Engineer1234/ConnectMedical/Connect Medical Boards/EFM2/Pictures/M24256-DFCS6TPK-Footprint.PNG

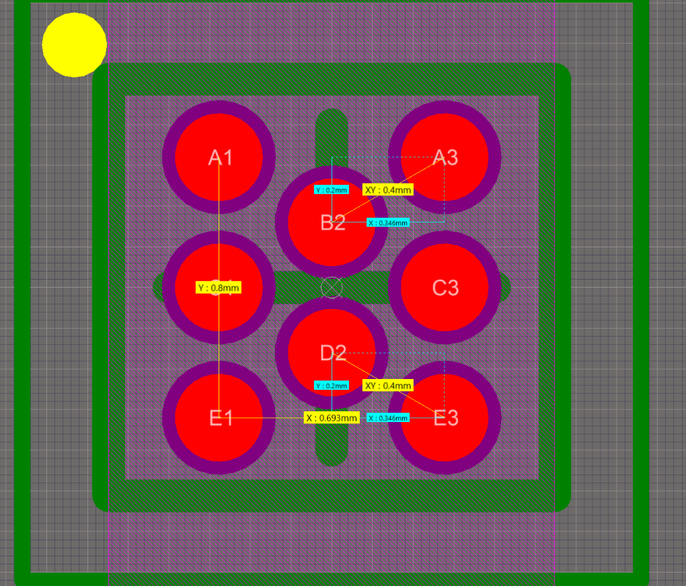
Connect Medical Boards/EFM2/Pictures/M24256-DFCS6TPK-Footprint.PNG
