Engineer1234/ConnectMedical/Connect Medical Boards/EFM2/Pictures/Modified_BRD.PNG

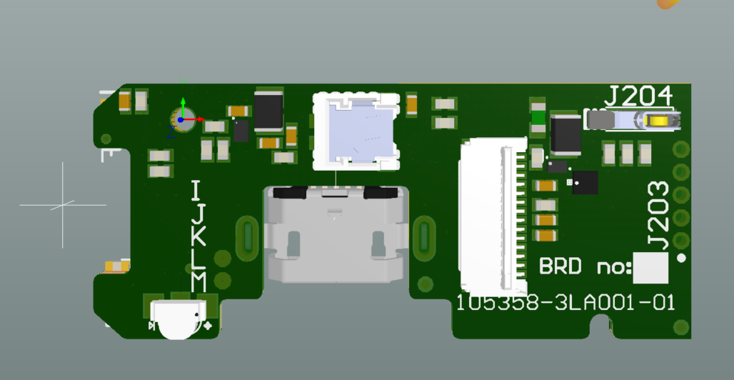
Connect Medical Boards/EFM2/Pictures/Modified_BRD.PNG
