Engineer1234/ConnectMedical/README.md

# Connect-Med-Hardware
Repository for Hardware files relating to Connect Medical
