Engineer1234/ConnectMedical/Connect Medical Boards/EFM1/Project Outputs for 105358-3BA001-01_EFM1/Reports/105358-3LA001-01_EFM1.xls

Board Stack Report
Stack Up |  | Layer Stack
Layer | Board Layer Stack | Name | Material | Thickness | Constant
1 |  | Top Paste
2 |  | Top Overlay
3 |  | Top Solder | Solder Resist | 0.018mm | 4
4 |  | Component Side | Copper | 0.036mm
5 |  | Dielectric 1 | FR-4 | 0.064mm | 4.2
6 |  | Inner Layer 1 | Copper | 0.036mm
7 |  | Dielectric 3 | FR-4 | 0.064mm | 4.2
8 |  | Ground Plane (GND) | Copper | 0.036mm
9 |  | Dielectric 6 | FR-4 | 0.508mm | 4.2
10 |  | Power Plane (VCC) | Copper | 0.036mm
11 |  | Dielectric 5 | FR-4 | 0.064mm | 4.2
12 |  | Inner Layer 2 | Copper | 0.036mm
13 |  | Dielectric 4 | FR-4 | 0.064mm | 4.2
14 |  | Solder Side | Copper | 0.036mm
15 |  | Bottom Solder | Solder Resist | 0.018mm | 4
16 |  | Bottom Overlay
17 |  | Bottom Paste
 | Height : 1.011mm
