Engineer1234/ConnectMedical/Connect Medical Boards/EFM2/Pictures/VIA _error.PNG

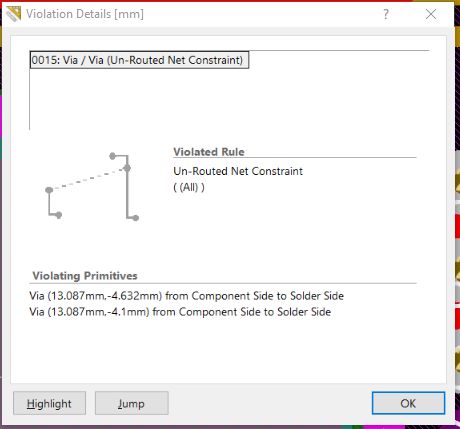
Connect Medical Boards/EFM2/Pictures/VIA _error.PNG
