Engineer1234/ConnectMedical/Connect Medical Boards/EFM1/Project Outputs for 105358-3BA001-01_EFM1/105358-3BA001-01_EFM1_BOM_FOR_QUOTE_170922.xlsx

Bill of Materials
Source Data From: |  | 105358-3BA001-01_EFM1.PrjPCB
Project: |  | 105358-3BA001-01_EFM1.PrjPCB
Variant: |  | None
Creation Date: | 25-09-2017 | 11:54:14
Print Date: | 2017-09-25 | 11:54:29
Production Quantity: | 5
Currency | SEK
Designator | Description | Comment | Manufacturer | Manufacturer Part Number | Quantity | #Column Name Error:Supplier 1 | Digi-Key Part Number | Pricing | Supplier Unit Price | Supplier 1 Subtotal | #Column Name Error:Assem | #Column Name Error:Assem Part Num | #Column Name Error:Assem Pricing | Assem Unit Price 2 | Assem Subtotal
C301, C302, C305, C307, C406 | 1µF ±10% 10V X5R Ceramic Capacitor 0402 | 1µF-10V | Yageo | CC0402KRX5R6BB105 | 5 |  | 311-1439-1-ND |  |  | $0.00
C303 | DNP | DNP |  |  | 1 |  |  |  |  | $0.00
C304 | 16µF ±10% 16V X5R Ceramic Capacitor 0603 | 10µF-16V | Murata Electronics North America | GRT188R61C106KE13D | 1 |  | 490-12317-1-ND |  |  | $0.00
C306 |  | DNP | Murata Electronics North America | GRM188R61A106KE69D | 1 |  | 490-10474-1-ND |  |  | $0.00
C308, C404, C405 | 4.7µF ±10% 6.3V X5R Ceramic Capacitor 0402 | 4.7µF | TDK Corporation | C1005X5R0J475K050BC | 3 |  | 445-5947-1-ND |  |  | $0.00
C401 | 0.1µF ±10% 10V X5R Ceramic Capacitor 0402 | 0.1µF-10V | Yageo | CC0402KRX5R6BB104 | 1 |  | 311-1336-1-ND |  |  | $0.00
C402 | 2.2nF ±10% 50V X5R Ceramic Capacitor 0402 | 2.2nF | Murata Electronics North America | GRM155R61H222KA01D | 1 |  | 490-8257-1-ND |  |  | $0.00
C403 | 22µF ±20% 10V Ceramic Capacitor X5R 0603 | 22µF | TDK Corporation | C1608X5R1A226M080AC | 1 |  | 445-9077-2-ND |  |  | $0.00
C501 | 1.2nF ±10% 10V U2J Ceramic Capacitor 0402 | 1.2nF-10V | Murata Electronics North America | GRM1557U1A122JA01D | 1 |  | 490-6272-1-ND |  |  | $0.00
D201, D402, D403 | TVS DIODE 15VWM 0402 | LXES15AAA1-133 | Murata Electronics North America | LXES15AAA1-133 | 3 |  | 490-13209-1-ND |  |  | $0.00
D401 | LED GRN/RED DIFF 1208 R/A SMD | LED RG | Stanley Electric Co | BRPY1211F-TR | 1 |  | 404-1089-1-ND |  |  | $0.00
D501 | 0603 INFRARED DIODE | KPT-2012P3BT | Kingbright | KPT-2012P3BT | 1 |  | 754-1433-1-ND |  |  | $0.00
J201 | CONN RCPT USB-mini B 2.0 5POS SLD | USB3155 | GCT (GLOBAL CONNECTOR TECHNOLOGY) | USB3155-30-A | 1 |  | 2537026-Farnell |  |  | $0.00
J202 | 1.20MM WTB HEADER VERT 2POS | 0781710002 | Molex, LLC | 0781710002 | 1 |  | WM4459CT-ND |  |  | $0.00
J204 | UNIVERSAL CONTACT 2.5MM SMD | 120220-0161 | ITT Cannon, LLC | 120220-0161 | 1 |  | 1003-1009-1-ND |  |  | $0.00
L201, L202 | FERRITE BEAD 120 OHM 0402 1LN | BLM15KD121SN1D | Murata Electronics North America | BLM15KD121SN1D | 2 |  | 490-15015-1-ND |  |  | $0.00
L301 | FIXED IND 10UH 500MA 300 MOHM | 10µH | TDK Corporation | MLZ2012N100LT000 | 1 |  | 445-6762-1-ND |  |  | $0.00
L401 | 0805 Ferrite Bead 330Ohm@100MHz | BLM21PG331SN1D | Murata Electronics North America | BLM21PG331SN1D | 1 |  | 490-5988-1-ND |  |  | $0.00
MOD401 | BLE PSoC Module 4.1 | CYBLE-214009-00 | Cypress Semiconductor Corp | CYBLE-214009-00 | 1 |  | 428-3809-ND |  |  | $0.00
Q401, Q403 | MOSFET P-CH 12V 22A 3PICOSTAR | CSD23382F4 | Texas Instruments | CSD23382F4 | 2 |  | 296-40003-1-ND |  |  | $0.00
Q402, Q502 | 12V N-CHANNEL FEMTOFET MOSFET | CSD13380F3T | Texas Instruments | CSD13380F3T | 2 |  | CSD13380F3T |  |  | $0.00
Q501 | 0805 PHOTOTRANSISTOR | KPT-2012P3BT | Kingbright | KPT-2012P3BT | 1 |  | 754-1436-1-ND |  |  | $0.00
R301, R302, R305, R409 | RES SMD 820kOHM 1% 1/16W 0402 | 820K | Yageo | RC0402FR-07820KL | 4 |  | YAG3240CT-ND |  |  | $0.00
R303, R304, R410 | RES SMD 82kOHM 1% 1/16W 0402 | 82K | Yageo | RC0402FR-0782KL | 3 |  | 311-82.0KLRCT-ND |  |  | $0.00
R306 | RES SMD 200kOHM 1% 1/16W 0402 | 200K | Yageo | AC0402FR-07200KL | 1 |  | YAG3452CT-ND |  |  | $0.00
R307 | RES SMD 150kOHM 5% 1/16W 0402 | 150K | Yageo | RC0402JR-07150KL | 1 |  | 311-150KJRCT-ND |  |  | $0.00
R308, R403, R404, R411, R503 | RES SMD 10kOHM 1% 1/16W 0402 | 10K | Yageo | RC0402FR-0710KL | 5 |  | 311-10.0KLRCT-ND |  |  | $0.00
R309 | RES SMD 5.6kOHM 5% 1/16W 0402 | 5.6K | Yageo | RC0402JR-075K6L | 1 |  | 311-5.6KJRCT-ND |  |  | $0.00
R310, R406 | RES SMD 41.2kOHM 1% 1/16W 0402 | 41.2K | Yageo | RC0402FR-0741K2L | 2 |  | YAG3155CT-ND |  |  | $0.00
R401 | RES SMD 698 OHM 1% 1/16W 0402 | 698 | Yageo | RC0402FR-07698RL | 1 |  | YAG3215CT-ND |  |  | $0.00
R402 | RES SMD 560OHM 1% 1/16W 0402 | 560 | Samsung Electro-Mechanics America, Inc. | RC1005F561CS | 1 |  | 1276-3473-1-ND |  |  | $0.00
R405, R407 | Do Not Place | Do Not Place |  |  | 2 |  |  |  |  | $0.00
R408, R412 | RES SMD 390kOHM 1% 1/16W 0402 | 390K | Yageo | RC0402FR-07390KL | 2 |  | YAG3143CT-ND |  |  | $0.00
R501 | RES SMD 1kOHM 1% 1/16W 0402 | 1K |  |  | 1 |  |  |  |  | $0.00
R502 | RES SMD 100OHM 1% 1/16W 0402 | 100 | Yageo | RC0402FR-07100RL | 1 |  | 311-100LRCT-ND |  |  | $0.00
SW401, SW402 | SPST Tactile Switch | KXT311LHS | C&K | KXT 311 LHS | 2 |  | CKN10777CT-ND |  |  | $0.00
U301 | Boost converter 28V | TPS61046YFFR | Texas Instruments | TPS61046YFFR | 1 |  | 296-44337-1-ND |  |  | $0.00
U302 | Li-Ion linear battery charger | STBC03 | STMicroelectronics | STBC03JR | 1 |  | 497-17241-1-ND |  |  | $0.00
U401 | IC I/O EXPANDER I2C 12XQFN | PCA9571GUX | NXP USA Inc. | PCA9571GUX | 1 |  | 568-12400-1-ND |  |  | $0.00
U402 | IC EEPROM 256KBIT 1MHZ 8WLCSP | M24256-DFCS6TP/K | STMicroelectronics | M24256-DFCS6TP/K | 1 |  | 497-13611-1-ND |  |  | $0.00
 |  |  |  |  | 64 |  |  |  |  | $0.00 |  |  |  |  | $0.000
Approved |  | Notes
