Engineer1234/ConnectMedical/Connect Medical Boards/FP1/Project Outputs for 105358-3BA001-03_FP1/105358-3CL006-02_FP1.xls

 |  |  |  |  |  |  |  |  |  |  |  |  |  | Octopart Add-In is ready
EFP1 |  |  | Bill of Materials
Source Data From: |  | 105358-3BA001-03_FP1.PrjPCB
Customer, project: |  | 105358-3BA001-03
Variant: |  | None
Revision: |  | C
Creation Date: | 23-01-2018 | 17:34:08
Print Date: | 2018-01-23 | 17:44:26
Production Quantity: | 5
Currency | USD
 |  |  |  |  |  |  |  |  |  | Price Per Board
Designator | Description | Comment | GENERIC_OK | Manufacturer | Manufacturer Part Number | Quantity | PackageReference | Digi-Key Part Number | Supplier Unit Price | Digi-Key Subtotal | 1K Unit Pricing | 1k Subtotal | 10K Unit Pricing | 10K Subtotal | Assem Subtotal
C301, C305, C307, C405 | 1µF ±10% 10V X5R Ceramic Capacitor 0402 | 1µF-10V | YES | Yageo | CC0402KRX5R6BB105 | 4 | 0402 | 311-1439-1-ND | 0.1 | $0.40 | 0.00876 | 0.03504 | 0.00582 | 0.02328 | 2
C302 | CAP CER 1UF 25V X5R 0402 | 1µF-25V | YES | Taiyo Yuden | TMK105BJ105KV-F | 1 | 0402 | 587-5947-1-ND | 0.19 | $0.19 | 0.03957 | 0.03957 | 0.02992 | 0.02992 | 0.95
C303, C403, C404 | CAP CER 2.2UF 16V X5R 0402 | 2.2µF-16V | YES | Murata Electronics North America | GRM155R61C225KE44D | 3 | 0402 | 490-10455-2-ND | 0.3 | $0.90 | 0.06196 | 0.18588 | 0.04452 | 0.13356 | 4.5
C304 | 10µF ±10% 16V X5R Ceramic Capacitor 0603 | 10µF-16V | YES | Murata Electronics North America | GRT188R61C106KE13D | 1 | 0603 | 490-12317-1-ND | 0.5 | $0.50 | 0.13219 | 0.13219 | 0.0968 | 0.0968 | 2.5
C306 | 10µF ±10% 10V X5R Ceramic Capacitor 0603 | 10µF-10V | YES | Murata Electronics North America | GRM188R61A106KE69D | 1 | 0603 | 490-10474-1-ND | 0.21 | $0.21 | 0.03994 | 0.03994 | 0.0275 | 0.0275 | 1.05
C308 | 4.7µF ±10% 6.3V X5R Ceramic Capacitor 0402 | 4.7µF | YES | TDK Corporation | C1005X5R0J475K050BC | 1 | 0402 | 445-5947-1-ND | 0.46 | $0.46 | 0.12018 | 0.12018 | 0.088 | 0.088 | 2.3
C401 | 0.1µF ±10% 10V X5R Ceramic Capacitor 0402 | 0.1µF-10V | YES | Yageo | CC0402KRX5R6BB104 | 1 | 0402 | 311-1336-1-ND | 0.1 | $0.10 | 0.00313 | 0.00313 | 0.00208 | 0.00208 | 0.5
C402 | 22µF ±20% 10V Ceramic Capacitor X5R 0603 | 22µF | YES | TDK Corporation | C1608X5R1A226M080AC | 1 | 0603 | 445-9077-2-ND | 0.51 | $0.51 | 0.15054 | 0.15054 | 0.1078 | 0.1078 | 2.55
C501 | 1.2nF ±10% 10V U2J Ceramic Capacitor 0402 | 1.2nF-10V | YES | Murata Electronics North America | GRM1557U1A122JA01D | 1 | 0402 | 490-6272-1-ND | 0.2 | $0.20 | 0.03833 | 0.03833 | 0.0264 | 0.0264 | 1
D201, D402, D403, D404 | TVS DIODE 15VWM 0402 | LXES15AAA1-133 |  | Murata Electronics North America | LXES15AAA1-133 | 4 | 0402 | 490-13209-1-ND | 0.4 | $1.60 | 0.07446 | 0.29784 | 0.0482 | 0.1928 | 8
D401 | LED GRN/ORNG | LED OG |  | Kingbright | KPHBM-2012CGKSEKC | 1 |  | 1686080 | 0.221 | $0.22 | 0.221 | 0.221 | 0.221 | 0.221 | 1.105
D501 | 0603 INFRARED DIODE | APT1608F3C |  | Kingbright | APT1608F3C | 1 | 0603 | 754-1433-1-ND | 0.49 | $0.49 | 0.1144 | 0.1144 | 0.0806 | 0.0806 | 2.45
J201 | CONN RCPT USB-mini B 2.0 5POS SLD | USB3155 |  | GCT (GLOBAL CONNECTOR TECHNOLOGY) | USB3155-30-A | 1 |  | 2537026-Farnell | 0.506 | $0.51 | 0.284 | 0.284 | 0.284 | 0.284 | 2.53
J202 | 1.20MM WTB HEADER VERT 2POS | 0781710002 |  | Molex, LLC | 0781710002 | 1 |  | WM4459CT-ND | 0.58 | $0.58 | 0.29712 | 0.29712 | 0.221 | 0.221 | 2.9
J204 | UNIVERSAL CONTACT 2.5MM SMD | 120220-0161 |  | ITT Cannon, LLC | 120220-0161 | 1 |  | 1003-1009-1-ND | 0.33 | $0.33 | 0.154 | 0.154 | 0.12 | 0.12 | 1.65
J401 | Connector molex to OLED Display | 5034801400 |  | Molex, LLC | 5034801400 | 1 |  | WM1442CT-ND | 1.36 | $1.36 | 0.75117 | 0.75117 | 0.56764 | 0.56764 | 6.8
L201, L202 | FERRITE BEAD 120 OHM 0402 1LN | BLM15KD121SN1D |  | Murata Electronics North America | BLM15KD121SN1D | 2 | 0402 (1005 Metric) | 490-15015-1-ND | 0.15 | $0.30 | 0.04092 | 0.08184 | 0.03348 | 0.06696 | 1.5
L301 | FIXED IND 10UH 500MA 300 MOHM | 10µH |  | TDK Corporation | MLZ2012N100LT000 | 1 | 0805 | 445-6762-1-ND | 0.14 | $0.14 | 0.06038 | 0.06038 | 0.04 | 0.04 | 0.7
L401 | 0805 Ferrite Bead 330Ohm@100MHz | BLM21PG331SN1D |  | Murata Electronics North America | BLM21PG331SN1D | 1 | 0805 (2012 Metric) | 490-5988-1-ND | 0.12 | $0.12 | 0.03062 | 0.03062 | 0.02436 | 0.02436 | 0.6
MOD401 | BLE PSoC Module 4.1 | CYBLE-214009-00 |  | Cypress Semiconductor Corp | CYBLE-214009-00 | 1 |  | 428-3809-ND | 14.72 | $14.72 | 9.3233 | 9.3233 | 9.3233 | 9.3233 | 73.6
Q401, Q403 | MOSFET P-CH 12V 22A 3PICOSTAR | CSD23382F4 |  | Texas Instruments | CSD23382F4 | 2 |  | 296-40003-1-ND | 0.61 | $1.22 | 0.12916 | 0.25832 | 0.0798 | 0.1596 | 6.1
Q402, Q502 | 12V N-CHANNEL FEMTOFET MOSFET | CSD13380F3T |  | Texas Instruments | CSD13380F3T | 2 |  | CSD13380F3T | 0.51 | $1.02 | 0.11375 | 0.2275 | 0.1034 | 0.2068 | 5.1
Q501 | 0805 PHOTOTRANSISTOR | KPT-2012P3BT |  | Kingbright | KPT-2012P3BT | 1 | 0805 | 754-1436-1-ND | 0.49 | $0.49 | 0.1144 | 0.1144 | 0.0806 | 0.0806 | 2.45
R301, R302, R305, R408 | RES SMD 820kOHM 1% 1/16W 0402 | 820K | YES | Yageo | RC0402FR-07820KL | 4 | 0402 | YAG3240CT-ND | 0.1 | $0.40 | 0.00247 | 0.00988 | 0.0014 | 0.0056 | 2
R303, R304, R409 | RES SMD 82kOHM 1% 1/16W 0402 | 82K | YES | Yageo | RC0402FR-0782KL | 3 | 0402 | 311-82.0KLRCT-ND | 0.1 | $0.30 | 0.00253 | 0.00759 | 0.00158 | 0.00474 | 1.5
R306 | RES SMD 470K OHM 1% 1/16W 0402 | 470K | YES |  |  | 1 | 0402 |  | 0.1 | $0.10 | 0.00222 | 0.00222 | 0.00158 | 0.00158 | 0.5
R307 | RES SMD 150kOHM 5% 1/16W 0402 | 150K | YES | Yageo | RC0402JR-07150KL | 1 | 0402 | 311-150KJRCT-ND | 0.1 | $0.10 | 0.00222 | 0.00222 | 0.00139 | 0.00139 | 0.5
R308, R412, R505 | RES SMD 10kOHM 1% 1/16W 0402 | 10K | YES | Yageo | RC0402FR-0710KL | 3 | 0402 | 311-10.0KLRCT-ND | 0.1 | $0.30 | 0.00253 | 0.00759 | 0.00158 | 0.00474 | 1.5
R309, R410, R411 | RES SMD 5.6kOHM 5% 1/16W 0402 | 5.6K | YES | Yageo | RC0402JR-075K6L | 3 | 0402 | 311-5.6KJRCT-ND | 0.1 | $0.30 | 0.00222 | 0.00666 | 0.00139 | 0.00417 | 1.5
R310, R404 | RES SMD 41.2kOHM 1% 1/16W 0402 | 41.2K | YES | Yageo | RC0402FR-0741K2L | 2 | 0402 | YAG3155CT-ND | 0.1 | $0.20 | 0.00247 | 0.00494 | 0.0014 | 0.0028 | 1
R401, R402 | RES SMD 43 OHM 5% 1/16W 0402 | 43R | YES | Yageo | RC0402JR-0743RL | 2 | 0402 | 311-43JRCT-ND | 0.1 | $0.20 | 0.00222 | 0.00444 | 0.00139 | 0.00278 | 1
R407, R413 | RES SMD 390kOHM 1% 1/16W 0402 | 390K | YES | Yageo | RC0402FR-07390KL | 2 | 0402 | YAG3143CT-ND | 0.1 | $0.20 | 0.00247 | 0.00494 | 0.0014 | 0.0028 | 1
R501 | RES SMD 510OHM 1% 1/16W 0402 | 510R | YES |  |  | 1 | 0402 |  | 0.1 | $0.10 | 0.00222 | 0.00222 | 0.00158 | 0.00158 | 0.5
R502 | RES SMD 100OHM 1% 1/16W 0402 | 100R | YES | Yageo | RC0402FR-07100RL | 1 | 0402 | 311-100LRCT-ND | 0.1 | $0.10 | 0.00253 | 0.00253 | 0.00158 | 0.00158 | 0.5
R504 | RES SMD 470 OHM 1% 1/16W 0402 | 470R | YES |  |  | 1 | 0402 |  | 0.1 | $0.10 | 0.00222 | 0.00222 | 0.00158 | 0.00158 | 0.5
SW401 | SPST Tactile Switch | PTS830GG140 |  | C&K | PTS830GG140G SMTR LFS | 1 |  | CKN10590CT-ND | 0.56 | $0.56 | 0.30014 | 0.30014 | 0.25466 | 0.25466 | 2.8
SW402 | SWITCH DETECTOR SPST-NO 10MA 5V | ESE-16J001 |  | Panasonic Electronic Components | ESE-16J001 | 1 |  | P14266SCT-ND | 1.02 | $1.02 | 0.59675 | 0.59675 | 0.49 | 0.49 | 5.1
U301 | Boost converter 28V | TPS61046YFFR |  | Texas Instruments | TPS61046YFFR | 1 | 6-UFBGA, DSBGA | 296-44337-1-ND | 1.26 | $1.26 | 0.57165 | 0.57165 | 0.4625 | 0.4625 | 6.3
U302 | Li-Ion linear battery charger | STBC03 |  | STMicroelectronics | STBC03JR | 1 | 30-UFBGA, FCBGA | 497-17241-1-ND | 2.82 | $2.82 | 1.49103 | 1.49103 | 1.32352 | 1.32352 | 14.1
U401 | IC EEPROM 256KBIT 400KHZ 8UFDFPN | M24256-DFCS6TP/K |  | STMicroelectronics | M24256-DFMC6TG | 1 | 8-UFDFPN | 497-15742-1-ND | 0.48 | $0.48 | 0.36648 | 0.36648 | 0.29626 | 0.29626 | 2.4
 |  |  |  |  |  | 63 |  |  |  | $35.11 |  | $16.344 |  | $14.986 | $175.535
Approved |  | Notes
 |  | Items Marked DNP/Do Not Place, are not to be populated onto the PCB
