Engineer1234/ConnectMedical/Connect Medical Boards/FP1/Project Outputs for 105358-3BA001-03_FP1/105358-3CL005-01_FP1.xls

EFP 1 |  |  | Bill of Materials
Source Data From: |  | 105358-3BA001-03_FP1.PrjPCB
Customer, project: |  | 105358-3BA001-03
Variant: |  | None
Revision: |  | A
Creation Date: | 20-12-2017 | 16:48:58
Print Date: | 2017-12-20 | 16:53:22
Production Quantity: | 5
Currency | USD
Designator | Description | Comment | GENERIC_OK | Manufacturer | Manufacturer Part Number | Quantity | PackageReference | Digi-Key Part Number | Supplier Unit Price | Assem Subtotal
C301, C305, C307, C406 | 1µF ±10% 10V X5R Ceramic Capacitor 0402 | 1µF-10V |  | Yageo | CC0402KRX5R6BB105 | 4 | 0402 | 311-1439-1-ND | 0.1 | 2
C302 | CAP CER 1UF 25V X5R 0402 | 1µF-25V |  | Taiyo Yuden | TMK105BJ105KV-F | 1 | 0402 | 587-5947-1-ND | 0.19 | 0.95
C303, C404 | CAP CER 2.2UF 16V X5R 0402 | 2.2µF-16V |  | Murata Electronics North America | GRM155R61C225KE44D | 2 | 0402 | 490-10455-2-ND | 0.3 | 3
C304 | 10µF ±10% 16V X5R Ceramic Capacitor 0603 | 10µF-16V |  | Murata Electronics North America | GRT188R61C106KE13D | 1 | 0603 | 490-12317-1-ND | 0.5 | 2.5
C306 | 10µF ±10% 10V X5R Ceramic Capacitor 0603 | 10µF-10V |  | Murata Electronics North America | GRM188R61A106KE69D | 1 | 0603 | 490-10474-1-ND | 0.21 | 1.05
C308, C405 | 4.7µF ±10% 6.3V X5R Ceramic Capacitor 0402 | 4.7µF |  | TDK Corporation | C1005X5R0J475K050BC | 2 | 0402 | 445-5947-1-ND | 0.46 | 4.6
C401 | 0.1µF ±10% 10V X5R Ceramic Capacitor 0402 | 0.1µF-10V |  | Yageo | CC0402KRX5R6BB104 | 1 | 0402 | 311-1336-1-ND | 0.1 | 0.5
C402 | 2.2nF ±10% 50V X5R Ceramic Capacitor 0402 | 2.2nF |  | Murata Electronics North America | GRM155R61H222KA01D | 1 | 0402 | 490-8257-1-ND | 0.1 | 0.5
C403 | 22µF ±20% 10V Ceramic Capacitor X5R 0603 | 22µF |  | TDK Corporation | C1608X5R1A226M080AC | 1 | 0603 | 445-9077-2-ND | 0.51 | 2.55
C501 | 1.2nF ±10% 10V U2J Ceramic Capacitor 0402 | 1.2nF-10V |  | Murata Electronics North America | GRM1557U1A122JA01D | 1 | 0402 | 490-6272-1-ND | 0.2 | 1
D201, D402, D403, D404 | TVS DIODE 15VWM 0402 | LXES15AAA1-133 |  | Murata Electronics North America | LXES15AAA1-133 | 4 | 0402 | 490-13209-1-ND | 0.4 | 8
D401 | LED GRN/ORNG | LED OG |  | Kingbright | KPHBM-2012CGKSEKC | 1 |  | 1686080 | ERROR: Query did not provide a result. Please widen your search criteria. | #VALUE!
D501 | 0603 INFRARED DIODE | APT1608F3C |  | Kingbright | APT1608F3C | 1 | 0603 | 754-1433-1-ND | 0.49 | 2.45
J201 | CONN RCPT USB-mini B 2.0 5POS SLD | USB3155 |  | GCT (GLOBAL CONNECTOR TECHNOLOGY) | USB3155-30-A | 1 |  | 2537026-Farnell | ERROR: Query did not provide a result. Please widen your search criteria. | #VALUE!
J202 | 1.20MM WTB HEADER VERT 2POS | 0781710002 |  | Molex, LLC | 0781710002 | 1 |  | WM4459CT-ND | 0.58 | 2.9
J204, J205 | MICRO UNIVERSAL CONTACT Z 3.0MM | 120220-0313 |  | ITT Cannon, LLC | 120220-0313 | 2 |  | 1003-2382-1-ND | 0.33 | 3.3
J401 | Connector molex to OLED Display | 5034801400 |  | Molex, LLC | 5034801400 | 1 |  | WM1442CT-ND | 1.36 | 6.8
L201, L202 | FERRITE BEAD 120 OHM 0402 1LN | BLM15KD121SN1D |  | Murata Electronics North America | BLM15KD121SN1D | 2 | 0402 (1005 Metric) | 490-15015-1-ND | 0.15 | 1.5
L301 | FIXED IND 10UH 500MA 300 MOHM | 10µH |  | TDK Corporation | MLZ2012N100LT000 | 1 | 0805 | 445-6762-1-ND | 0.14 | 0.7
L401 | 0805 Ferrite Bead 330Ohm@100MHz | BLM21PG331SN1D |  | Murata Electronics North America | BLM21PG331SN1D | 1 | 0805 (2012 Metric) | 490-5988-1-ND | 0.12 | 0.6
MOD401 | BLE PSoC Module 4.1 | CYBLE-214009-00 |  | Cypress Semiconductor Corp | CYBLE-214009-00 | 1 |  | 428-3809-ND | 14.72 | 73.6
Q401, Q403 | MOSFET P-CH 12V 22A 3PICOSTAR | CSD23382F4 |  | Texas Instruments | CSD23382F4 | 2 |  | 296-40003-1-ND | 0.43 | 4.3
Q402, Q502 | 12V N-CHANNEL FEMTOFET MOSFET | CSD13380F3T |  | Texas Instruments | CSD13380F3T | 2 |  | CSD13380F3T | 0.51 | 5.1
Q501 | 0805 PHOTOTRANSISTOR | KPT-2012P3BT |  | Kingbright | KPT-2012P3BT | 1 | 0805 | 754-1436-1-ND | 0.49 | 2.45
R301, R302, R305, R409 | RES SMD 820kOHM 1% 1/16W 0402 | 820K | YES | Yageo | RC0402FR-07820KL | 4 | 0402 | YAG3240CT-ND | 0.1 | 2
R303, R304, R410 | RES SMD 82kOHM 1% 1/16W 0402 | 82K | YES | Yageo | RC0402FR-0782KL | 3 | 0402 | 311-82.0KLRCT-ND | 0.1 | 1.5
R306 | RES SMD 200kOHM 1% 1/16W 0402 | 200K | YES | Yageo | AC0402FR-07200KL | 1 | 0402 | YAG3452CT-ND | 0.1 | 0.5
R307 | RES SMD 150kOHM 5% 1/16W 0402 | 150K | YES | Yageo | RC0402JR-07150KL | 1 | 0402 | 311-150KJRCT-ND | 0.1 | 0.5
R308, R411, R504 | RES SMD 10kOHM 1% 1/16W 0402 | 10K | YES | Yageo | RC0402FR-0710KL | 3 | 0402 | 311-10.0KLRCT-ND | 0.1 | 1.5
R309, R403, R404 | RES SMD 5.6kOHM 5% 1/16W 0402 | 5.6K | YES | Yageo | RC0402JR-075K6L | 3 | 0402 | 311-5.6KJRCT-ND | 0.1 | 1.5
R310, R406 | RES SMD 41.2kOHM 1% 1/16W 0402 | 41.2K | YES | Yageo | RC0402FR-0741K2L | 2 | 0402 | YAG3155CT-ND | 0.1 | 1
R401, R402 | RES SMD 43 OHM 5% 1/16W 0402 | 43R | YES | Yageo | RC0402JR-0743RL | 2 | 0402 | 311-43JRCT-ND | 0.1 | 1
R408, R412 | RES SMD 390kOHM 1% 1/16W 0402 | 390K | YES | Yageo | RC0402FR-07390KL | 2 | 0402 | YAG3143CT-ND | 0.1 | 1
R501 | RES SMD 560OHM 1% 1/16W 0402 | 560R | YES | Samsung Electro-Mechanics America, Inc. | RC1005F561CS | 1 | 0402 | 1276-3473-1-ND | 0.1 | 0.5
R502 | RES SMD 100OHM 1% 1/16W 0402 | 100R | YES | Yageo | RC0402FR-07100RL | 1 | 0402 | 311-100LRCT-ND | 0.1 | 0.5
R503 | RES SMD 430 OHM 0.1% 1/16W 0402 | 430R | YES | Yageo | RT0402BRD07430RL | 1 | 0402 | YAG1430CT-ND | 0.4 | 2
SW401, SW402 | SPST Tactile Switch | KXT311LHS |  | C&K | KXT 311 LHS | 2 |  | CKN10777CT-ND | 0.25 | 2.5
U301 | Boost converter 28V | TPS61046YFFR |  | Texas Instruments | TPS61046YFFR | 1 | 6-UFBGA, DSBGA | 296-44337-1-ND | 1.28 | 6.4
U302 | Li-Ion linear battery charger | STBC03 |  | STMicroelectronics | STBC03JR | 1 | 30-UFBGA, FCBGA | 497-17241-1-ND | 2.82 | 14.1
U401 | IC EEPROM 256KBIT 400KHZ 8UFDFPN | M24256-DFCS6TP/K |  | STMicroelectronics | M24256-DFMC6TG | 1 | 8-UFDFPN | 497-15742-1-ND | 0.48 | 2.4
 |  |  |  |  |  | 65 |  |  |  | #VALUE!
Approved |  | Notes
 |  | Items Marked DNP/Do Not Place, are not to be populted onto the PCB
