Engineer1234/ConnectMedical/Connect Medical Boards/EFM1_Hybrid/step/STEP-61300311121-rev1.stp

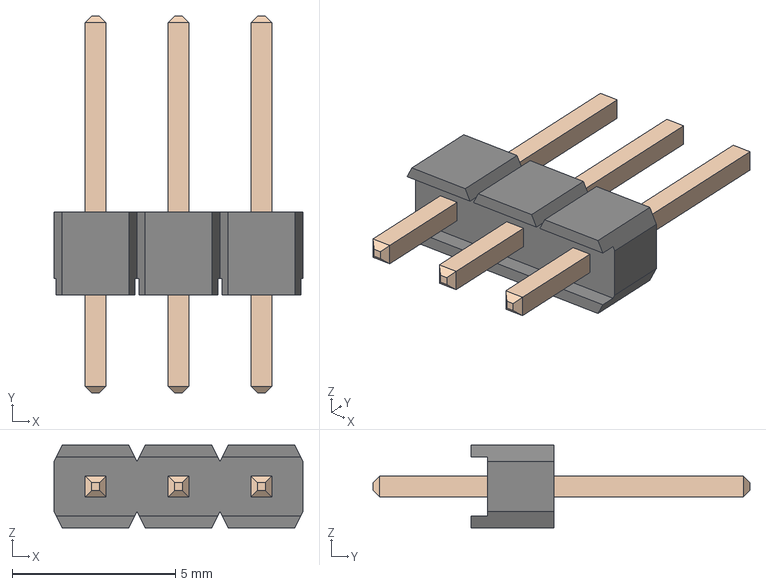
[picture p4: CAD file, 2017-09-27]
Connect Medical Boards/EFM1_Hybrid/step/STEP-61300311121-rev1.stp
7.62 x 11.5 x 2.54 mm
6130xx11121_PIN x 3
