Engineer1234/ConnectMedical/Connect Medical Boards/EFM1_Touch/Models/0180-004-DM-0086-Touch.step

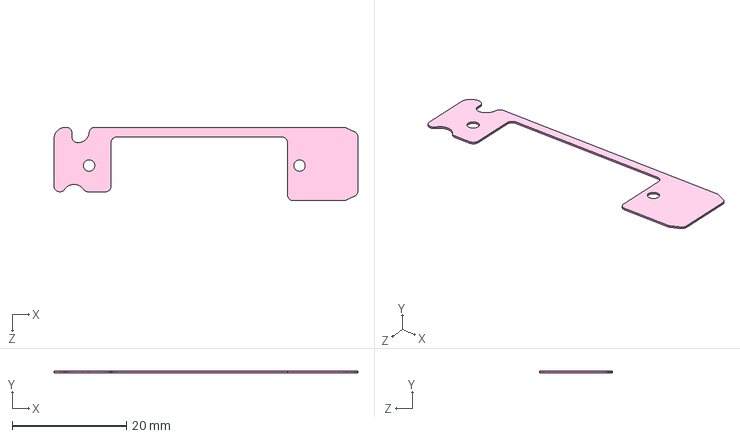
[picture p5: CAD file, 2018-02-09]
Connect Medical Boards/EFM1_Touch/Models/0180-004-DM-0086-Touch.step
53.2 x 0.32 x 12.8 mm
