Engineer1234/ConnectMedical/Connect Medical Boards/FP1/step/Micro Universal Contact Z 3.0mm.step

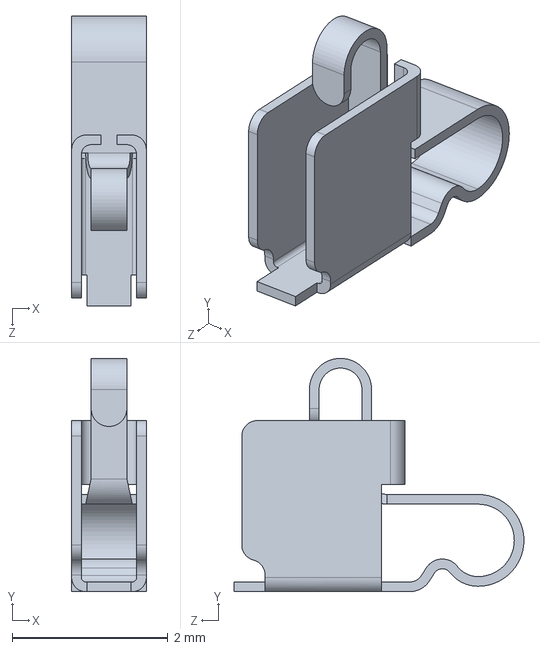
[picture p6: CAD file, 2017-12-19]
Connect Medical Boards/FP1/step/Micro Universal Contact Z 3.0mm.step
0.96 x 3.00 x 3.73 mm
