Engineer1234/ConnectMedical/Connect Medical Boards/FP1/step/KPHBM-2012CGKSEKC v2.step

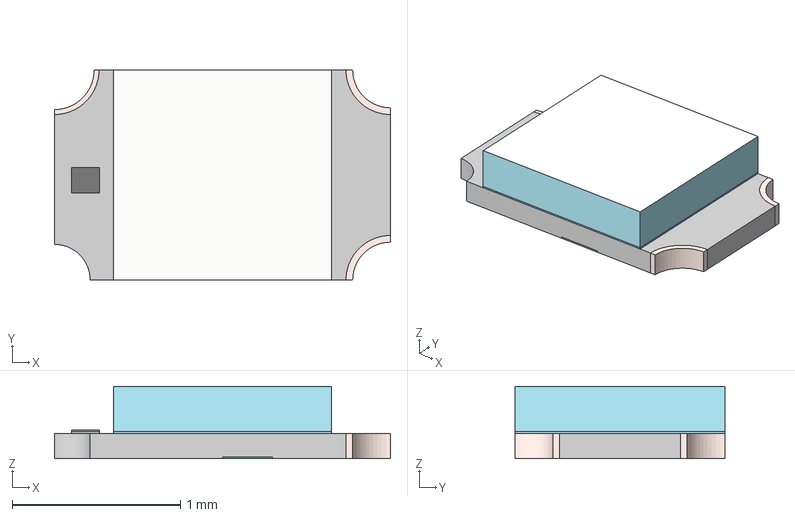
[picture p7: CAD file, 2017-12-01]
Connect Medical Boards/FP1/step/KPHBM-2012CGKSEKC v2.step
2.00 x 1.25 x 0.43 mm
