Engineer1234/ConnectMedical/Connect Medical Boards/FP1/step/BRPY1211F-TR.step

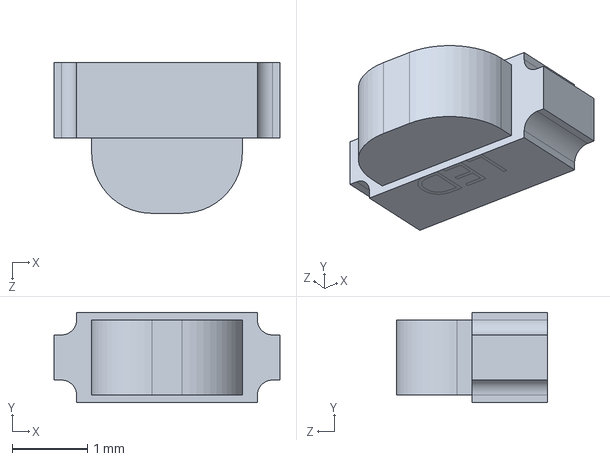
[picture p8: CAD file, 2017-09-19]
Connect Medical Boards/FP1/step/BRPY1211F-TR.step
3.00 x 1.20 x 2.00 mm
