Engineer1234/ConnectMedical/Connect Medical Boards/FP1/step/USB3155-30-A_revB v1.step

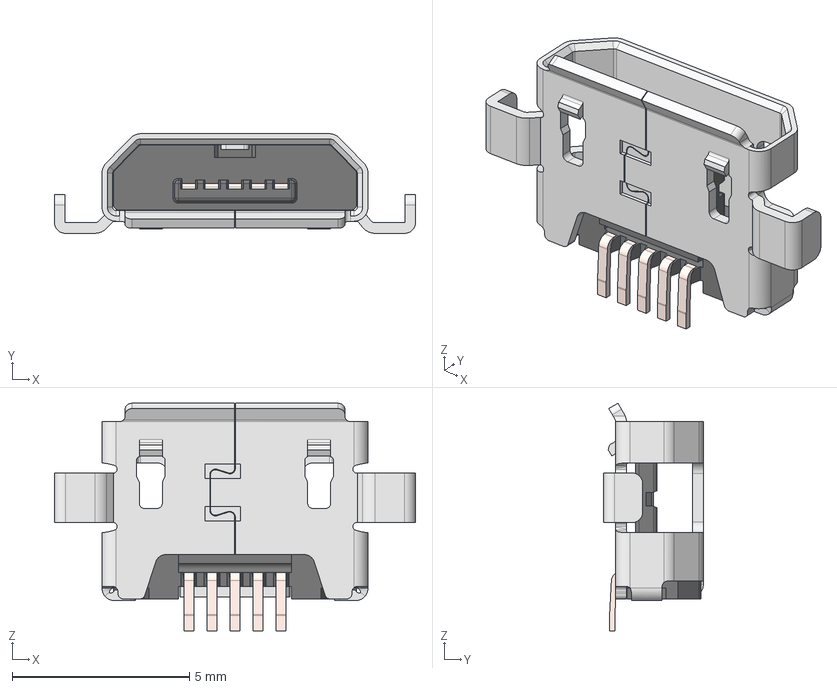
[picture p9: CAD file, 2017-09-13]
Connect Medical Boards/FP1/step/USB3155-30-A_revB v1.step
10.2 x 2.81 x 6.42 mm
CP_HOUR___
CP_TER___-1
CP_TER___-4
CP_TER___-3
CP_TER___-2
CP_TER___
SHELLNEW
