Engineer1234/ConnectMedical/Connect Medical Boards/FP1/step/APT2012.STEP

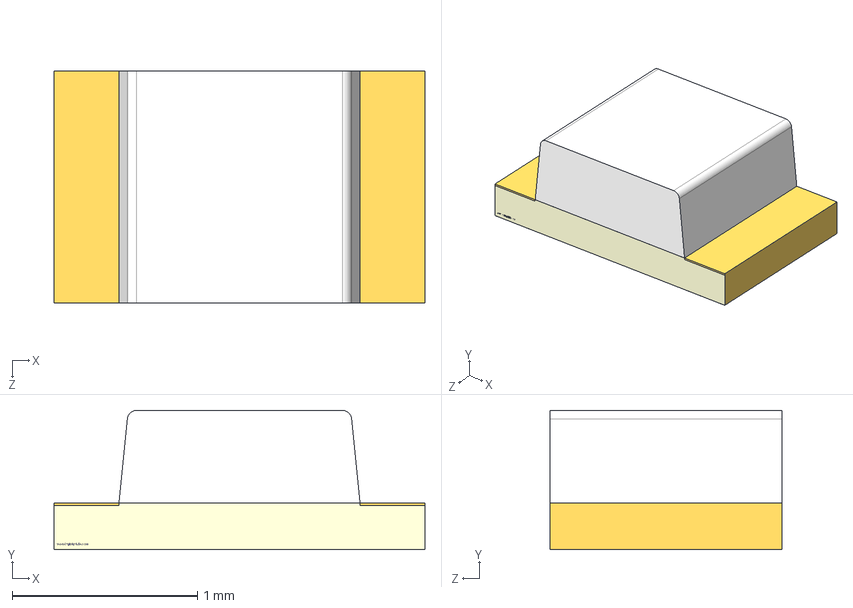
[picture p10: CAD file, 2017-09-07]
Connect Medical Boards/FP1/step/APT2012.STEP
2.00 x 0.75 x 1.25 mm
