Engineer1234/ConnectMedical/Connect Medical Boards/FP1/step/APT2012 v3-pin1.step

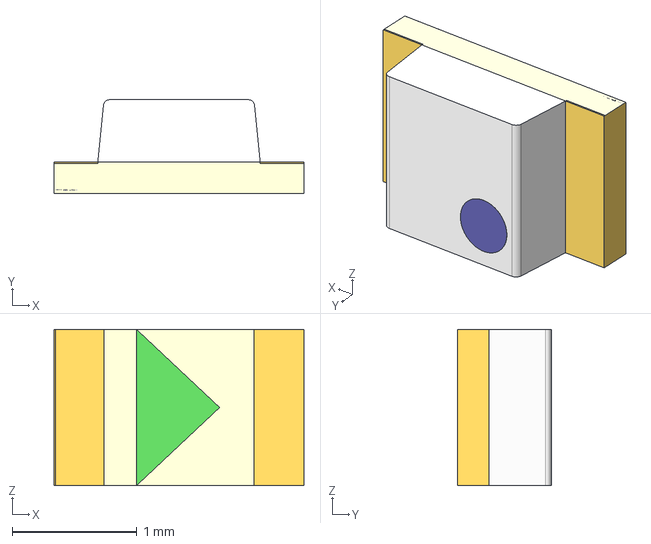
[picture p11: CAD file, 2017-09-07]
Connect Medical Boards/FP1/step/APT2012 v3-pin1.step
2.00 x 0.751 x 1.25 mm
