Engineer1234/ConnectMedical/Connect Medical Boards/FP1/step/APT1608 v1-pin.step

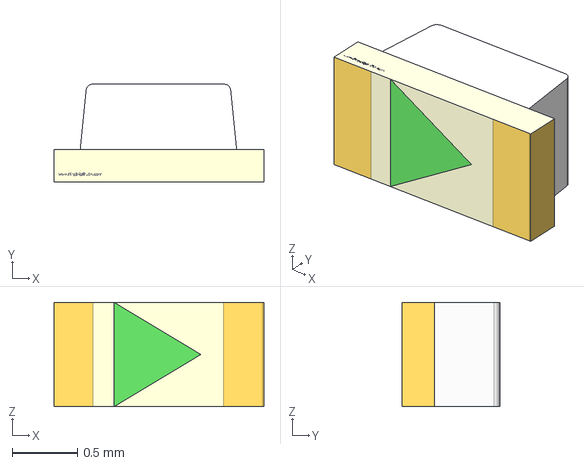
[picture p12: CAD file, 2017-09-07]
Connect Medical Boards/FP1/step/APT1608 v1-pin.step
1.61 x 0.751 x 0.8 mm
