Engineer1234/ConnectMedical/Connect Medical Boards/EFM1_Hybrid/Models/20170927_0180-004-DC-0082_PCB.DXF

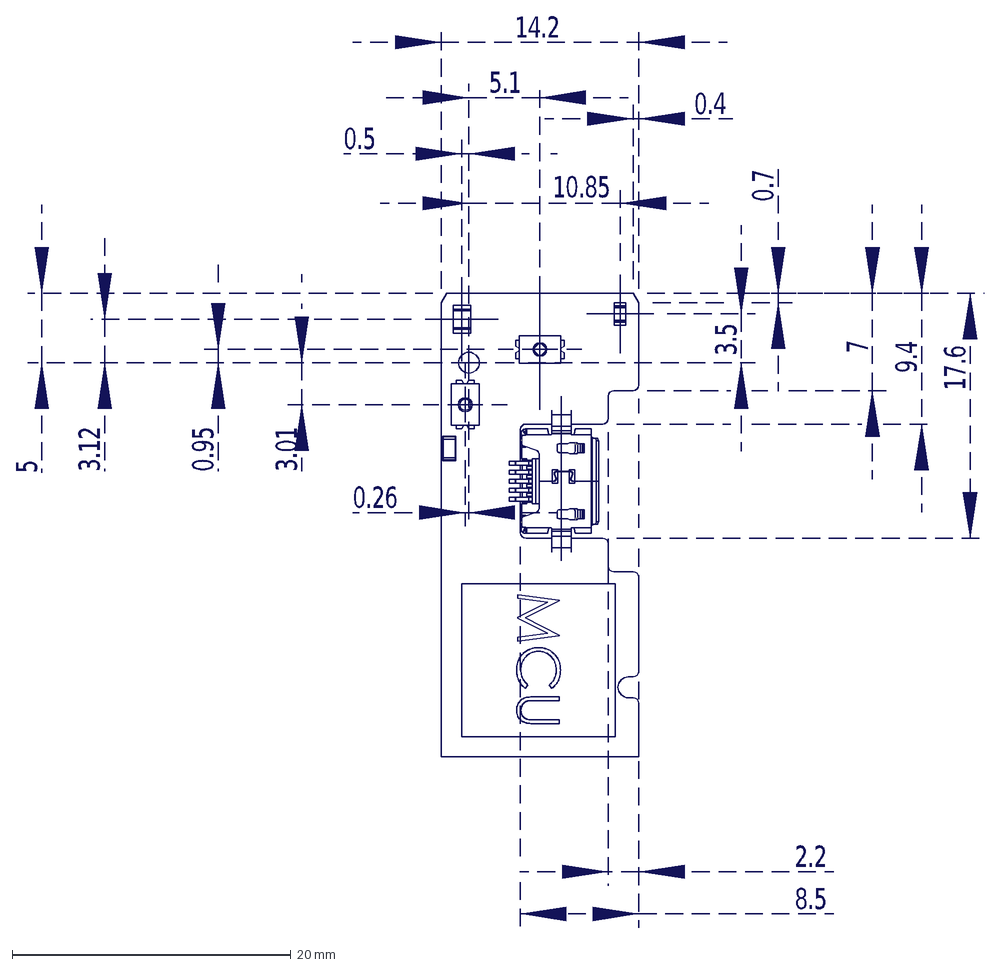
[picture p13: CAD file, 2017-09-27]
Connect Medical Boards/EFM1_Hybrid/Models/20170927_0180-004-DC-0082_PCB.DXF
14.2
5
5.1
0.5
3.12
3.5
10.85
0.95
3.01
0.26
0.7
0.4
7
9.4
17.6
2.2
8.5
