Engineer1234/ConnectMedical/Connect Medical Boards/EFM1_Touch/Project Outputs for 105358-3BA003-02_EFP1_Touch/Step/105358-3LA003-02_EFP1_Touch.step

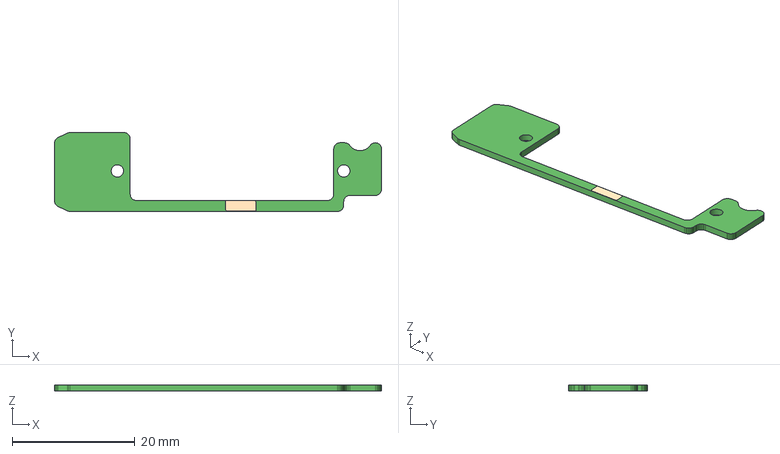
[picture p14: CAD file, 2017-12-22]
Connect Medical Boards/EFM1_Touch/Project Outputs for 105358-3BA003-02_EFP1_Touch/Step/105358-3LA003-02_EFP1_Touch.step
53.2 x 12.8 x 1.03 mm
