Engineer1234/ConnectMedical/Connect Medical Boards/EFM2/Models/105358-3ME031-04 Mechanical Design of PCB by SHL.step

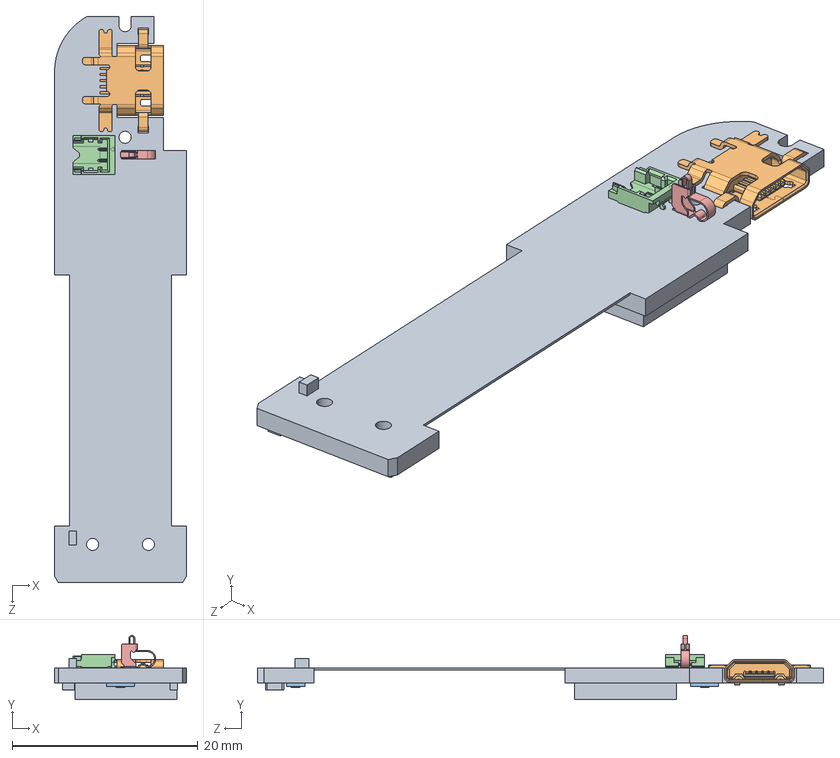
[picture p15: CAD file, 2017-08-04]
Connect Medical Boards/EFM2/Models/105358-3ME031-04 Mechanical Design of PCB by SHL.step
14.2 x 6.90 x 60.9 mm
0180-004-DM-0016_2D版
0180-004-DM-0062_Defaut
0180-004-DM-0073 x 2
0180-004-DM-0067
0180-004-DM-0085
