Engineer1234/ConnectMedical/Connect Medical Boards/EFM1_Hybrid/step/5034801000.stp

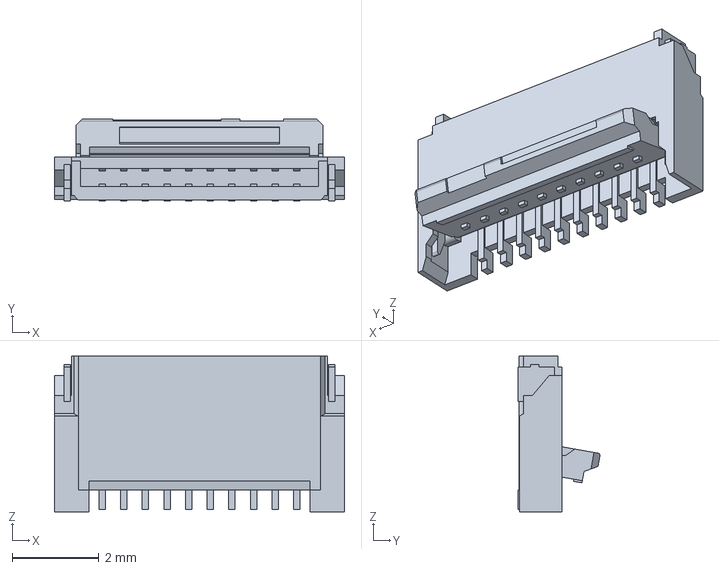
[picture p16: CAD file, 2017-09-27]
Connect Medical Boards/EFM1_Hybrid/step/5034801000.stp
6.70 x 1.90 x 3.60 mm
