Engineer1234/ConnectMedical/Connect Medical Boards/FP1/step/M24256-DFCS6TPK v2 v1.step

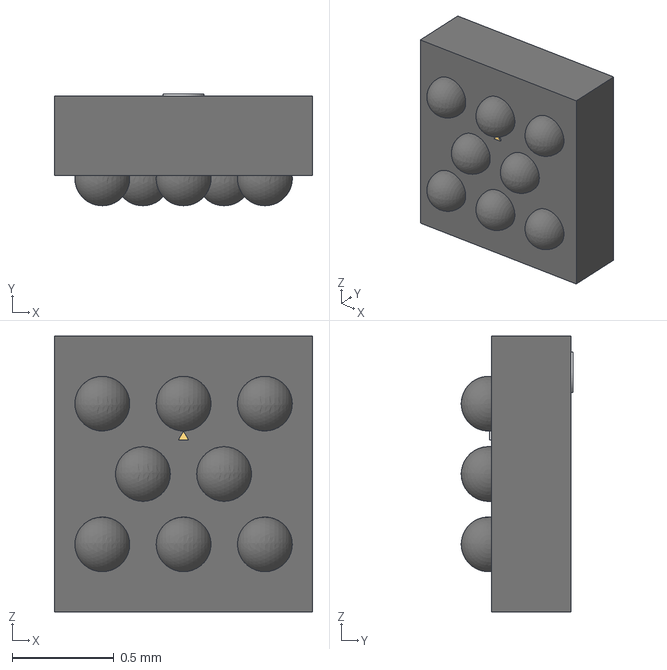
[picture p17: CAD file, 2017-09-21]
Connect Medical Boards/FP1/step/M24256-DFCS6TPK v2 v1.step
1.27 x 0.549 x 1.36 mm
