Engineer1234/ConnectMedical/Connect Medical Boards/FP1/step/120220-0161.step

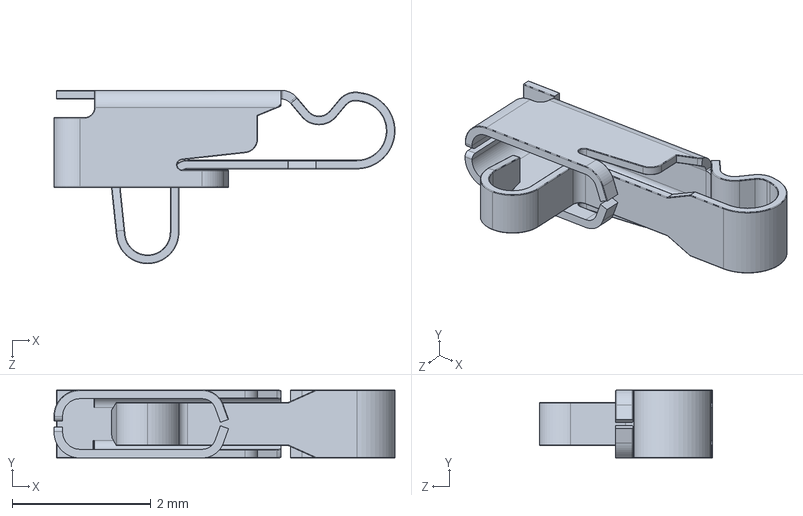
[picture p18: CAD file, 2017-09-14]
Connect Medical Boards/FP1/step/120220-0161.step
4.92 x 0.98 x 2.50 mm
