Engineer1234/ConnectMedical/Connect Medical Boards/FP1/step/781710002.stp

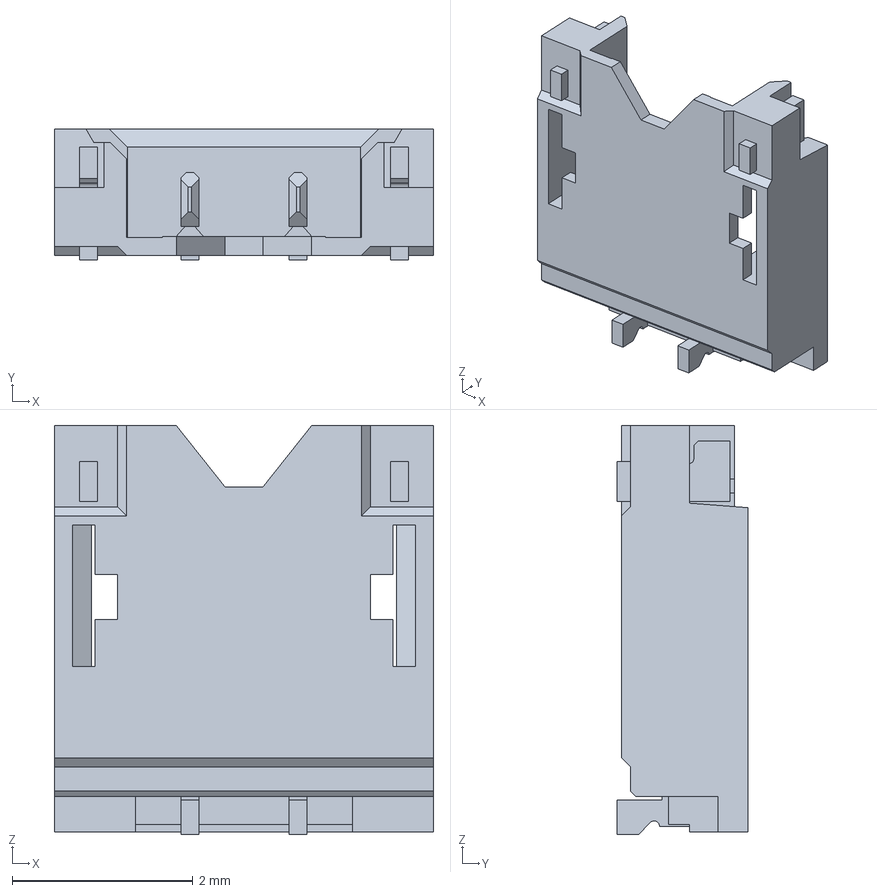
[picture p19: CAD file, 2017-09-13]
Connect Medical Boards/FP1/step/781710002.stp
4.20 x 1.45 x 4.53 mm
