Engineer1234/ConnectMedical/Connect Medical Boards/FP1/step/CSD13380F3-DFN40P69X35-3L v2-PIN1.step

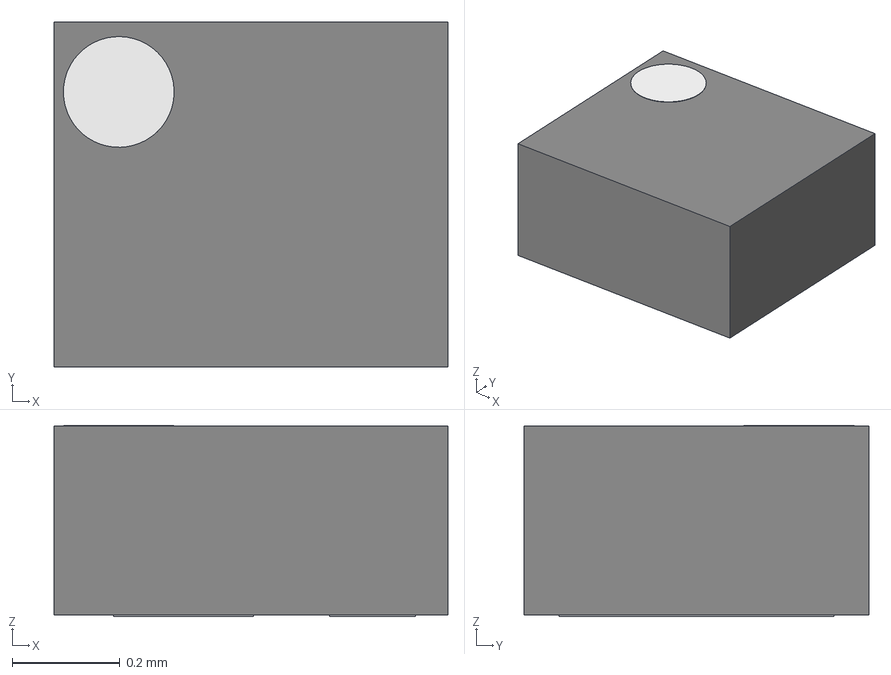
[picture p20: CAD file, 2017-09-07]
Connect Medical Boards/FP1/step/CSD13380F3-DFN40P69X35-3L v2-PIN1.step
0.73 x 0.64 x 0.354 mm
bigPin
smallPine x 2
