Engineer1234/ConnectMedical/(list of files, cad)

Other CAD files:
Connect Medical Boards/FP1/step/M24256-DFCS6TPK v2.step
Connect Medical Boards/FP1/step/CSD23382F4 -DFN65P100X35-3L v1-PIN1.step
