Engineer1234/ConnectMedical/feasibility_circuits/sr_button_cells_benchmarking/rev.1/Load Resistors.xlsx

Dual Cell |  |  |  |  |  |  | Single Cell
@ VIN = 2 V |  |  |  |  | @ VIN = 2.6V and same RL |  | @VIN = 1 V |  |  |  |  | @ VIN = 1.3V and same RL
RL = |  |  | RL (actual) = |  | IL = |  | RL = |  |  | RL (actual) = |  | IL =
2 | MΩ | @ 1 µA | 2 | MΩ | 1.3 | µA | 500 | kΩ | @ 2 µA | 499 | kΩ | 2.6 | µA
400 | kΩ | @ 5 µA | 402 | kΩ | 6.5 | µA | 100 | kΩ | @ 10 µA | 100 | kΩ | 13 | µA
200 | Ω | @ 10 mA | 200 | Ω | 13 | mA | 50 | Ω | @ 20 mA | 51 | Ω | 25.5 | mA
100 | Ω | @ 20 mA | 100 | Ω | 26 | mA | 25 | Ω | @ 40 mA | 27 | Ω | 48.1 | mA
66.67 | Ω | @ 30 mA | 68 | Ω | 38.2 | mA | 16.67 | Ω | @ 60 mA | 18 | Ω | 72.2 | mA
50 | Ω | @ 40 mA | 51 | Ω | 51 | mA | 12.5 | Ω | @ 80 mA | 13 | Ω | 100 | mA
40 | Ω | @ 50 mA | 40.2 | Ω | 64.7 | mA | 10 | Ω | @ 100 mA | 10 | Ω | 130 | mA
33.3 | Ω | @ 60 mA | 33 | Ω | 78.8 | mA | 8.3 | Ω | @ 120 mA | 8.2 | Ω | 158.5 | mA
