Engineer1234/ConnectMedical/Connect Medical Boards/FP1/Project Outputs for 105358-3BA001-03_FP1/PDF/105358-3SC001-03-E_Schematic_EFP1.pdf

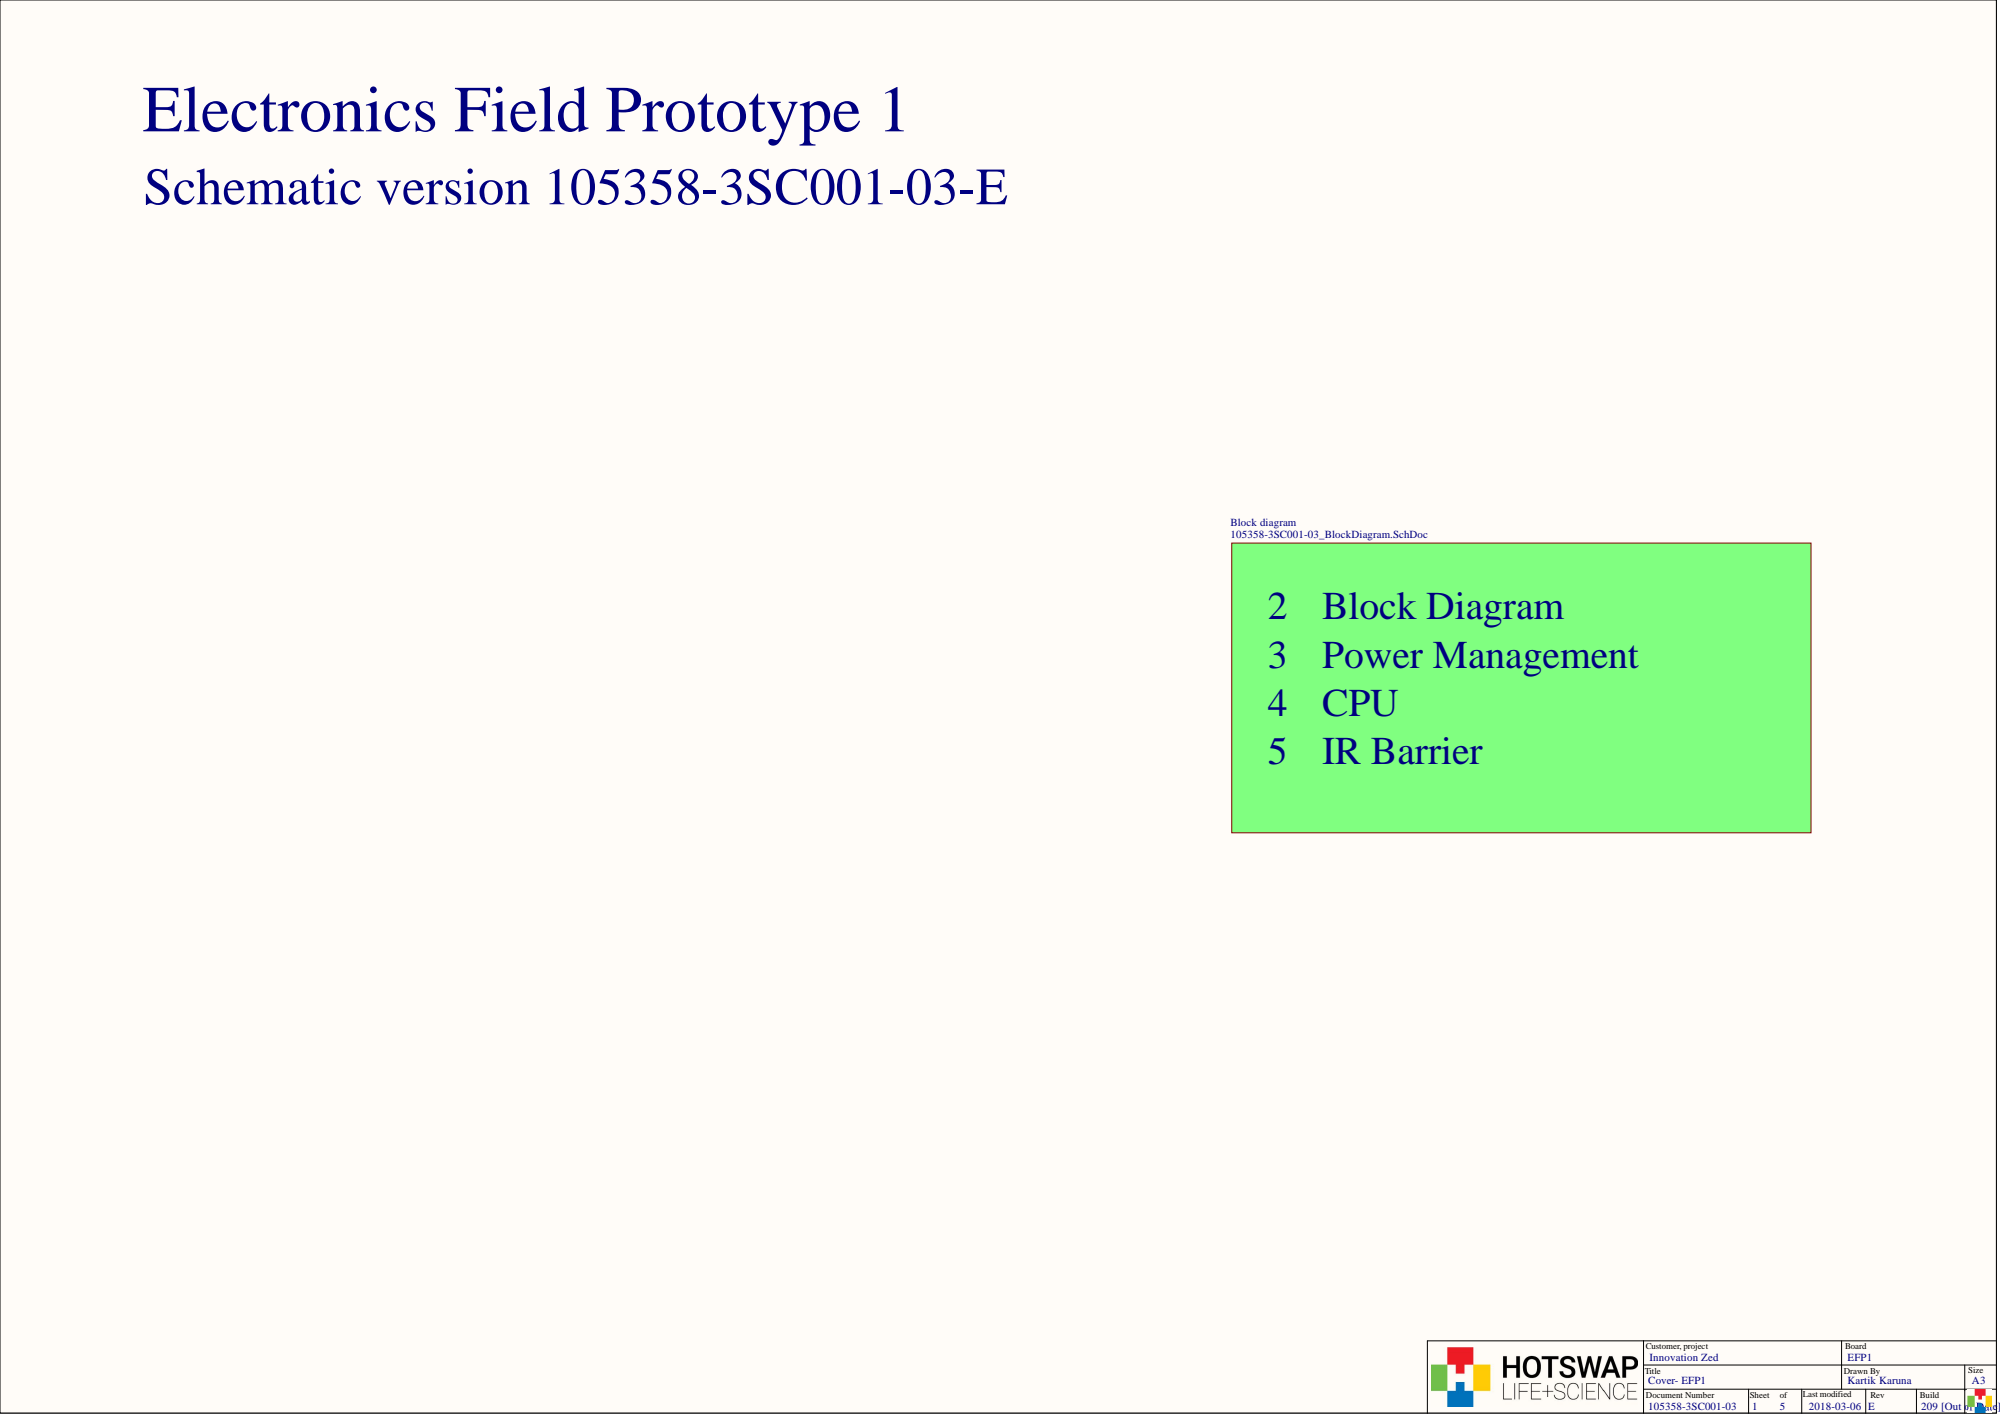
[picture p21: page 1]

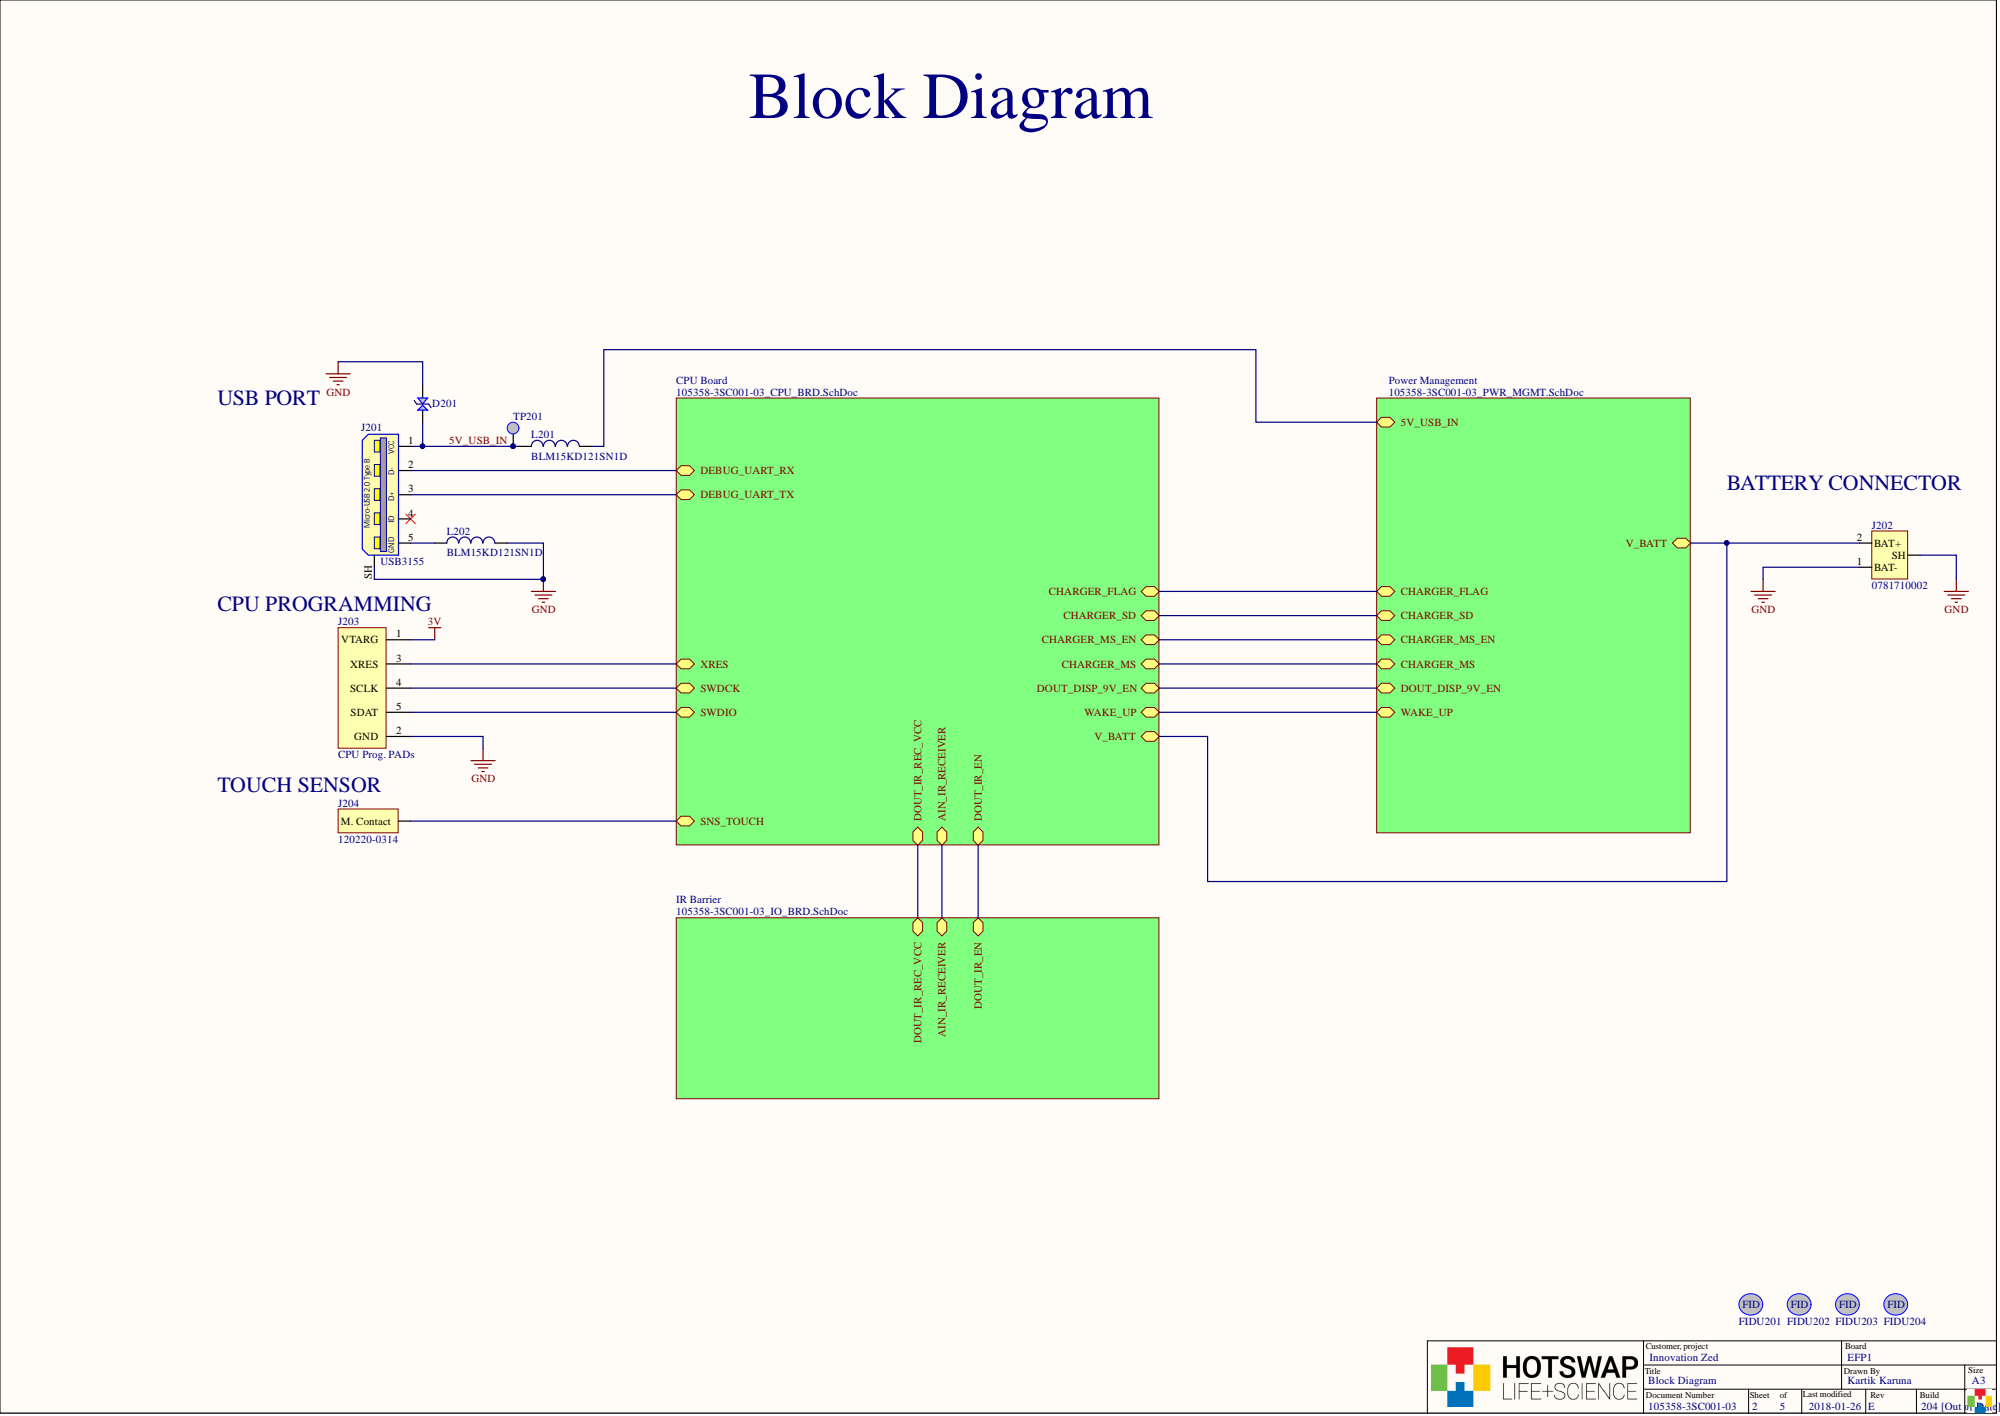
[picture p22: page 2]

Micro-USB 2.0 Type B SH

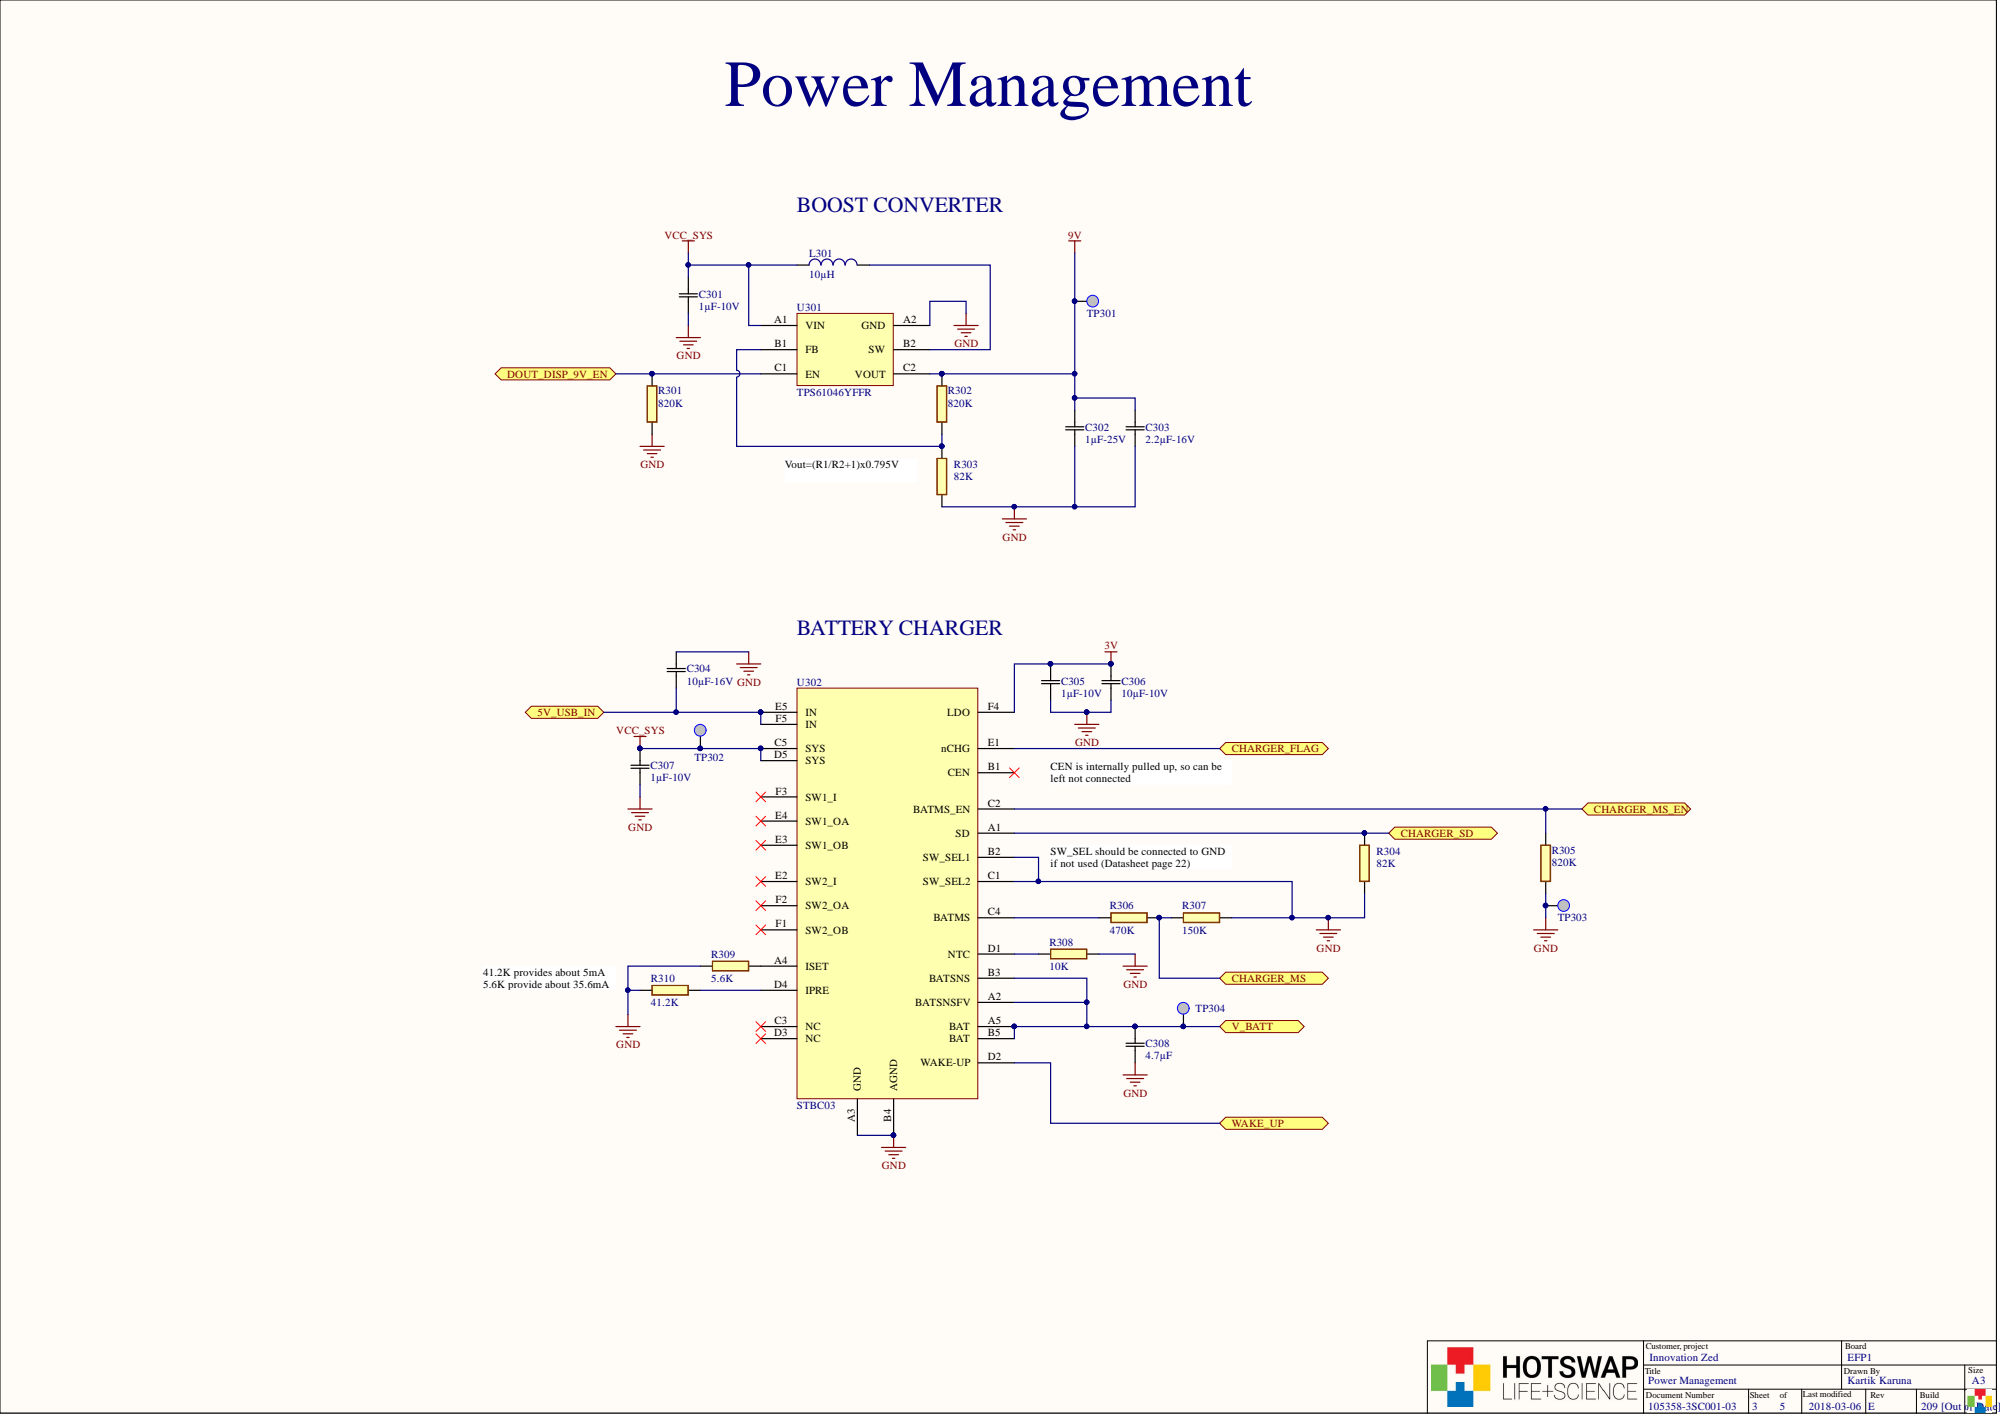
[picture p23: page 3]

VIN A1

FB B1 | GND

EN C1 VOUT | C2

SYS C5

TP302 | SYS D5

CEN is internally pulled up, so can be
left not connected

SW_SEL should be connected to GND
if not used (Datasheet page 22)

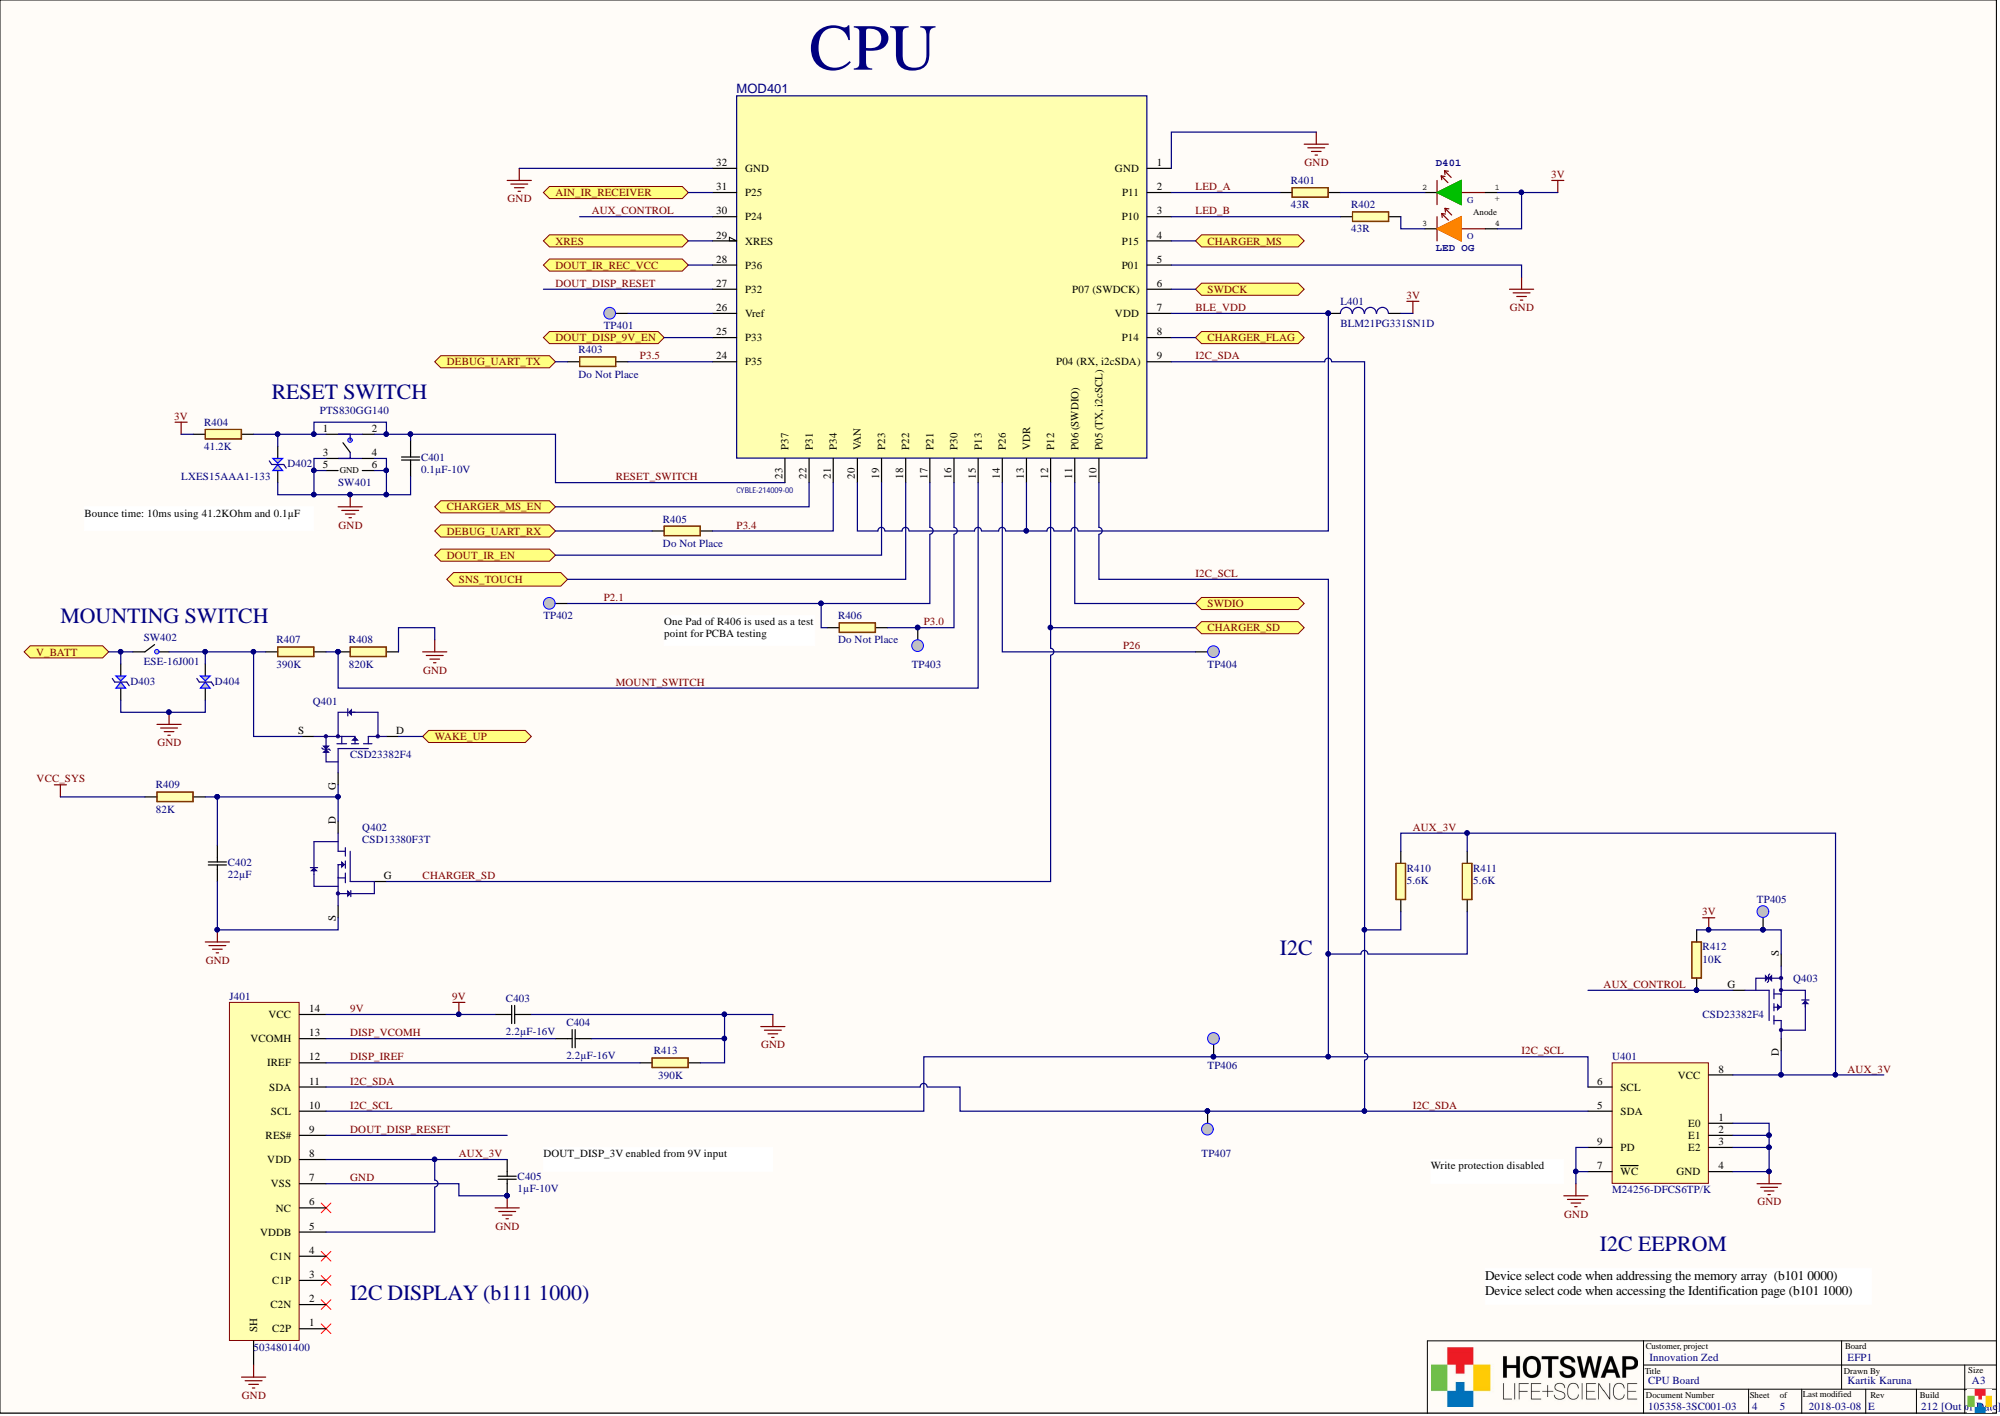
[picture p24: page 4]

XRES 29 | 3

Bounce time: 10ms using 41.2KOhm and 0.1µF

One Pad of R406 is used as a test
point for PCBA testing

Device select code when addressing the memory array (b101 0000)
Device select code when accessing the Identification page (b101 1000)

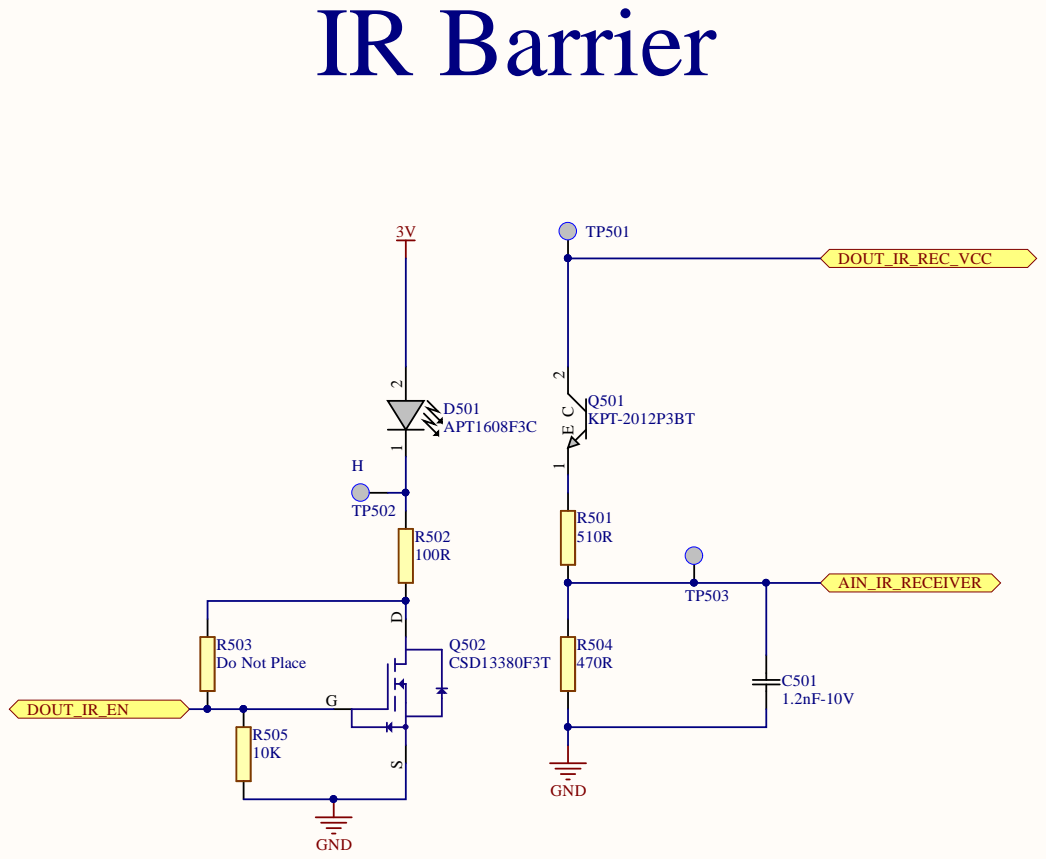
[picture p25: page 5]
