Engineer1234/ConnectMedical/Connect Medical Boards/FP1/Project Outputs for 105358-3BA001-03_FP1/PDF/105358-3CD005-02 Assembly Drawing_EFP1.PDF

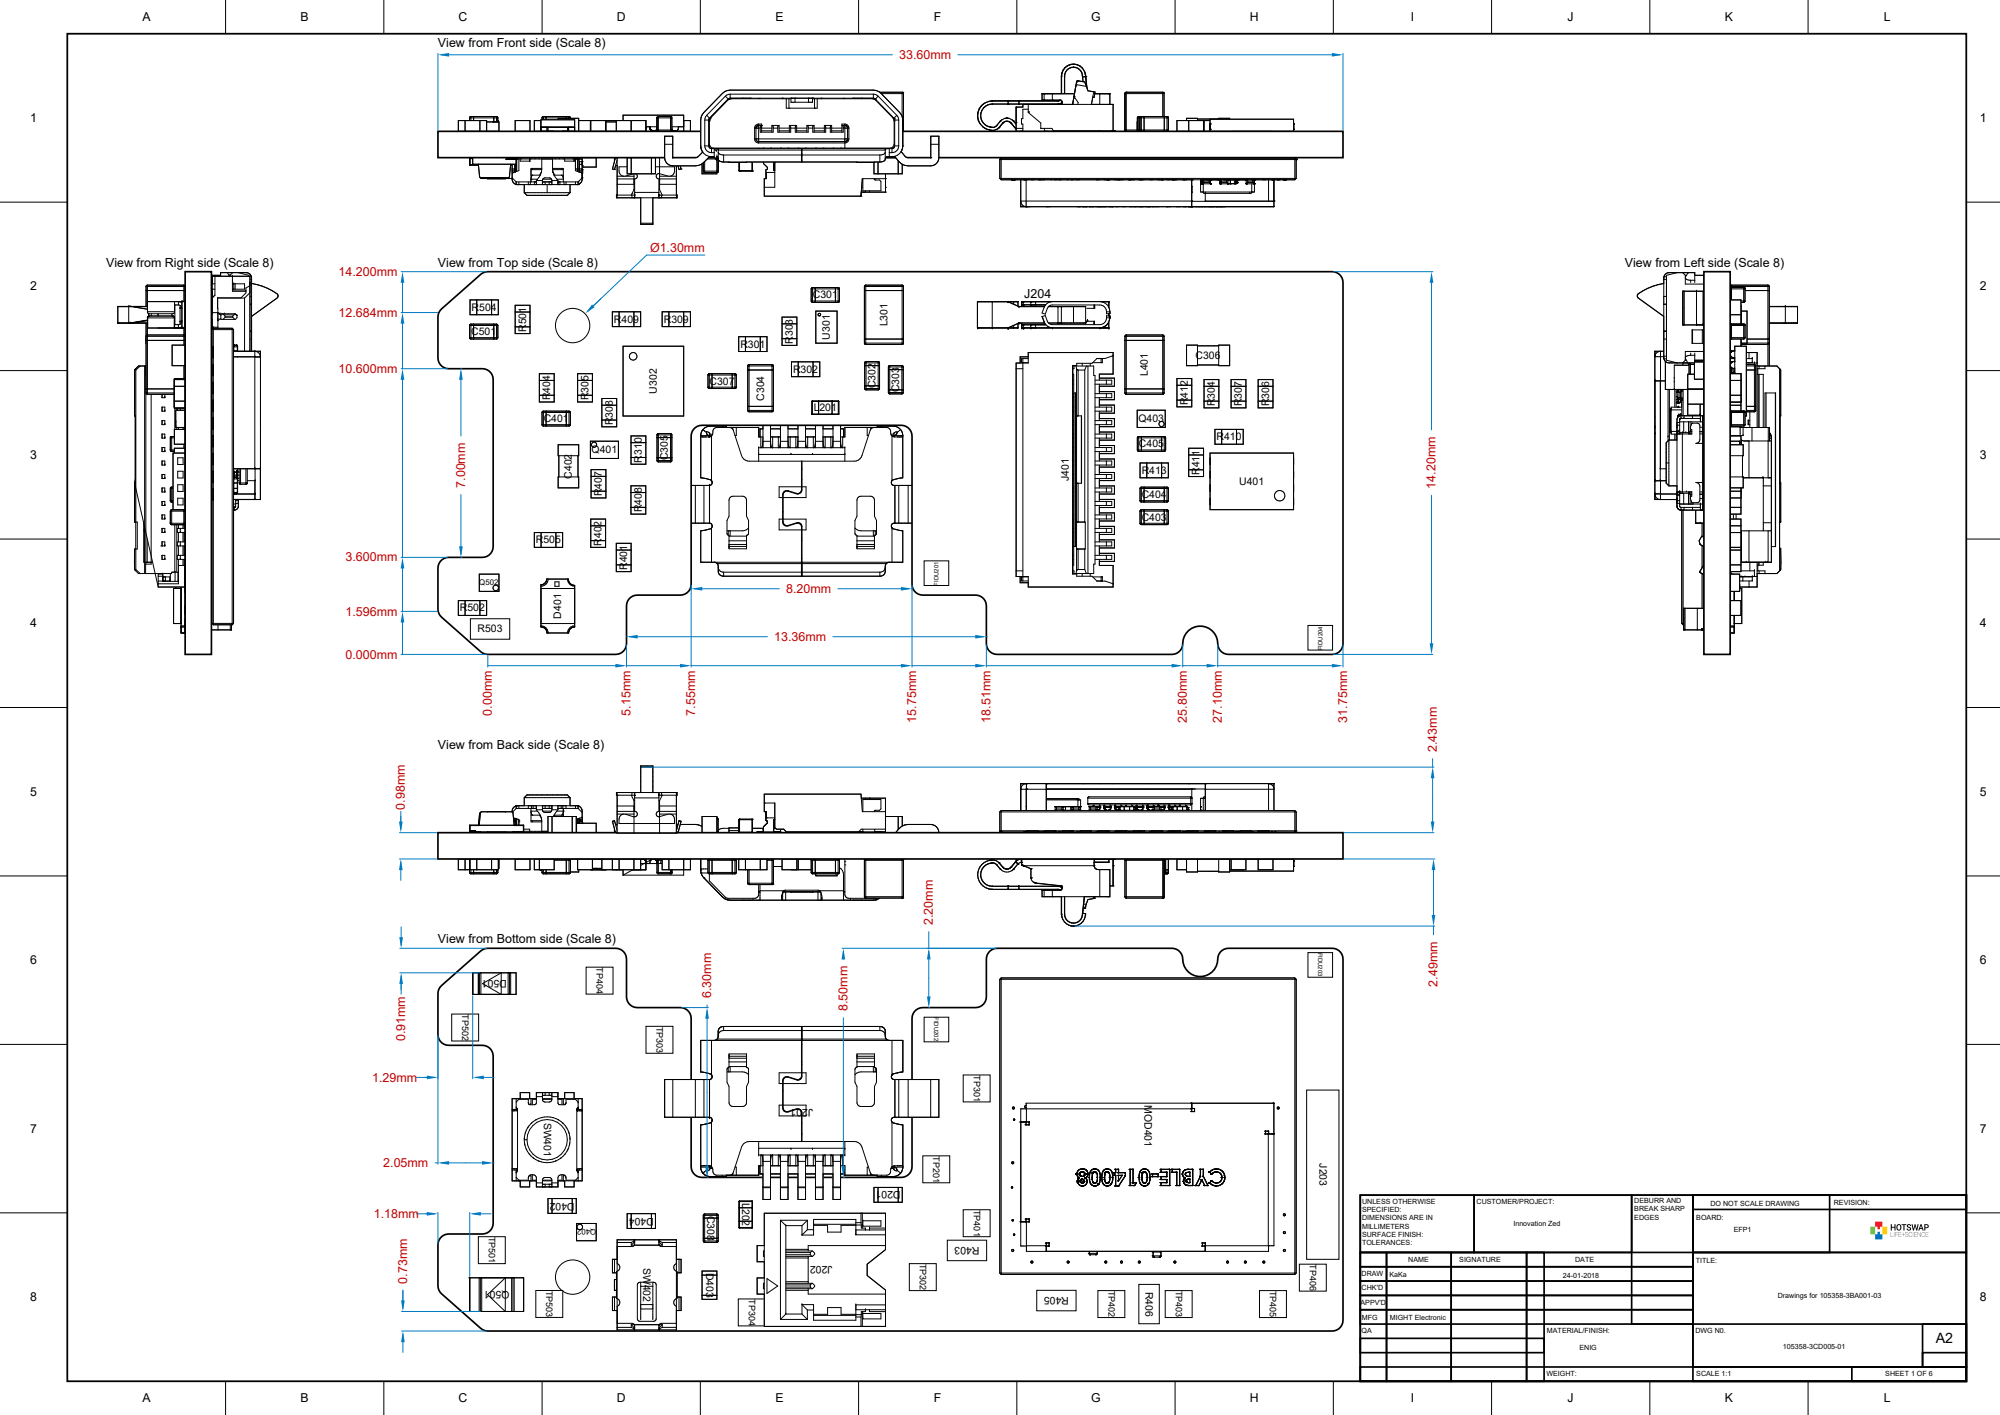
[picture p32: page 1]

View from Front side (Scale 8)

View from Top side (Scale 8)

View from Back side (Scale 8)

View from Bottom side (Scale 8)

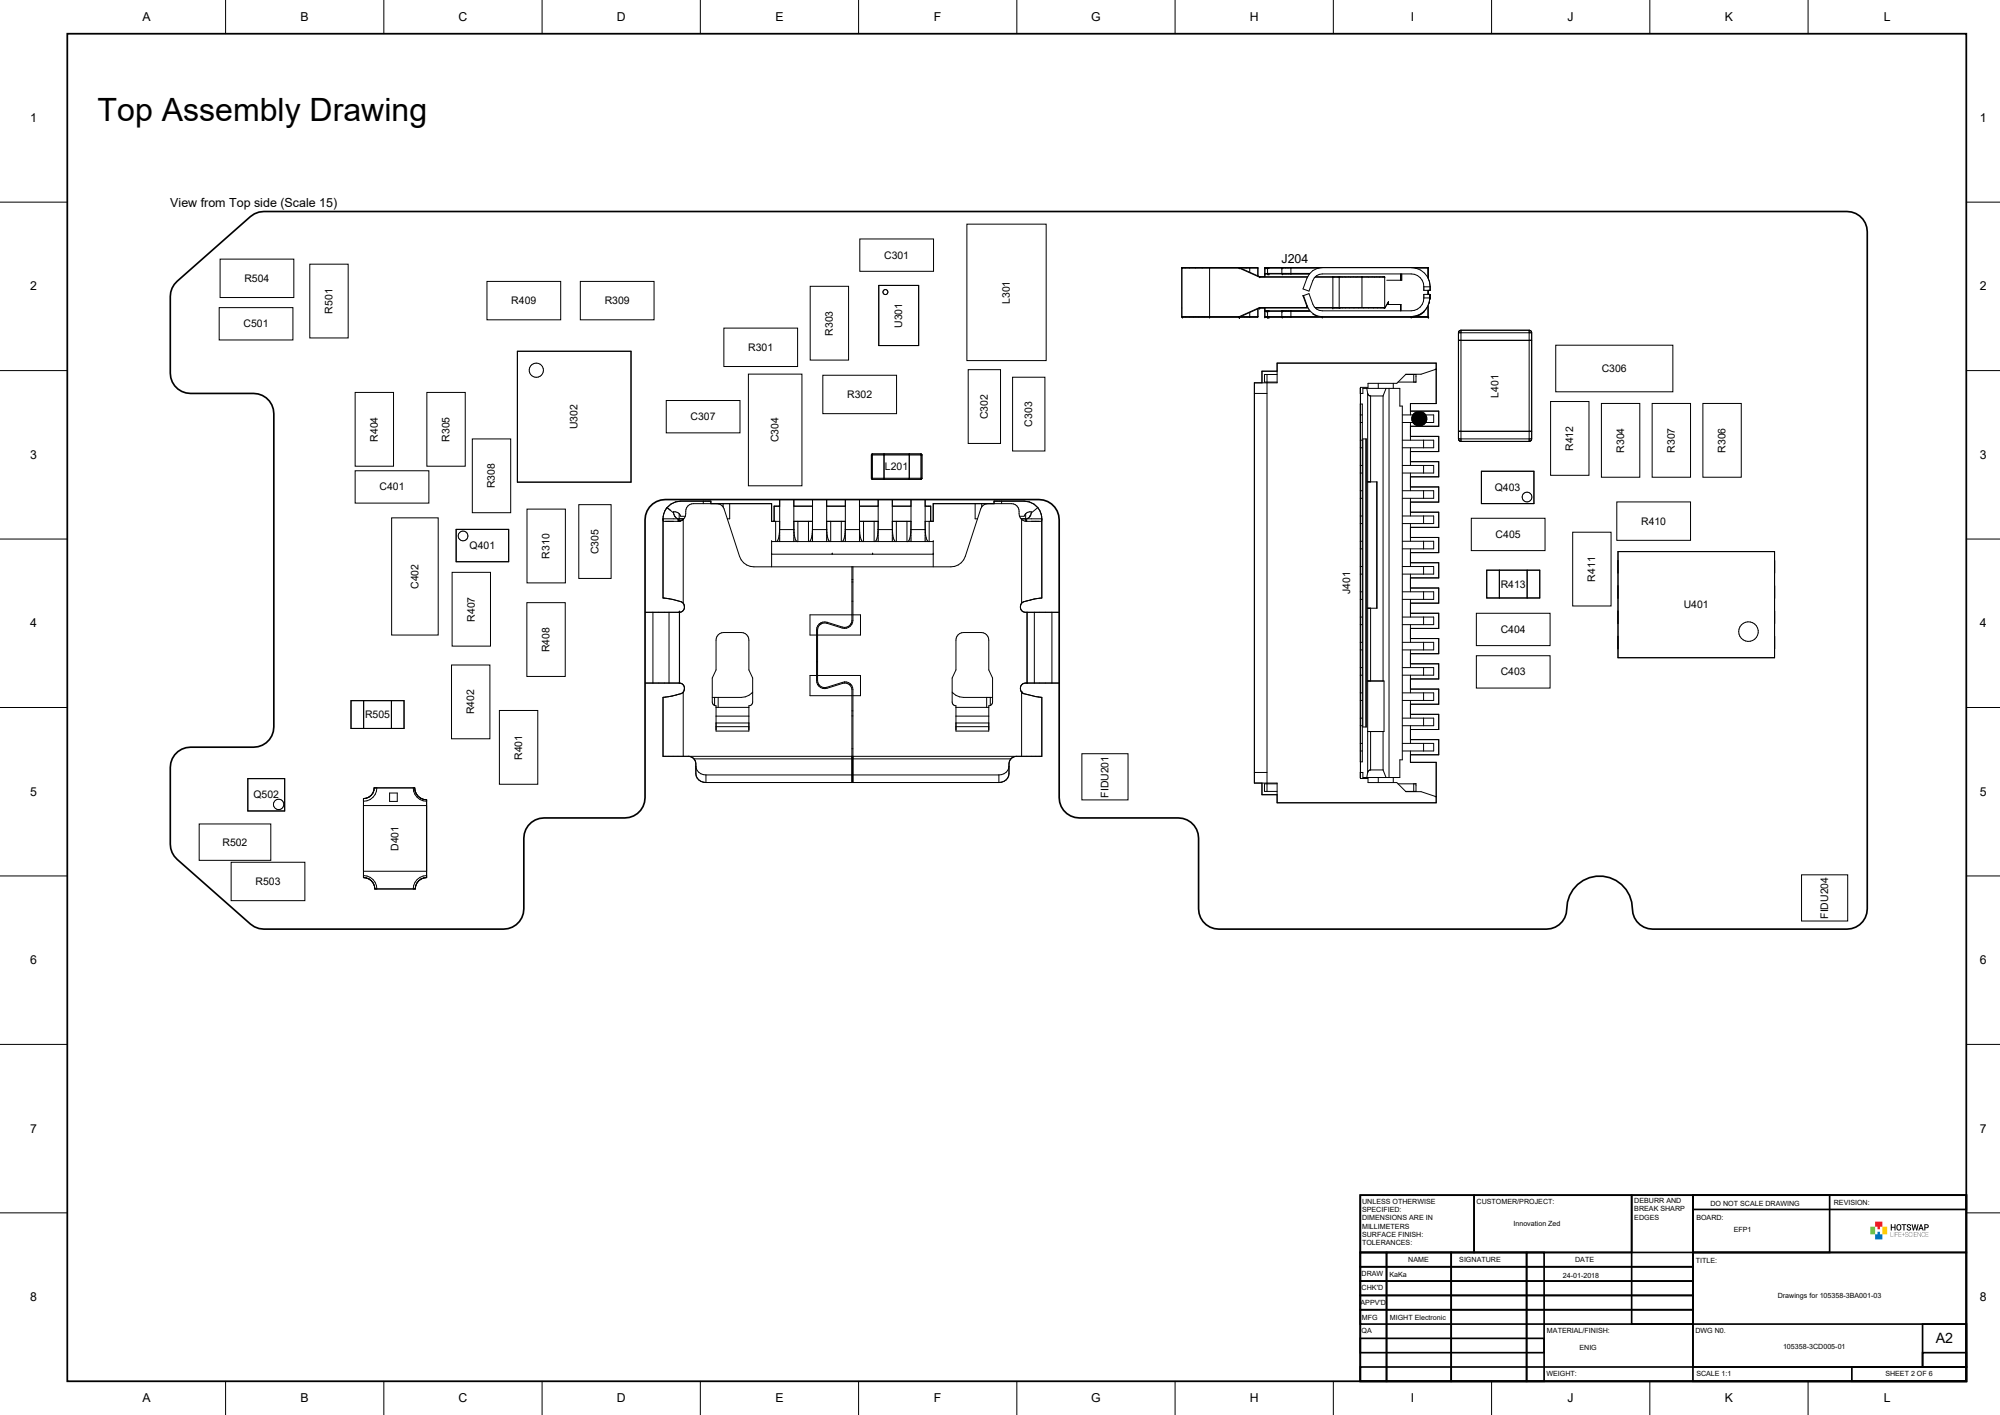
[picture p33: page 2]

View from Top side (Scale 15)

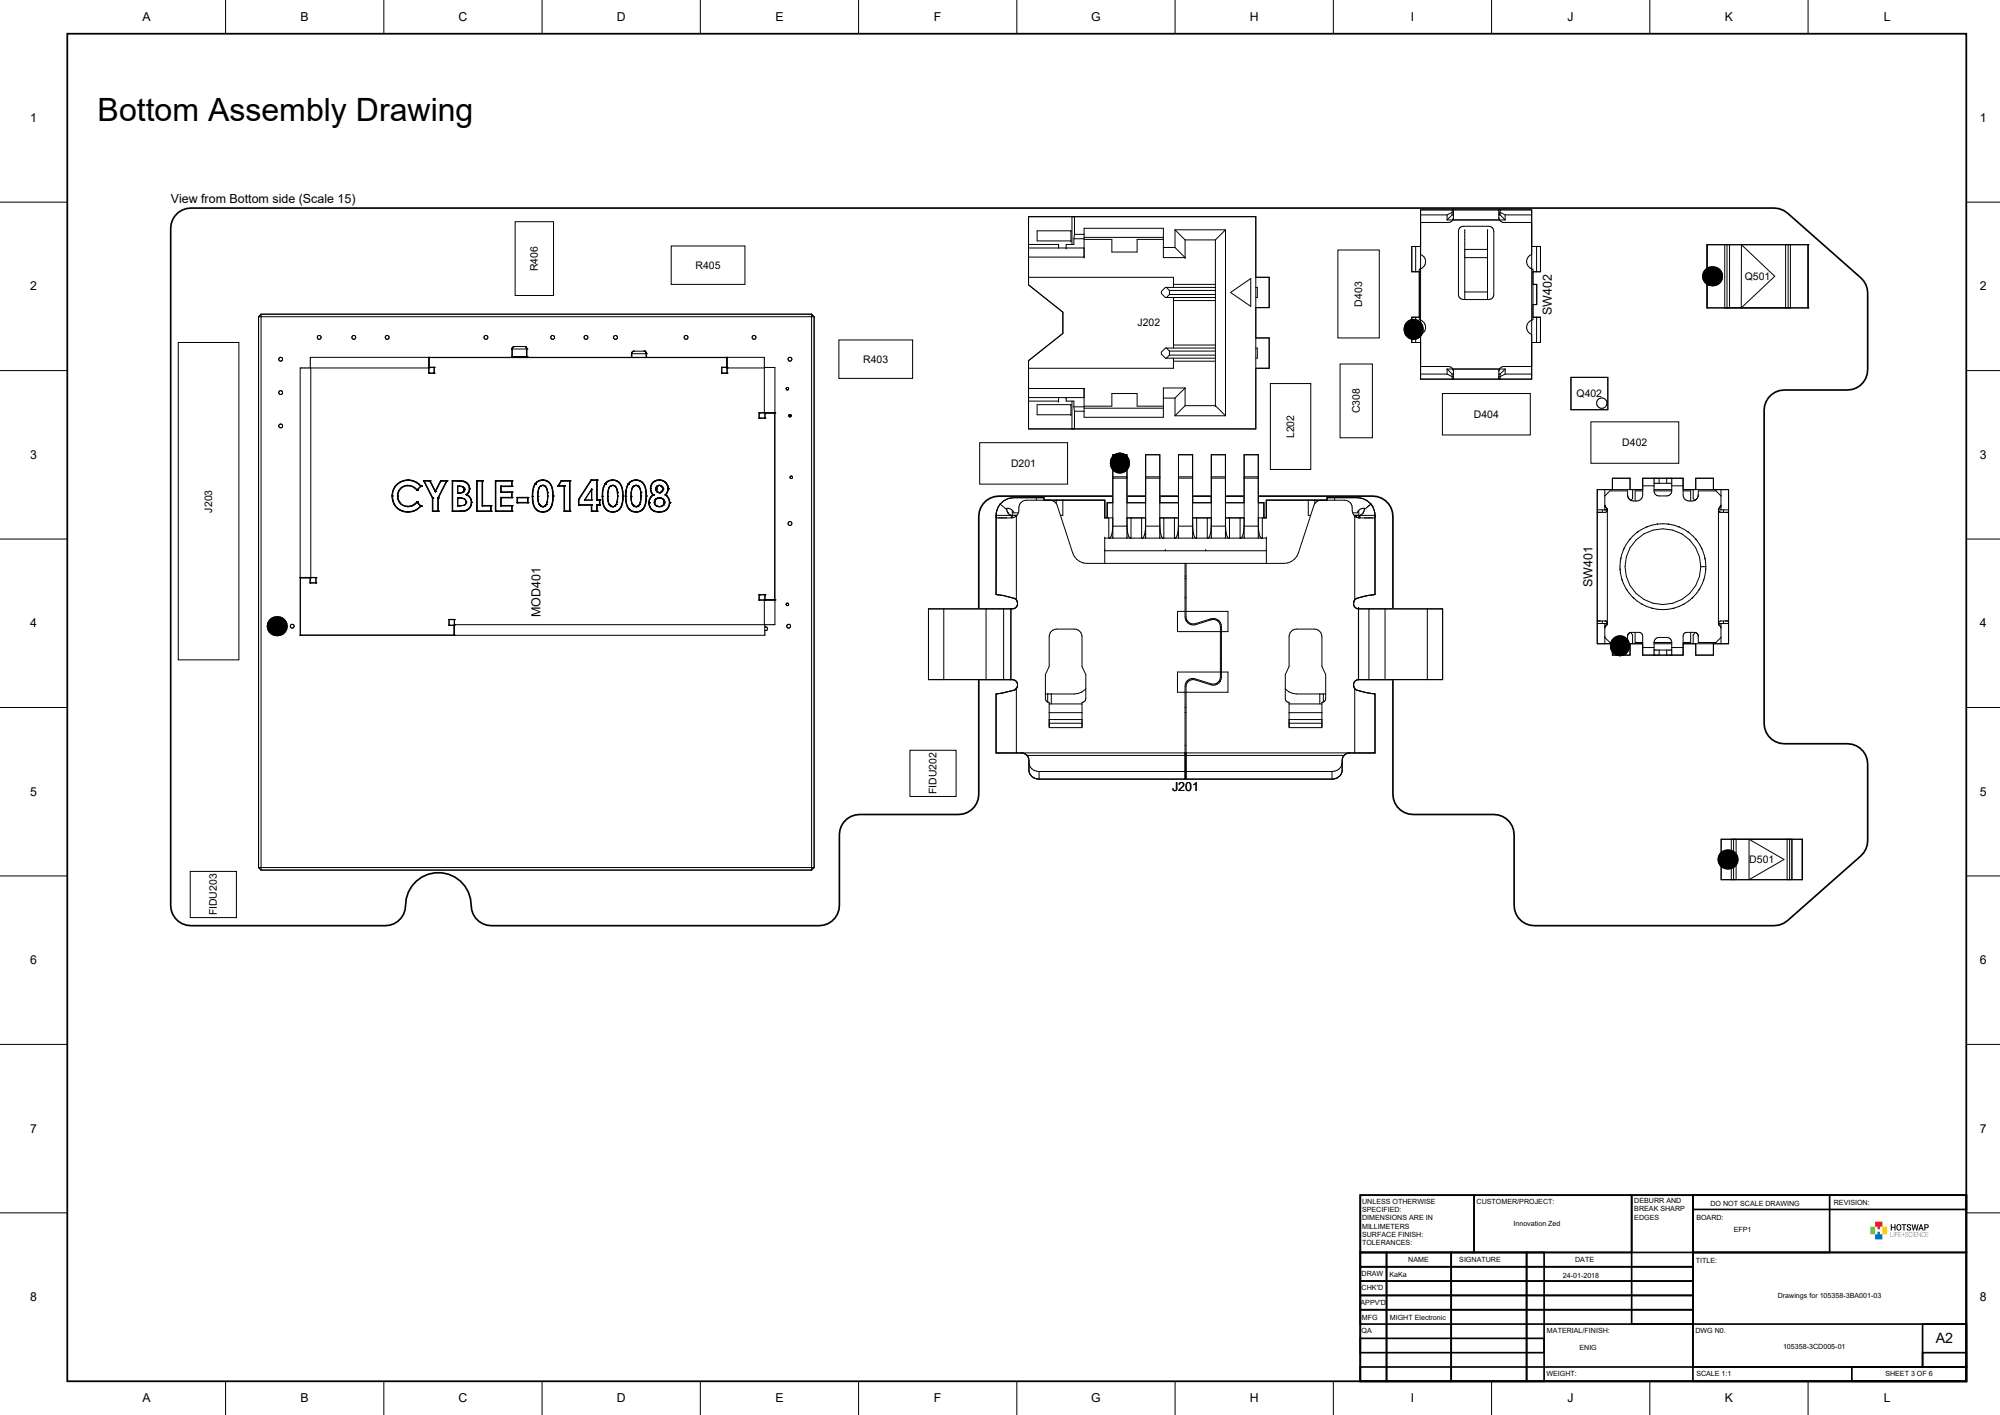
[picture p34: page 3]

View from Bottom side (Scale 15)

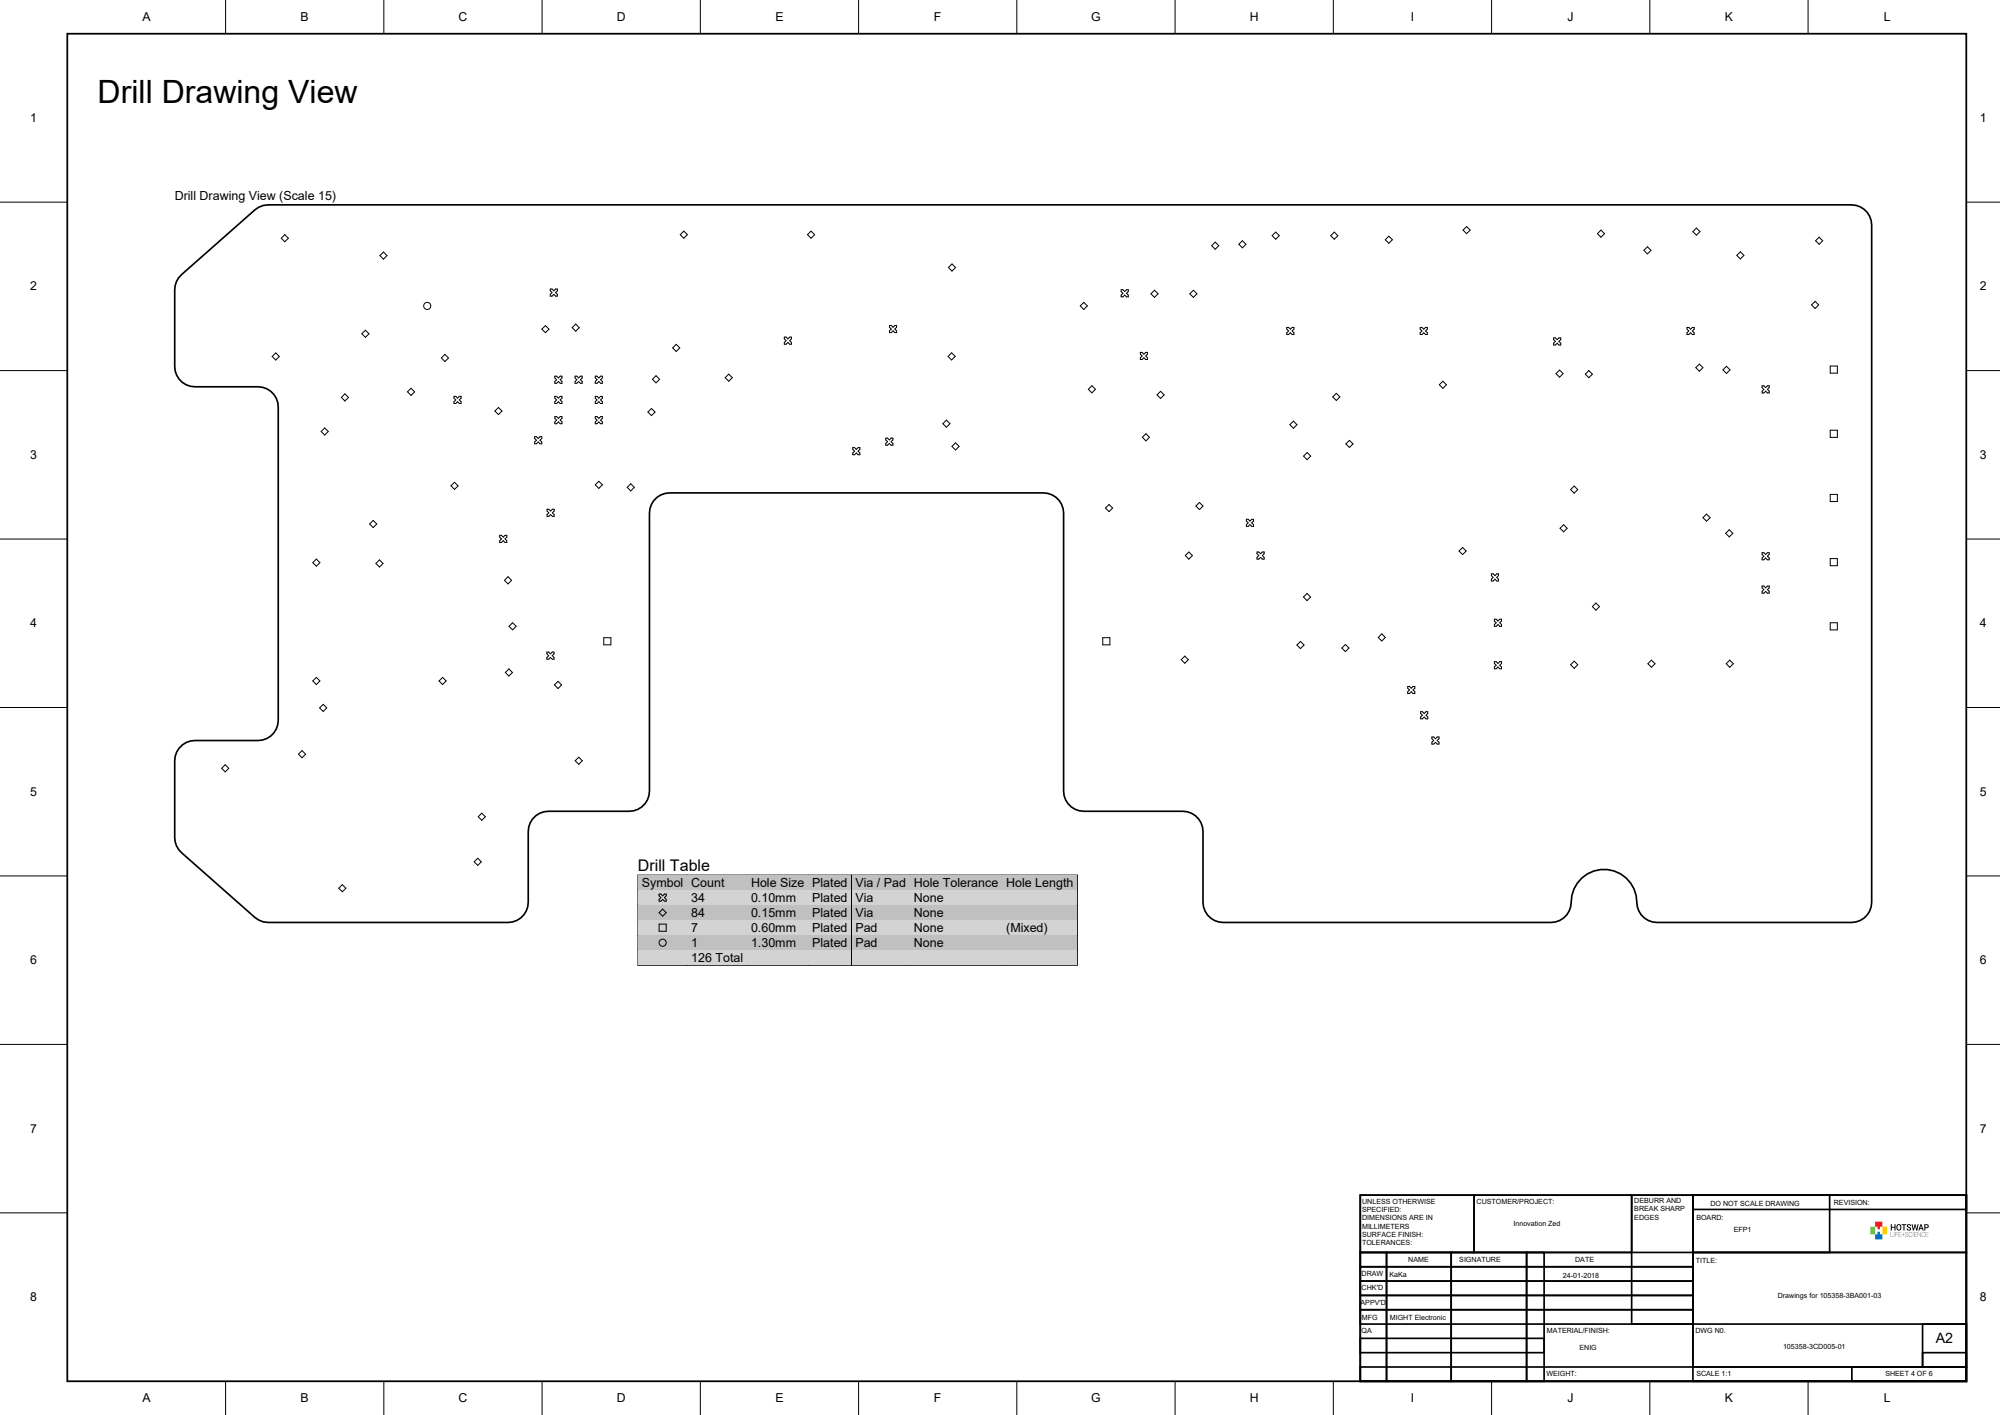
[picture p35: page 4]

Drill Drawing View (Scale 15)

Symbol | Count | Hole Size | Plated | Via / Pad | Hole Tolerance | Hole Length

34 | 0.10mm | Plated | Via | None
84 | 0.15mm | Plated | Via | None
7 | 0.60mm | Plated | Pad | None | (Mixed)
1 | 1.30mm | Plated | Pad | None
126 Total

UNLESS OTHERWISE SPECIFIED: DIMENSIONS ARE IN MILLIMETERS SURFACE FINISH: TOLERANCES: | CUSTOMER/PROJECT: Innovation Zed | DEBURR AND BREAK SHARP EDGES | DO NOT SCALE DRAWING | REVISION:

BOARD: EFP1

NAME | SIGNATURE | | DATE | TITLE:

DRAW | KaKa | | | 24-01-2018
CHK'D

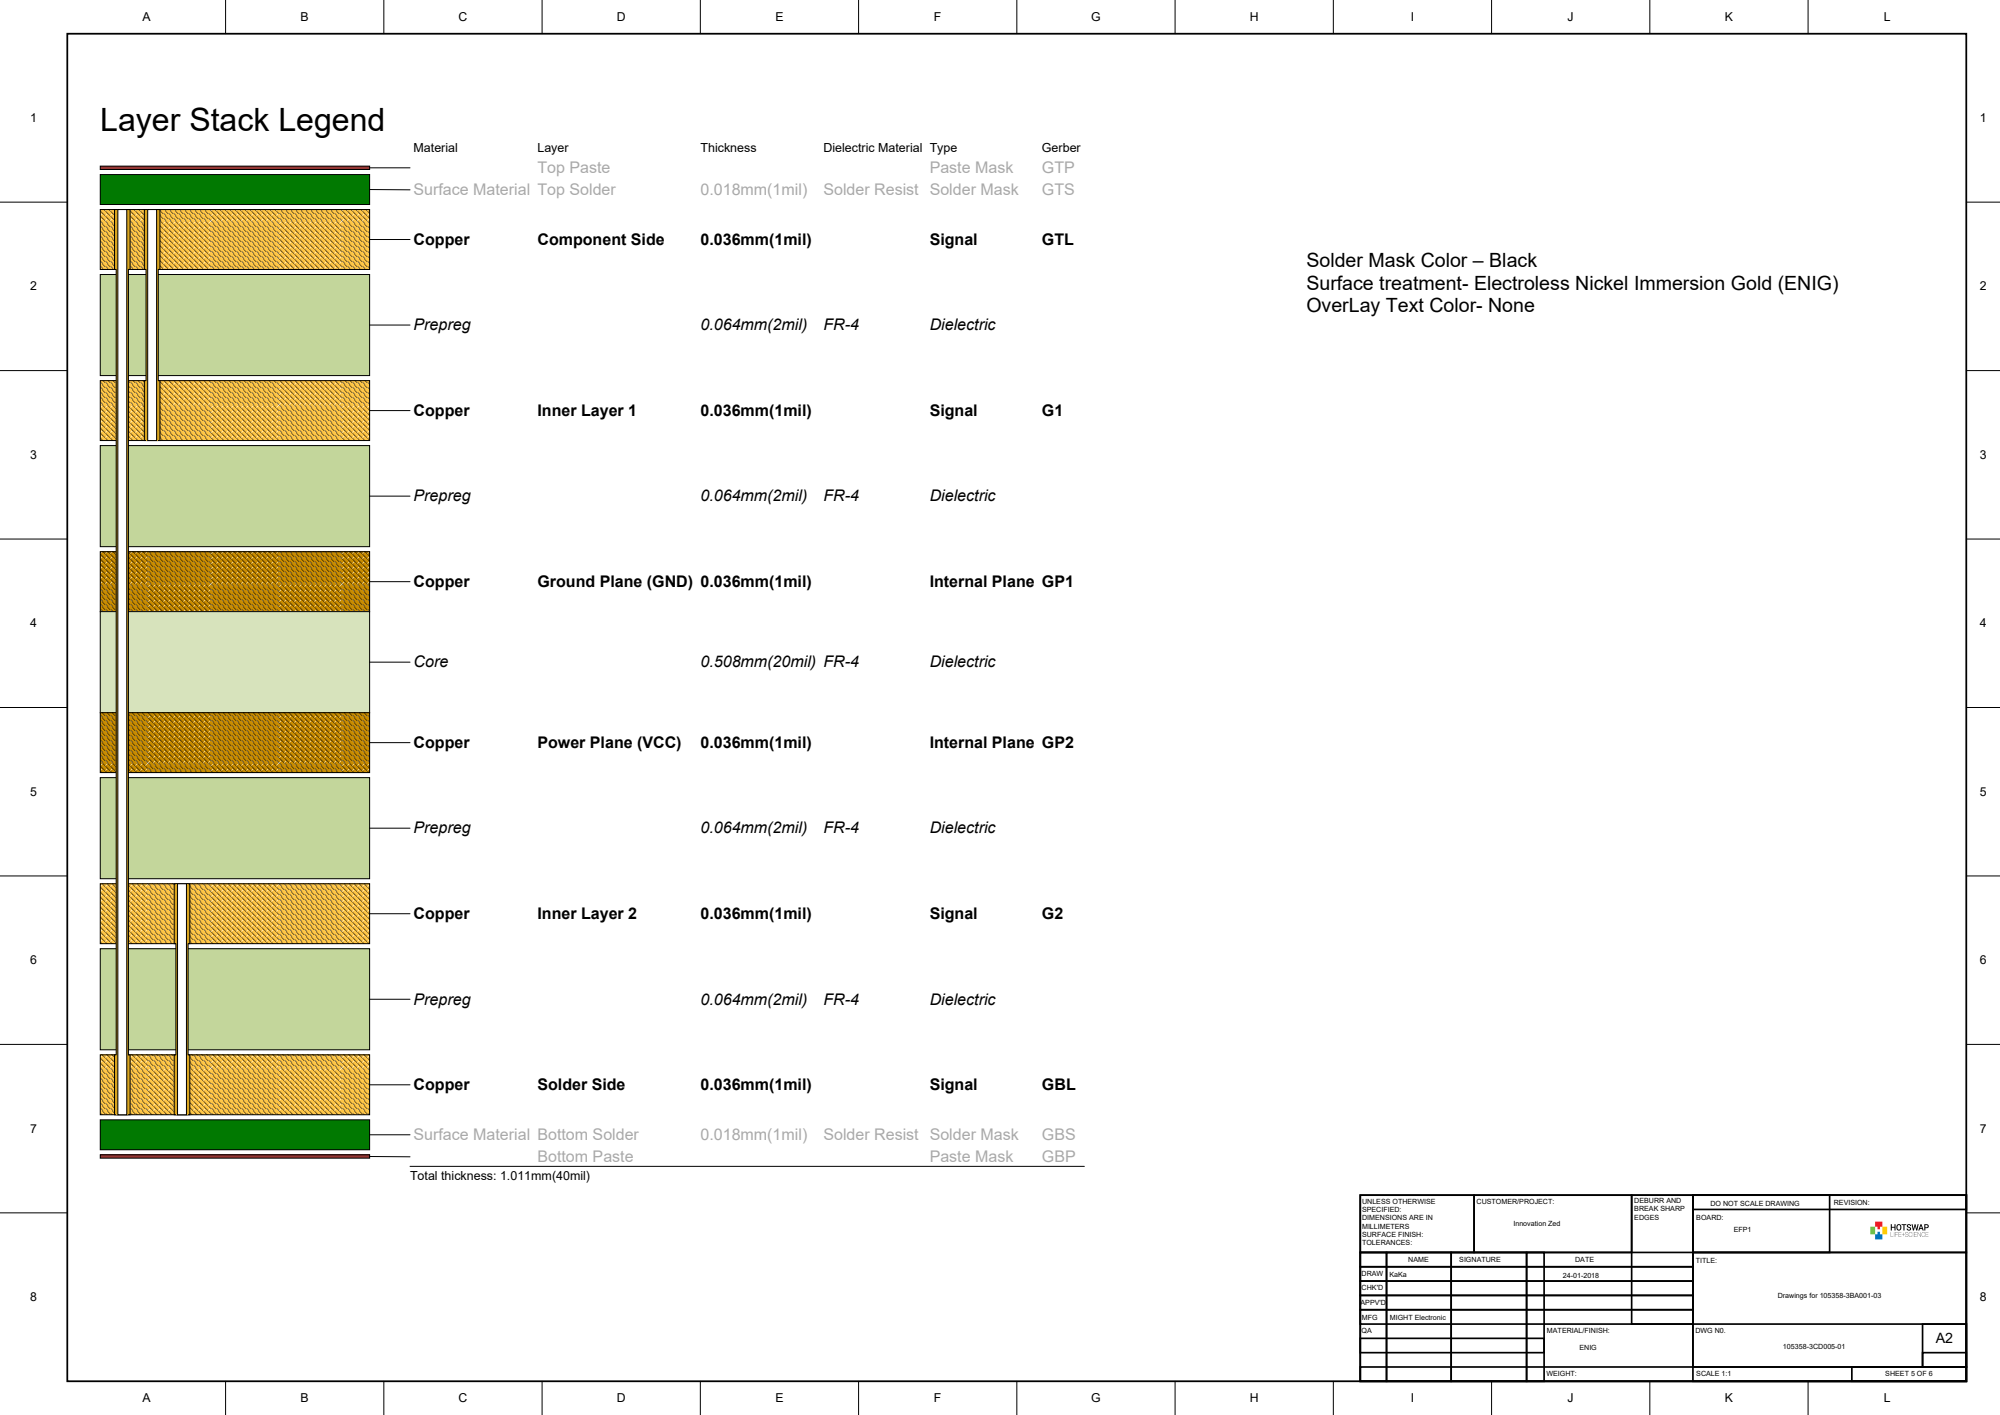
[picture p36: page 5]

Solder Mask Color – Black
Surface treatment- Electroless Nickel Immersion Gold (ENIG)
OverLay Text Color- None

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

BOARD: EFP1

NAME | SIGNATURE | | DATE | TITLE:

DRAW | KaKa | | | 24-01-2018
CHK'D

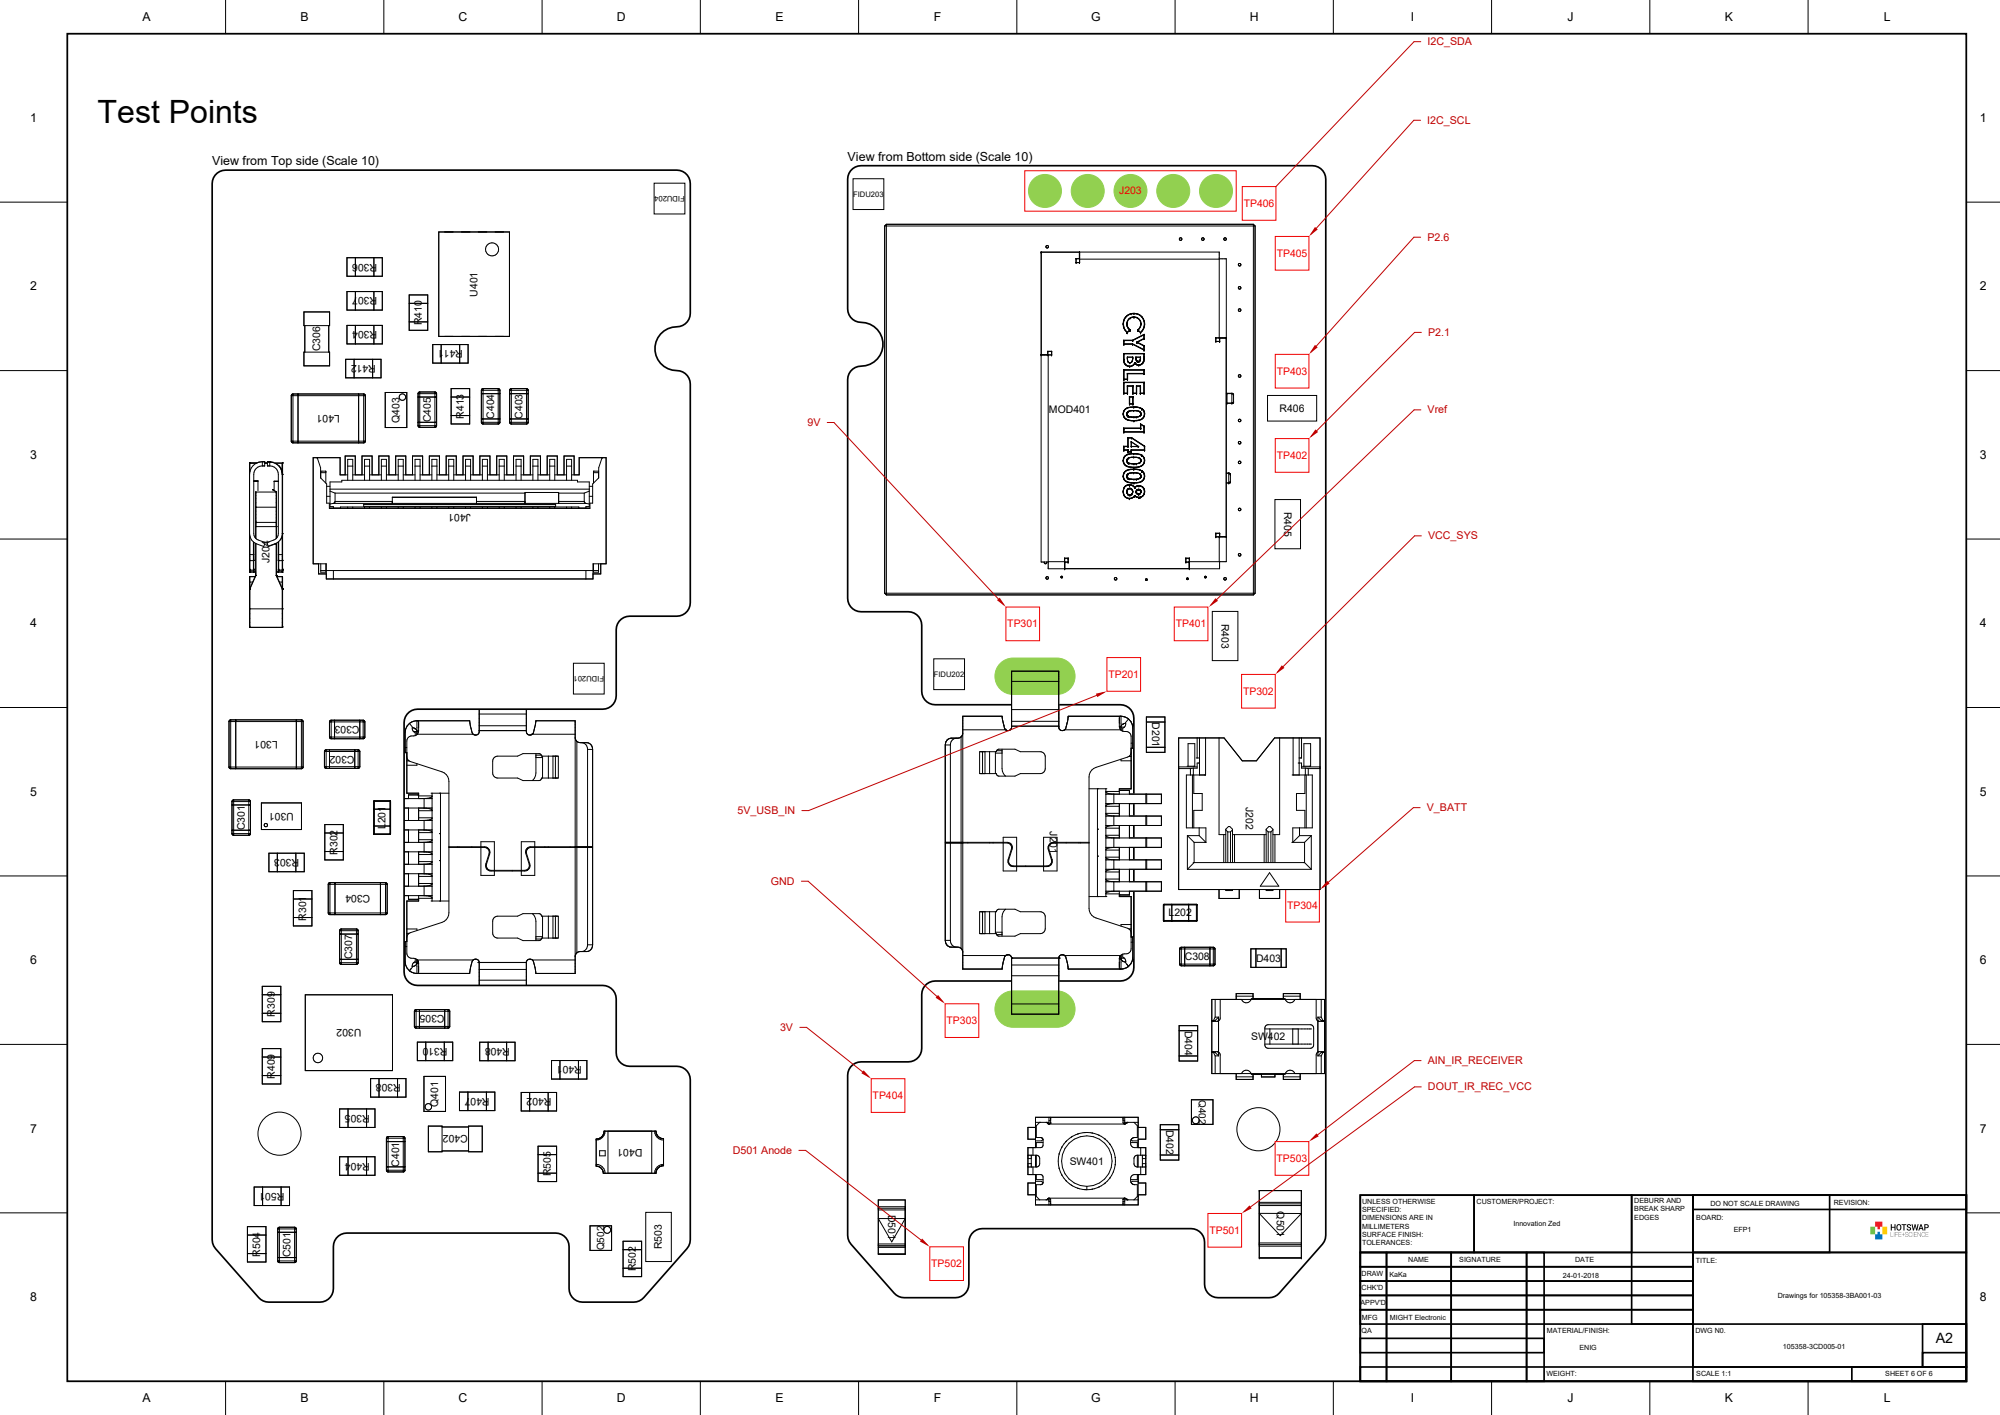
[picture p37: page 6]

View from Top side (Scale 10)

View from Bottom side (Scale 10)
