Engineer1234/ConnectMedical/Connect Medical Boards/FP1/Project Outputs for 105358-3BA001-03_FP1/PDF/105358-3SC001-03-B_Schematic_EFP1.pdf

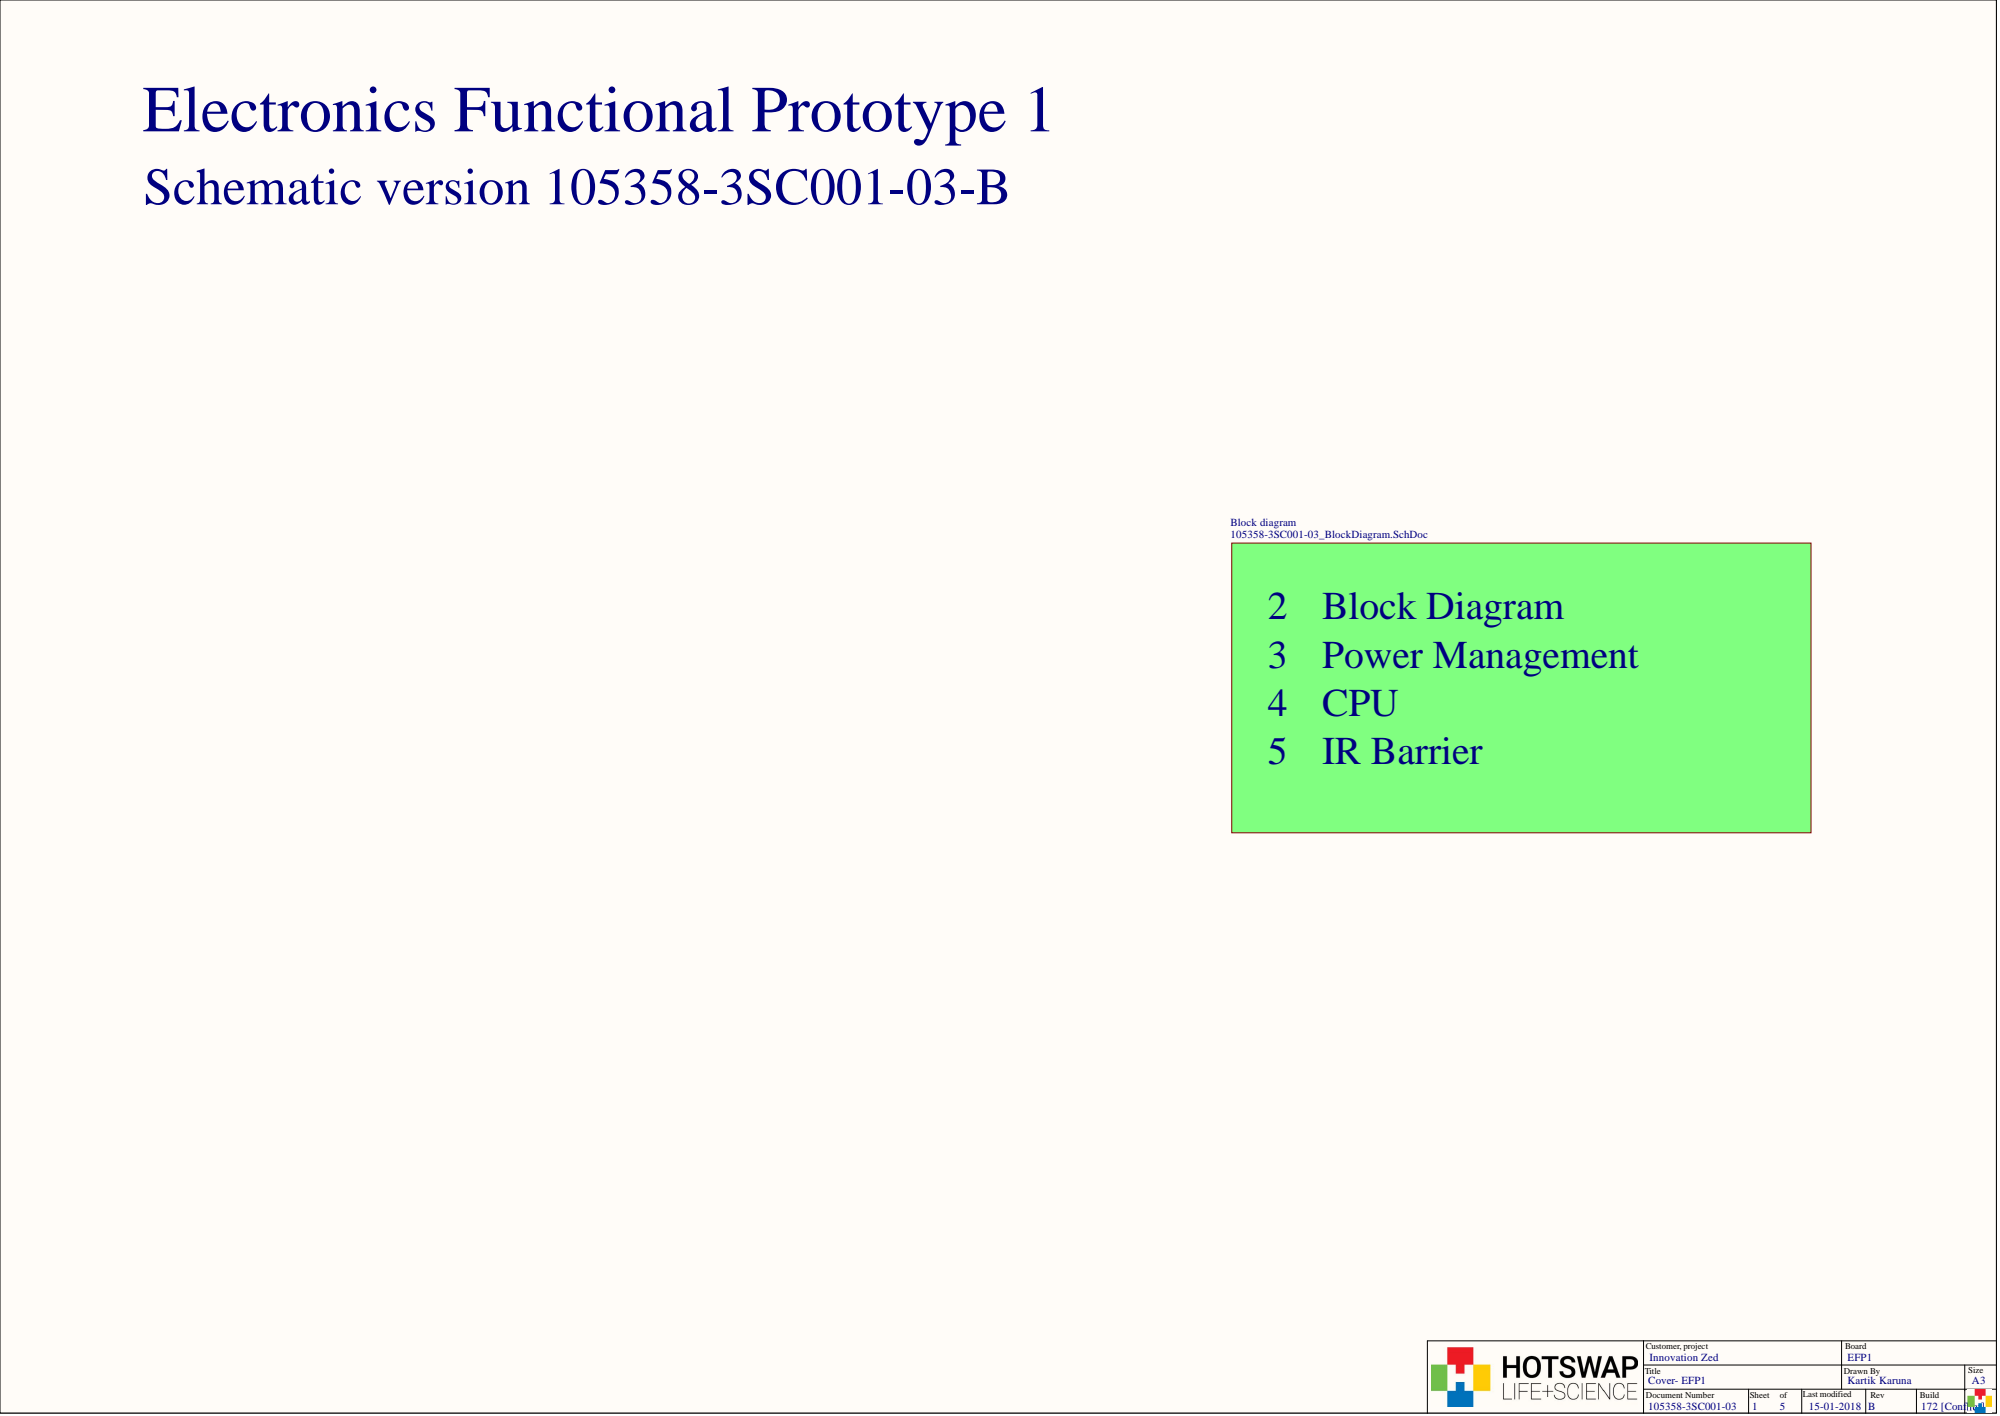
[picture p60: page 1]

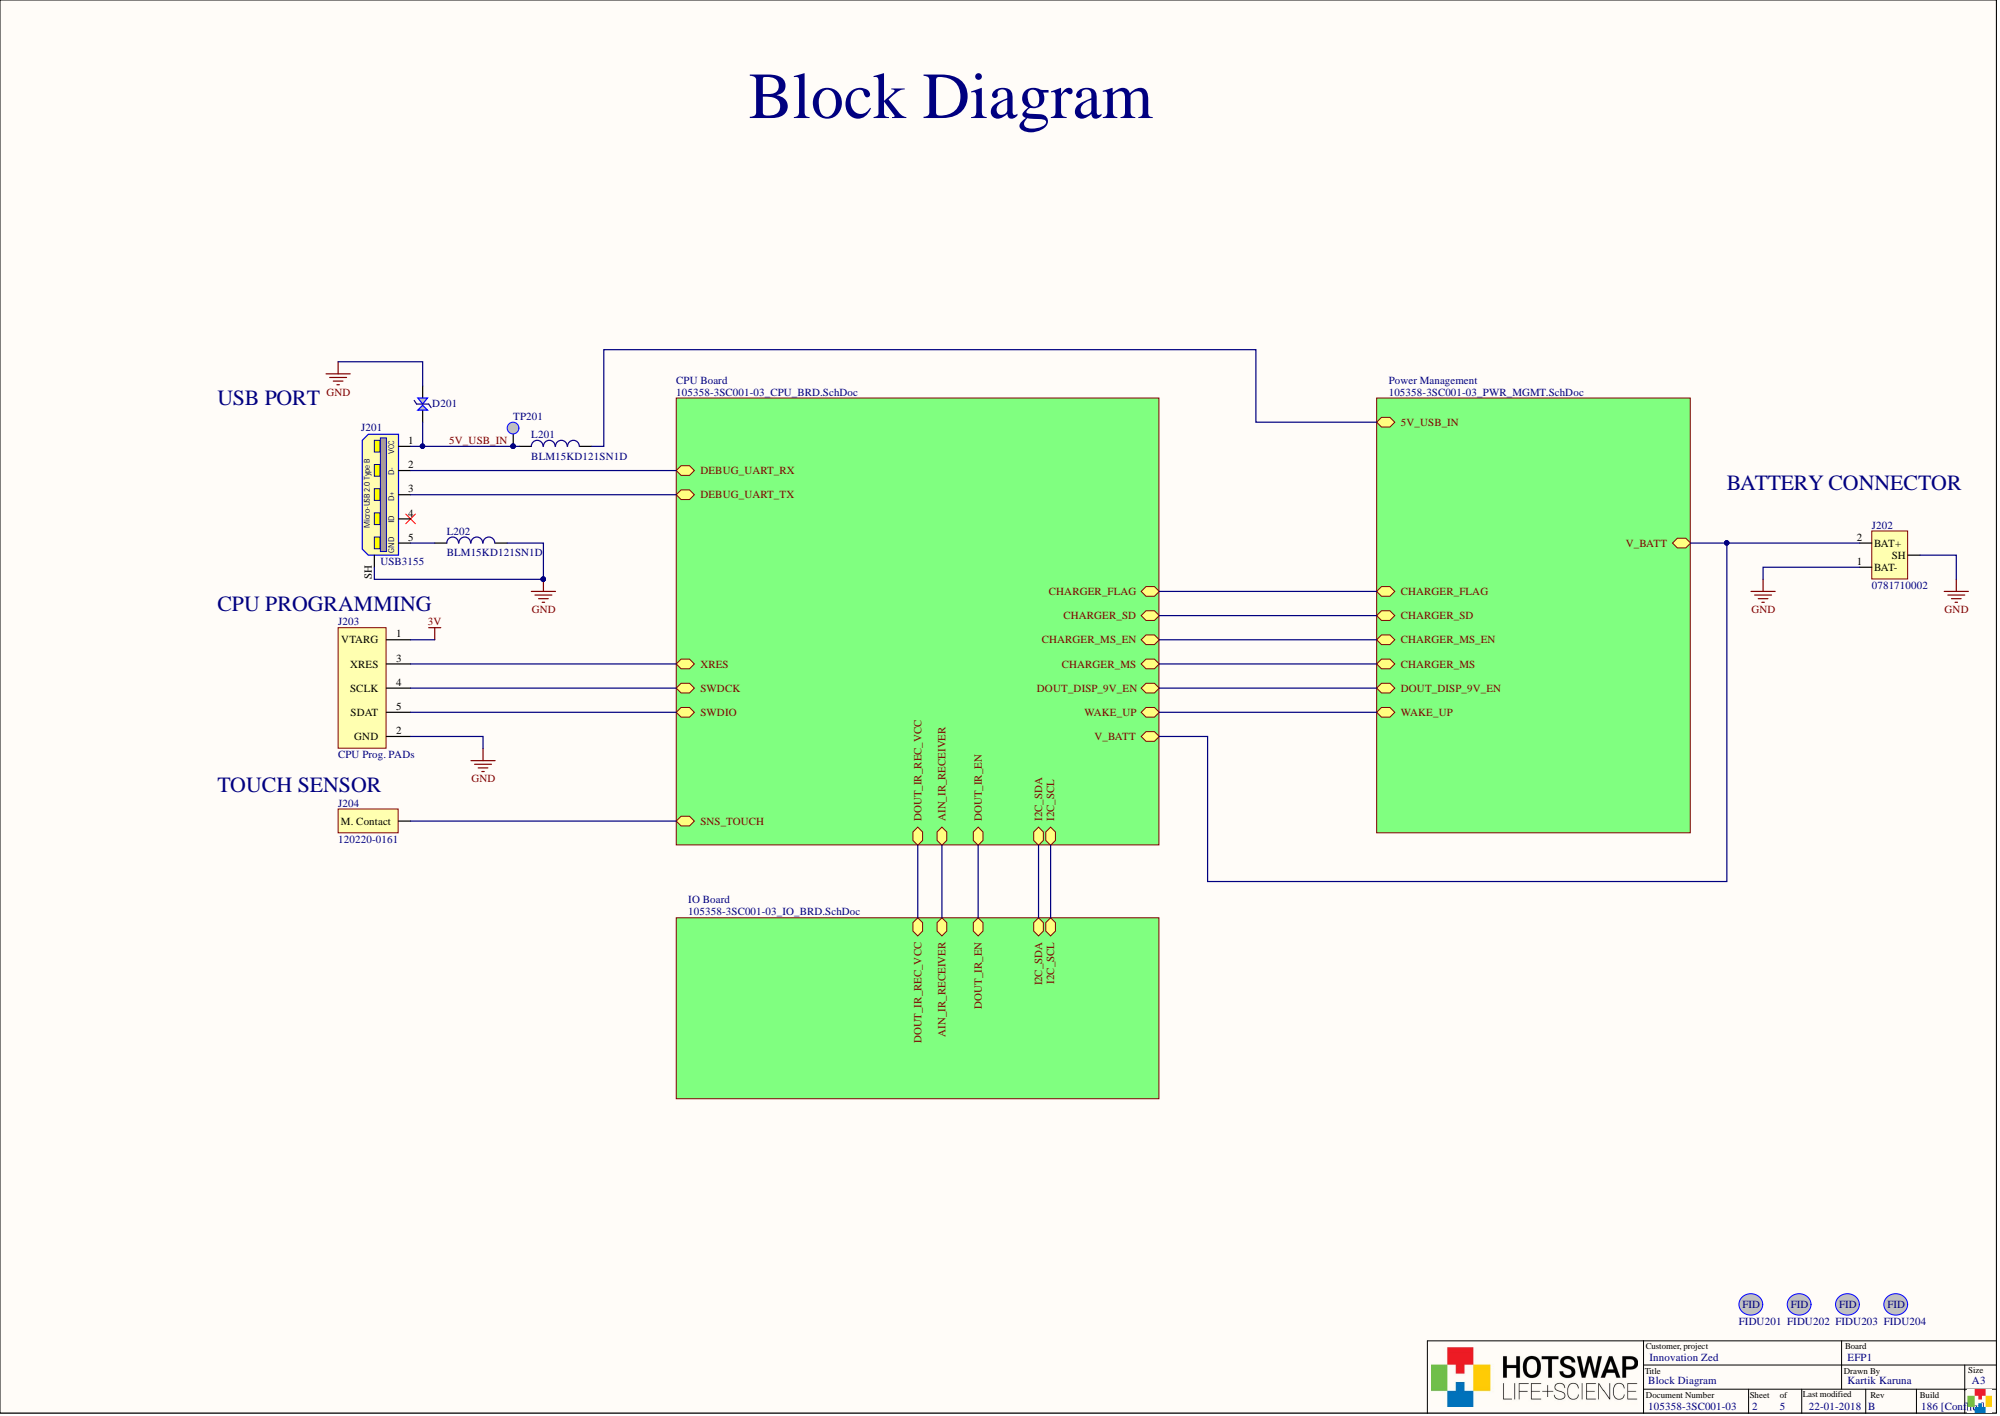
[picture p61: page 2]

Micro-USB 2.0 Type B SH

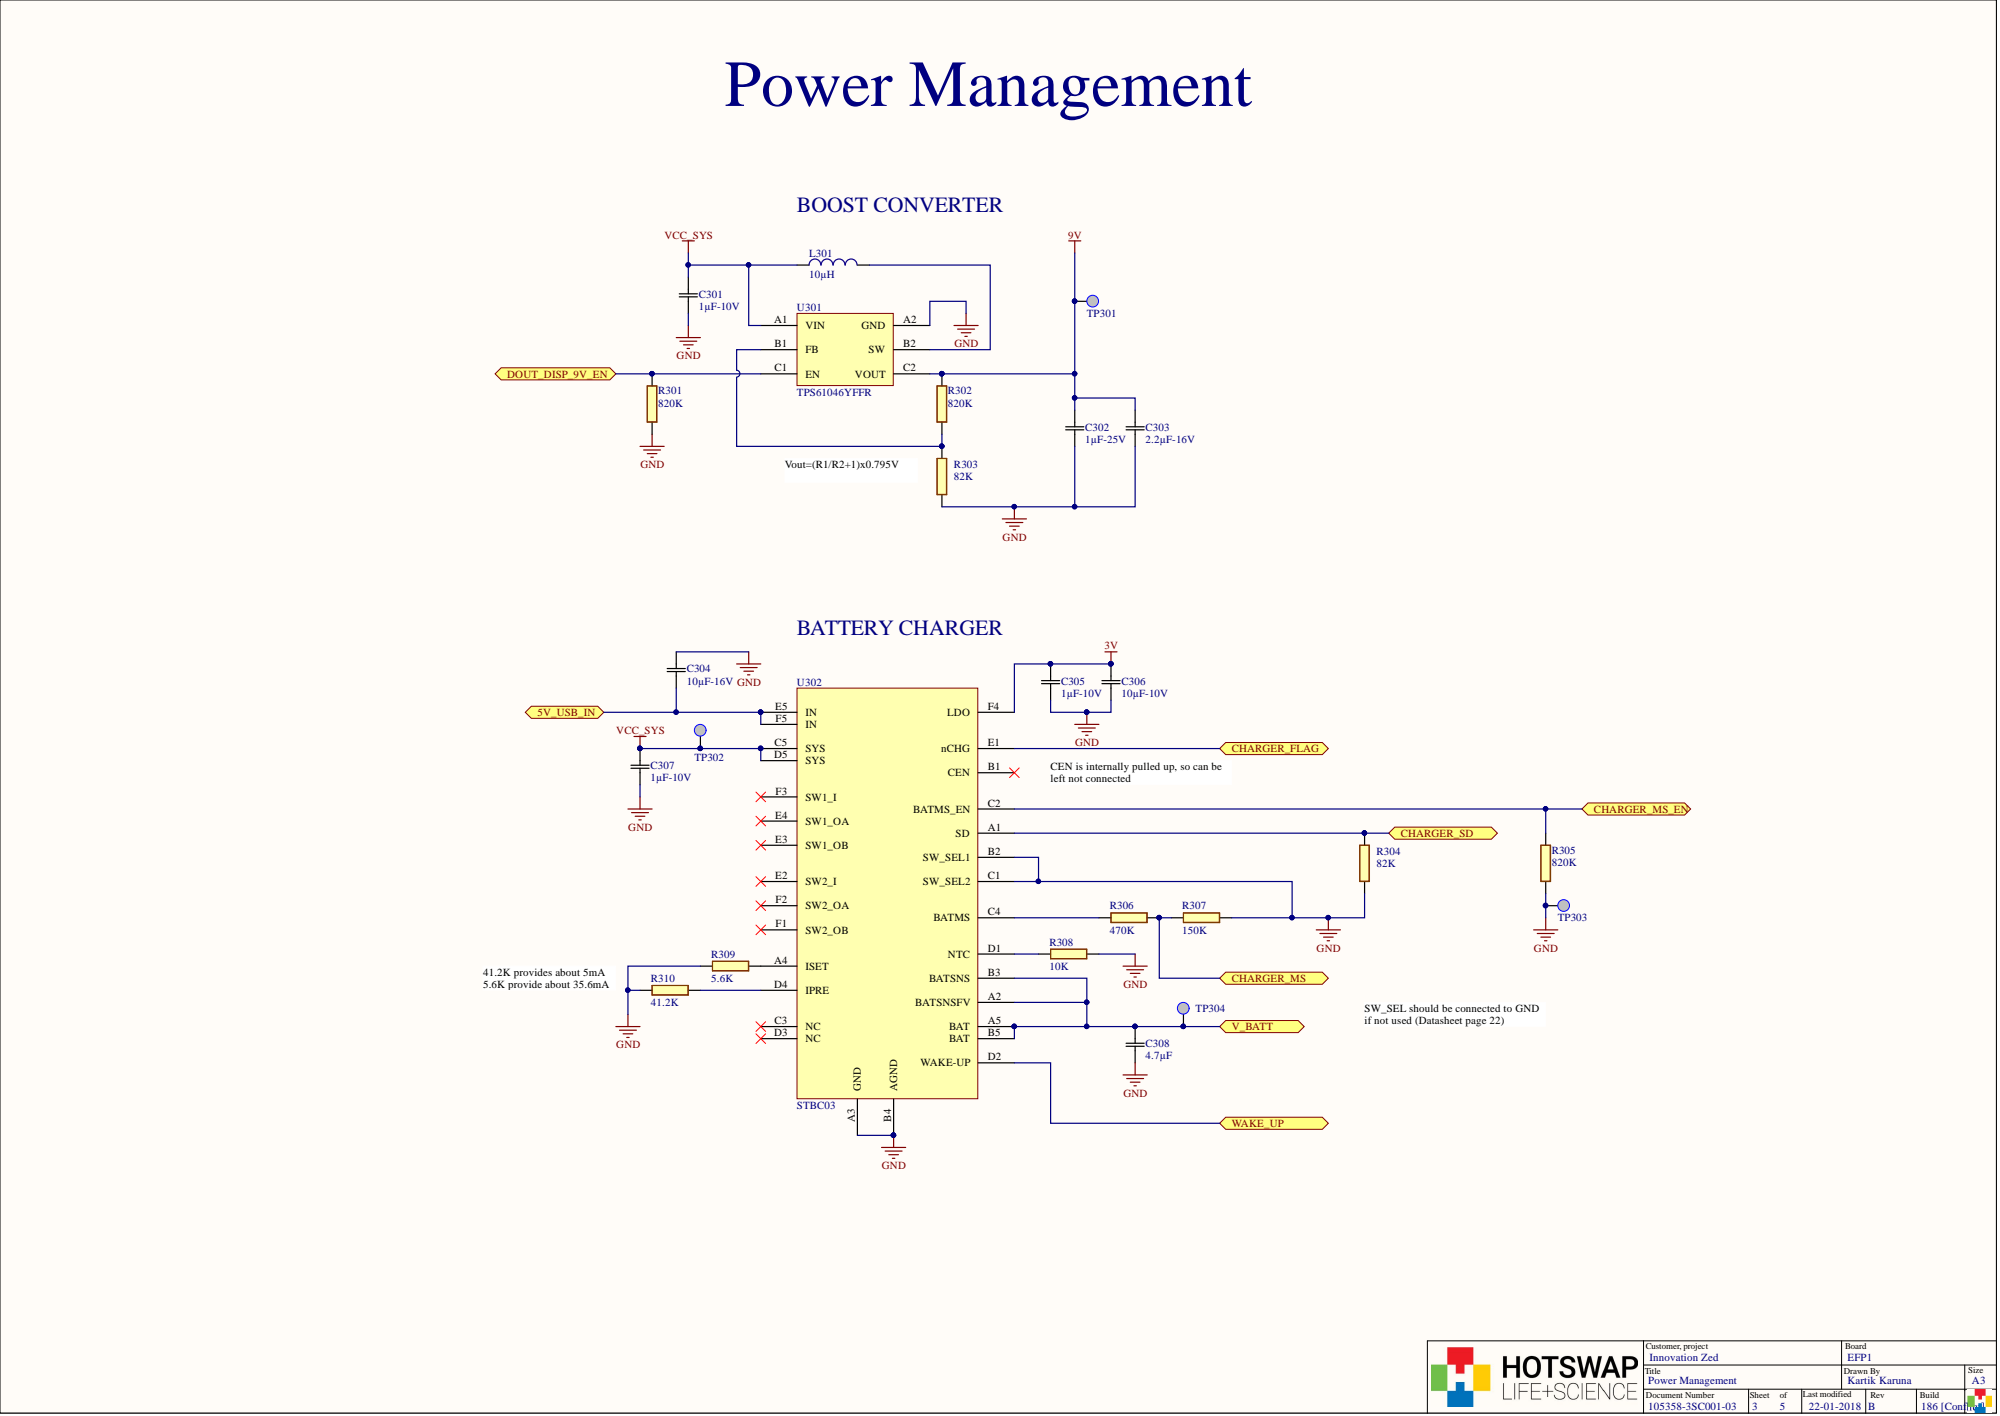
[picture p62: page 3]

VIN A1

FB B1 | GND

EN C1 VOUT | C2

SYS C5

TP302 | SYS D5

CEN is internally pulled up, so can be
left not connected

SW_SEL should be connected to GND
if not used (Datasheet page 22)

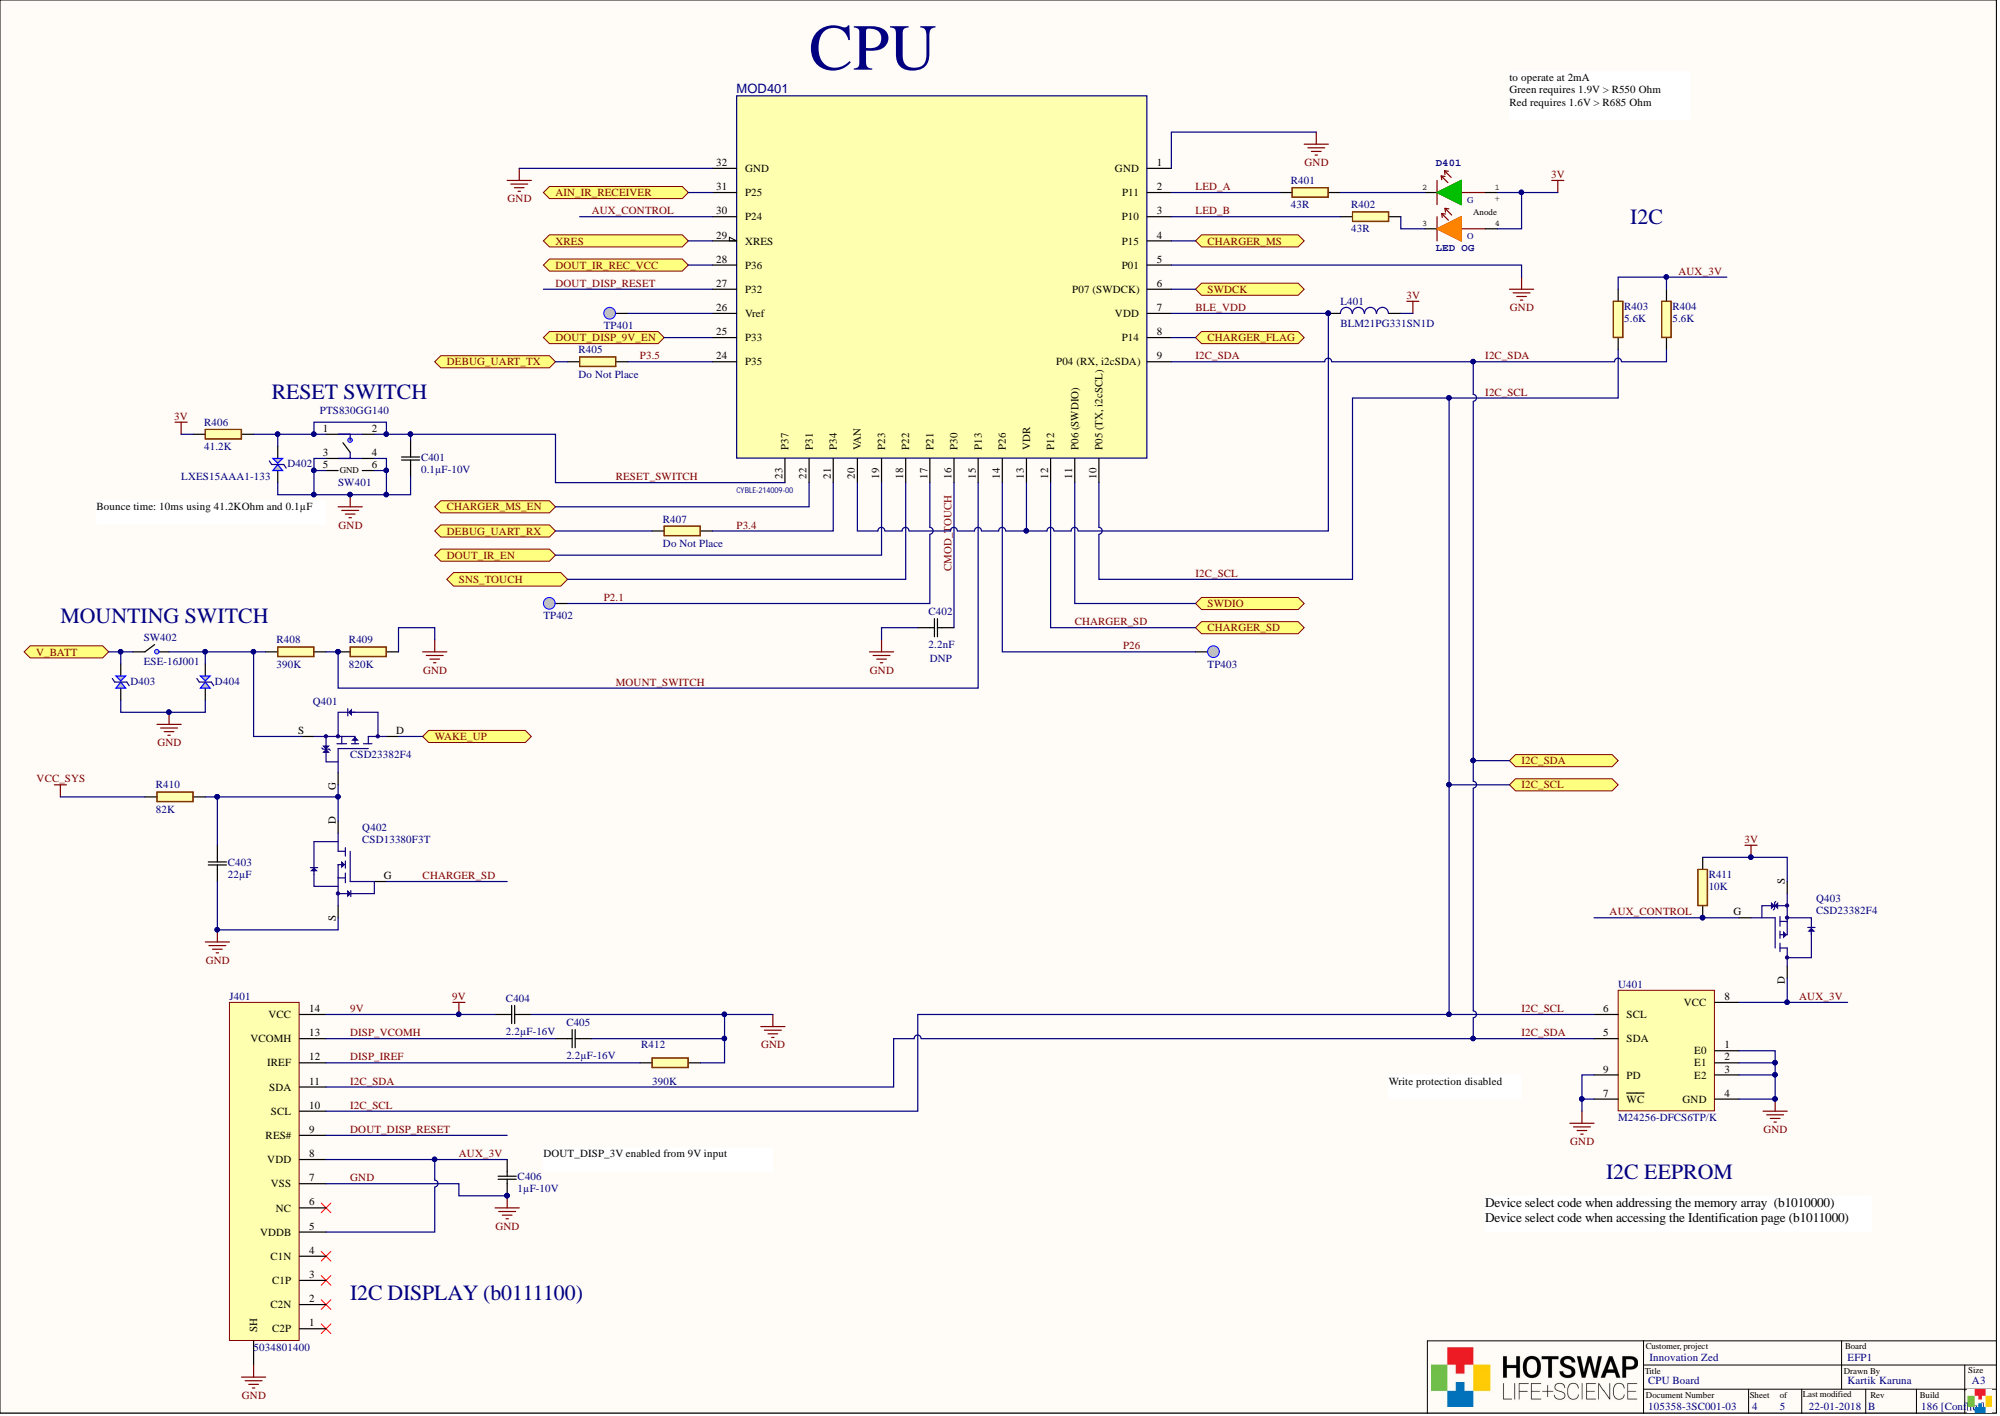
[picture p63: page 4]

XRES 29 | 3

CYBLE-214009-00

Bounce time: 10ms using 41.2KOhm and 0.1µF

C402 | | | I2C_SCL

Device select code when addressing the memory array (b1010000)
Device select code when accessing the Identification page (b1011000)

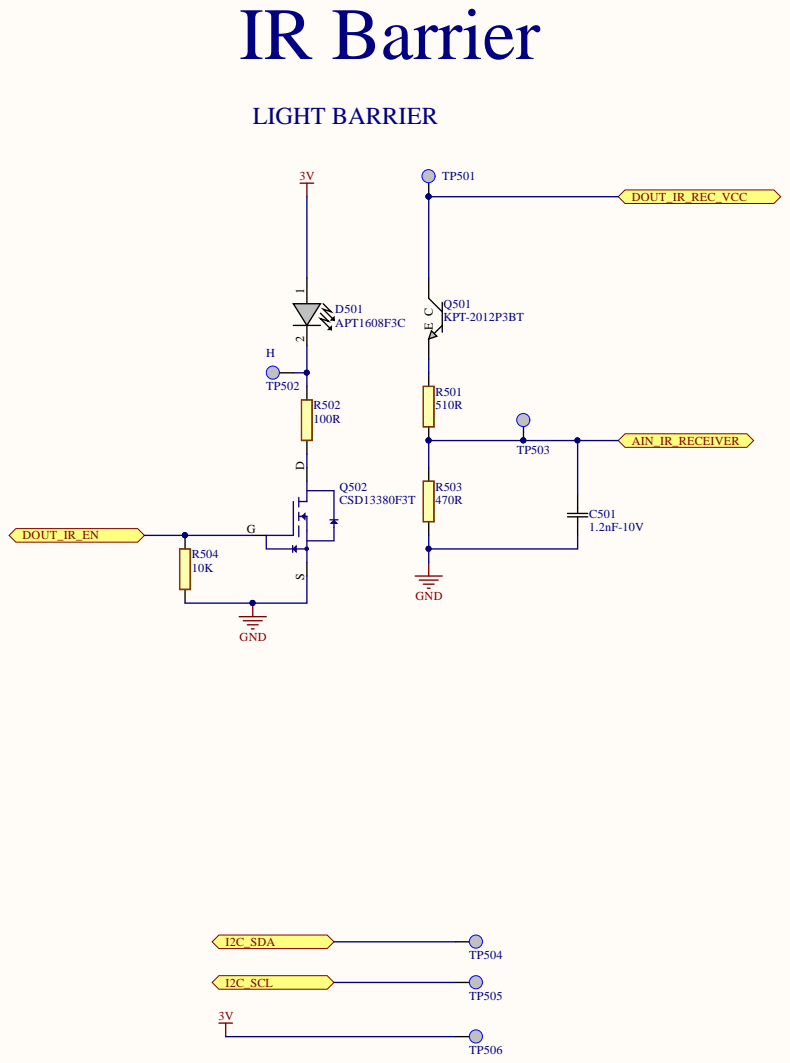
[picture p64: page 5]
