Engineer1234/ConnectMedical/Connect Medical Boards/FP1/Project Outputs for 105358-3BA001-03_FP1/PDF/105358-3SC001-03-A_Schematic_EFP1.pdf

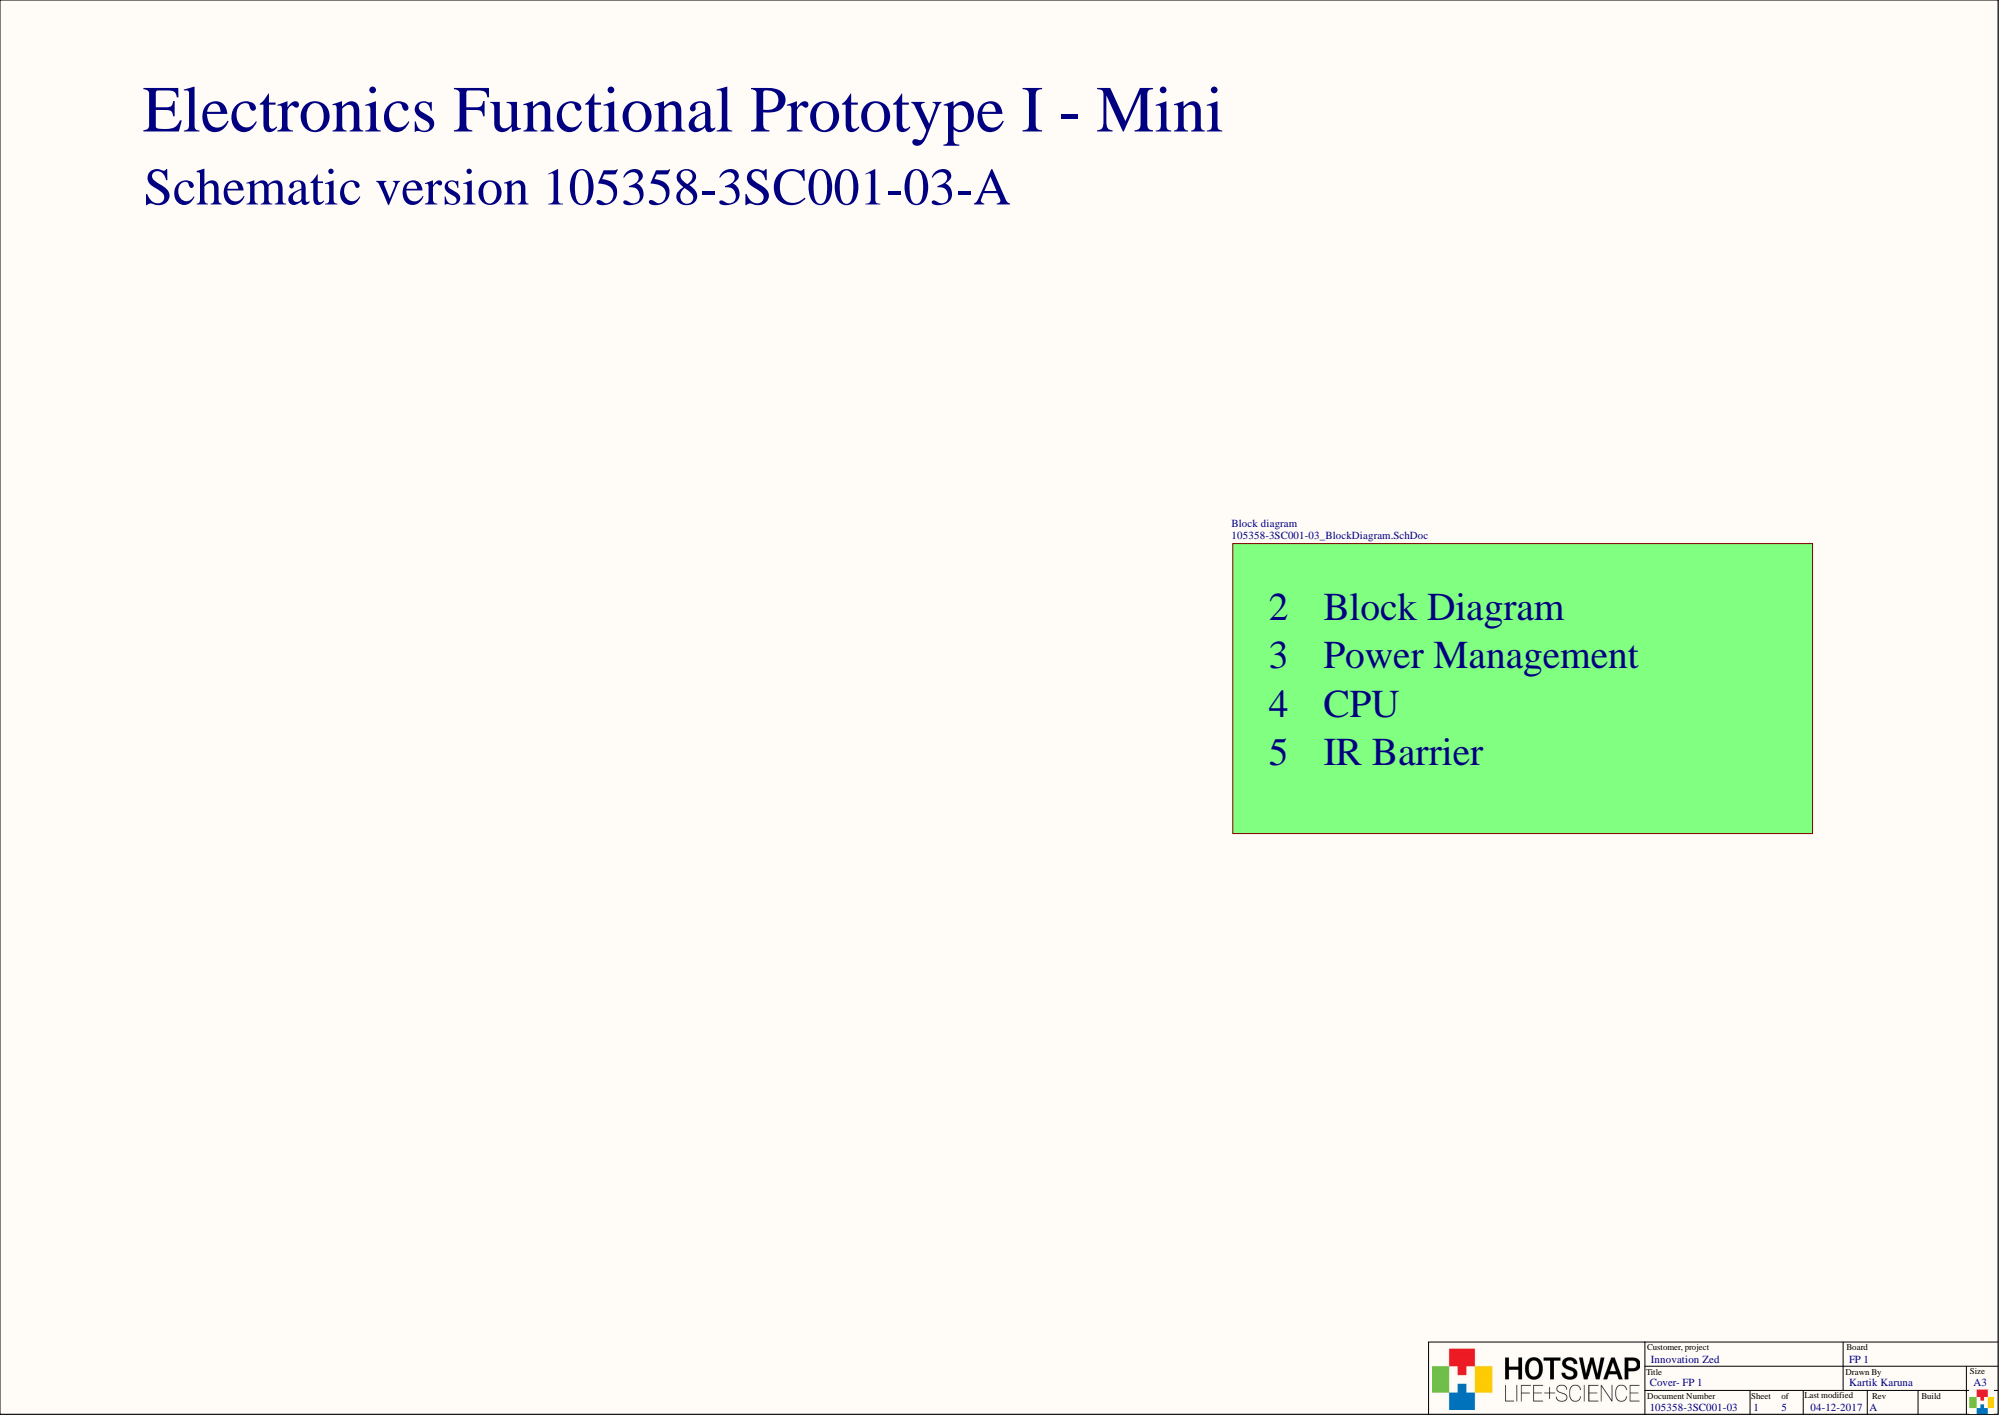
[picture p65: page 1]

Electronics Functional Prototype I - Mini
Schematic version 105358-3SC001-03-A

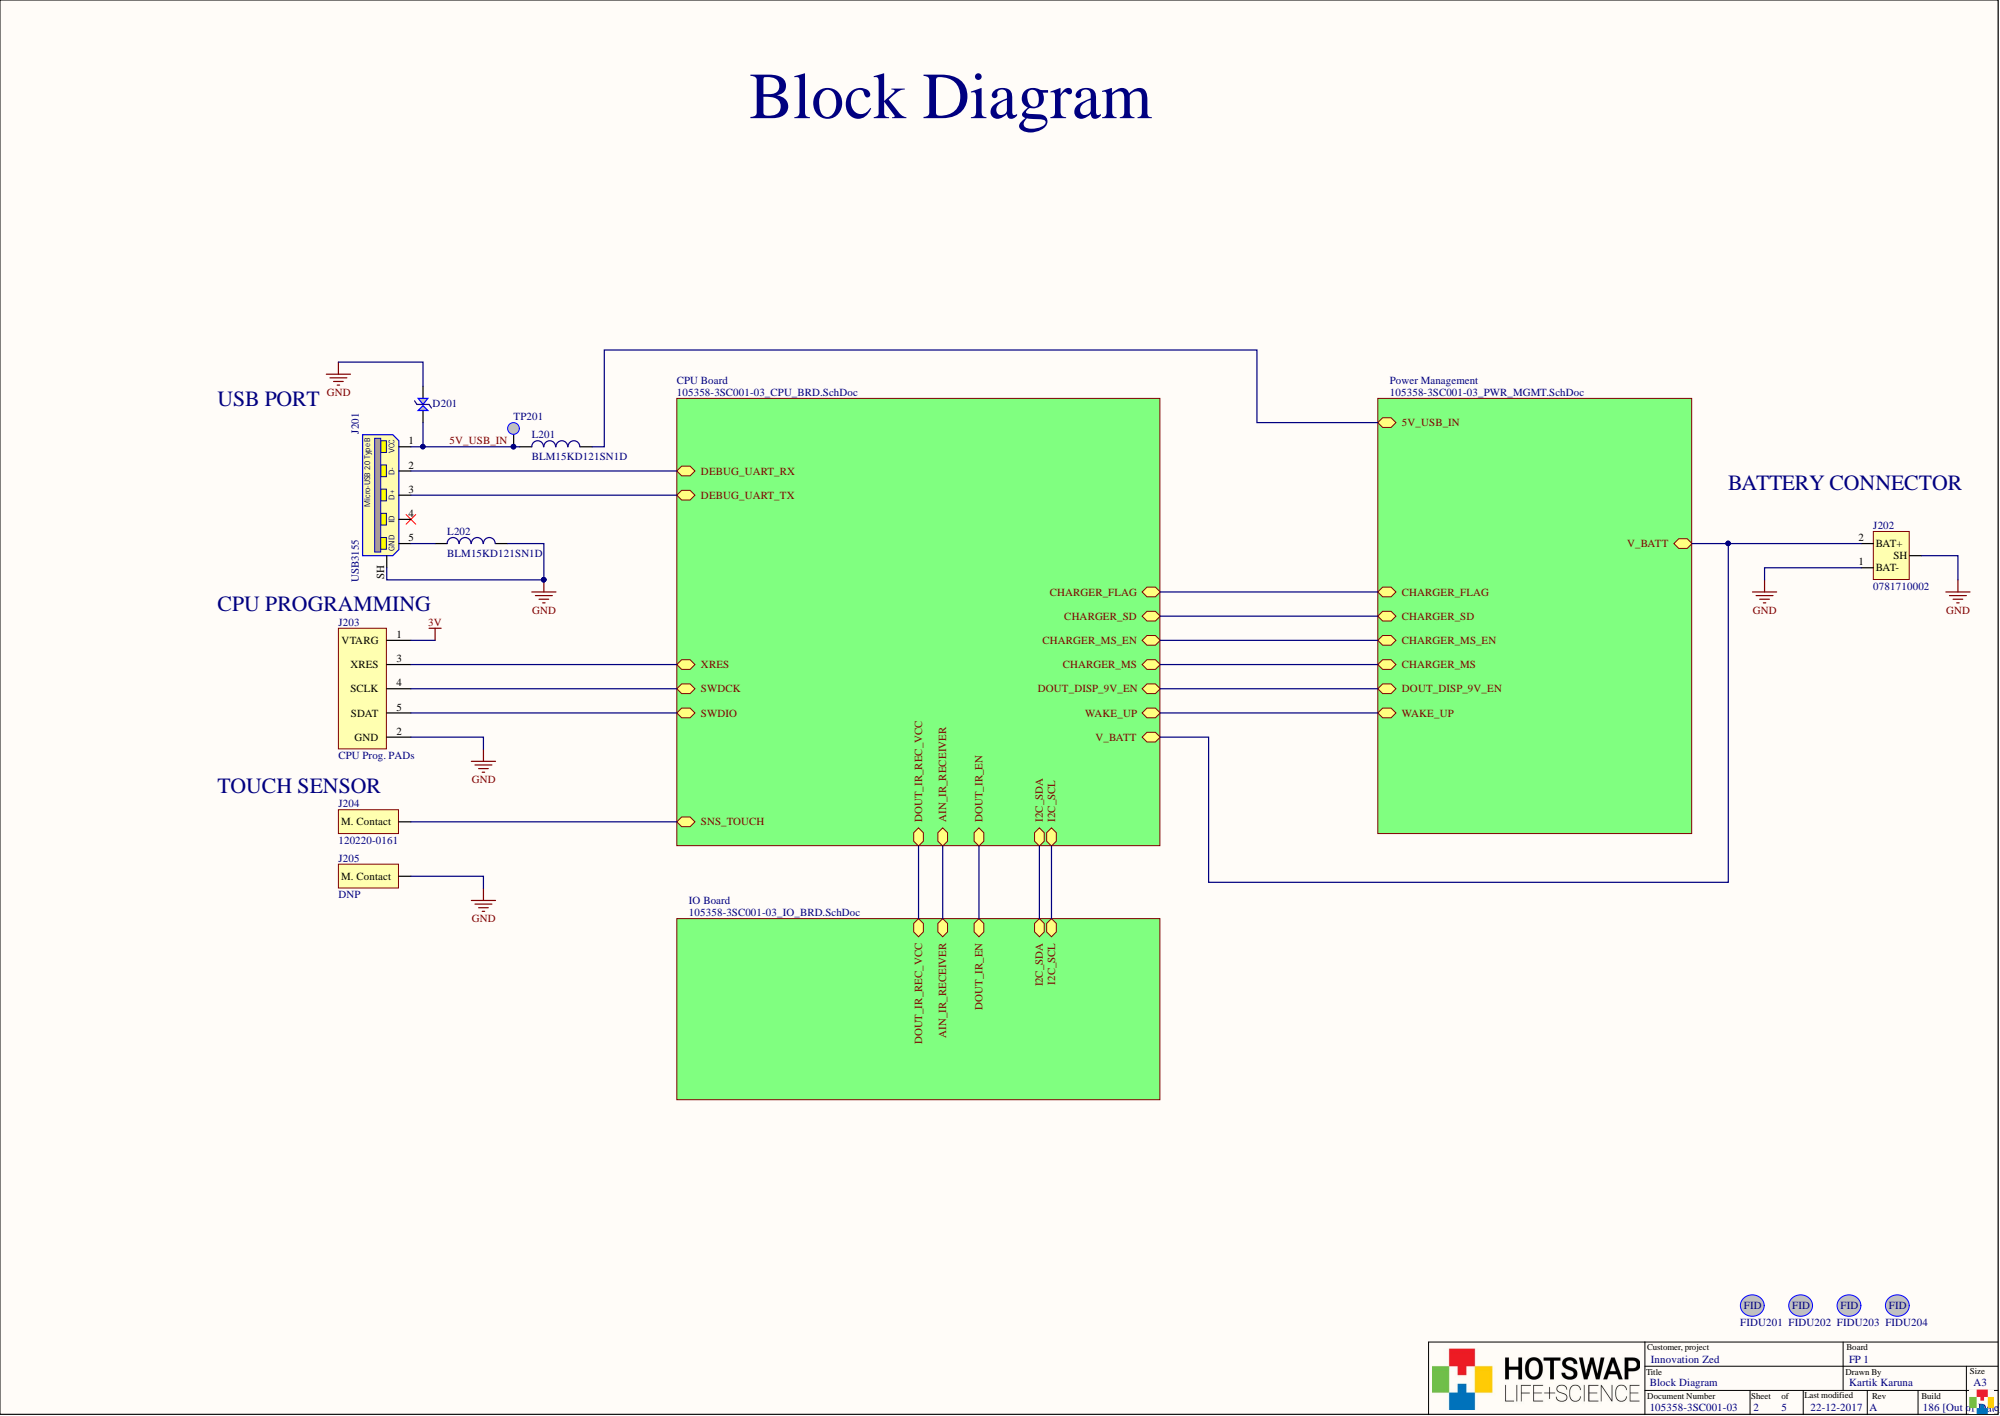
[picture p66: page 2]

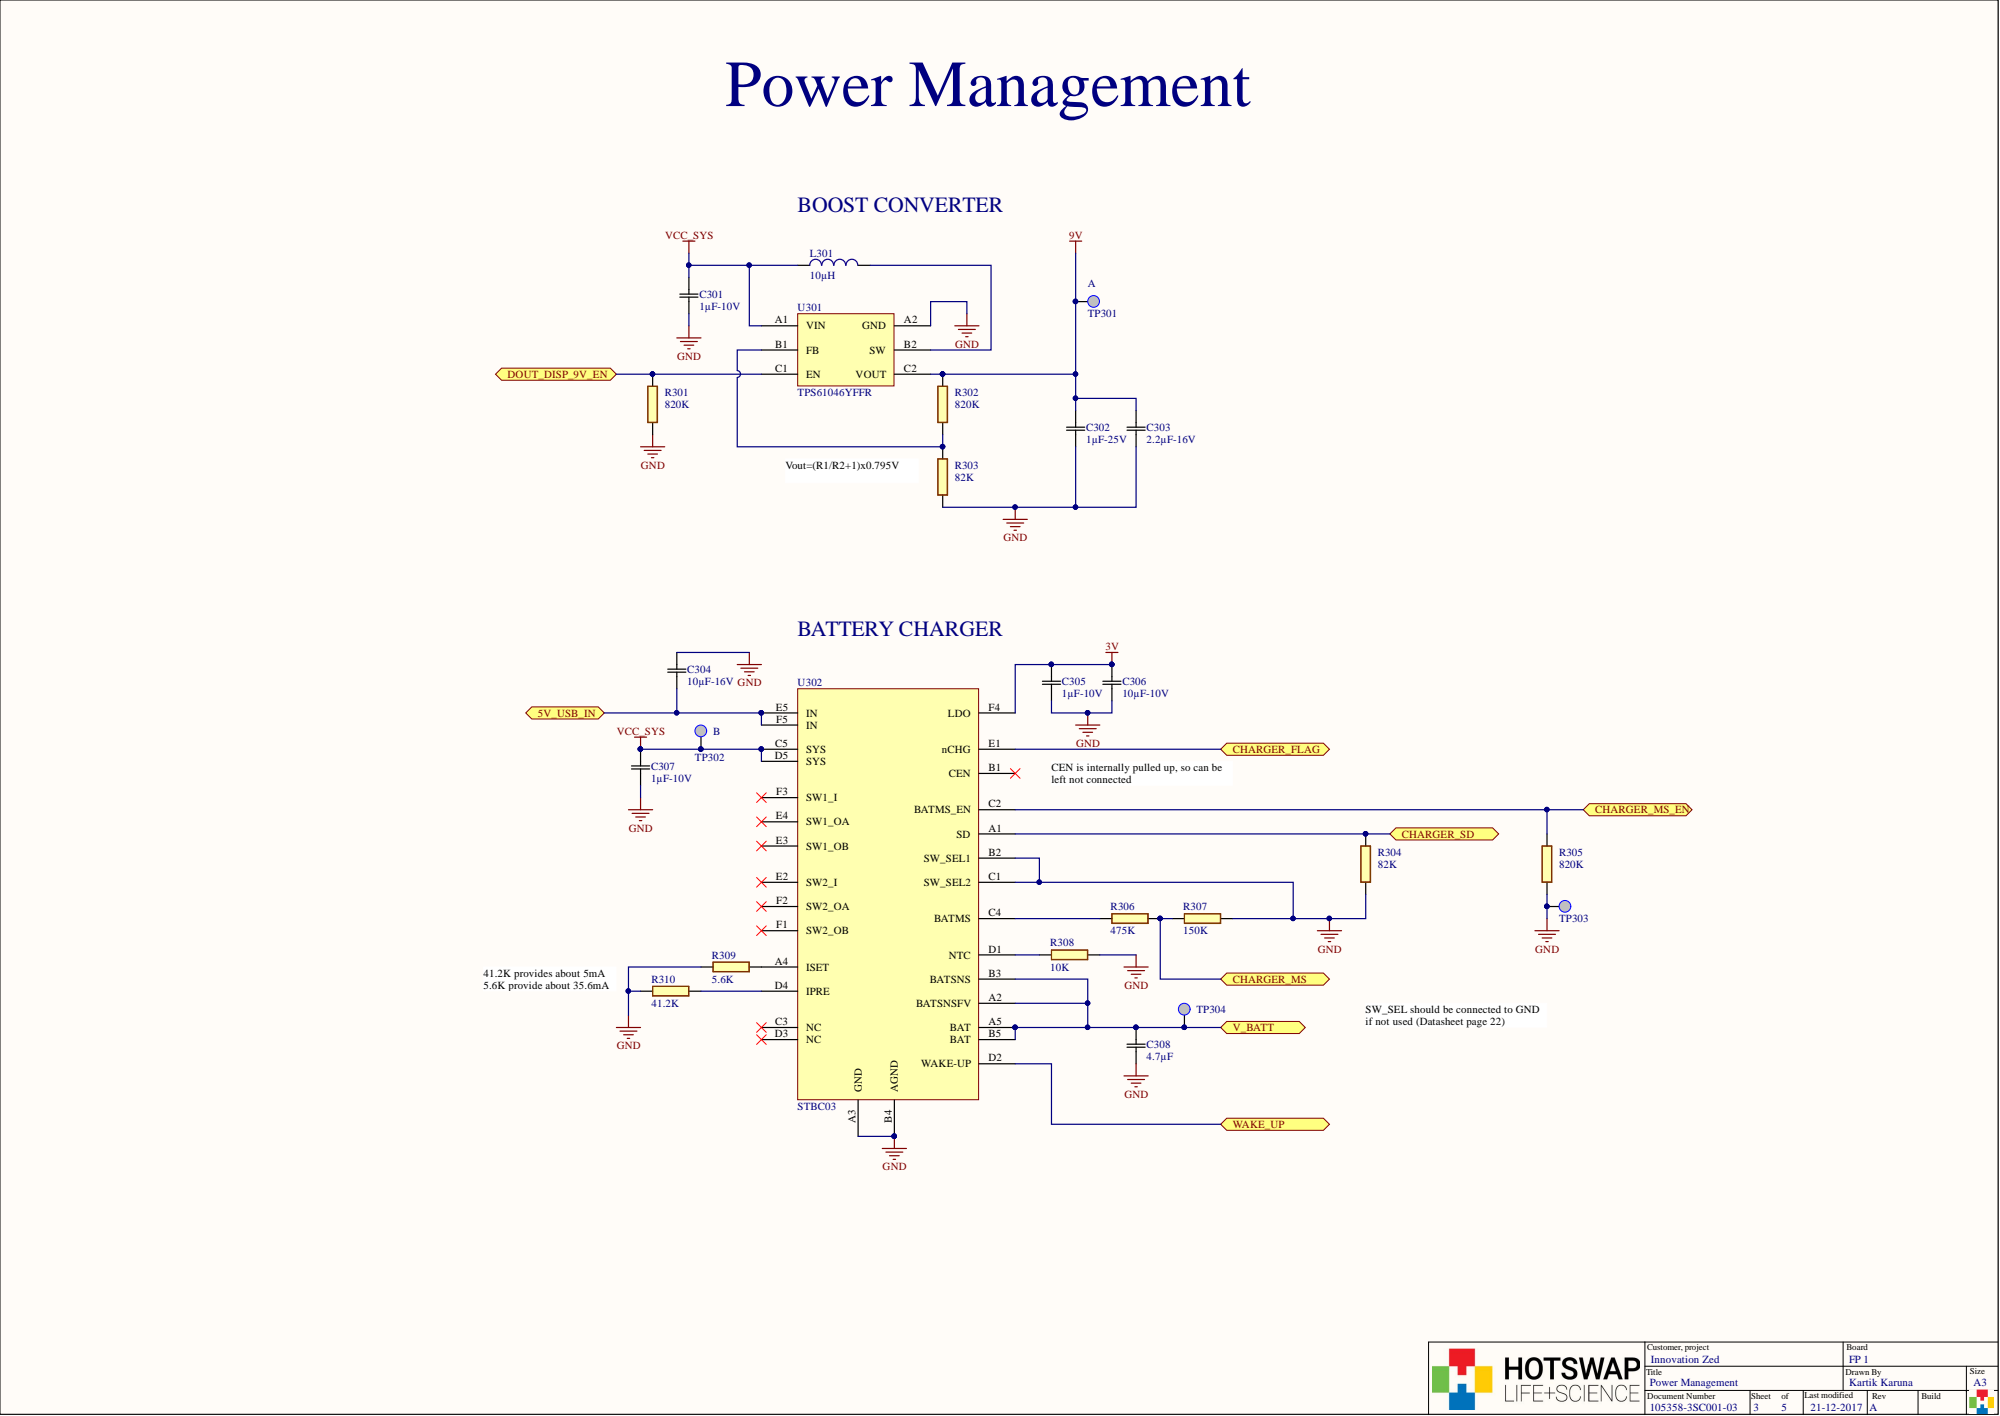
[picture p67: page 3]

VIN A1

FB B1 | GND

EN C1 VOUT | C2

SYS C5

TP302 | SYS D5

CEN is internally pulled up, so can be
left not connected

SW_SEL should be connected to GND
if not used (Datasheet page 22)

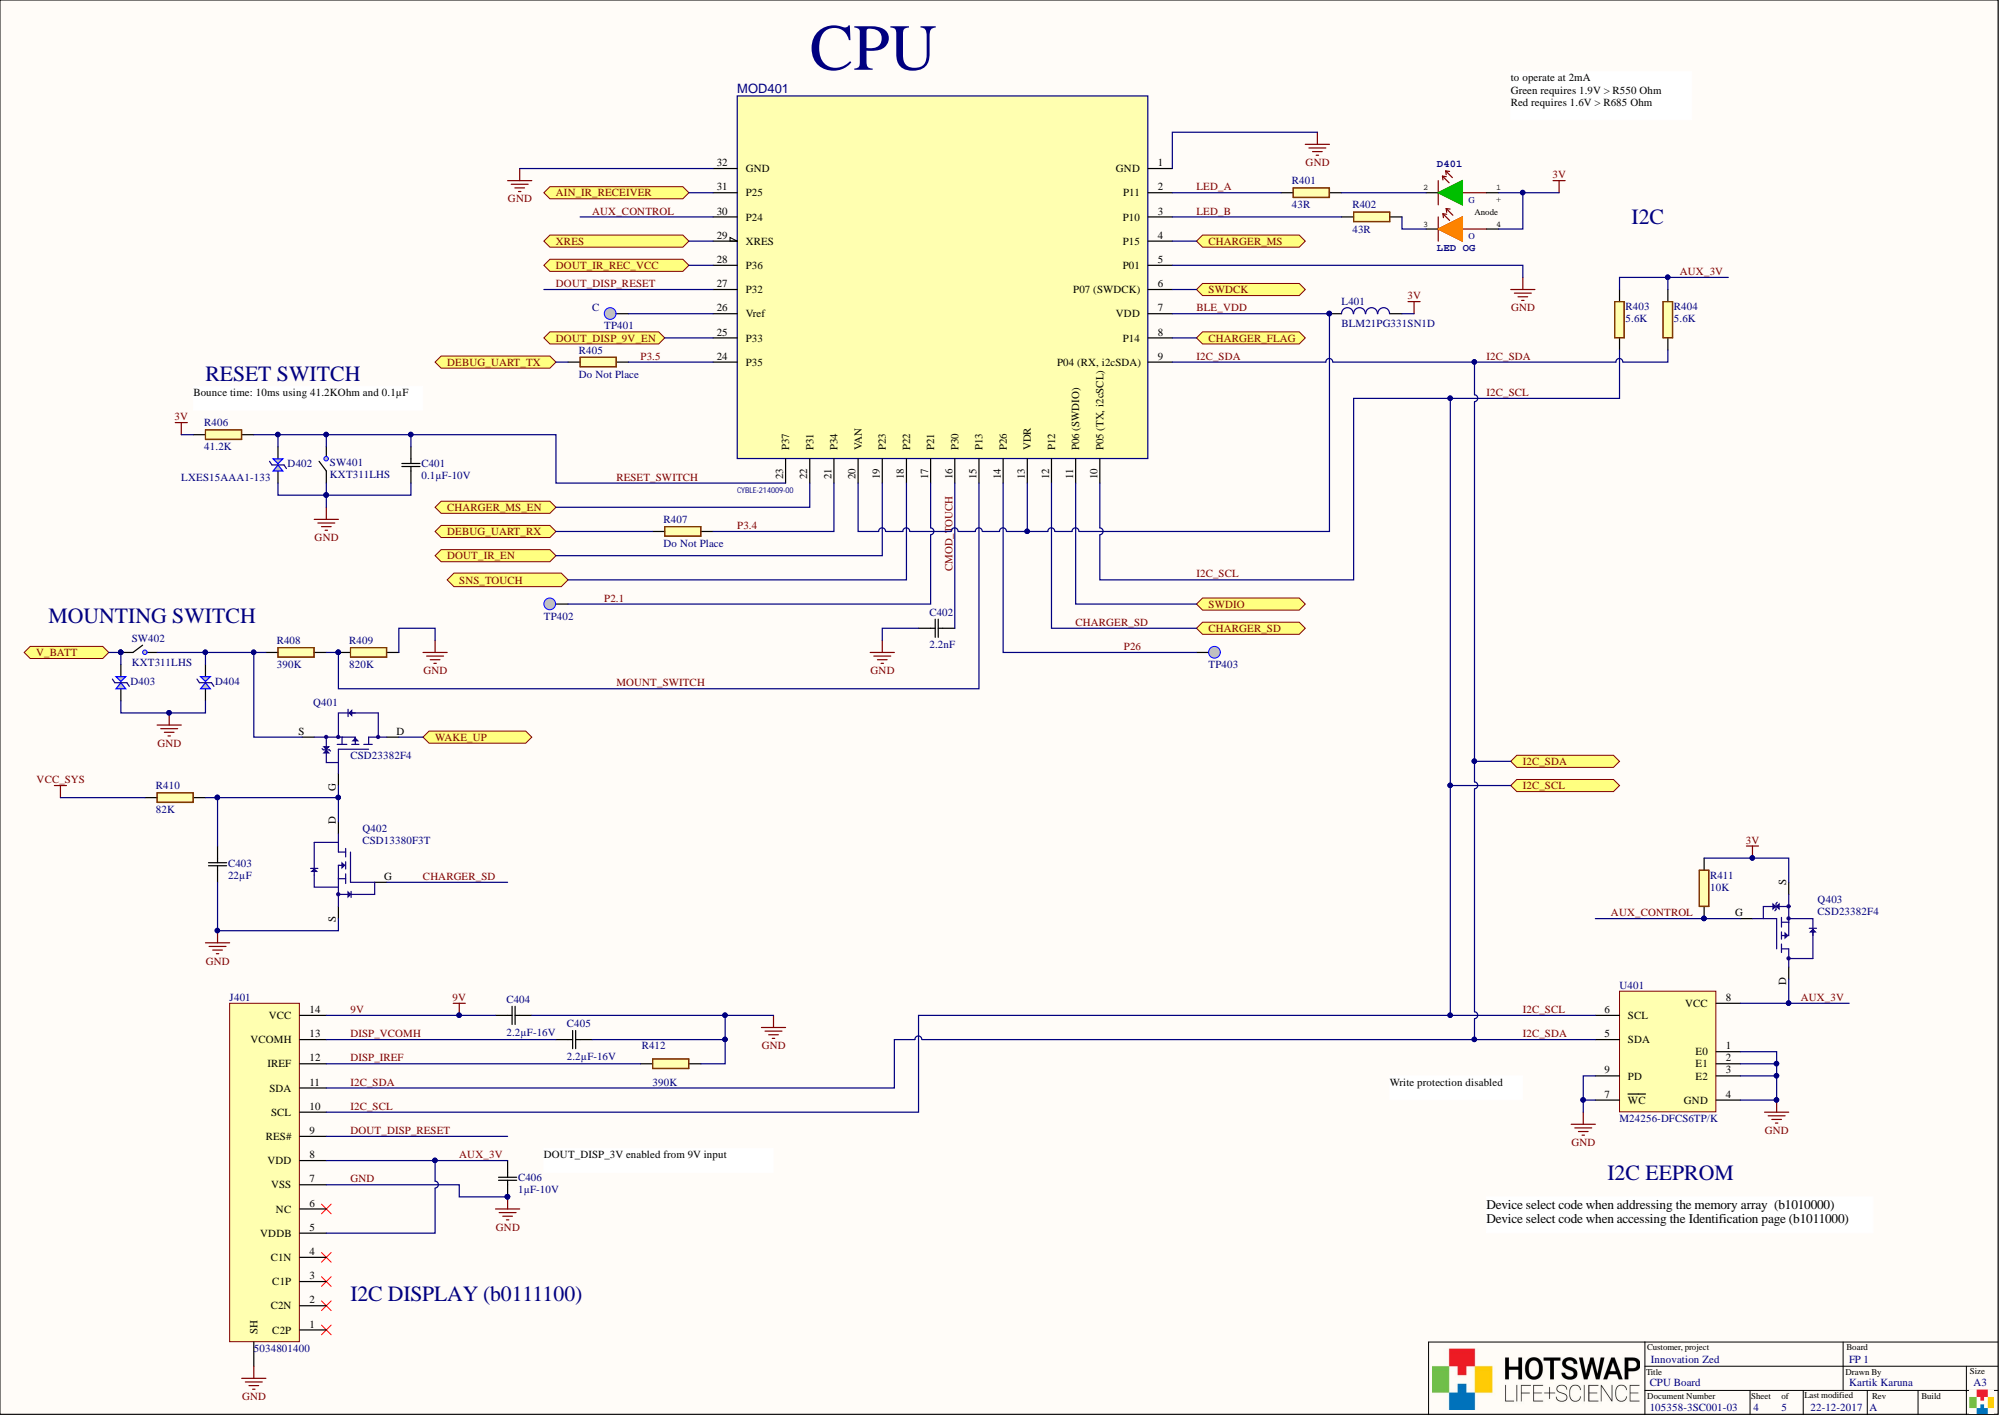
[picture p68: page 4]

XRES 29 | 3

Bounce time: 10ms using 41.2KOhm and 0.1µF

C401 0.1µF-10V RESET_SWITCH

CYBLE-214009-00

C402 | | | I2C_SCL

Device select code when addressing the memory array (b1010000)
Device select code when accessing the Identification page (b1011000)

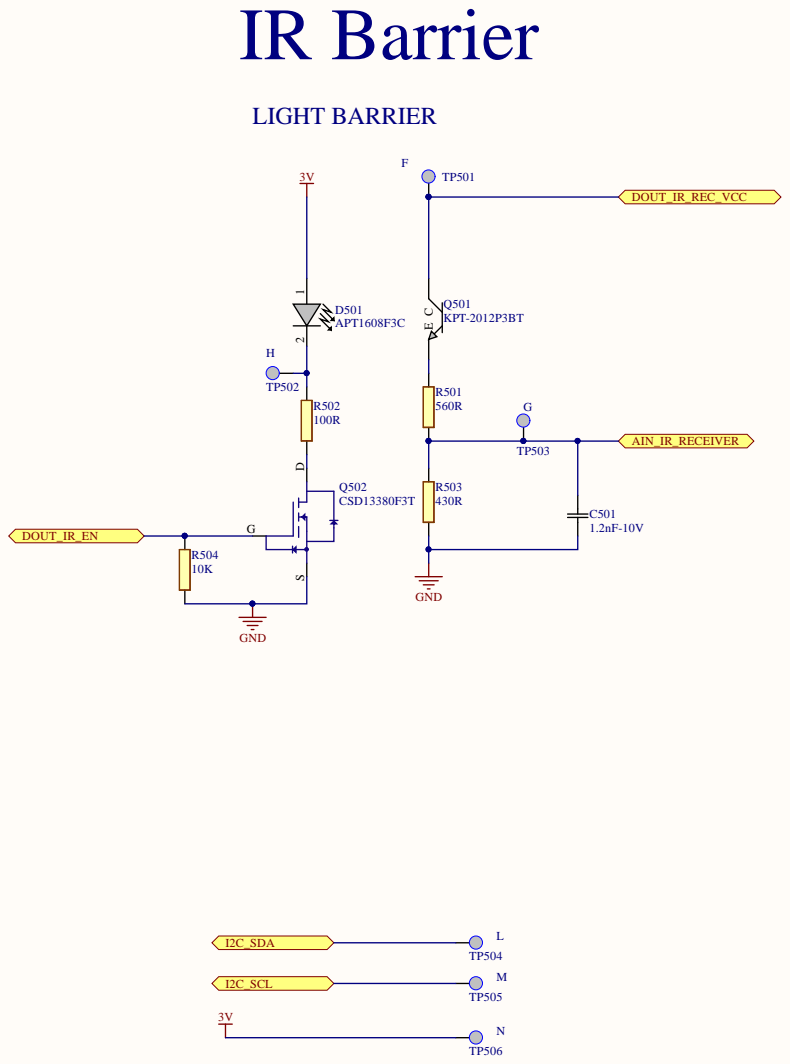
[picture p69: page 5]
