Engineer1234/ConnectMedical/Connect Medical Boards/EFM1_Touch/Project Outputs for 105358-3BA003-02_EFP1_Touch/PDF/105358-3CD006-01 Assembly Drawing-EFP1-Touch.PDF

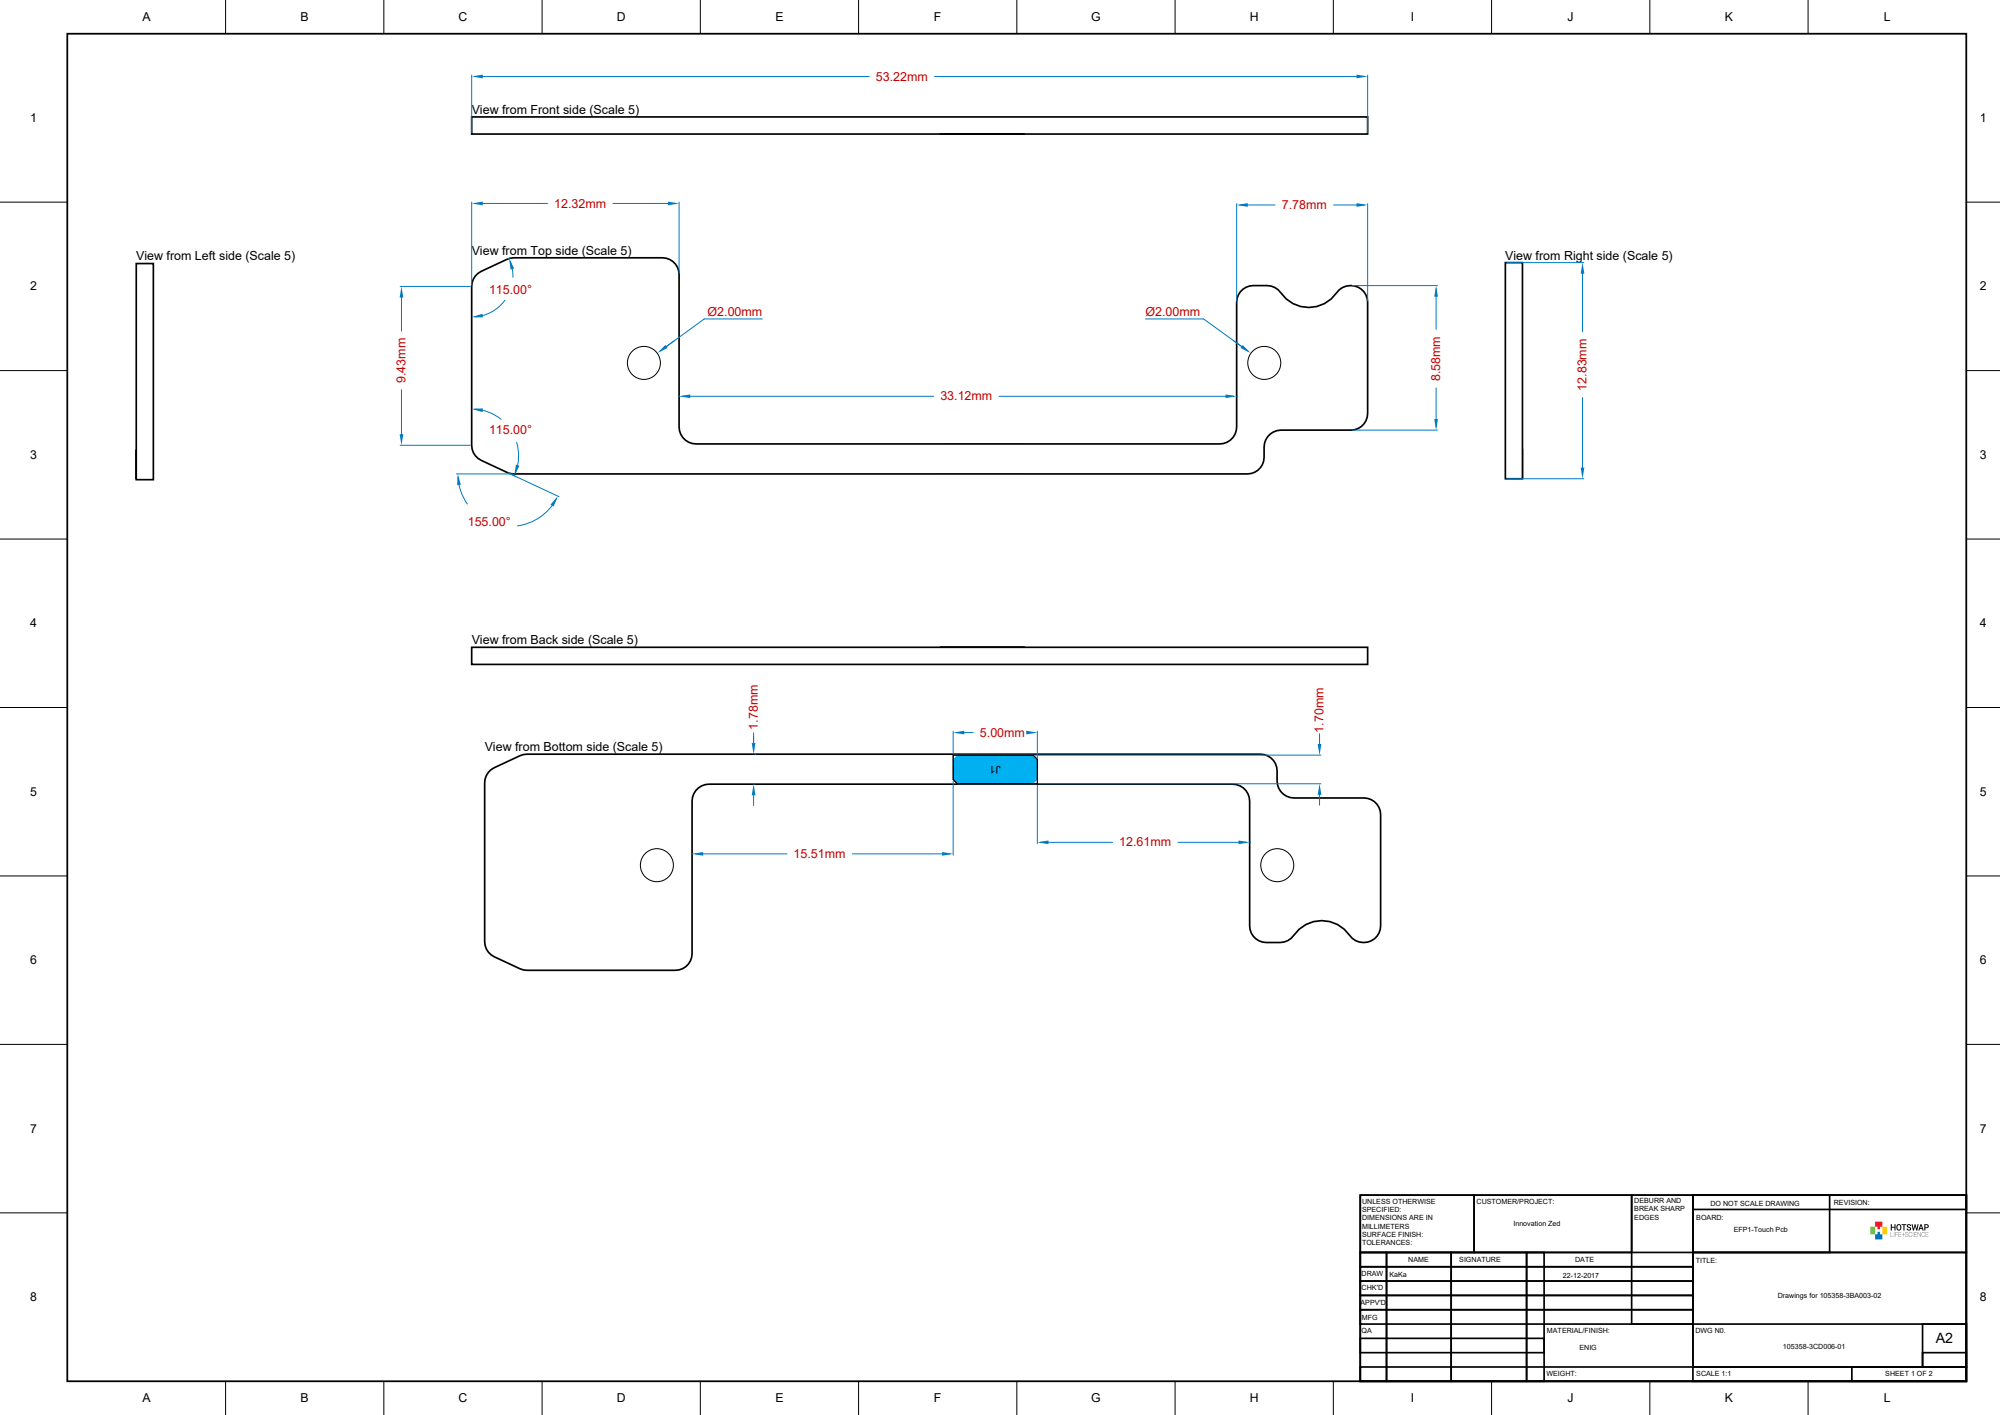
[picture p70: page 1]

View from Front side (Scale 5)

View from Top side (Scale 5)

View from Back side (Scale 5)

View from Bottom side (Scale 5)

UNLESS OTHERWISE SPECIFIED: DIMENSIONS ARE IN MILLIMETERS SURFACE FINISH: TOLERANCES: | CUSTOMER/PROJECT: Innovation Zed | DEBURR AND BREAK SHARP EDGES | DO NOT SCALE DRAWING | REVISION:

BOARD: EFP1-Touch Pcb

NAME | SIGNATURE | | DATE | | TITLE: Drawings for 105358-3BA003-02

DRAW | KaKa | | | 22-12-2017
CHK'D

APPV'D
MFG
QA | | | | MATERIAL/FINISH: ENIG | DWG N0. 105358-3CD006-01 | A2

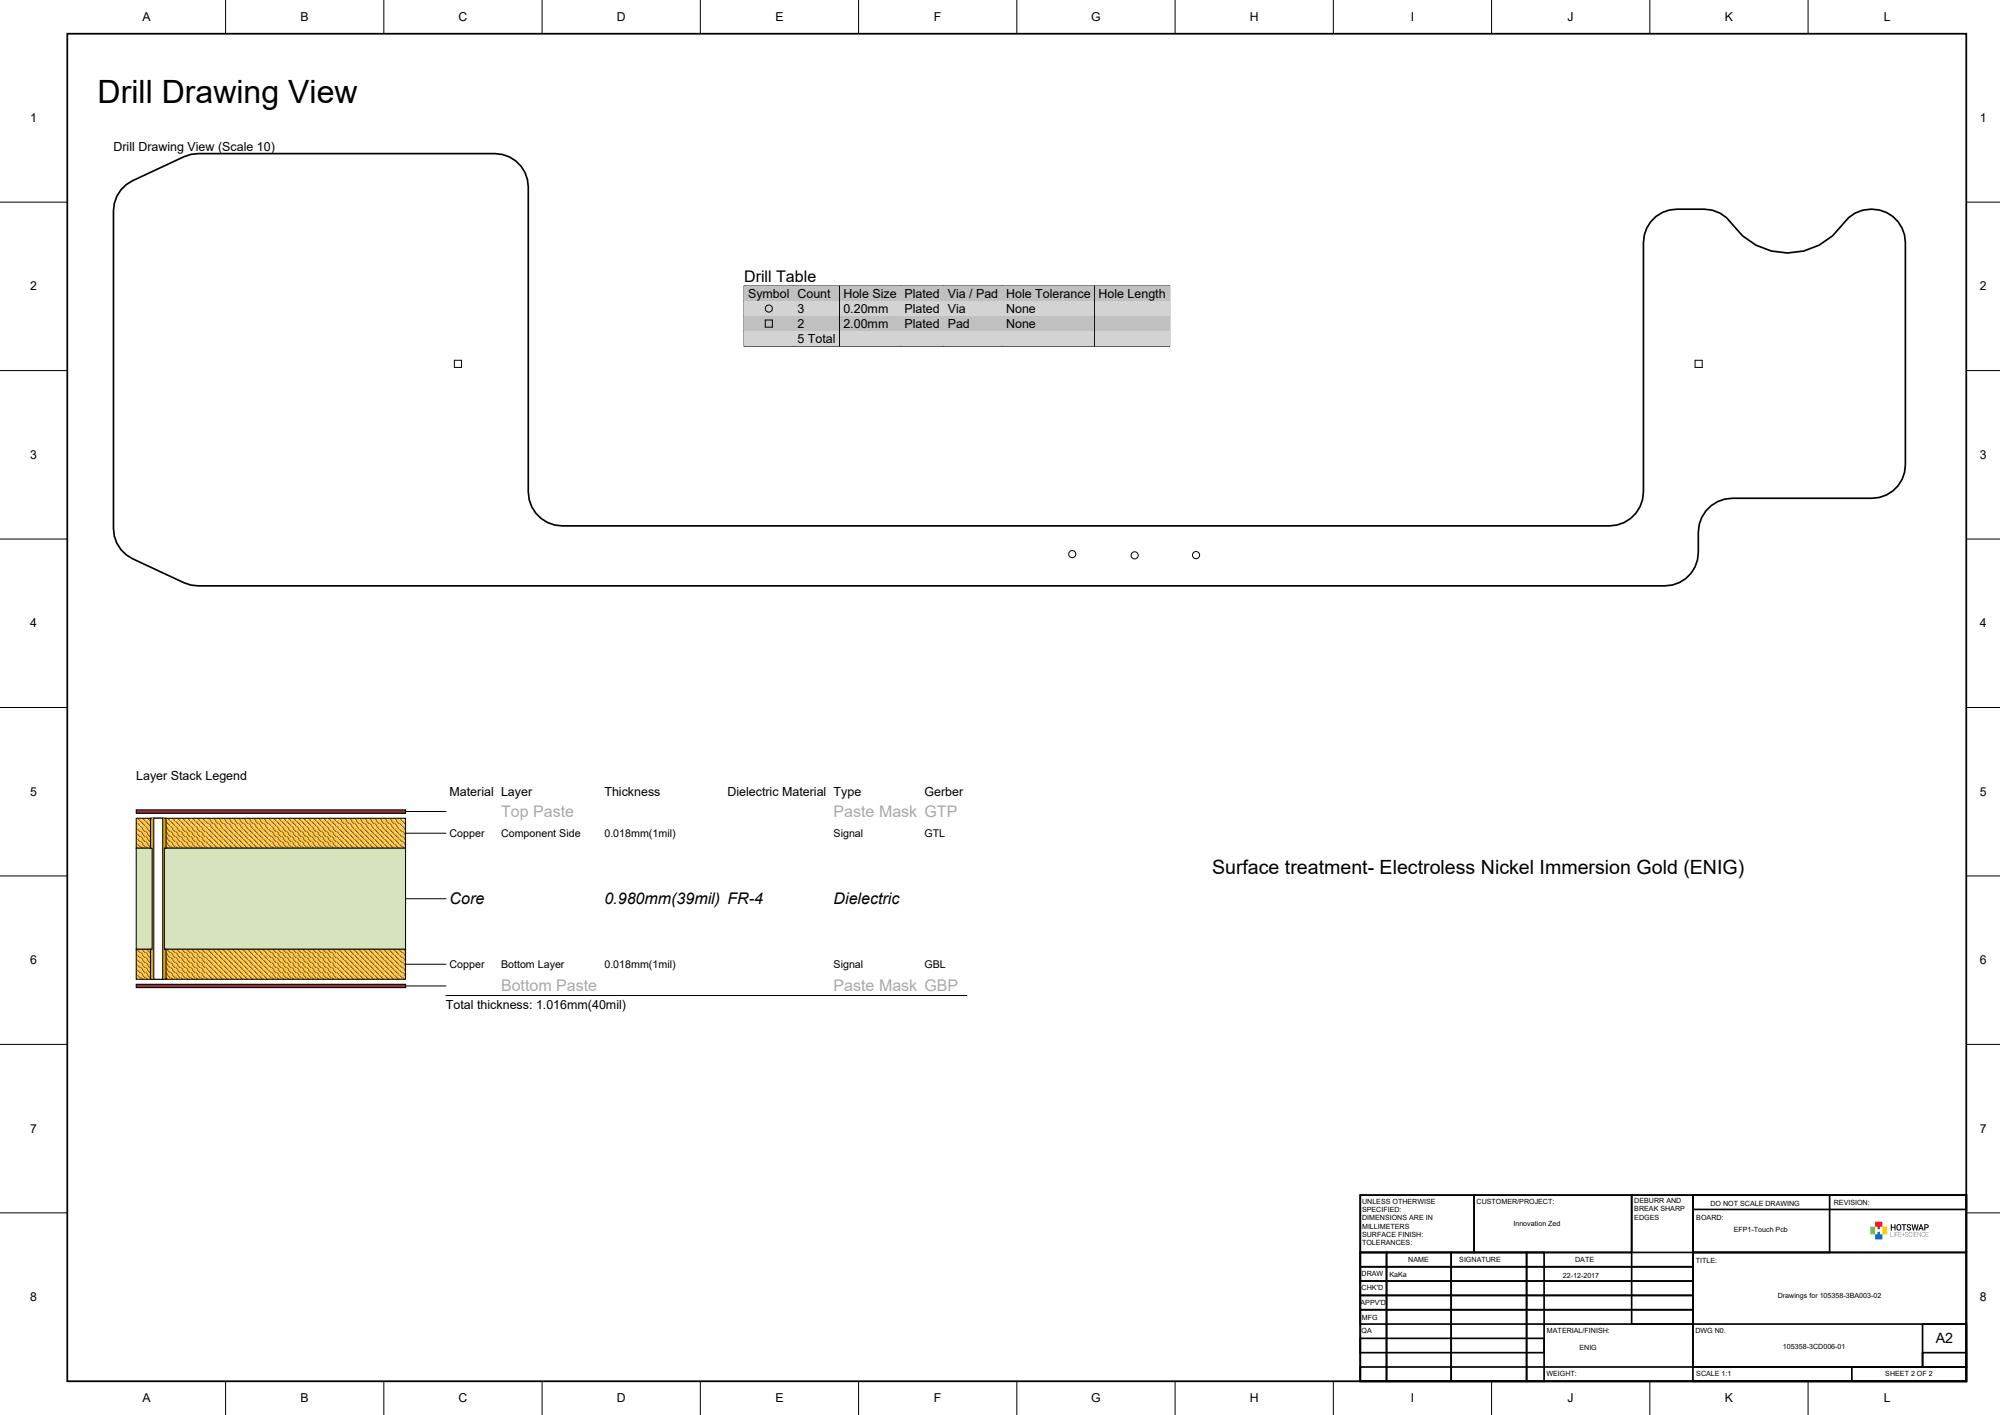
[picture p71: page 2]

Drill Drawing View (Scale 10)

Symbol | Count | Hole Size | Plated | Via / Pad | Hole Tolerance | Hole Length

3 | 0.20mm | Plated | Via | None
2 | 2.00mm | Plated | Pad | None
5 Total

Surface treatment- Electroless Nickel Immersion Gold (ENIG)

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

BOARD: EFP1-Touch Pcb

NAME | SIGNATURE | | DATE | | TITLE: Drawings for 105358-3BA003-02

DRAW | KaKa | | | 22-12-2017
CHK'D

APPV'D
MFG
QA | | | | MATERIAL/FINISH: ENIG | DWG N0. 105358-3CD006-01 | A2
