Engineer1234/ConnectMedical/Connect Medical Boards/EFM1_Touch/Project Outputs for 105358-3BA003-02_EFP1_Touch/PDF/105358-3SC003-02-A_Schematic_EFP1-Touchpdf.PDF

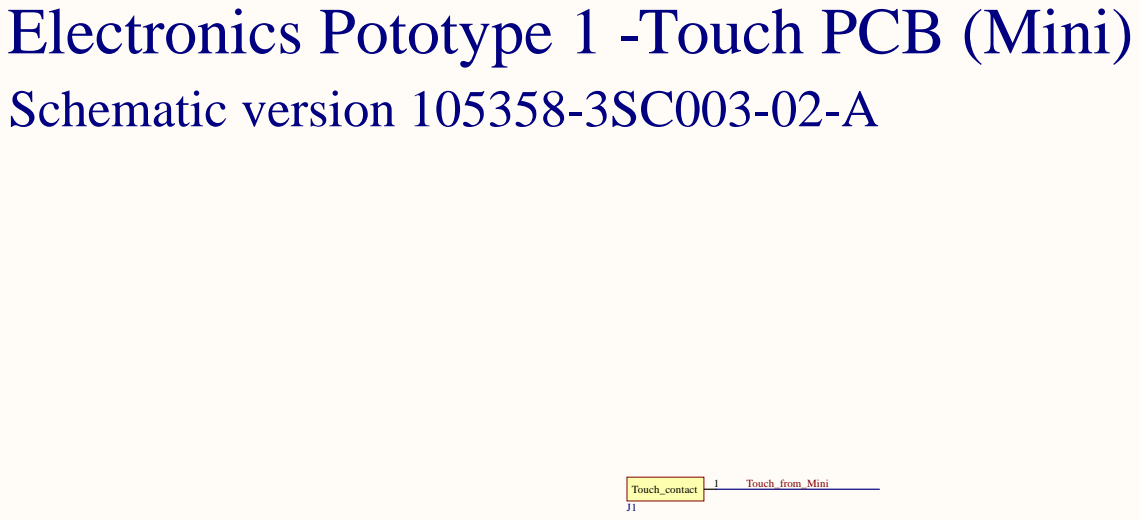
[picture p72: page 1]

Electronics Pototype 1 -Touch PCB (Mini)
