Engineer1234/ConnectMedical/Connect Medical Boards/EFM2/Project Outputs for 105358-3BA001-02_EFM1.5/PDF/105358-3SC001-02-A_Schematic_EFM1.5.pdf

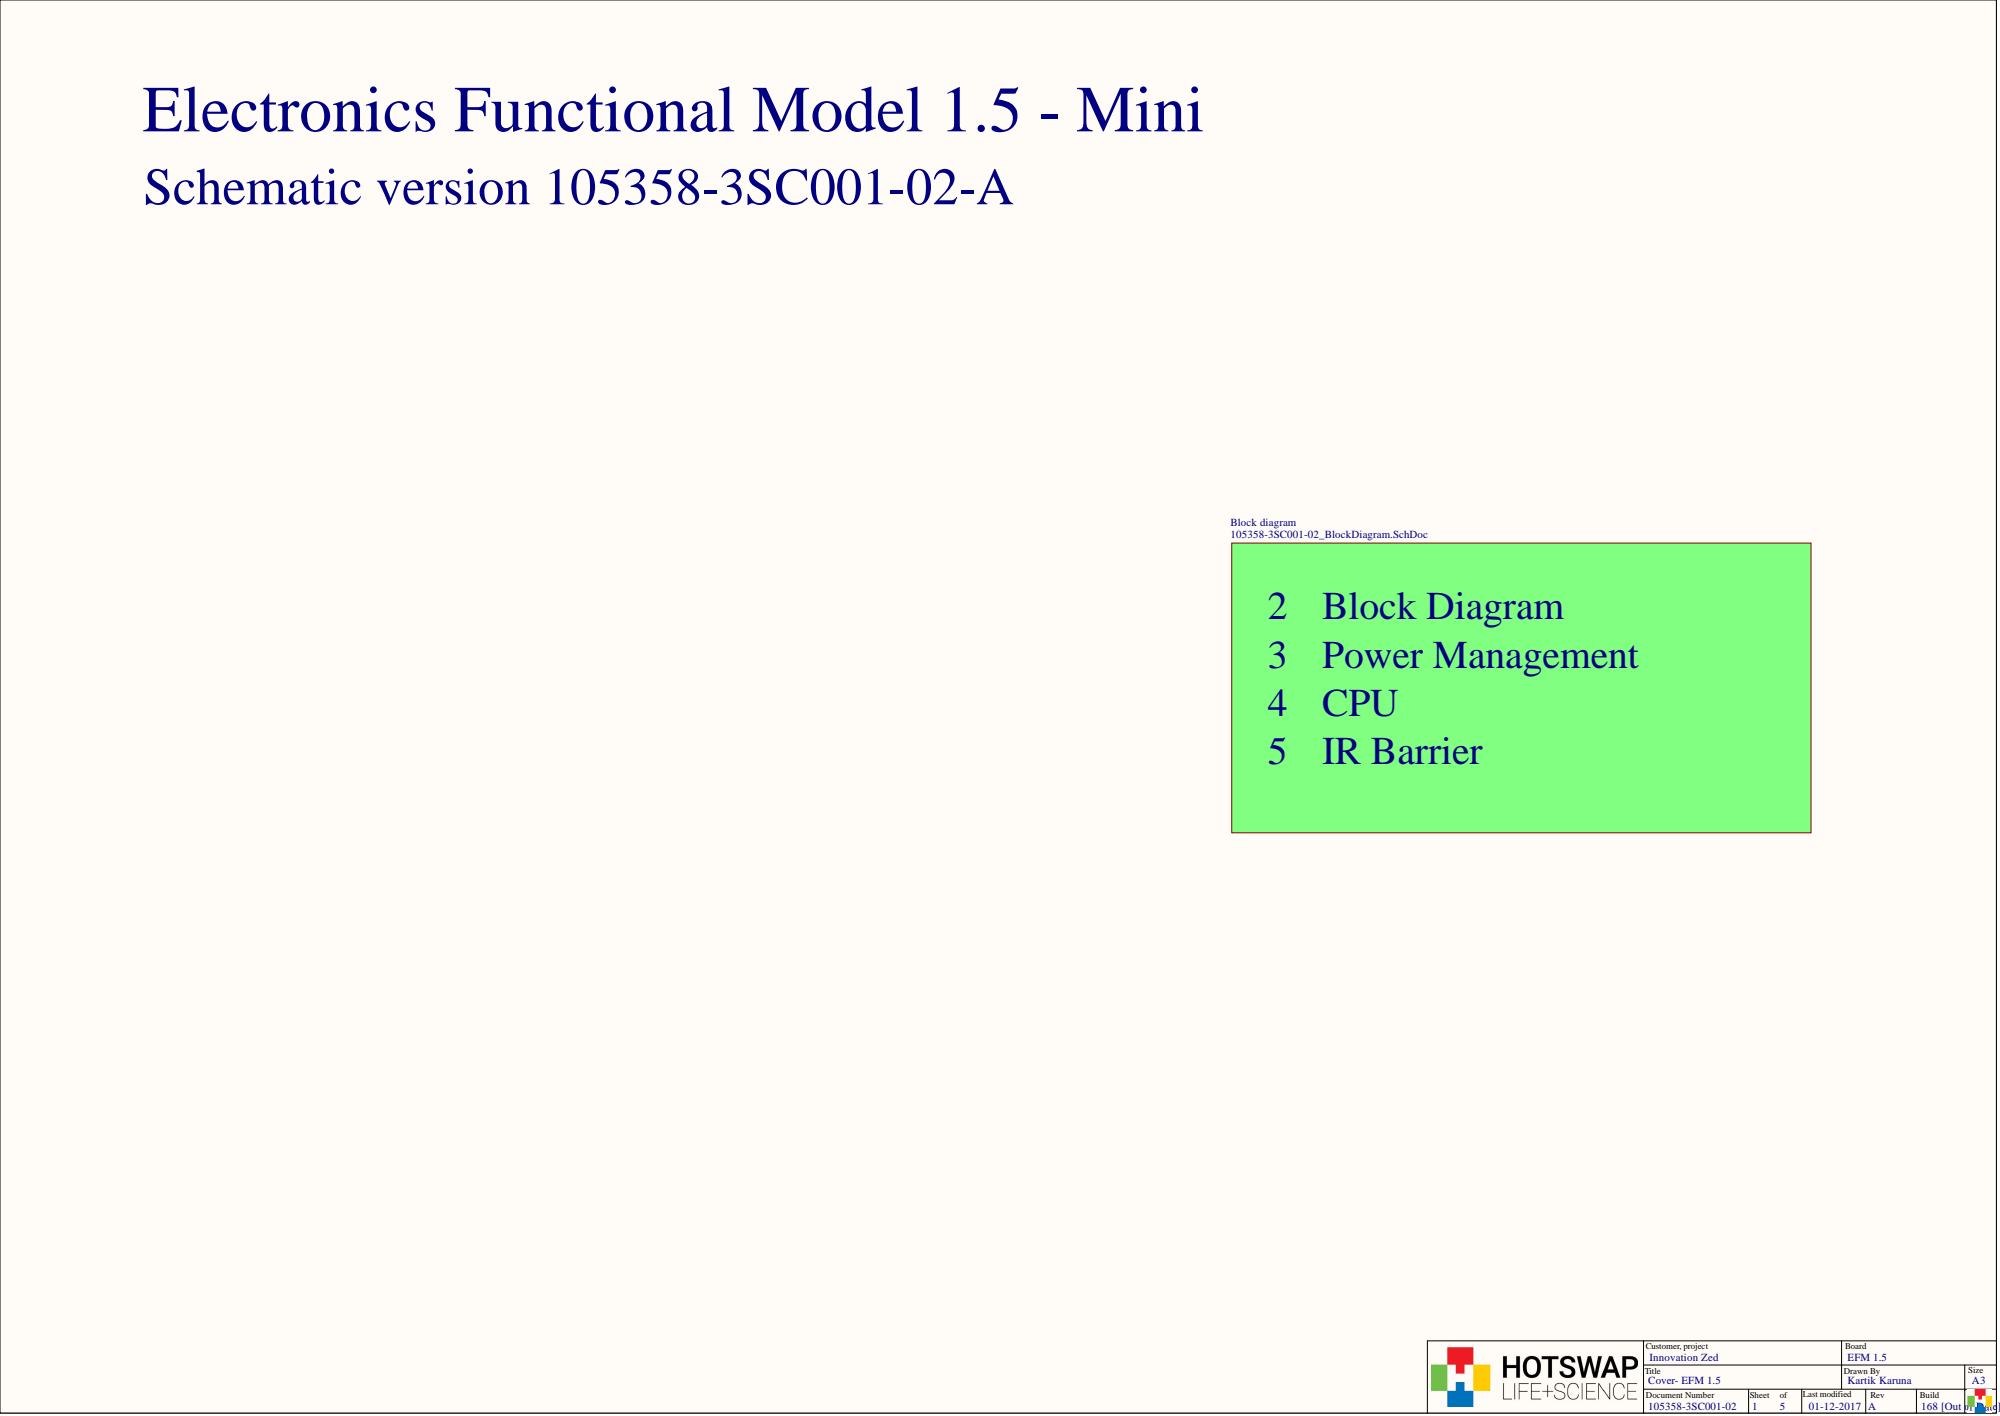
[picture p73: page 1]

Electronics Functional Model 1.5 - Mini
Schematic version 105358-3SC001-02-A

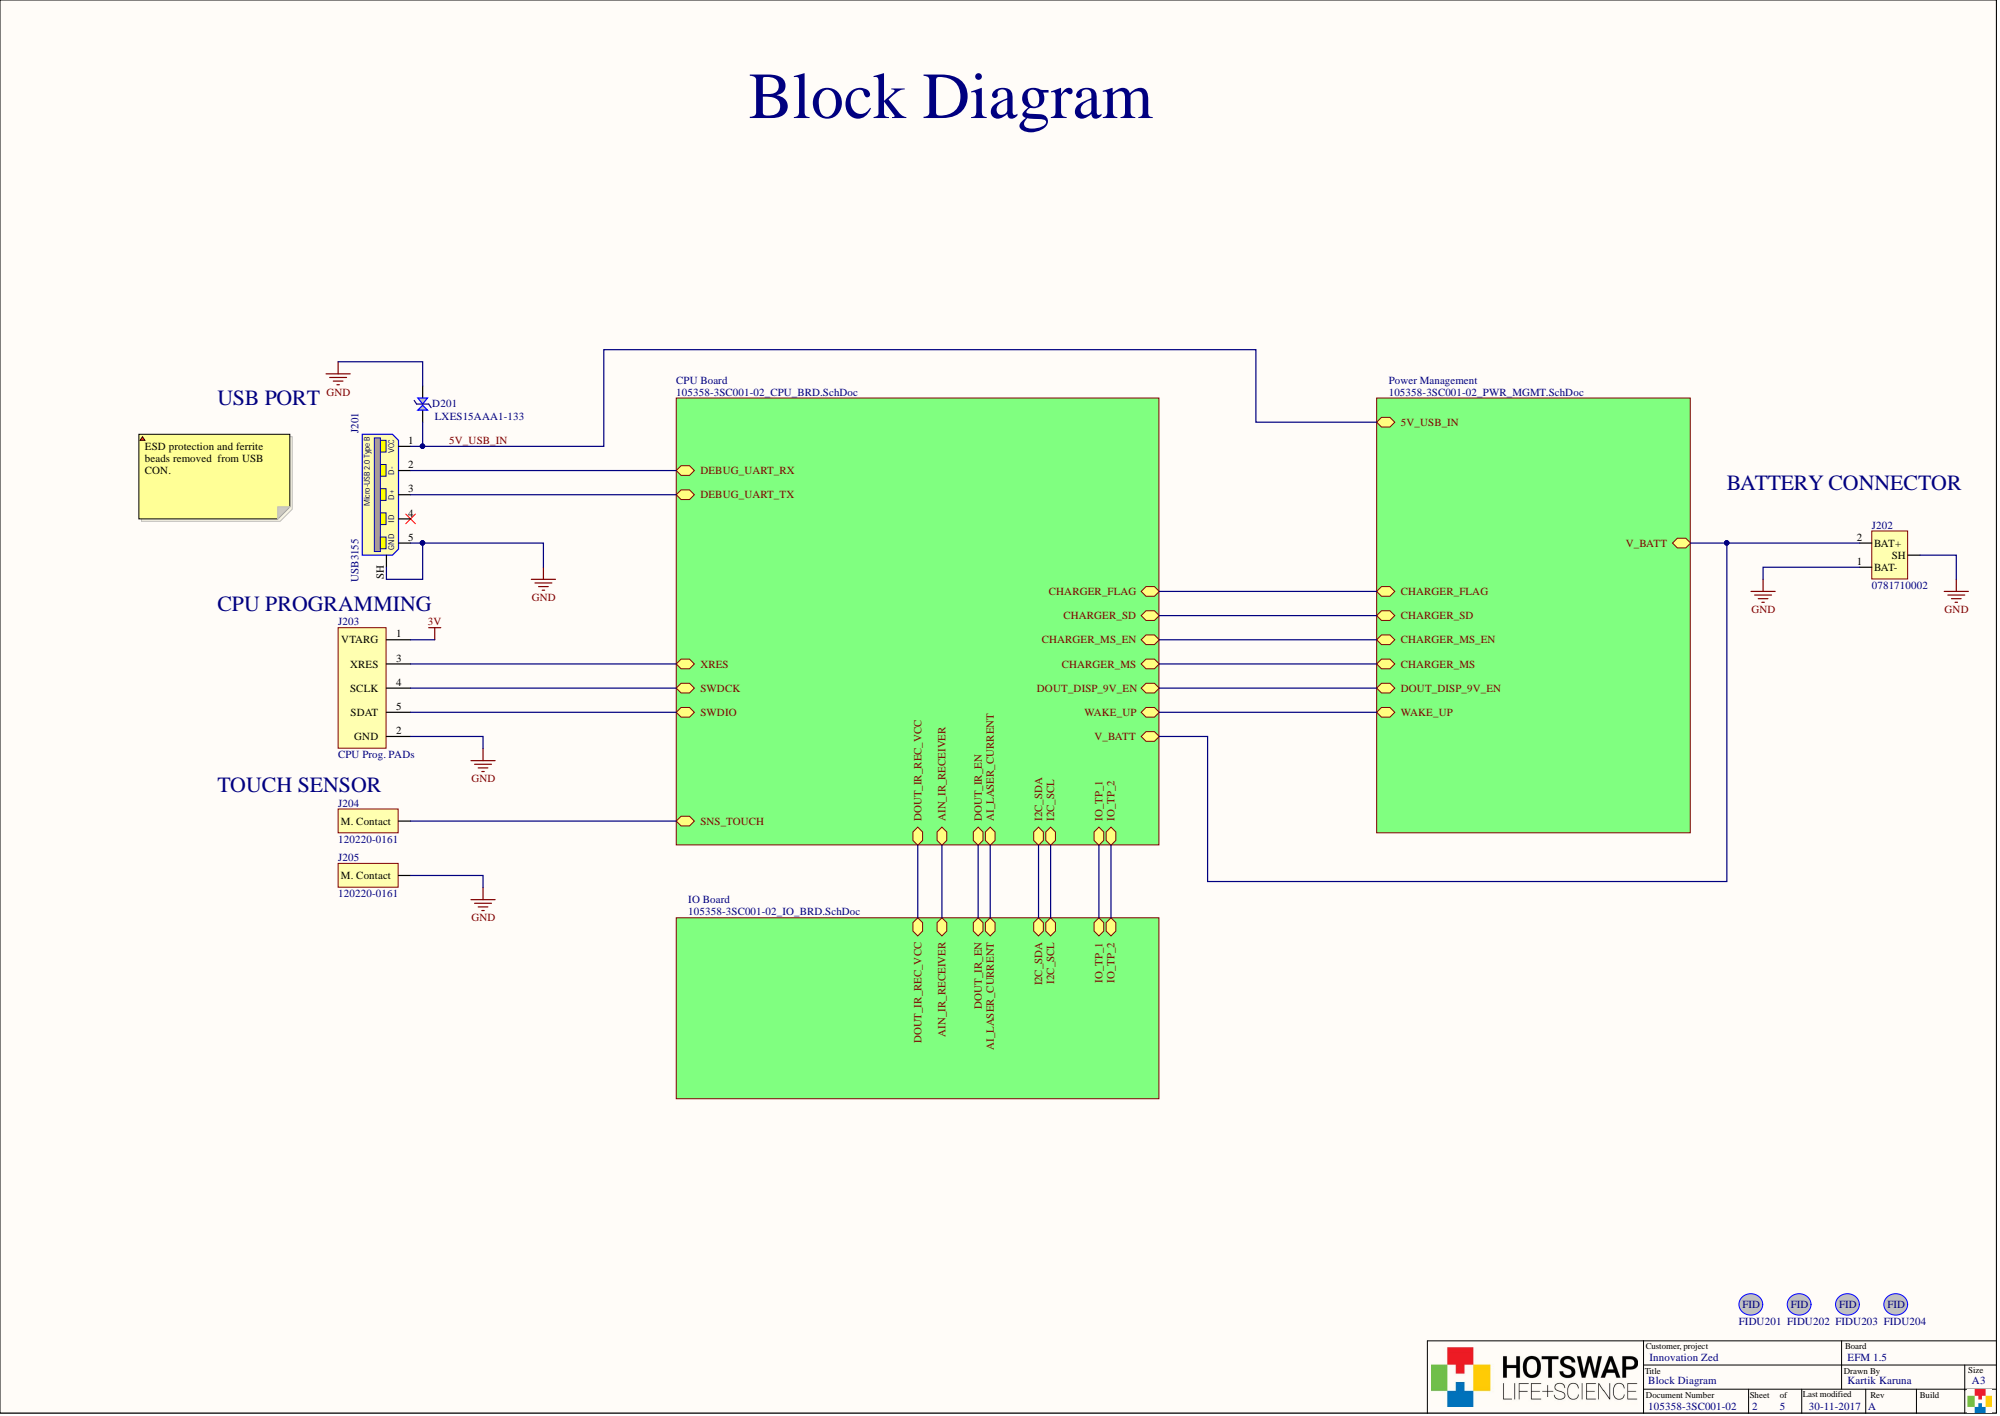
[picture p74: page 2]

ESD protection and ferrite
beads removed from USB
CON.

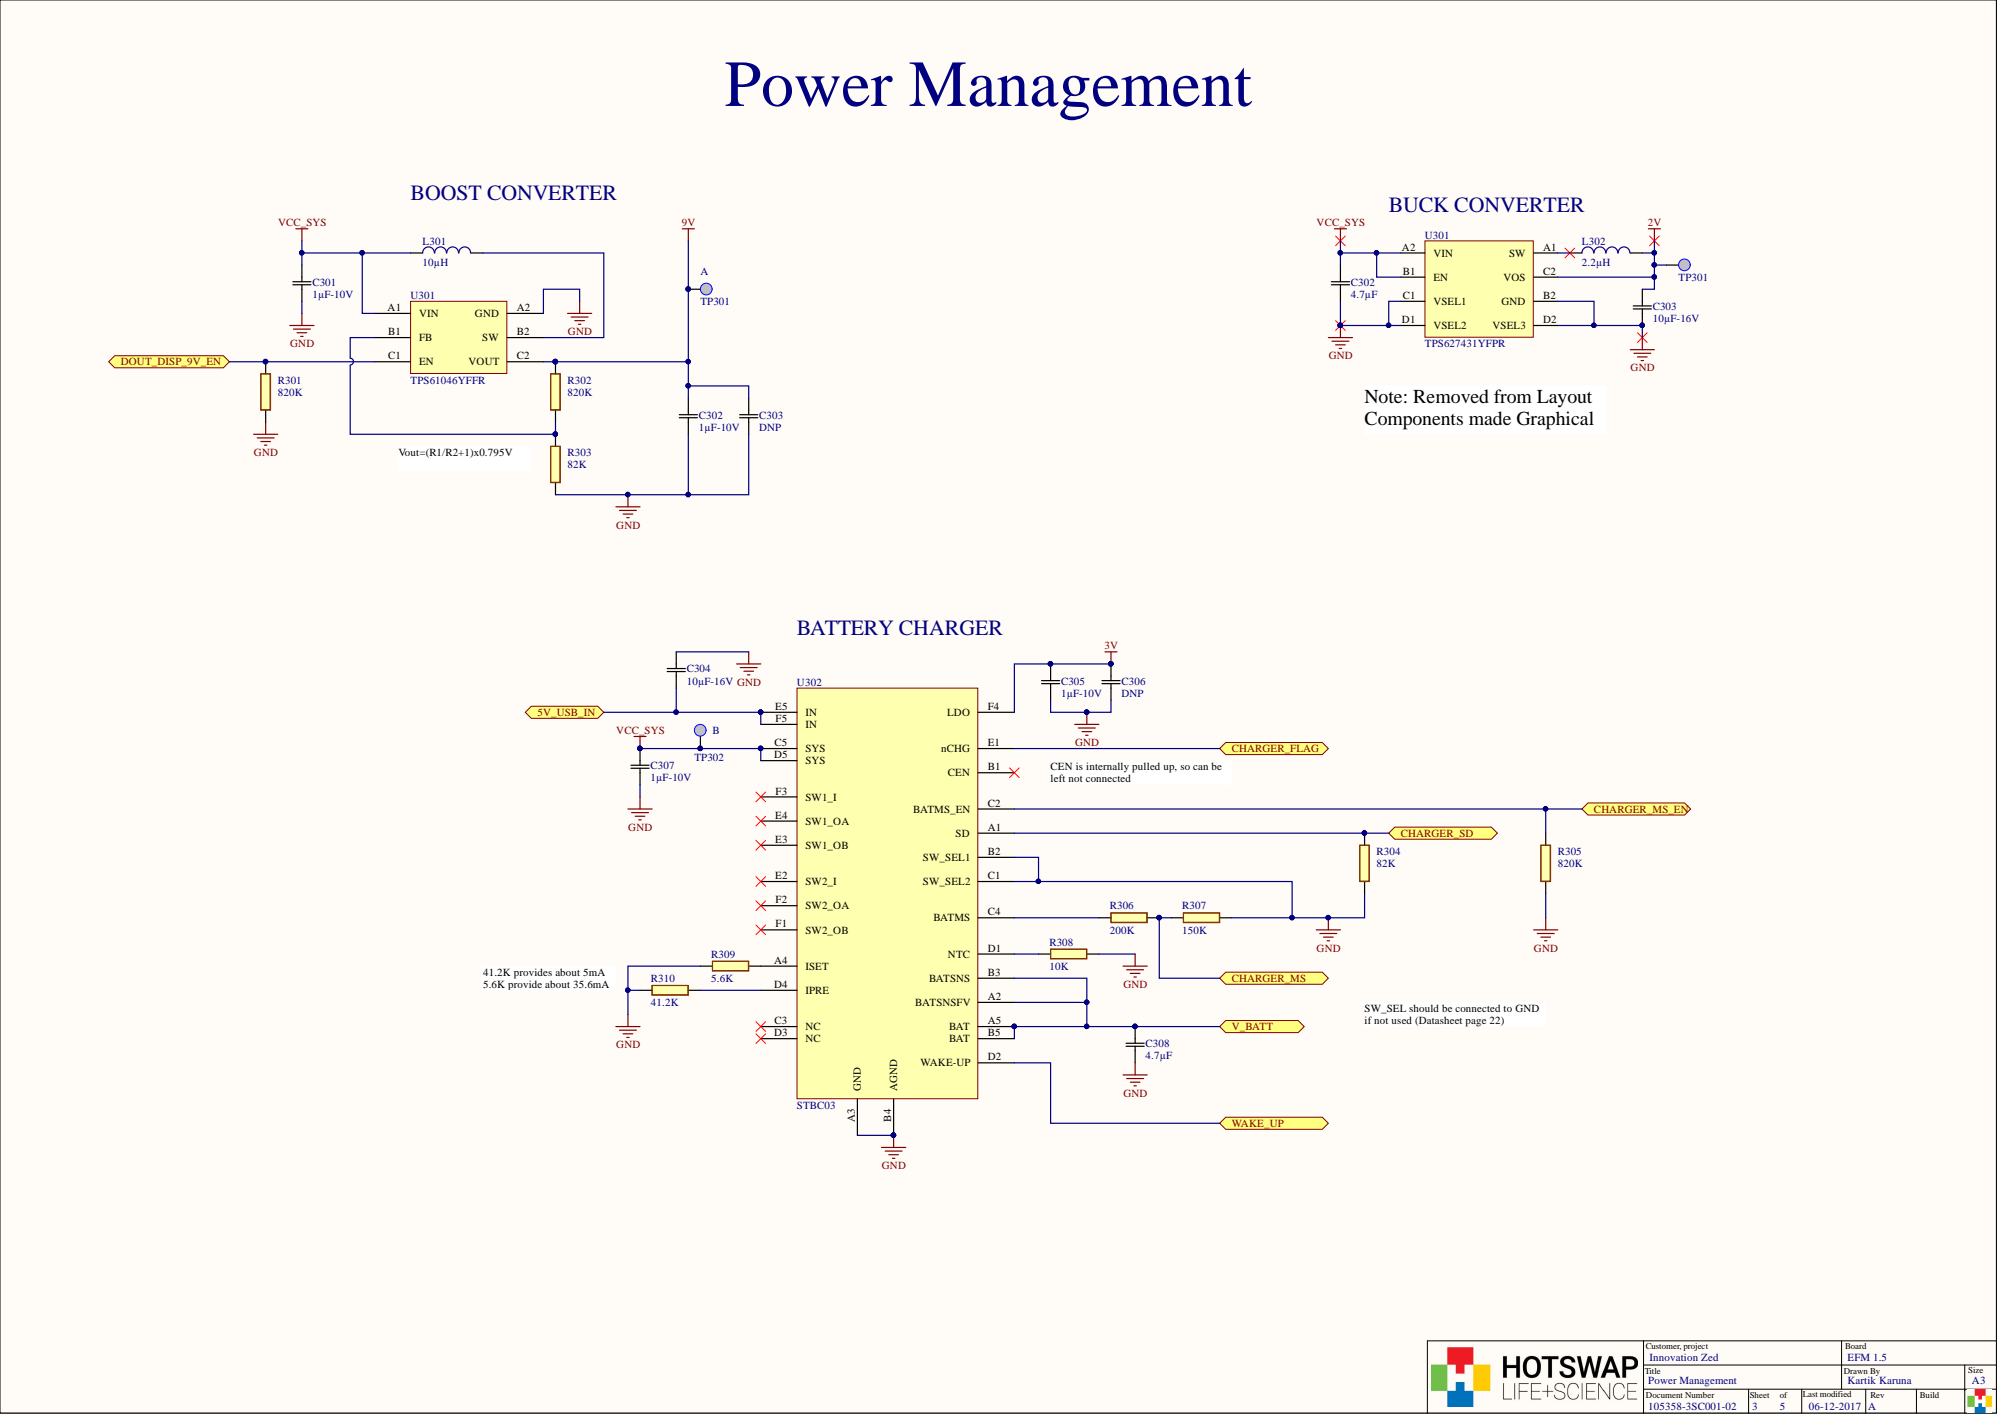
[picture p75: page 3]

BUCK CONVERTER BOOST CONVERTER

Note: Removed from Layout
Components made Graphical

SYS C5

TP302 | SYS D5

CEN is internally pulled up, so can be
left not connected

SW_SEL should be connected to GND
if not used (Datasheet page 22)

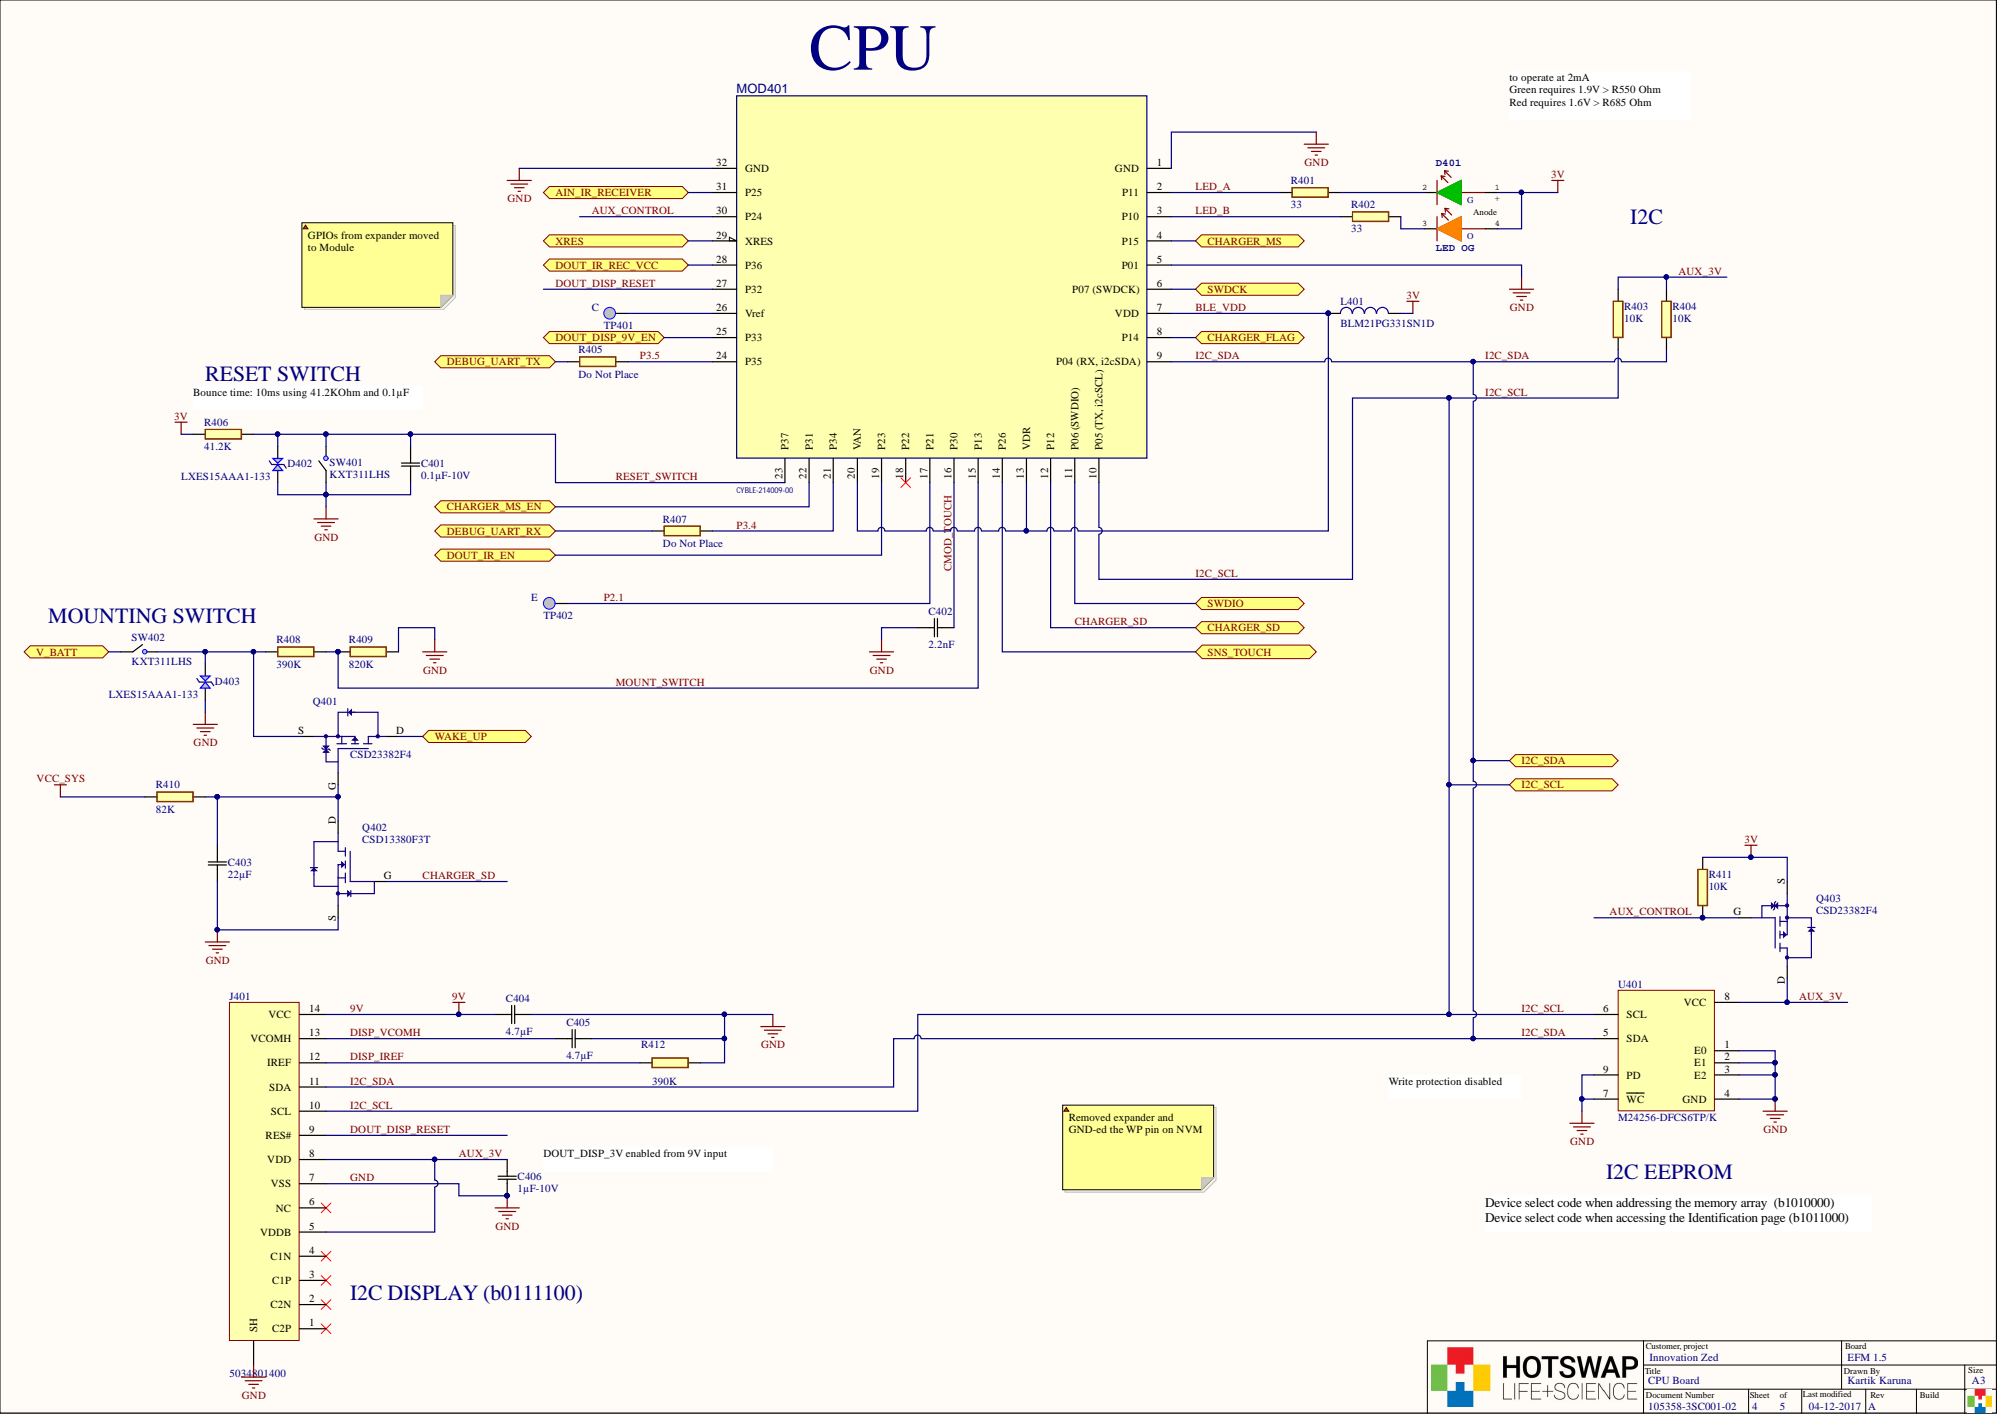
[picture p76: page 4]

XRES 29 | 3

GPIOs from expander moved
to Module

Bounce time: 10ms using 41.2KOhm and 0.1µF

C401 0.1µF-10V RESET_SWITCH

CYBLE-214009-00

C402 | | | | I2C_SCL

Removed expander and
GND-ed the WP pin on NVM

Device select code when addressing the memory array (b1010000)
Device select code when accessing the Identification page (b1011000)

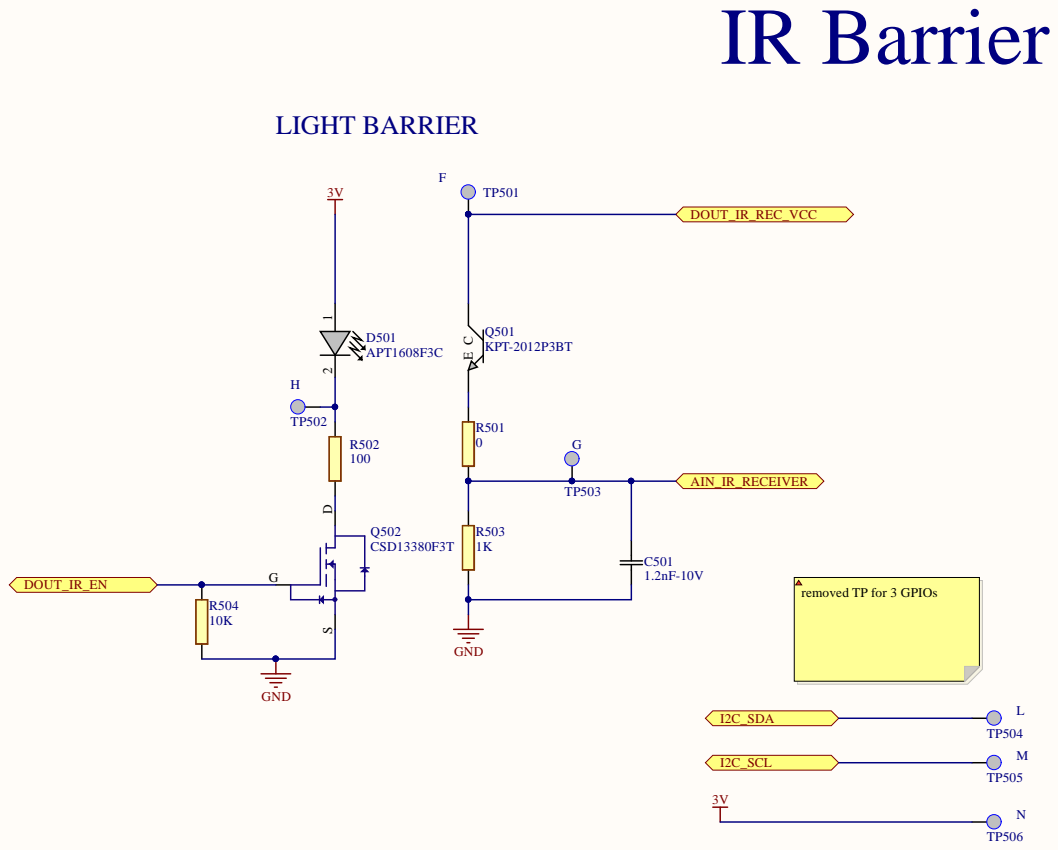
[picture p77: page 5]

removed TP for 3 GPIOs
