Engineer1234/ConnectMedical/Connect Medical Boards/EFM2/Project Outputs for 105358-3BA001-02_EFM1.5/PDF/105358-3CD004-02 Assembly Drawing.PDF

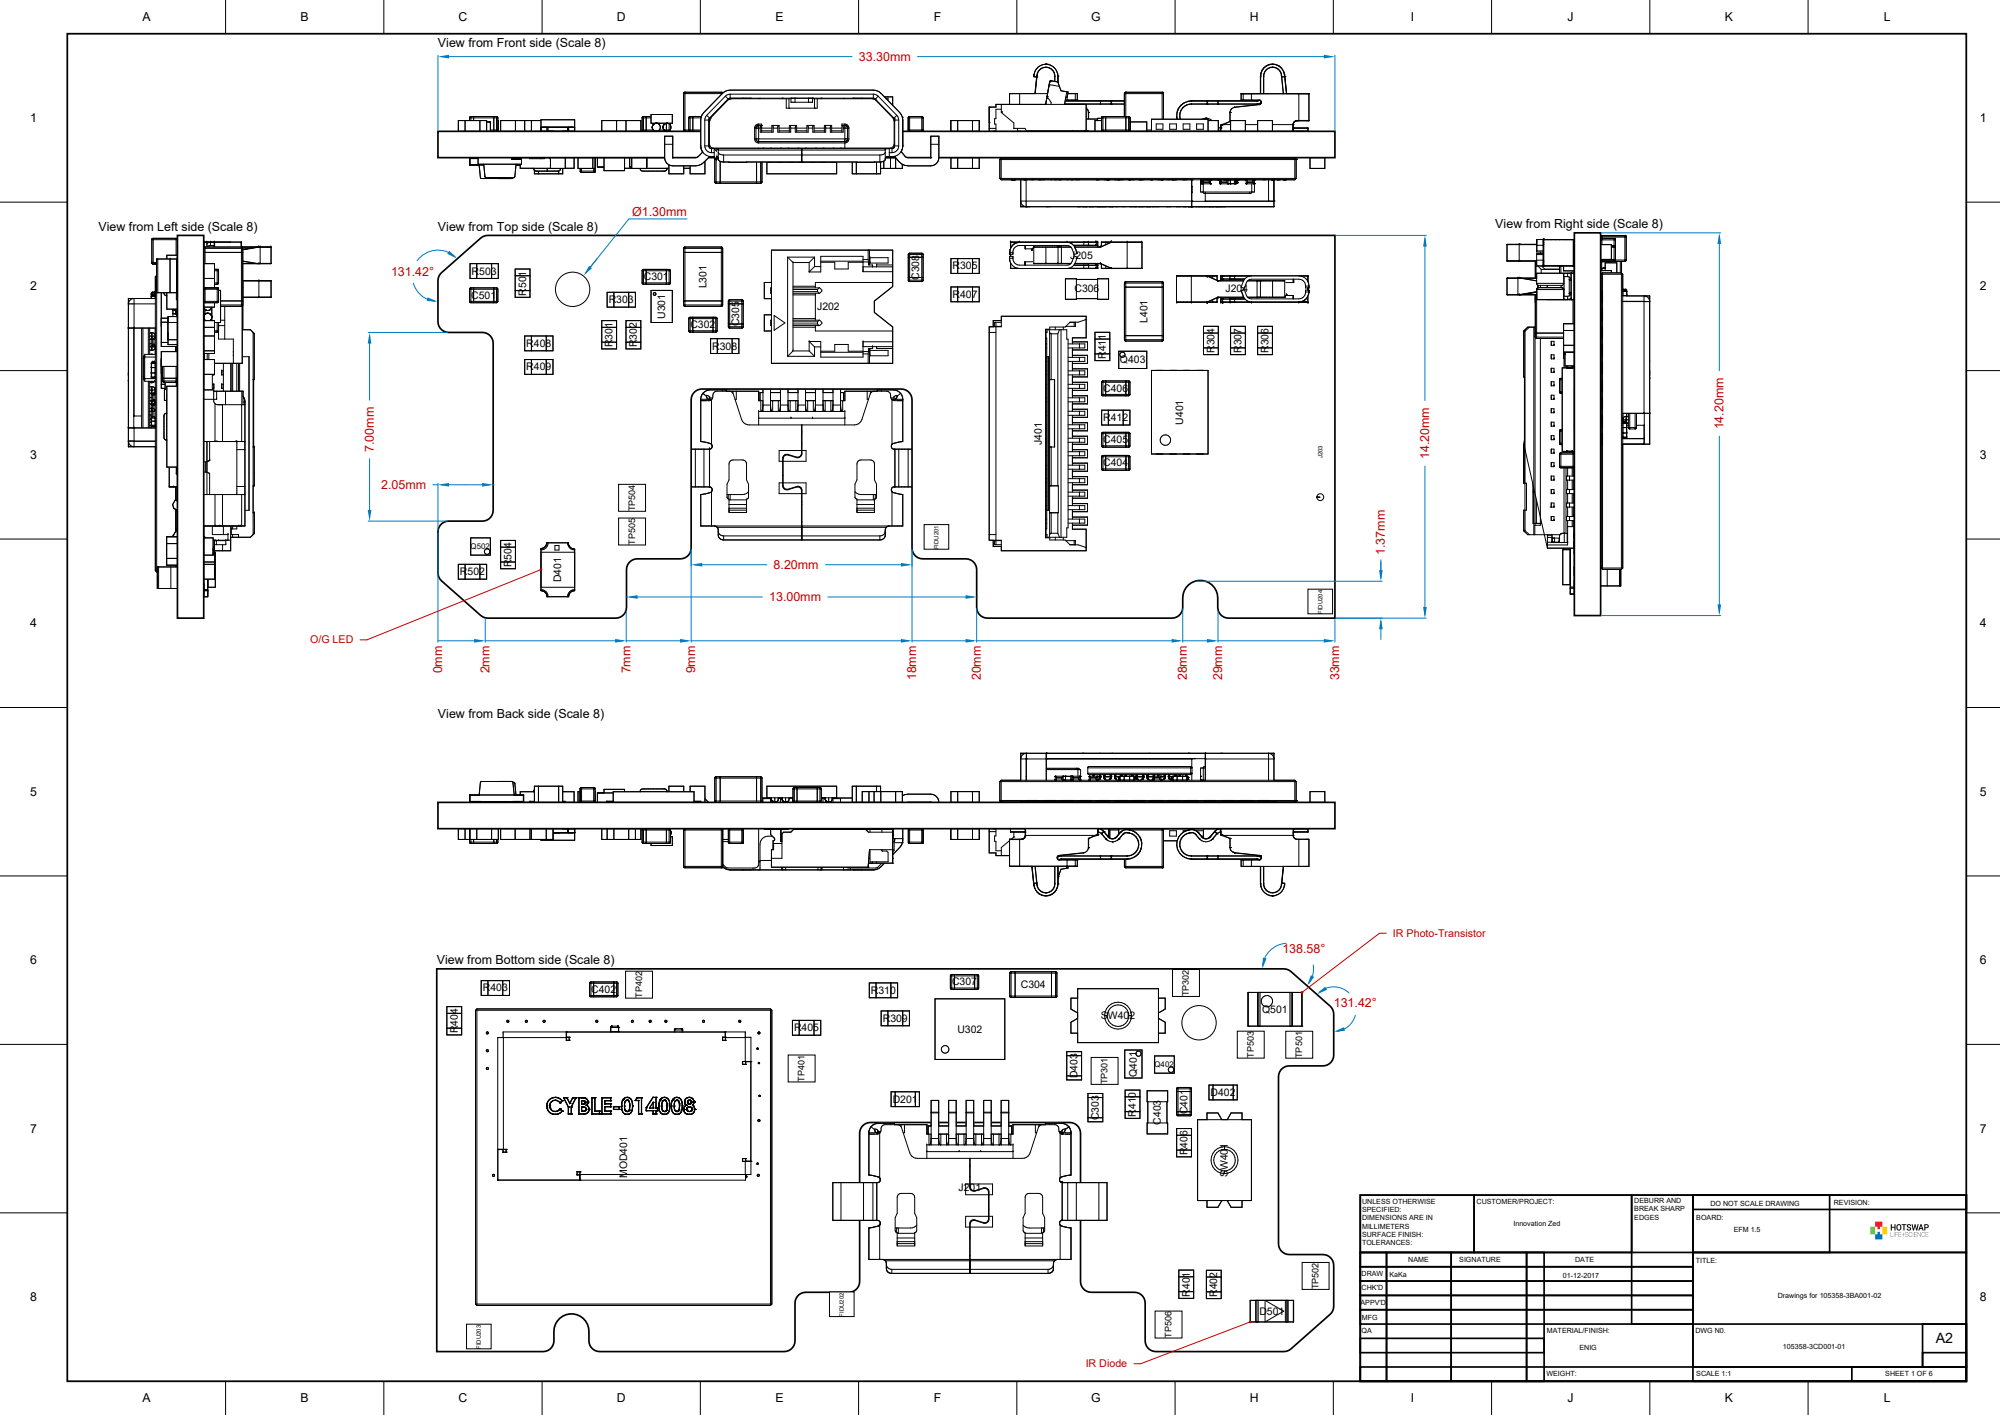
[picture p78: page 1]

View from Front side (Scale 8)

View from Top side (Scale 8)

View from Back side (Scale 8)

View from Bottom side (Scale 8)

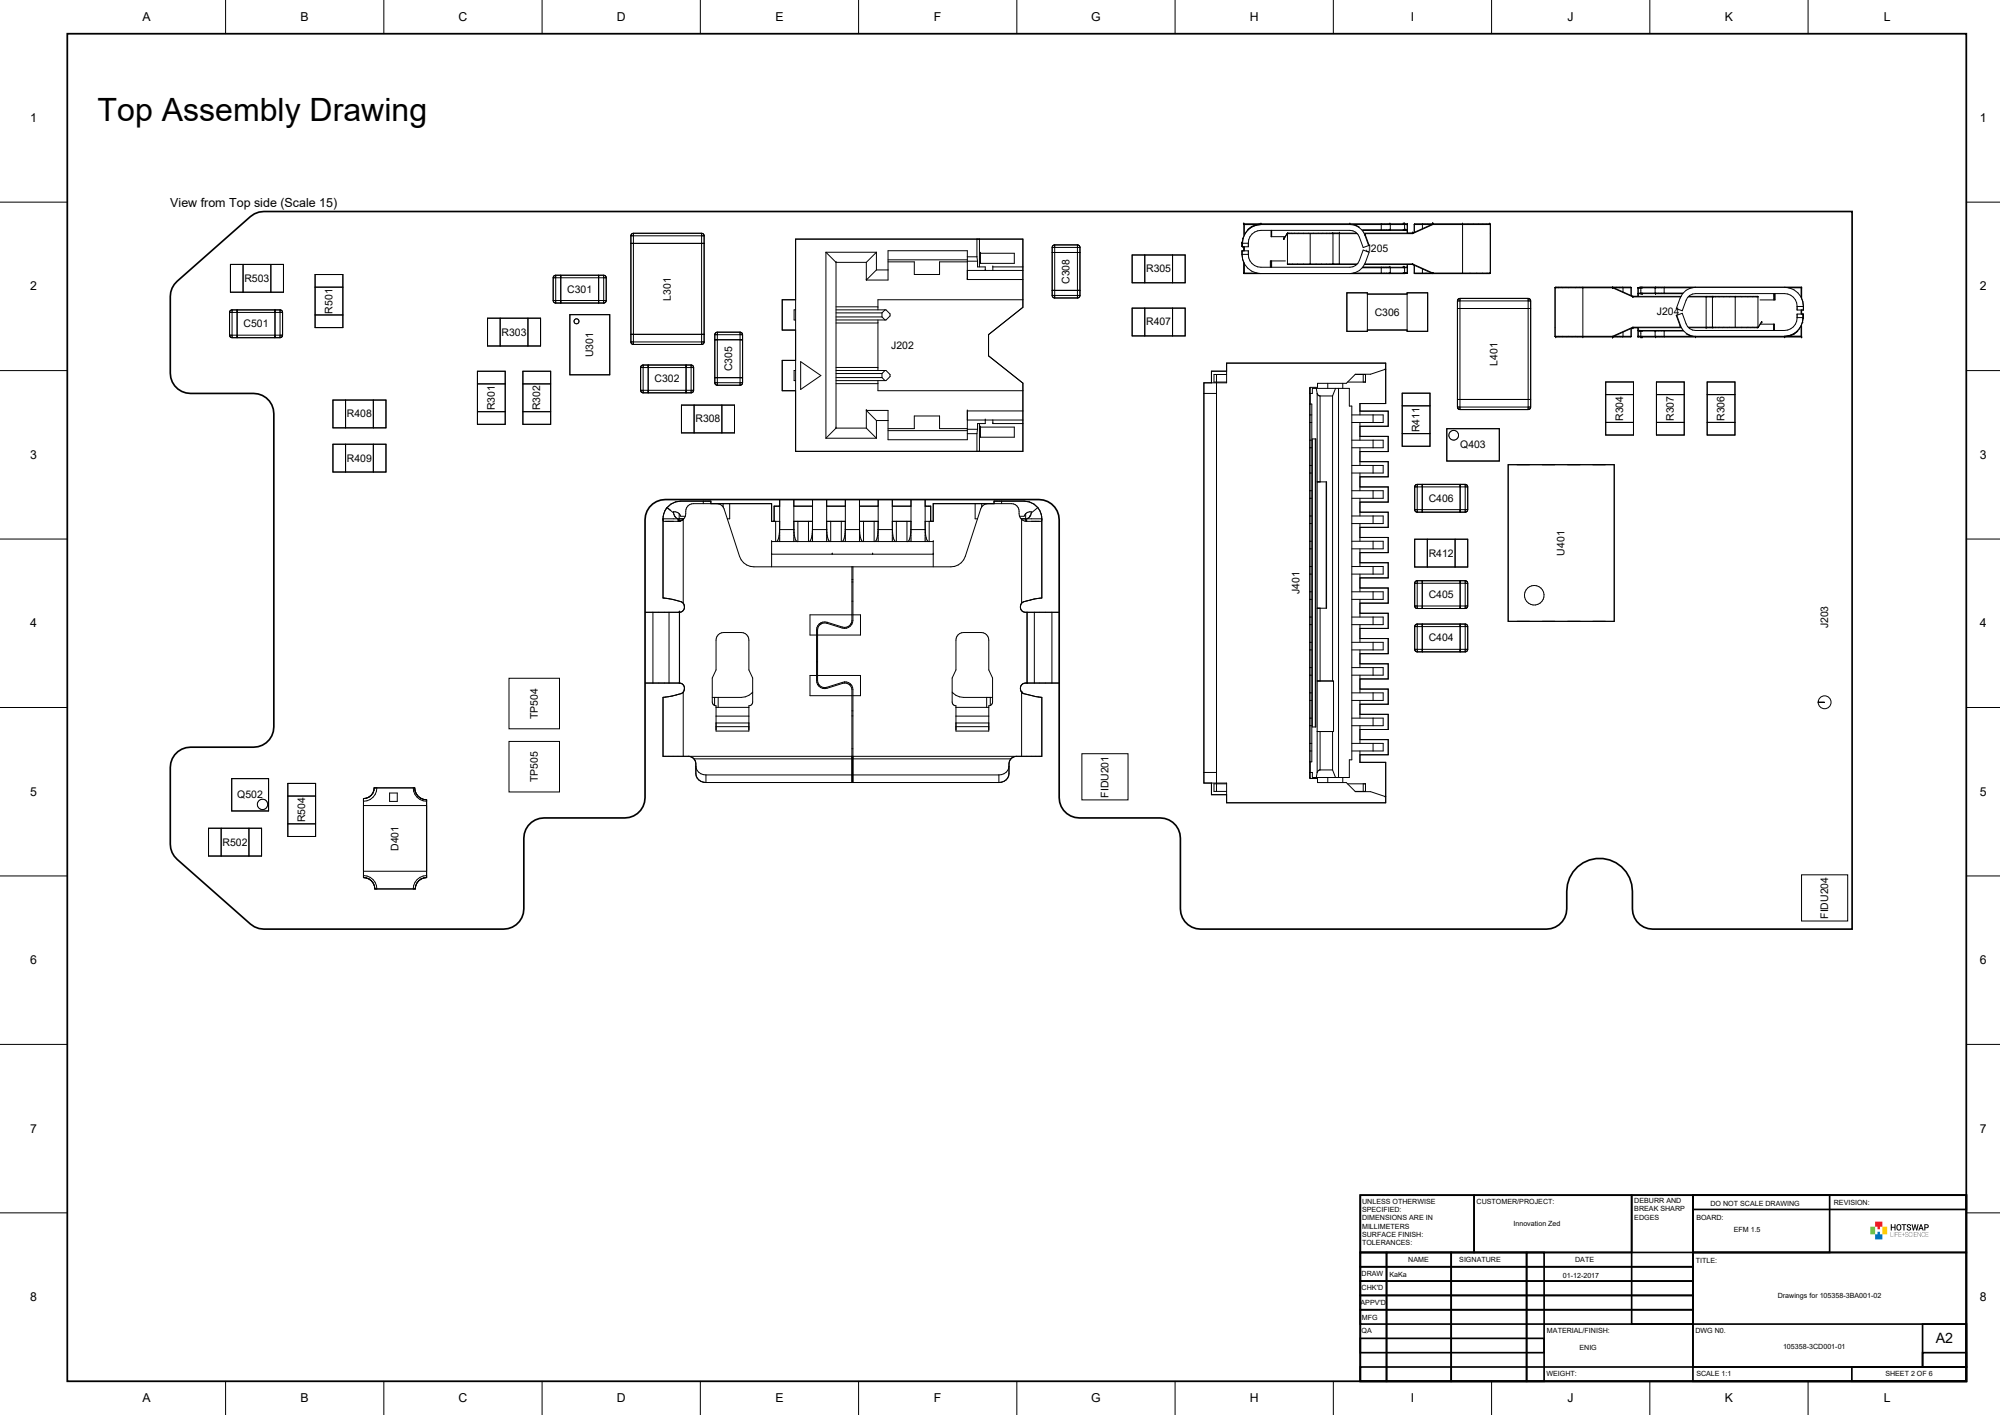
[picture p79: page 2]

View from Top side (Scale 15)

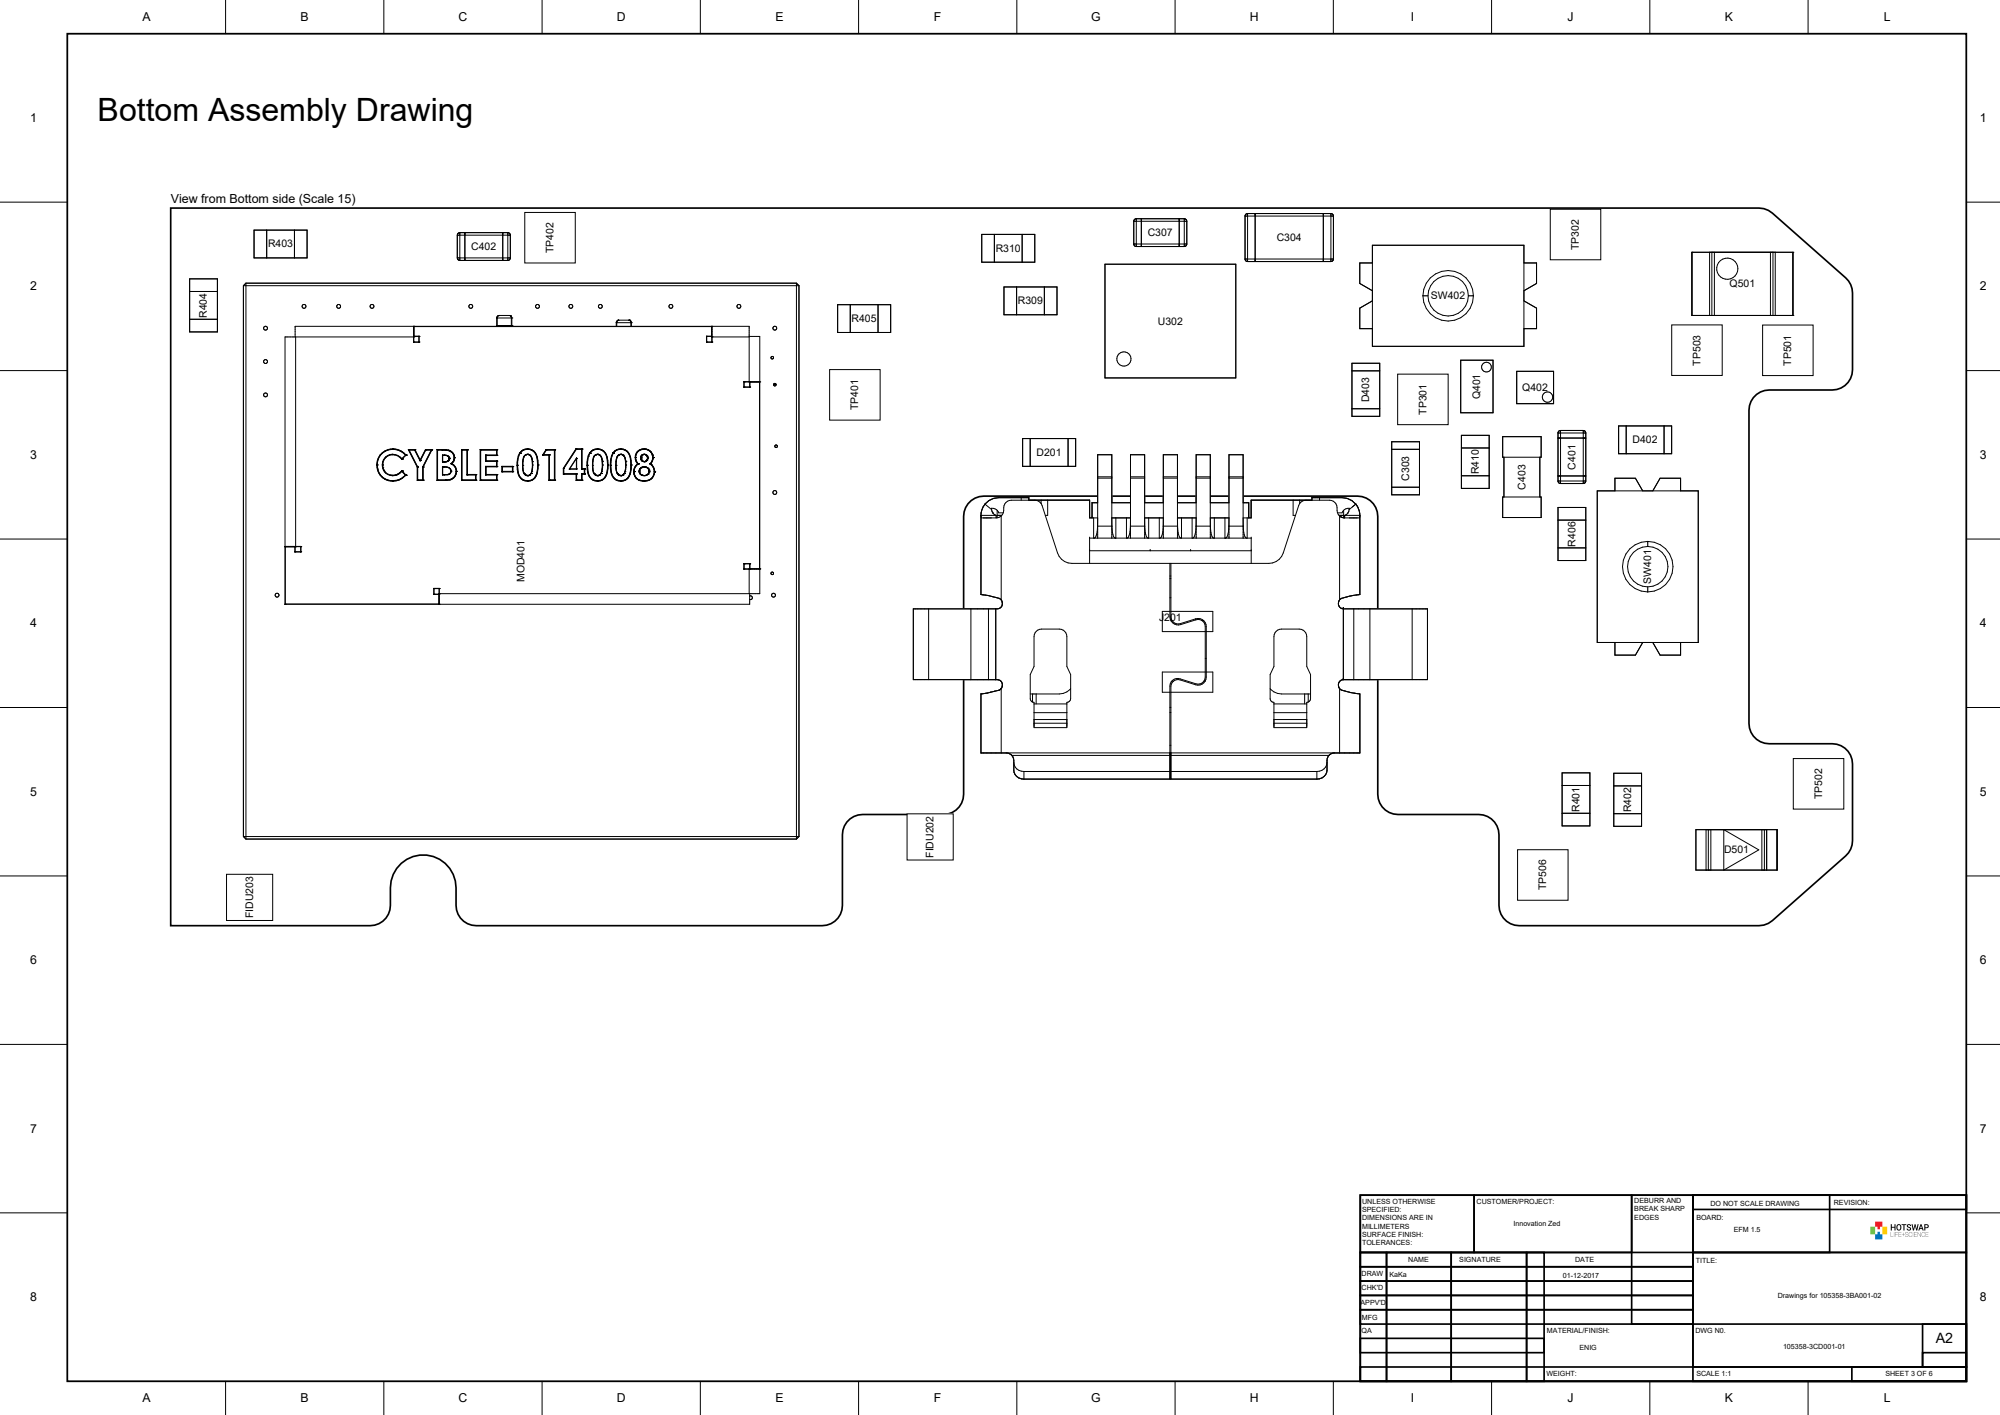
[picture p80: page 3]

View from Bottom side (Scale 15)

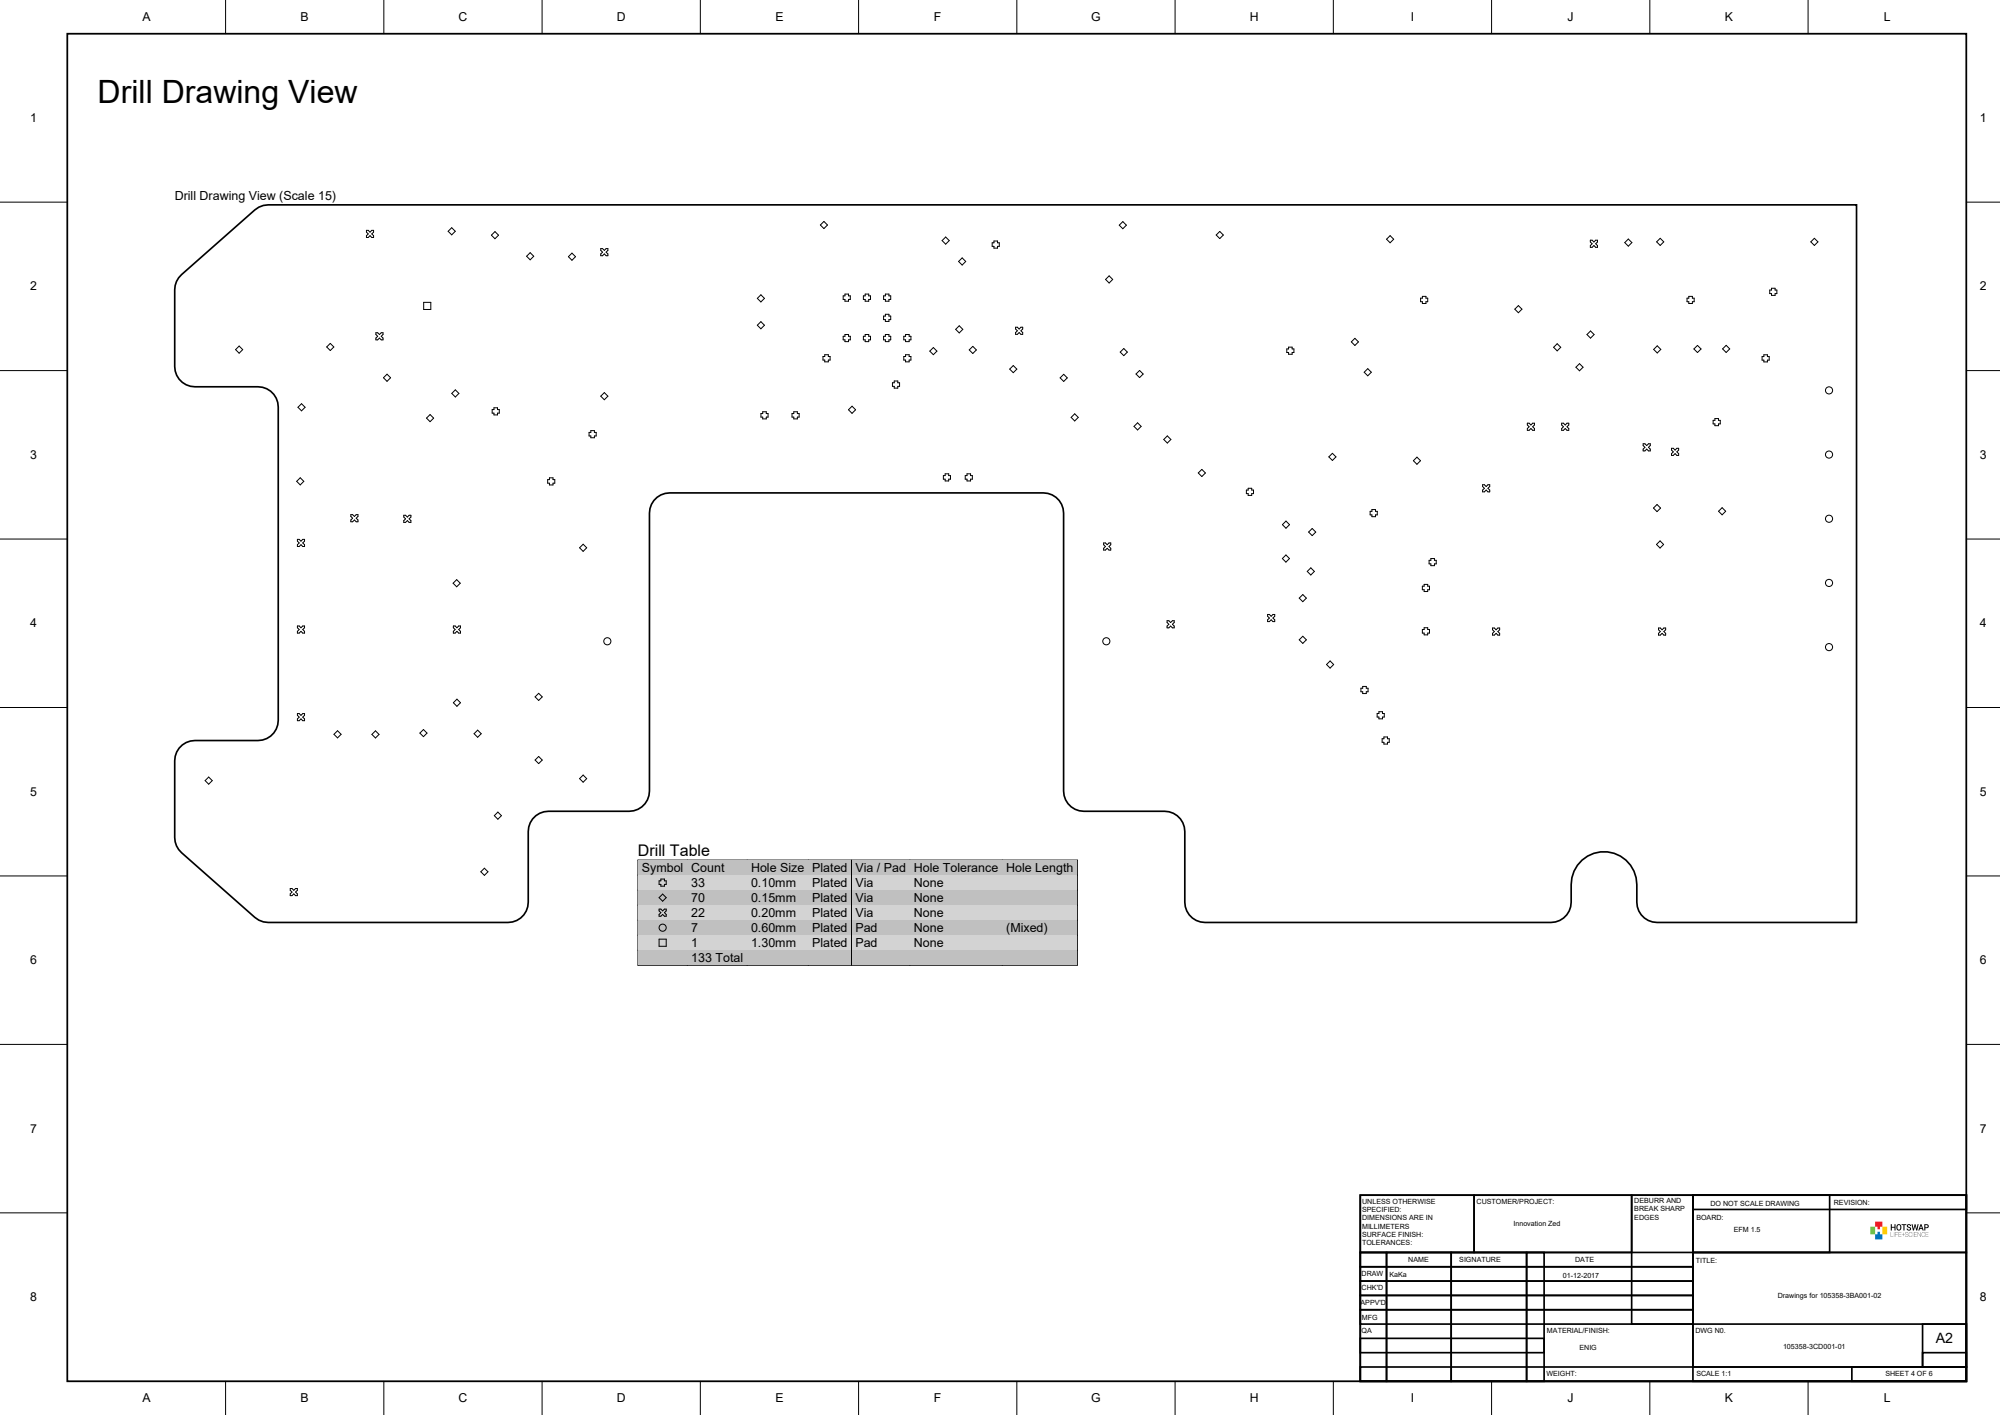
[picture p81: page 4]

Drill Drawing View (Scale 15)

Symbol | Count | Hole Size | Plated | Via / Pad | Hole Tolerance | Hole Length

33 | 0.10mm | Plated | Via | None
70 | 0.15mm | Plated | Via | None
22 | 0.20mm | Plated | Via | None
7 | 0.60mm | Plated | Pad | None | (Mixed)
1 | 1.30mm | Plated | Pad | None
133 Total

UNLESS OTHERWISE SPECIFIED: DIMENSIONS ARE IN MILLIMETERS SURFACE FINISH: TOLERANCES: | CUSTOMER/PROJECT: Innovation Zed | DEBURR AND BREAK SHARP EDGES | DO NOT SCALE DRAWING | REVISION:

BOARD: EFM 1.5

NAME | SIGNATURE | | DATE | TITLE:

DRAW | KaKa | | | 01-12-2017
CHK'D

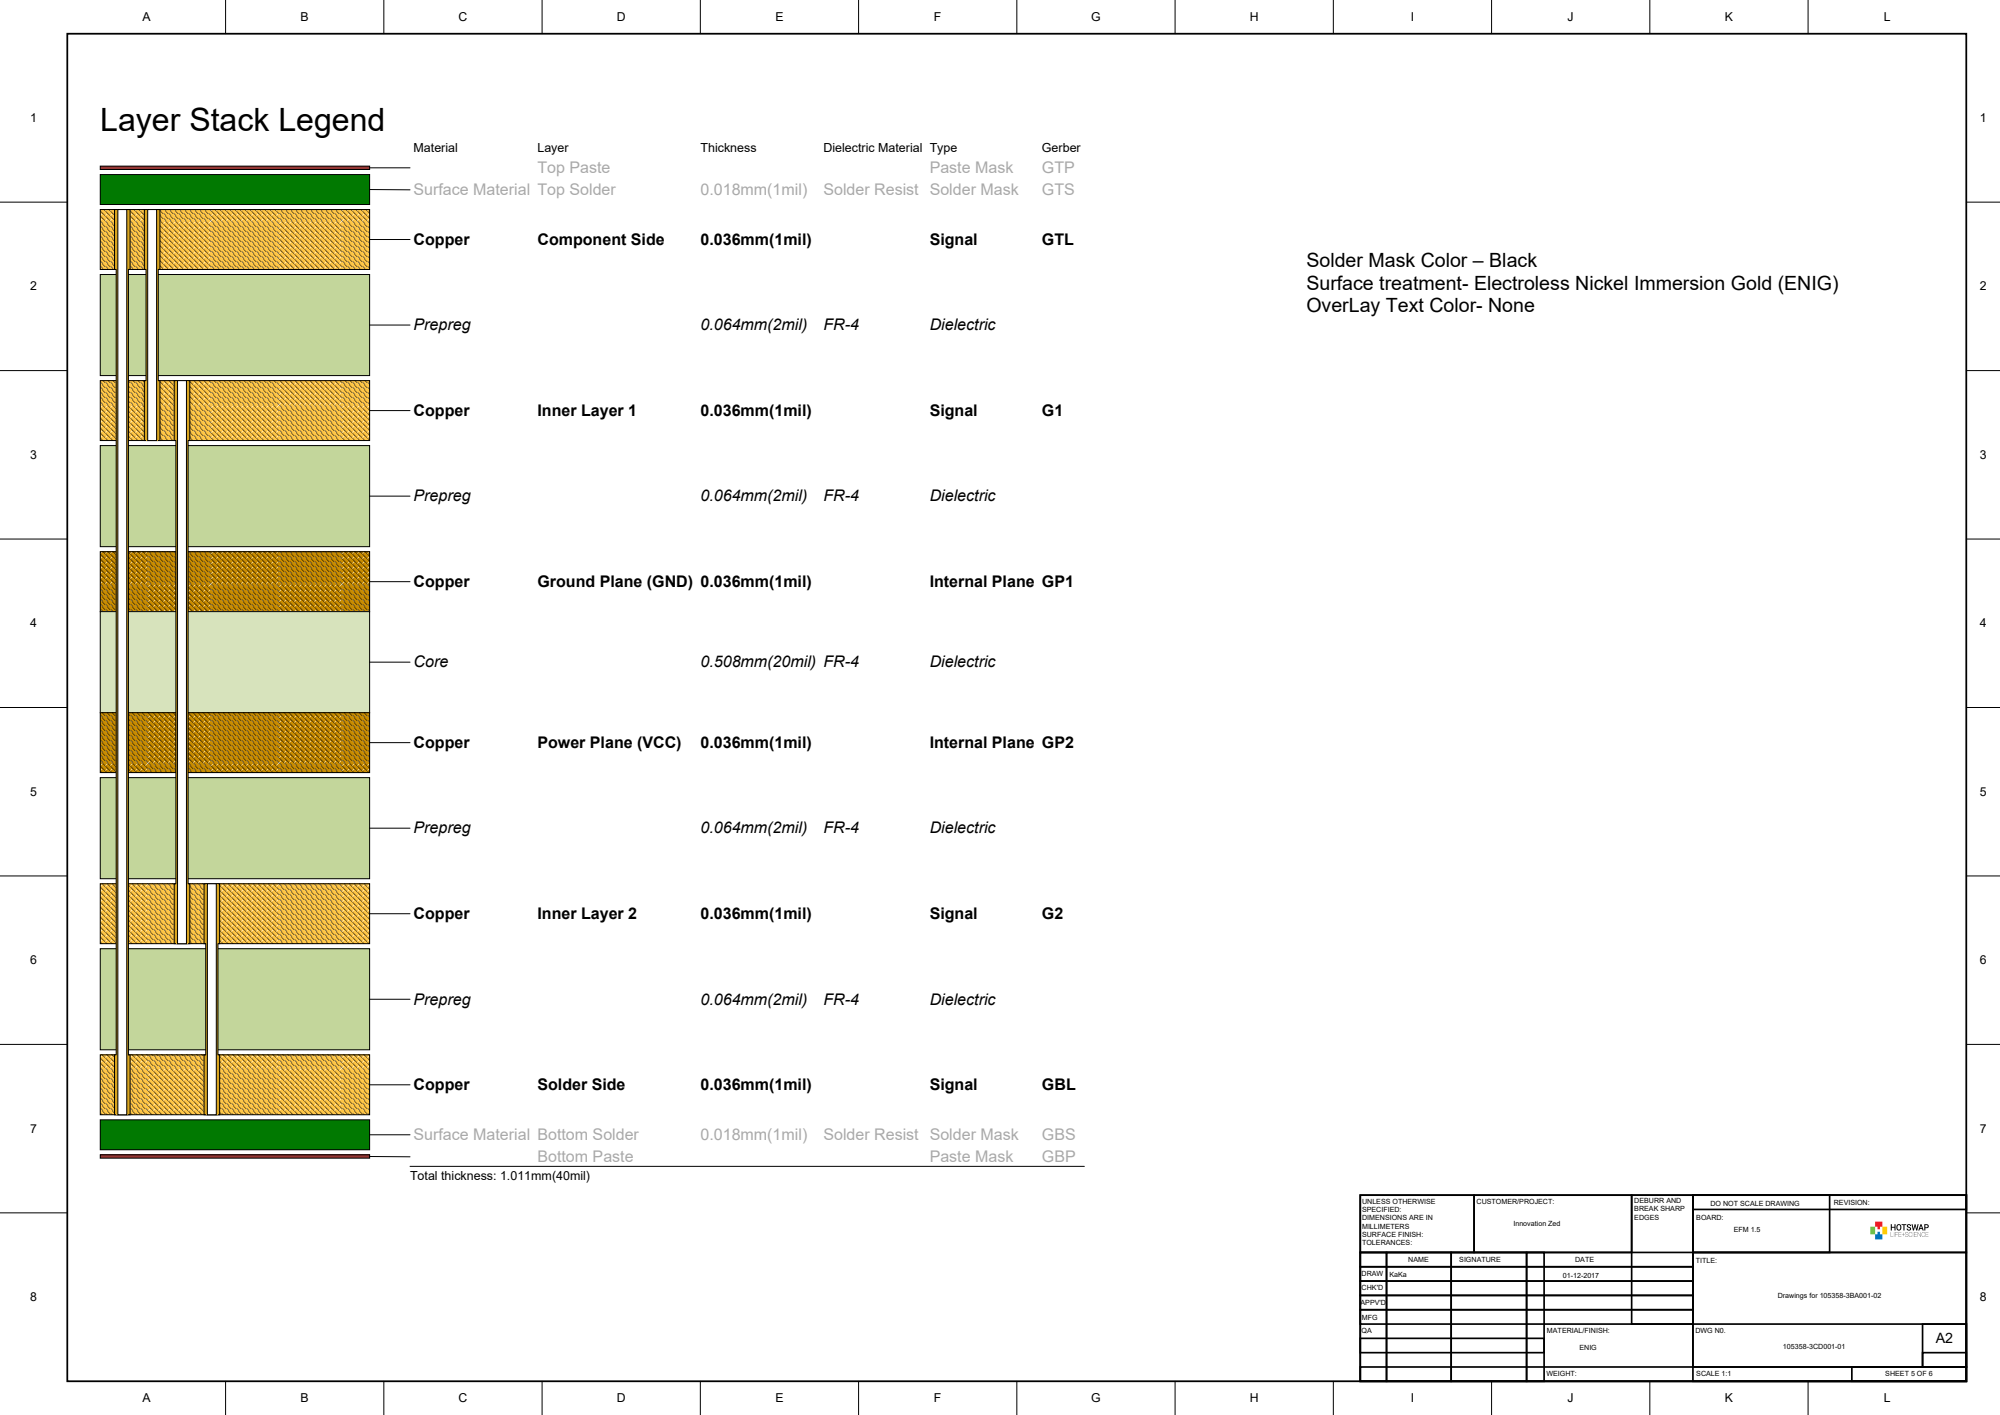
[picture p82: page 5]

Solder Mask Color – Black
Surface treatment- Electroless Nickel Immersion Gold (ENIG)
OverLay Text Color- None

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

BOARD: EFM 1.5

NAME | SIGNATURE | | DATE | TITLE:

DRAW | KaKa | | | 01-12-2017
CHK'D

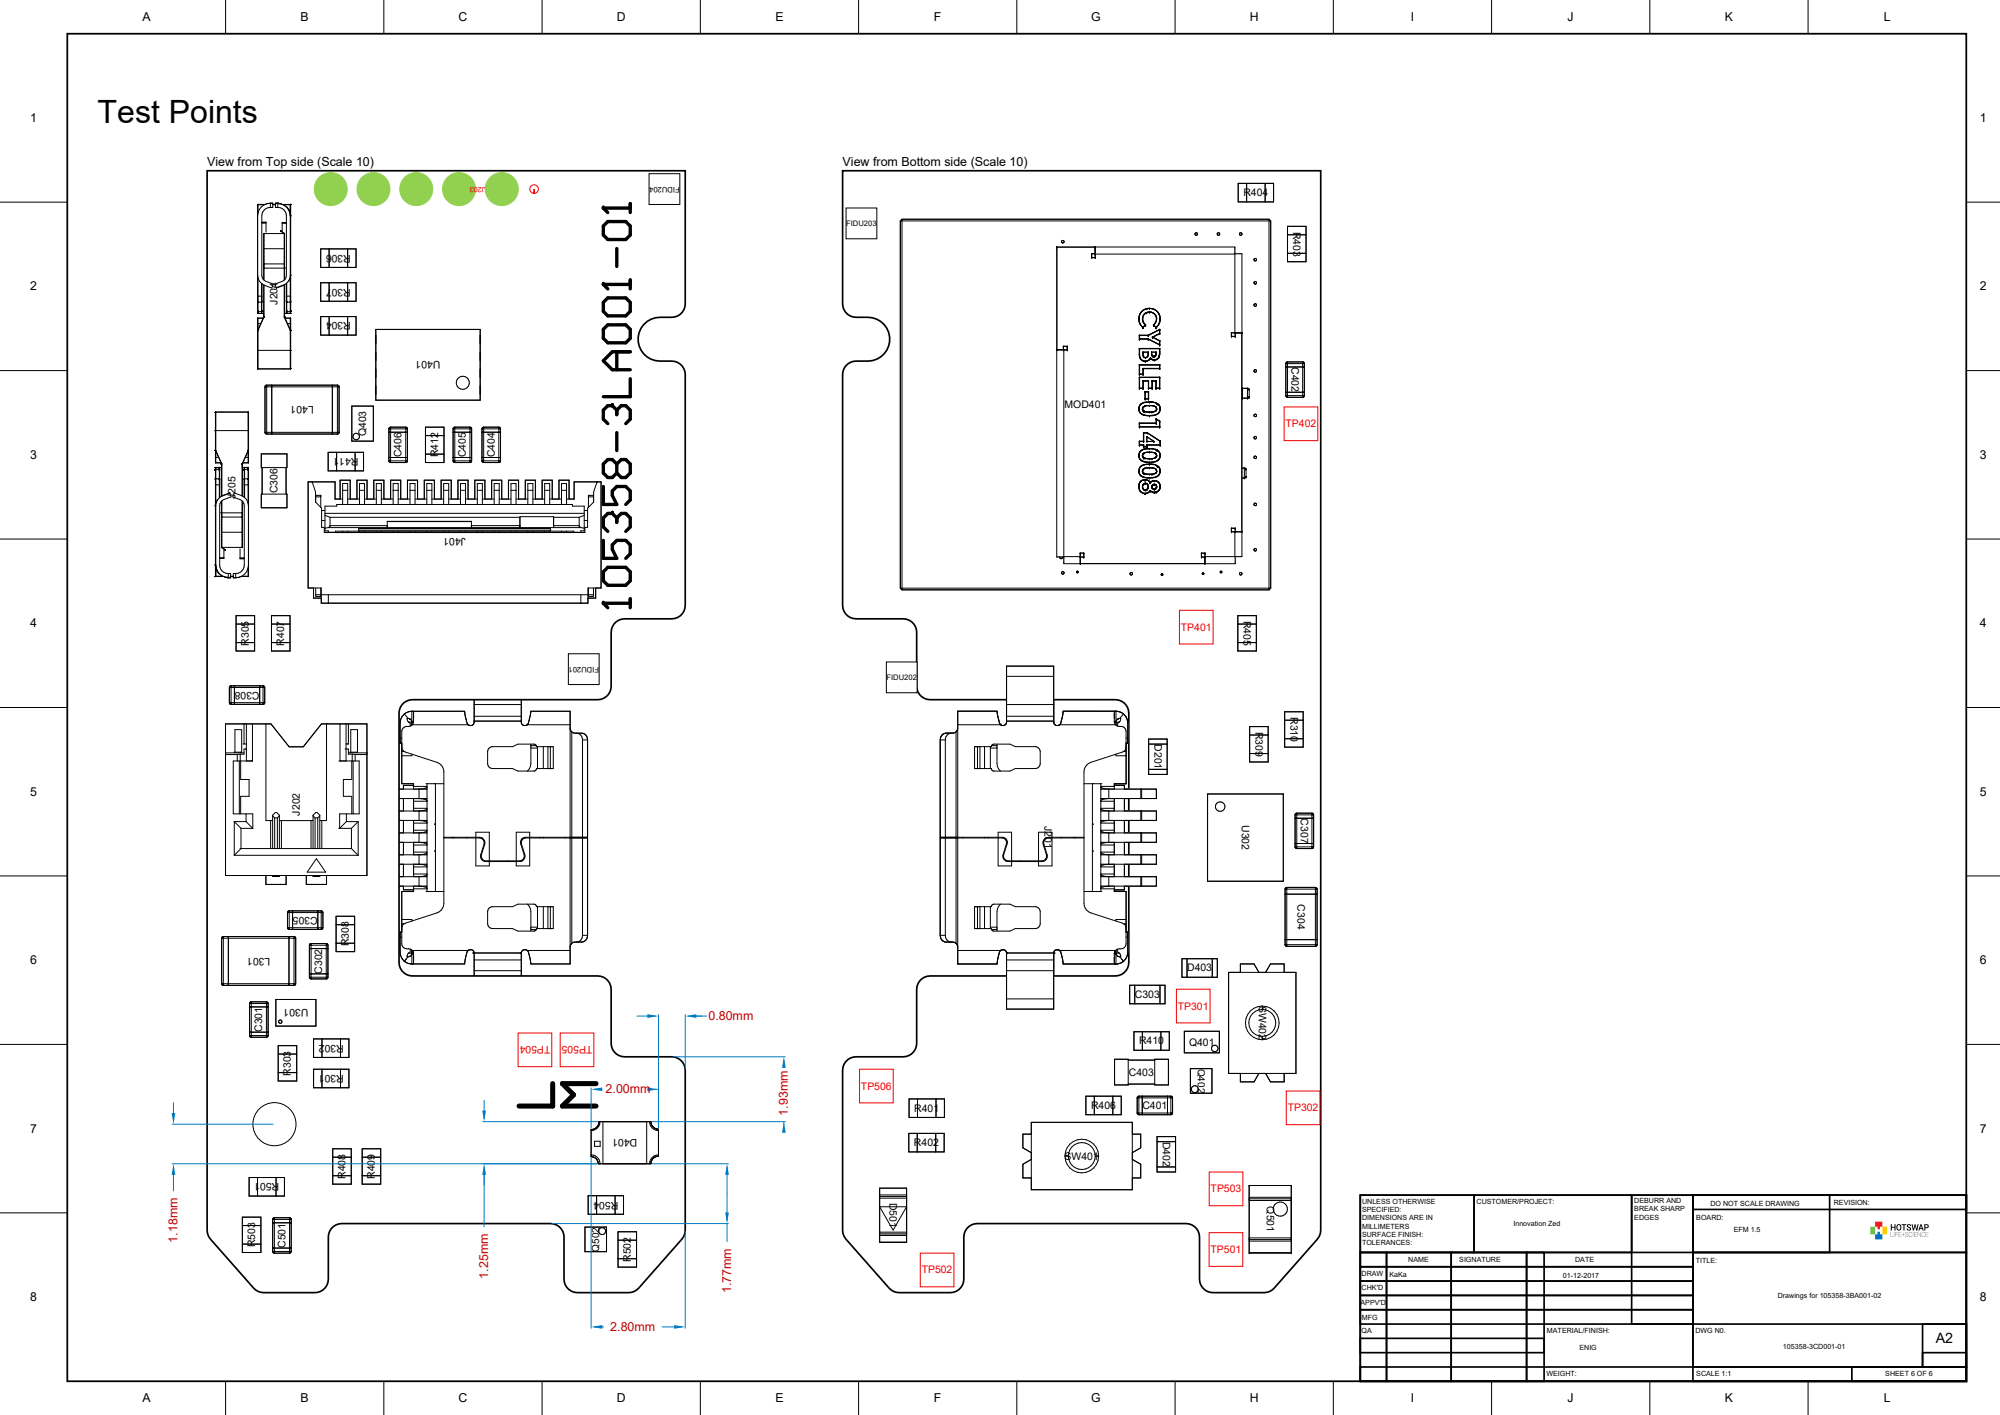
[picture p83: page 6]

View from Top side (Scale 10)

View from Bottom side (Scale 10)
