Engineer1234/ConnectMedical/Connect Medical Boards/EFM1_Touch/Project Outputs for 105358-3BA003-01_EFM1_Touch/PDF/105358-3CD003-01 Assembly Drawing-EFM1-Touch.PDF

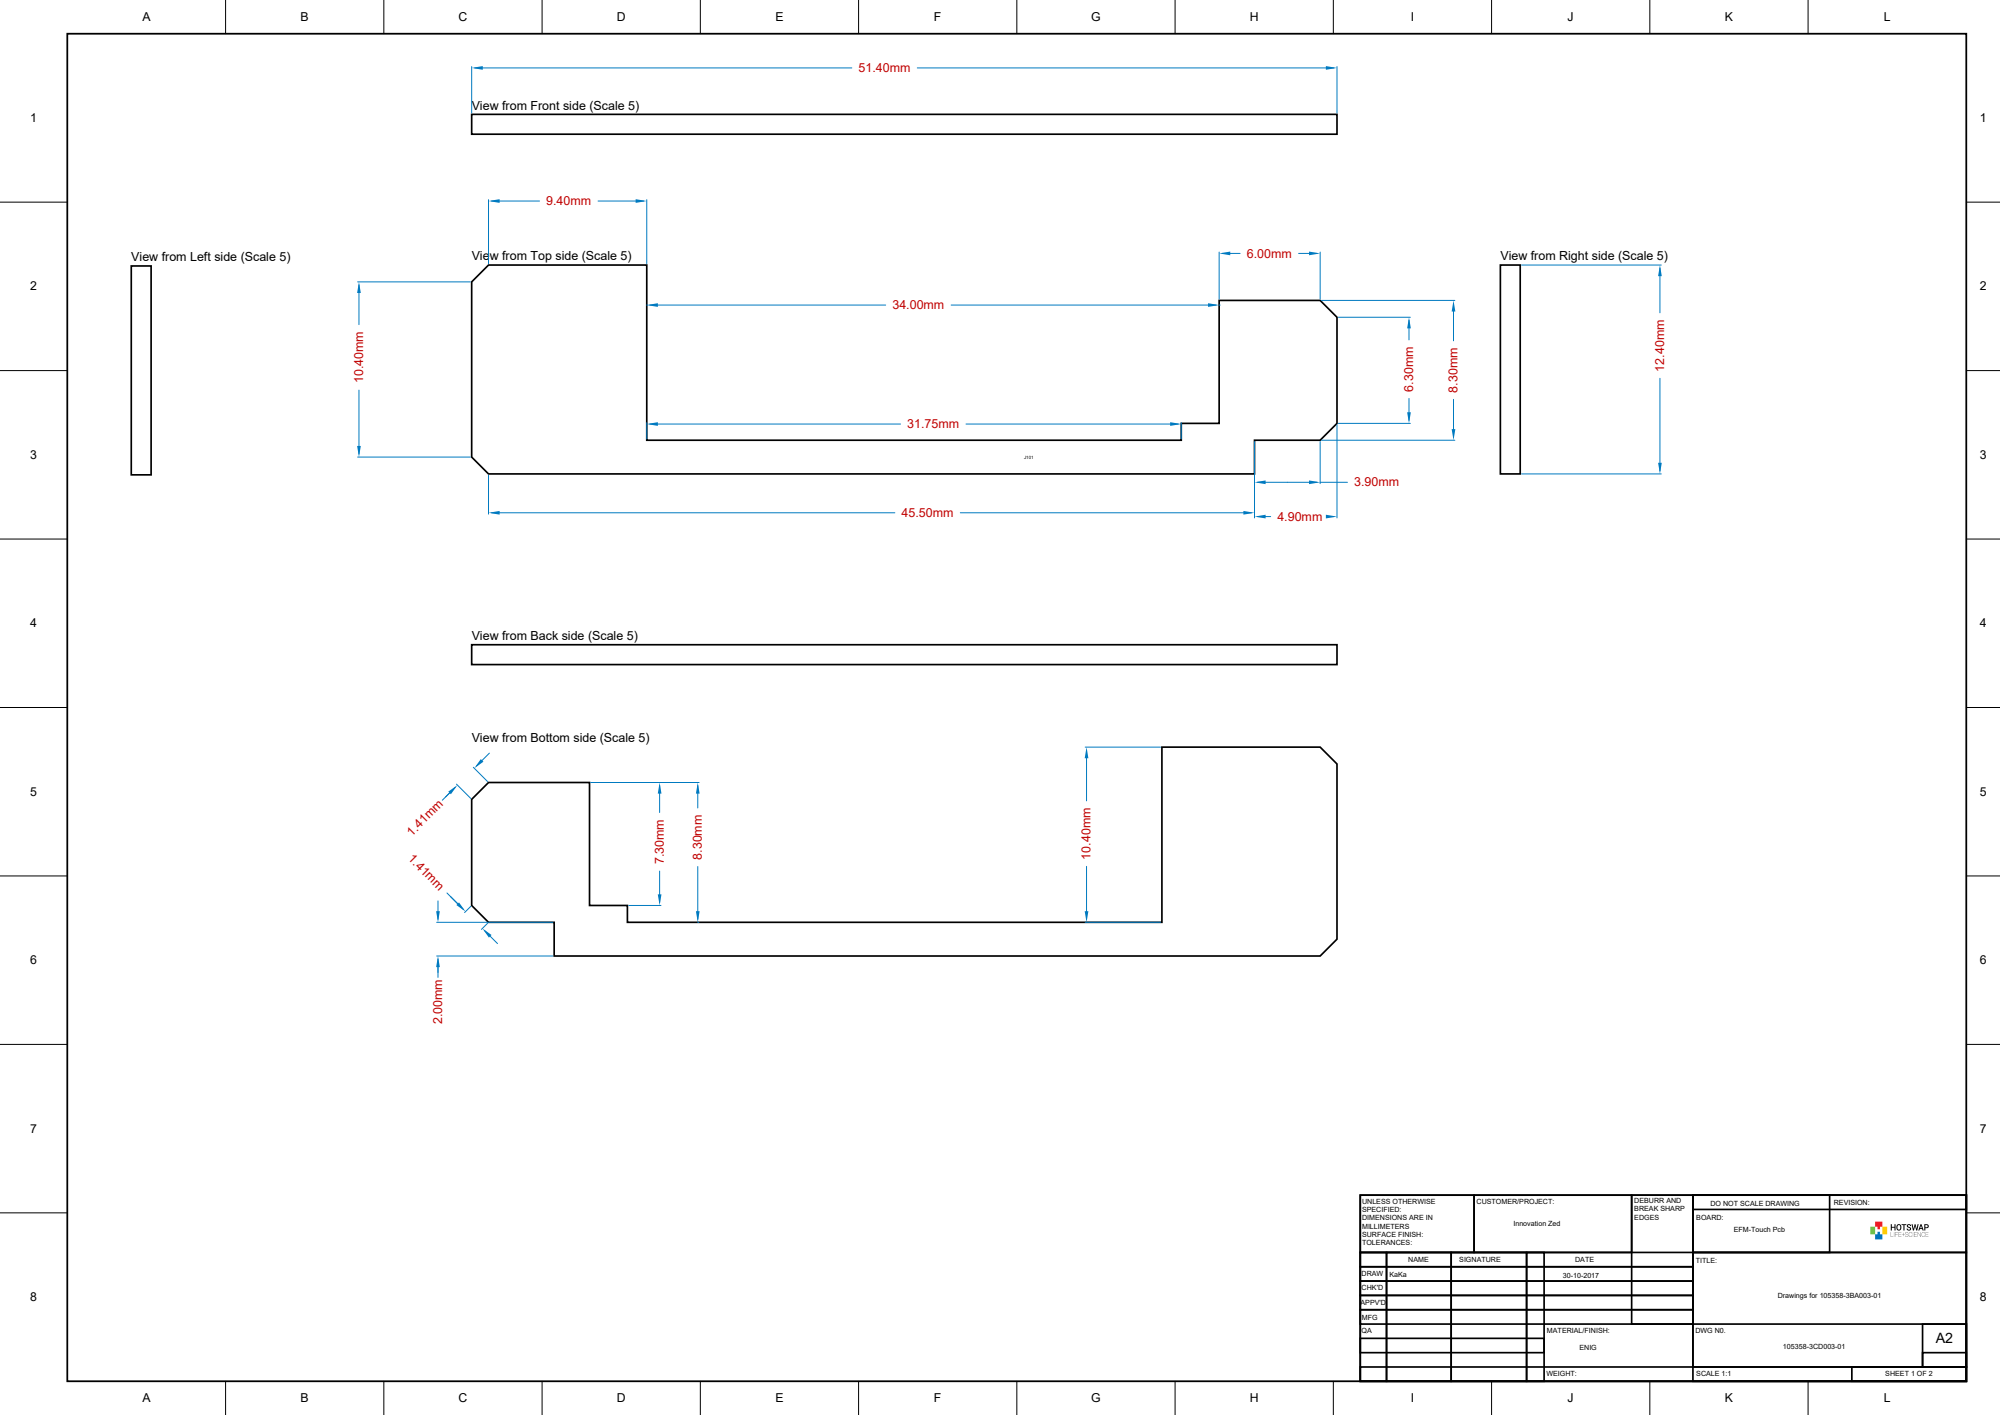
[picture p90: page 1]

View from Front side (Scale 5)

View from Top side (Scale 5)

View from Back side (Scale 5)

View from Bottom side (Scale 5)

UNLESS OTHERWISE SPECIFIED: DIMENSIONS ARE IN MILLIMETERS SURFACE FINISH: TOLERANCES: | CUSTOMER/PROJECT: Innovation Zed | DEBURR AND BREAK SHARP EDGES | DO NOT SCALE DRAWING | REVISION:

BOARD: EFM-Touch Pcb

NAME | SIGNATURE | | DATE | | TITLE: Drawings for 105358-3BA003-01

DRAW | KaKa | | | 30-10-2017
CHK'D

APPV'D
MFG
QA | | | | MATERIAL/FINISH: ENIG | DWG N0. 105358-3CD003-01 | A2

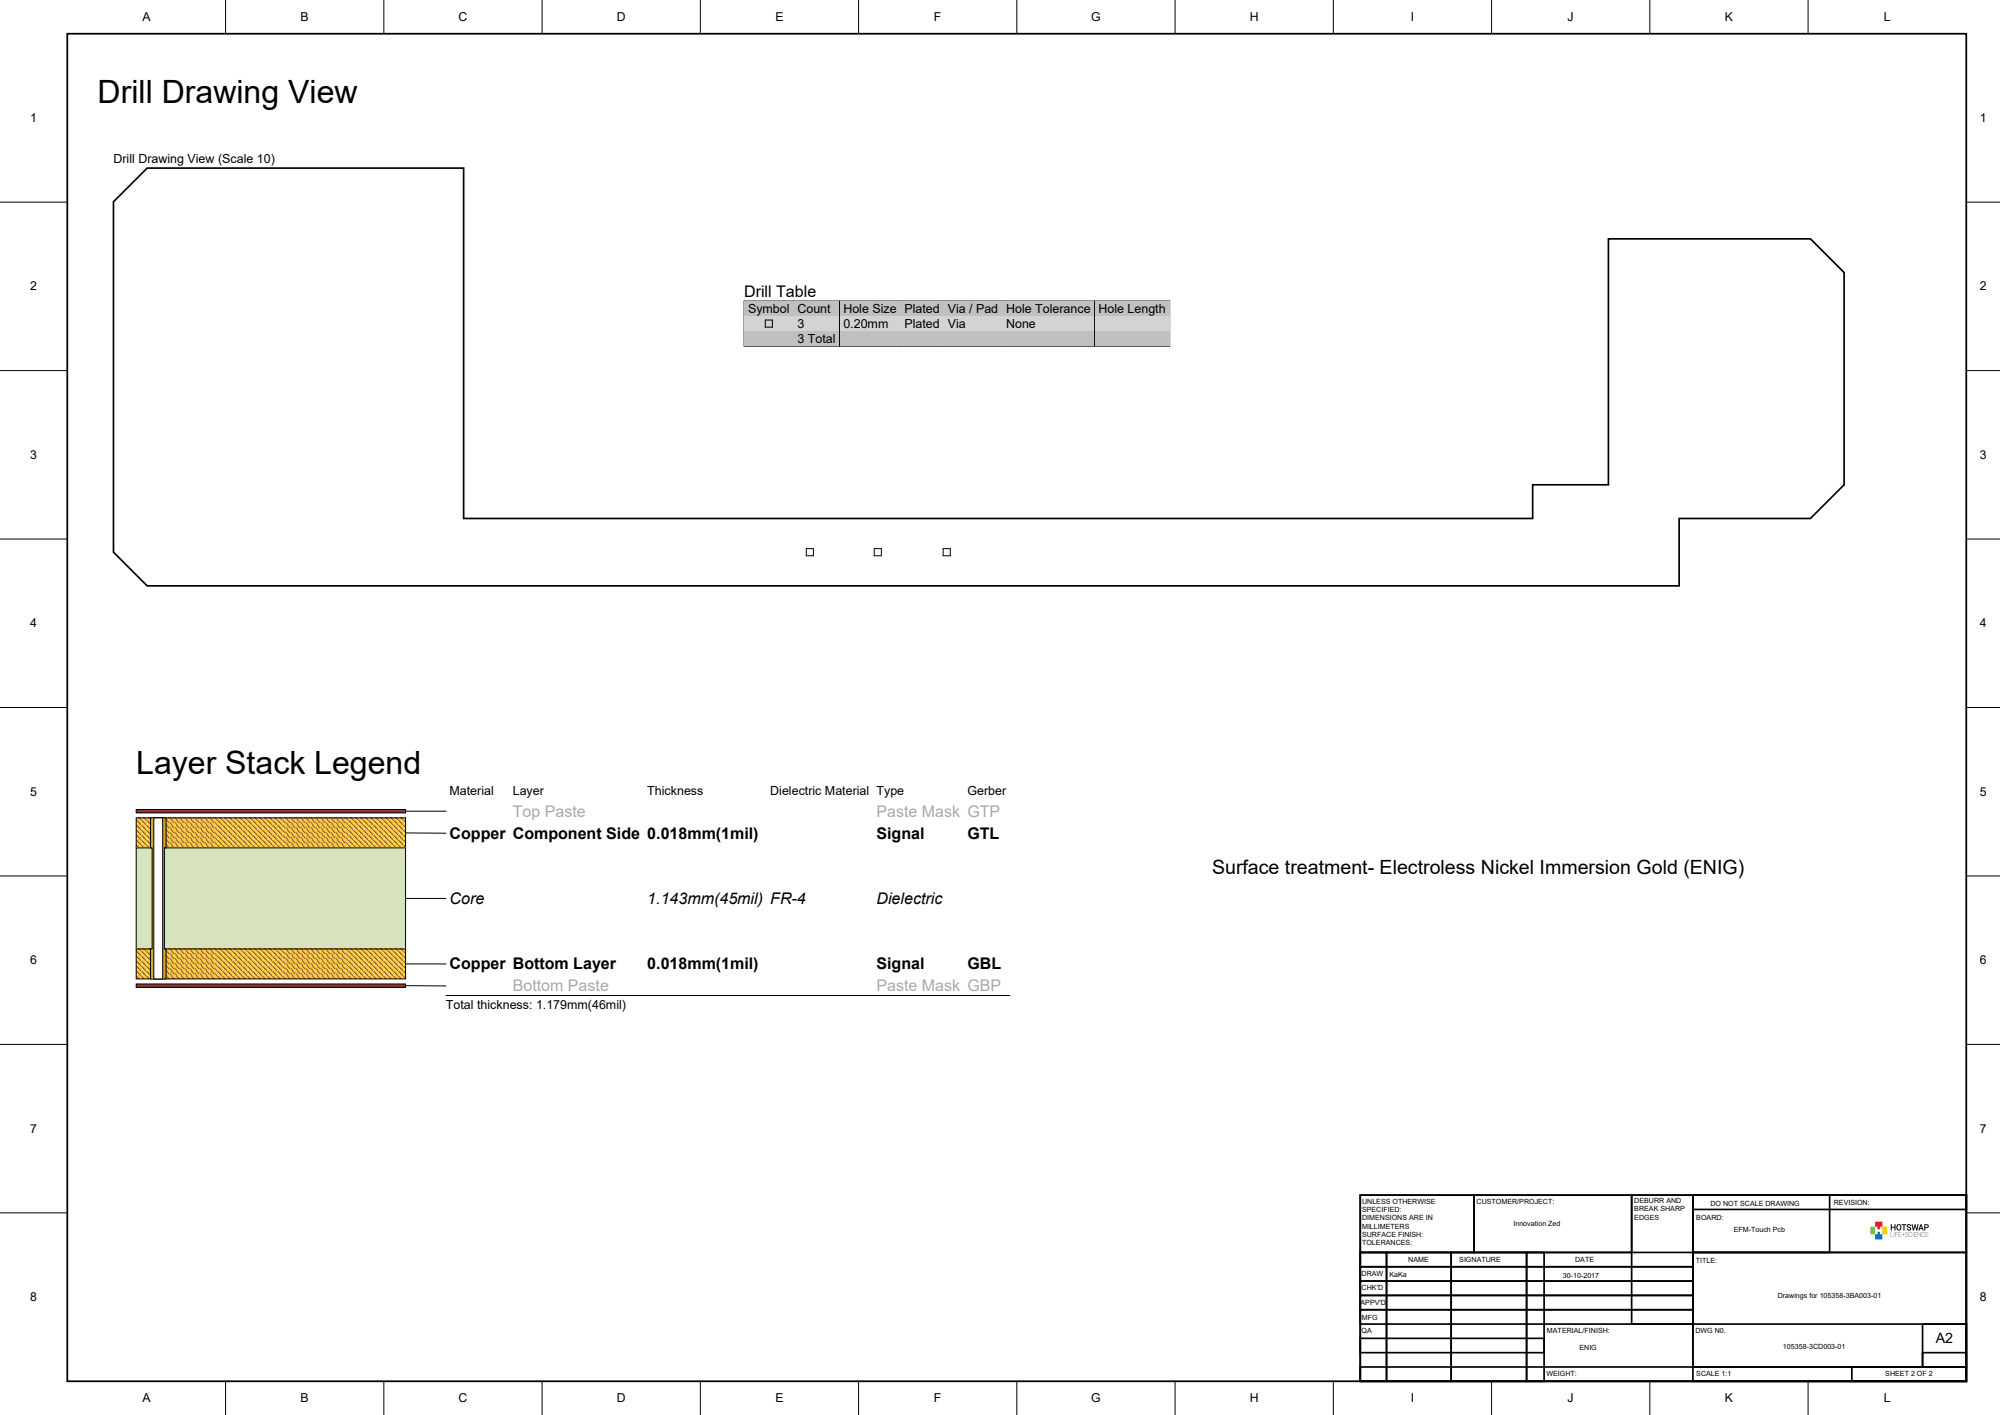
[picture p91: page 2]

Drill Drawing View (Scale 10)

Symbol | Count | Hole Size | Plated | Via / Pad | Hole Tolerance | Hole Length

3 | 0.20mm | Plated | Via | None
3 Total

Surface treatment- Electroless Nickel Immersion Gold (ENIG)

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

BOARD: EFM-Touch Pcb

NAME | SIGNATURE | | DATE | | TITLE: Drawings for 105358-3BA003-01

DRAW | KaKa | | | 30-10-2017
CHK'D

APPV'D
MFG
QA | | | | MATERIAL/FINISH: ENIG | DWG N0. 105358-3CD003-01 | A2
