Engineer1234/ConnectMedical/Connect Medical Boards/EFM1/Project Outputs for 105358-3BA001-01_EFM1/PDF/105358-3SC001-01-B_Schematic_EFM1pdf.PDF

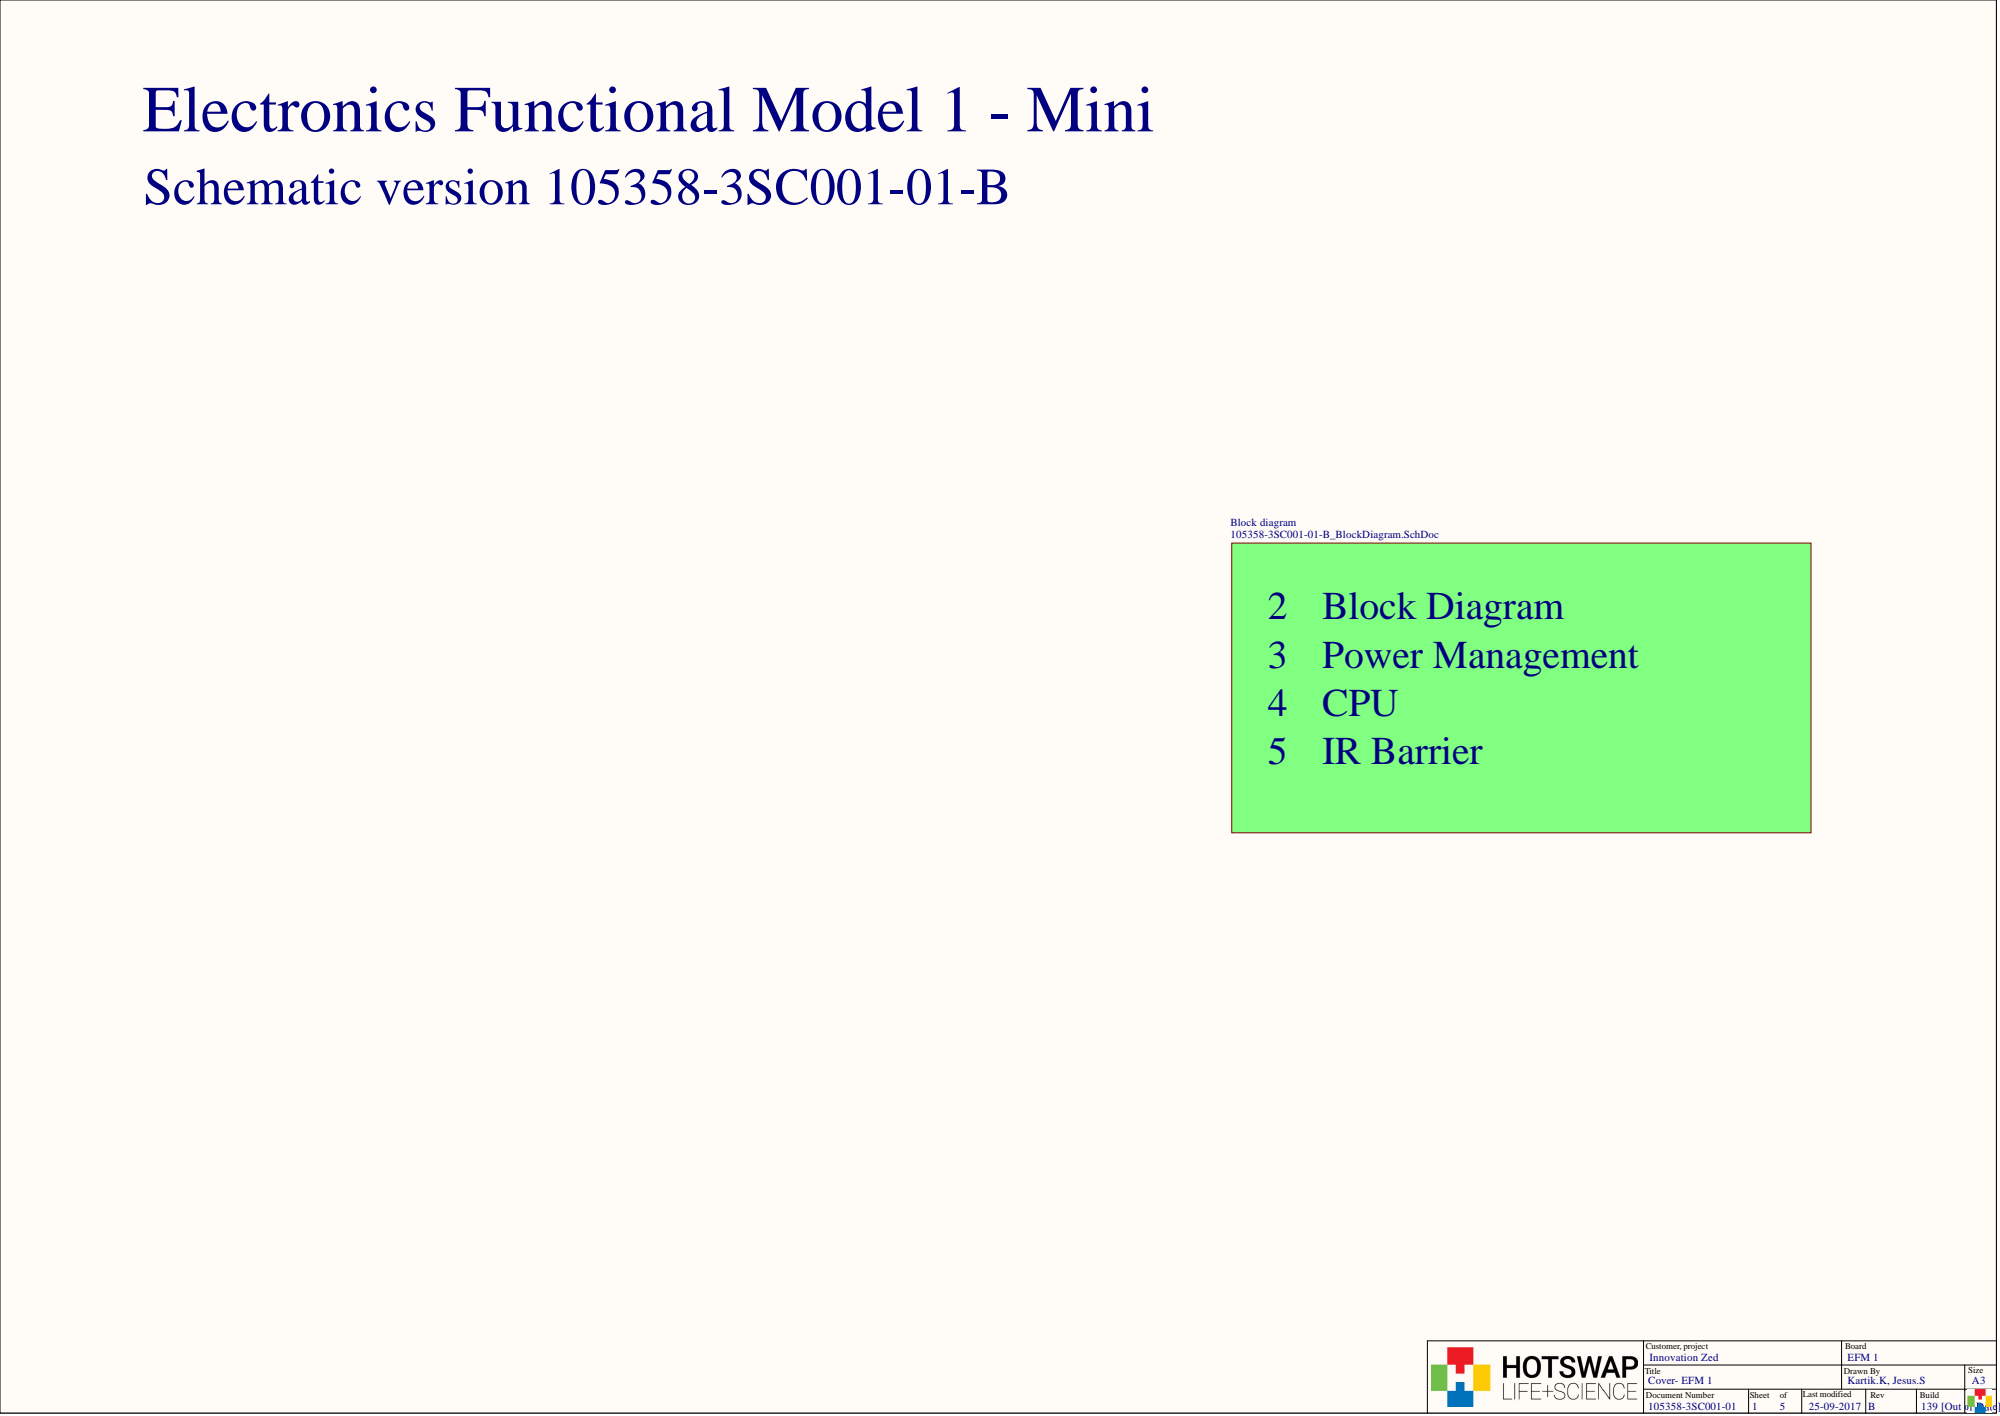
[picture p92: page 1]

Electronics Functional Model 1 - Mini
Schematic version 105358-3SC001-01-B

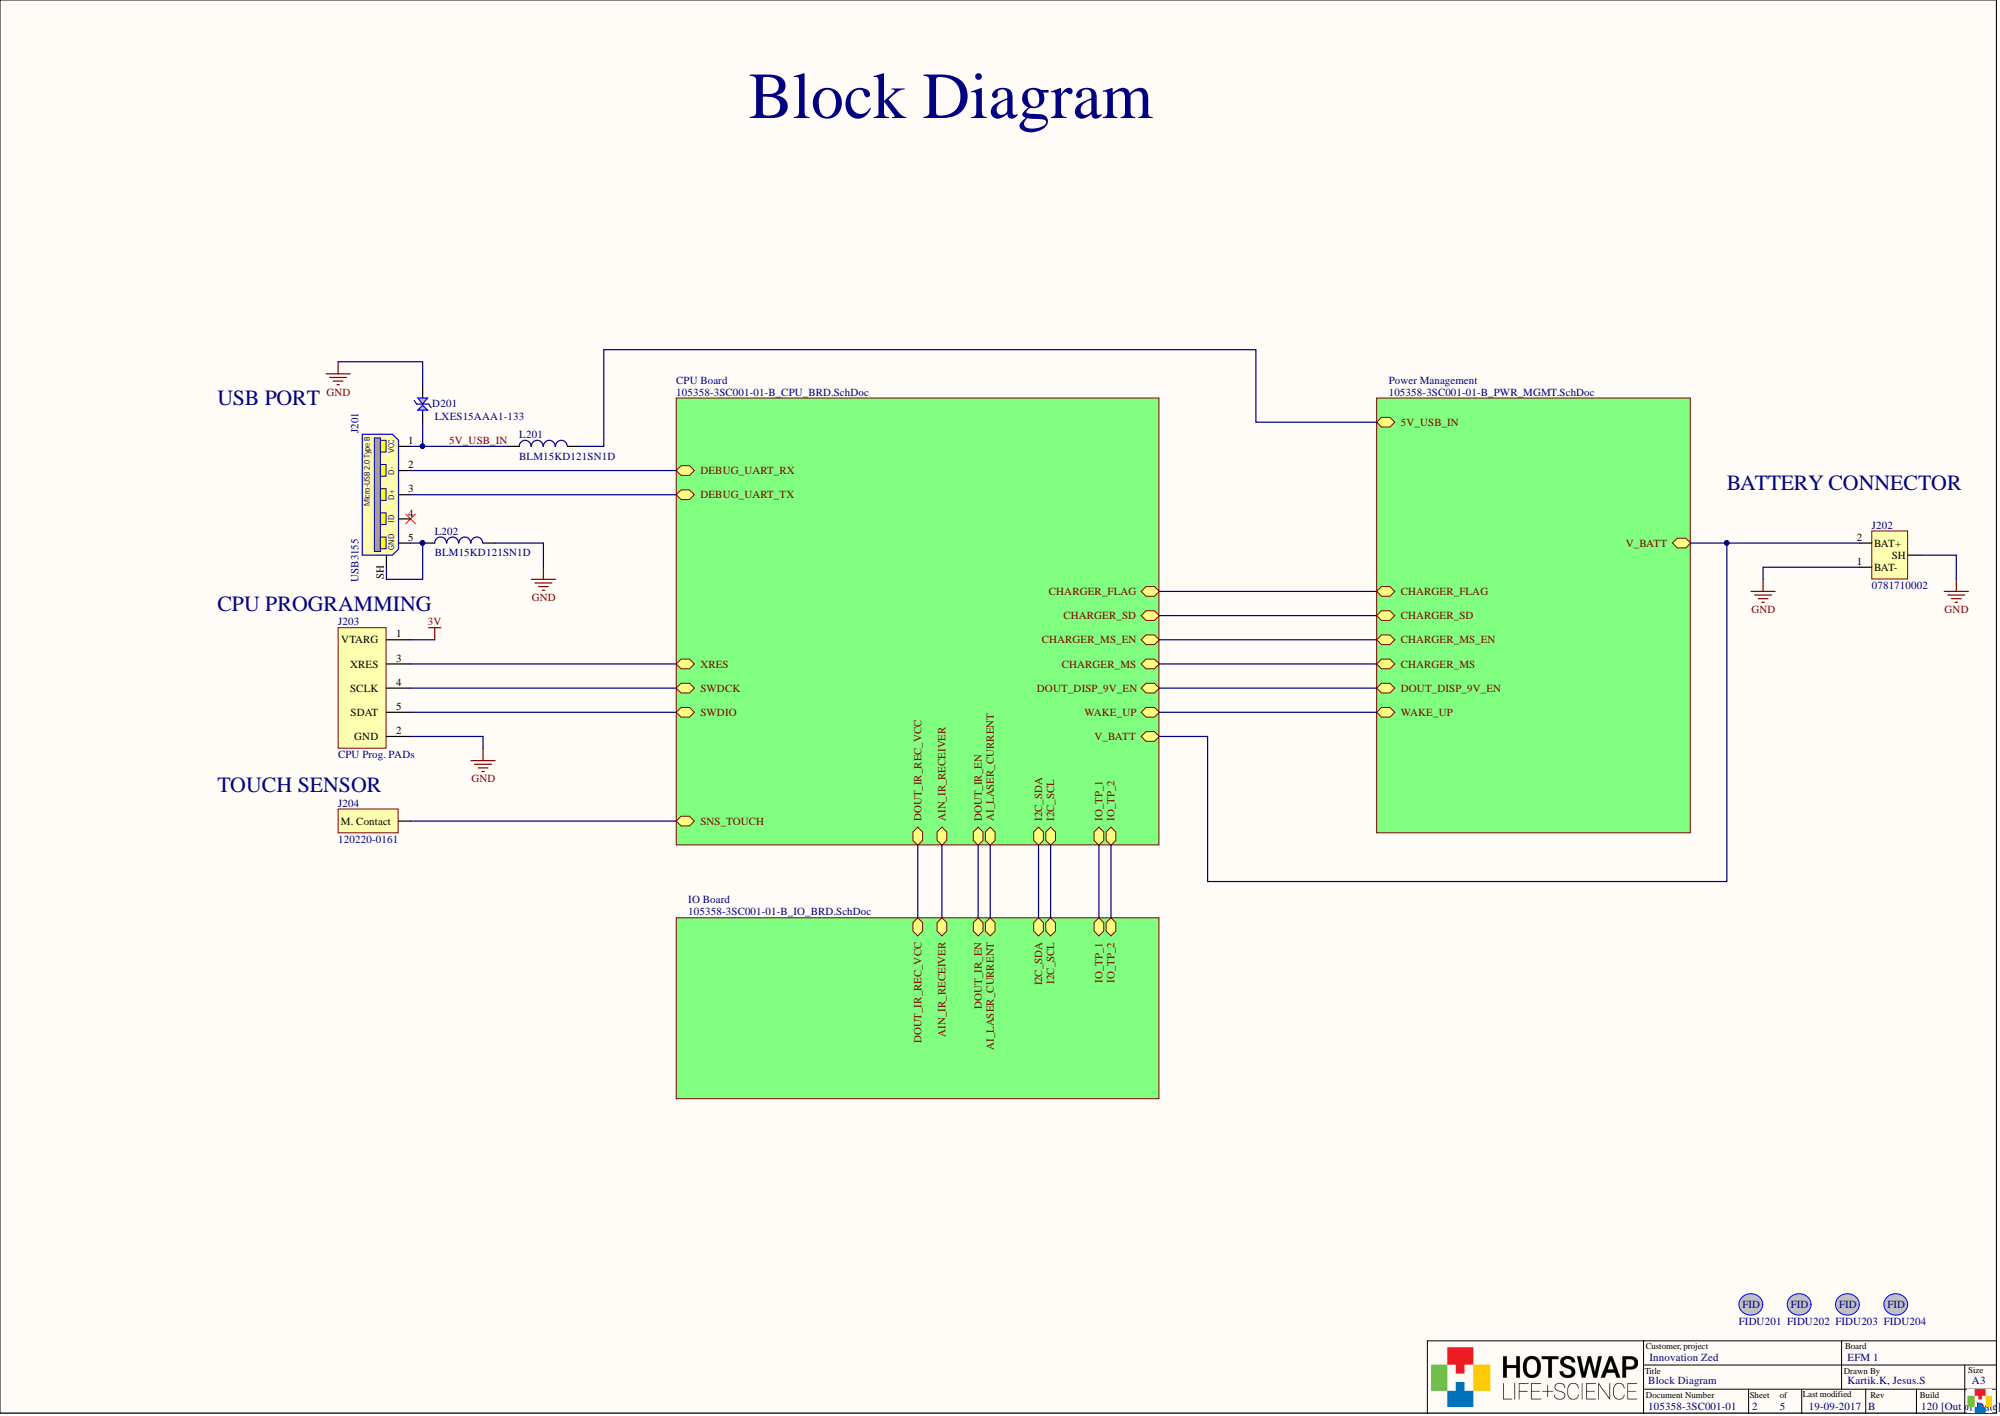
[picture p93: page 2]

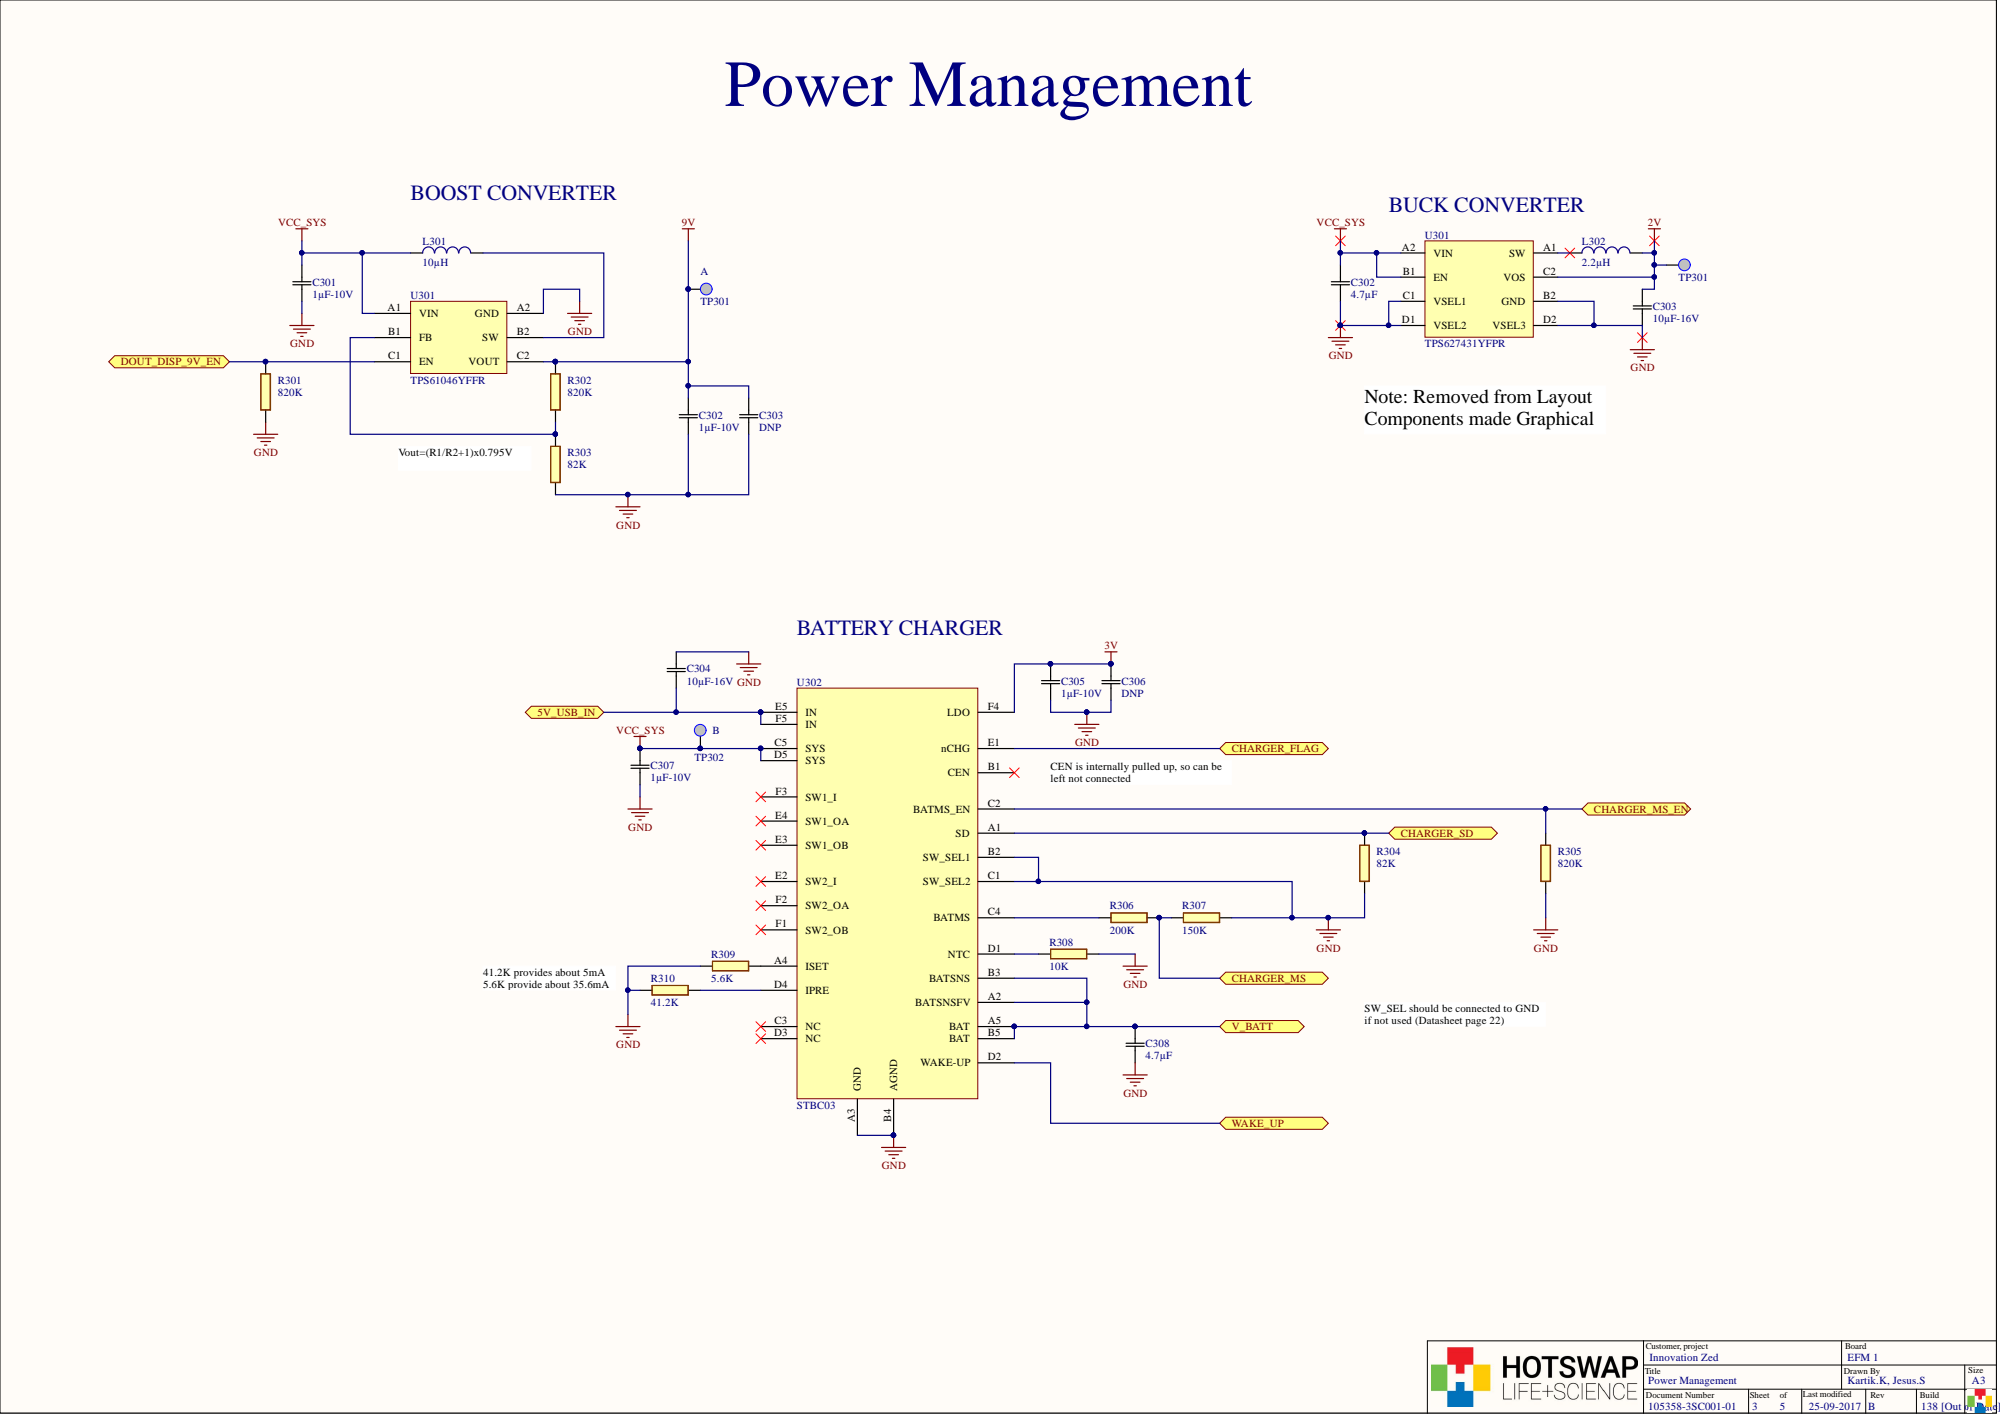
[picture p94: page 3]

BUCK CONVERTER BOOST CONVERTER

Note: Removed from Layout
Components made Graphical

SYS C5

TP302 | SYS D5

CEN is internally pulled up, so can be
left not connected

SW_SEL should be connected to GND
if not used (Datasheet page 22)

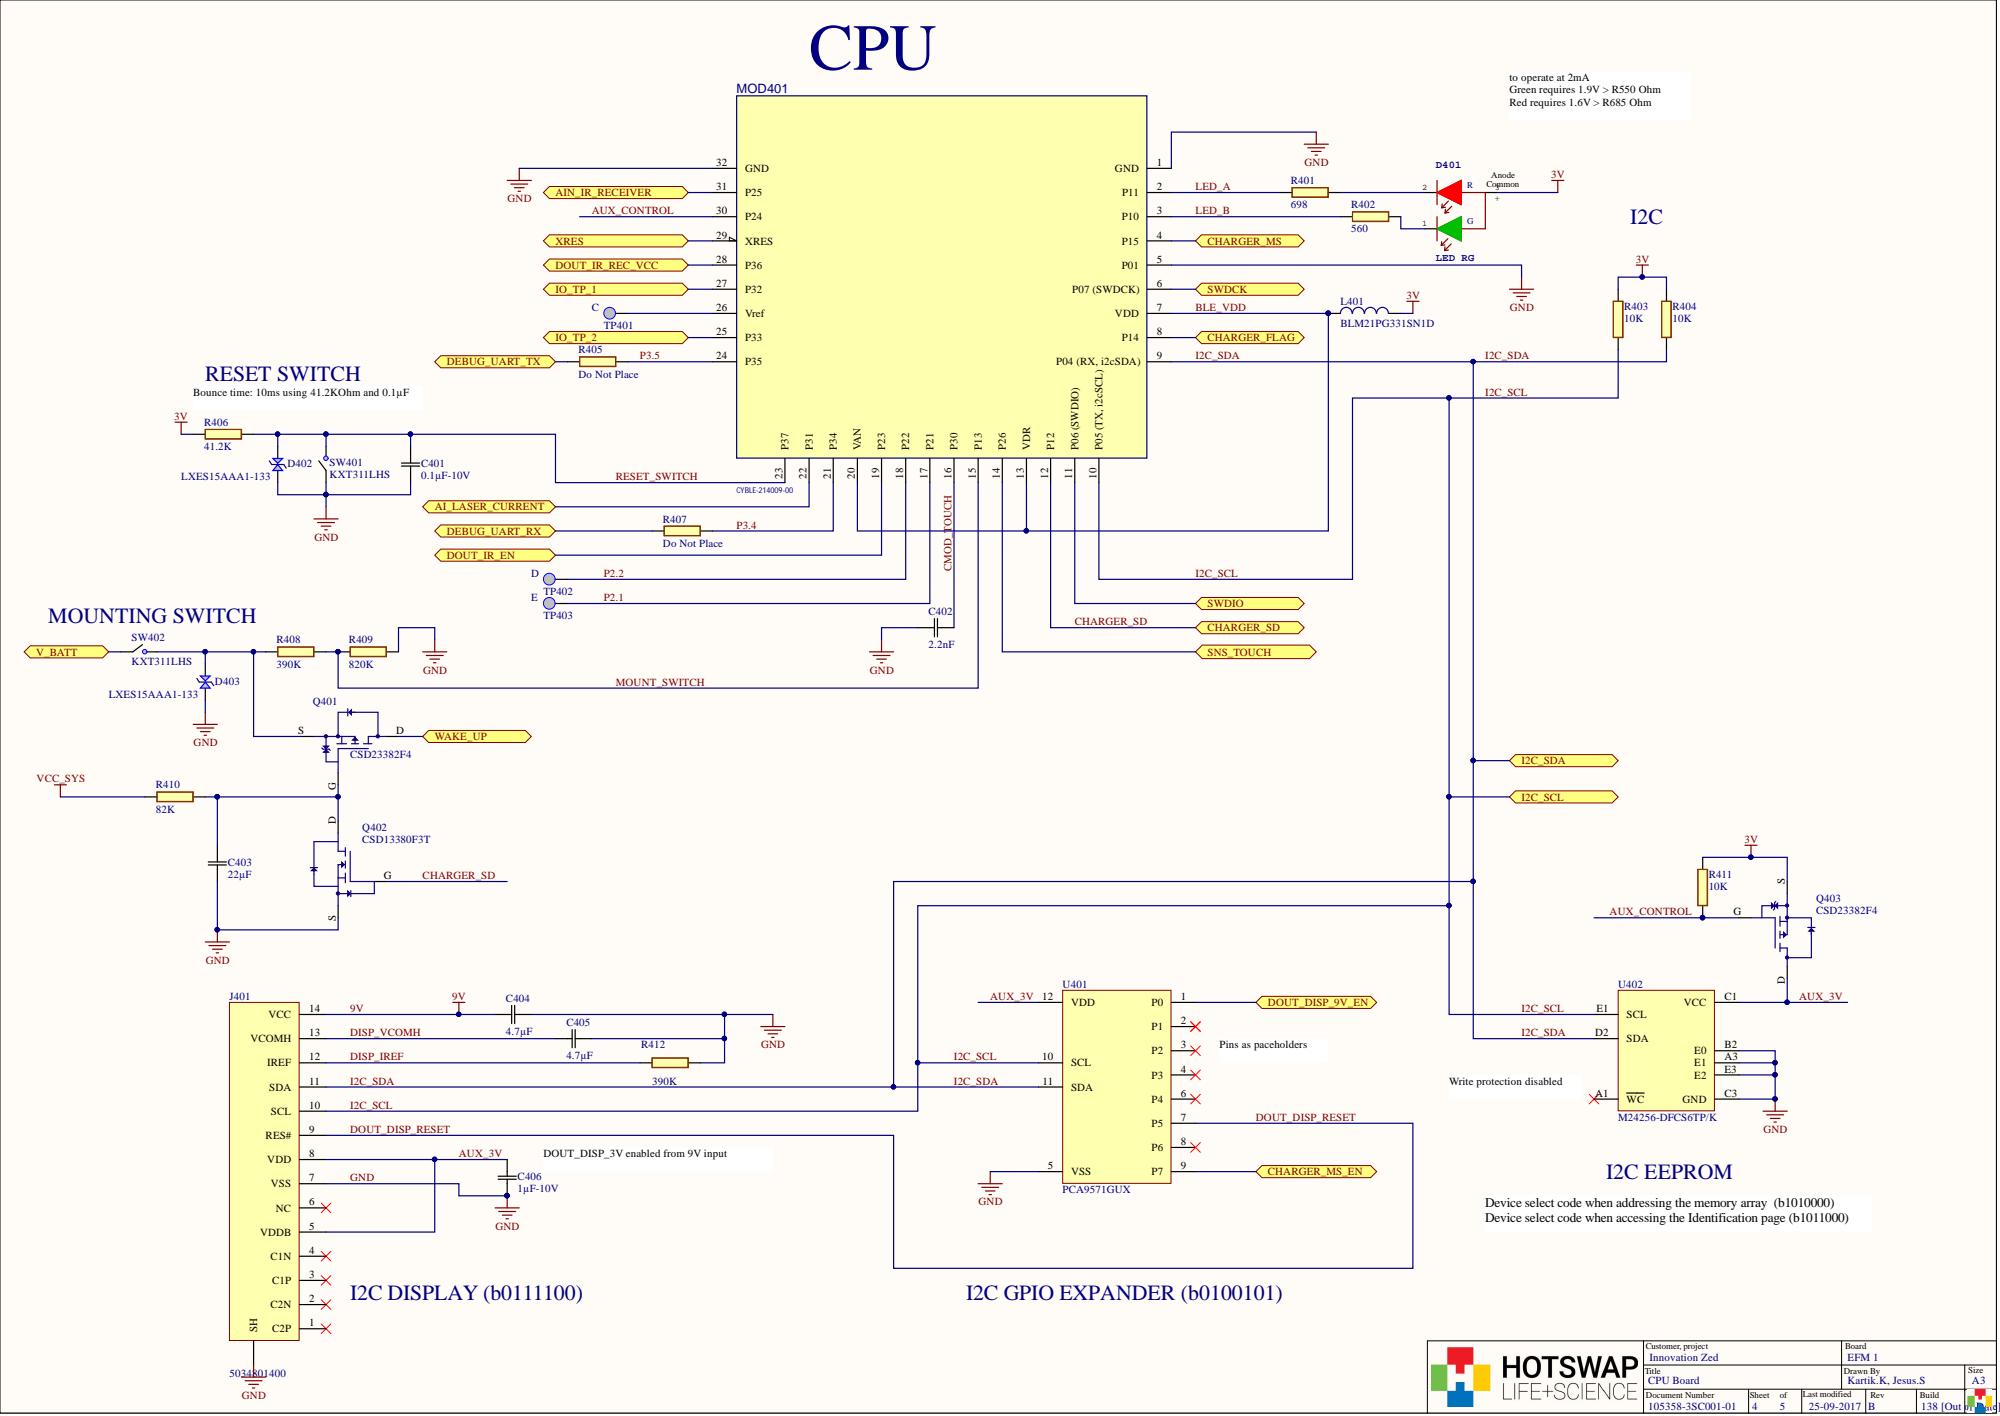
[picture p95: page 4]

I2C_SDA | I2C_SDA

Bounce time: 10ms using 41.2KOhm and 0.1µF

I2C_SCL

C401 0.1µF-10V RESET_SWITCH

CYBLE-214009-00

C402 | | | I2C_SCL

Device select code when addressing the memory array (b1010000)
Device select code when accessing the Identification page (b1011000)

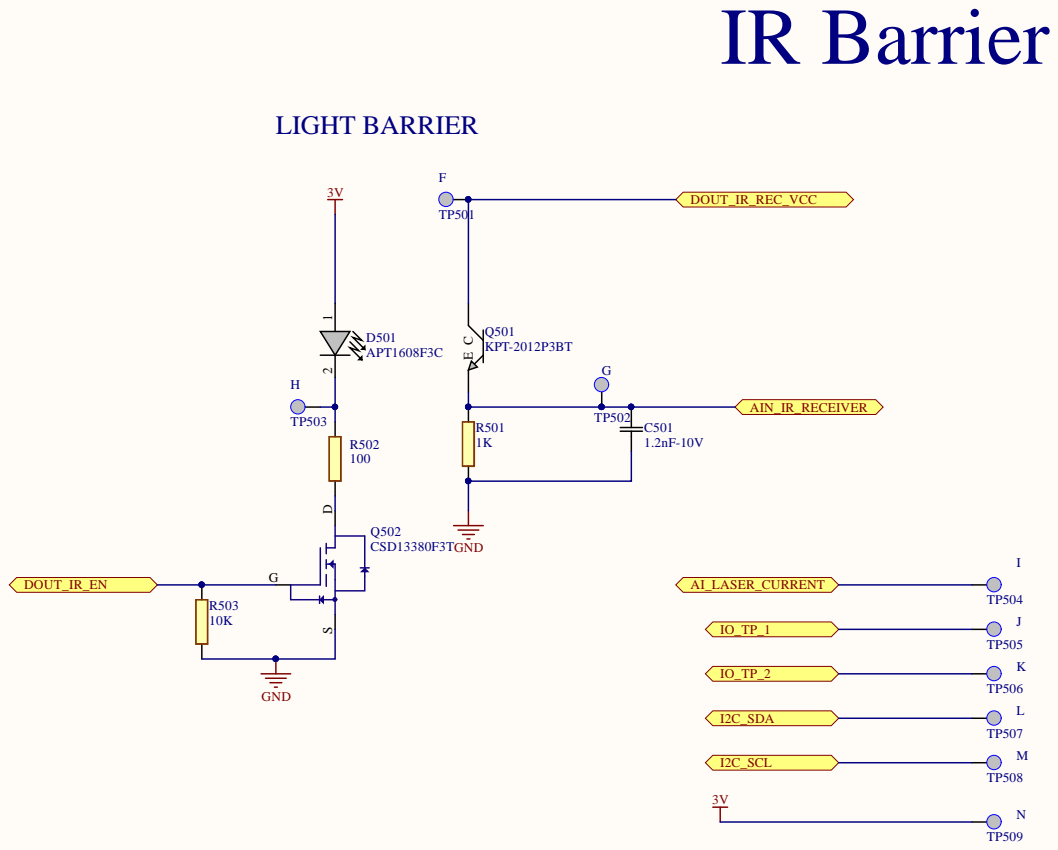
[picture p96: page 5]
