Engineer1234/ConnectMedical/Connect Medical Boards/EFM1/Project Outputs for 105358-3BA001-01_EFM1/PDF/105358-3CD001-01 Assembly Drawing.PDF

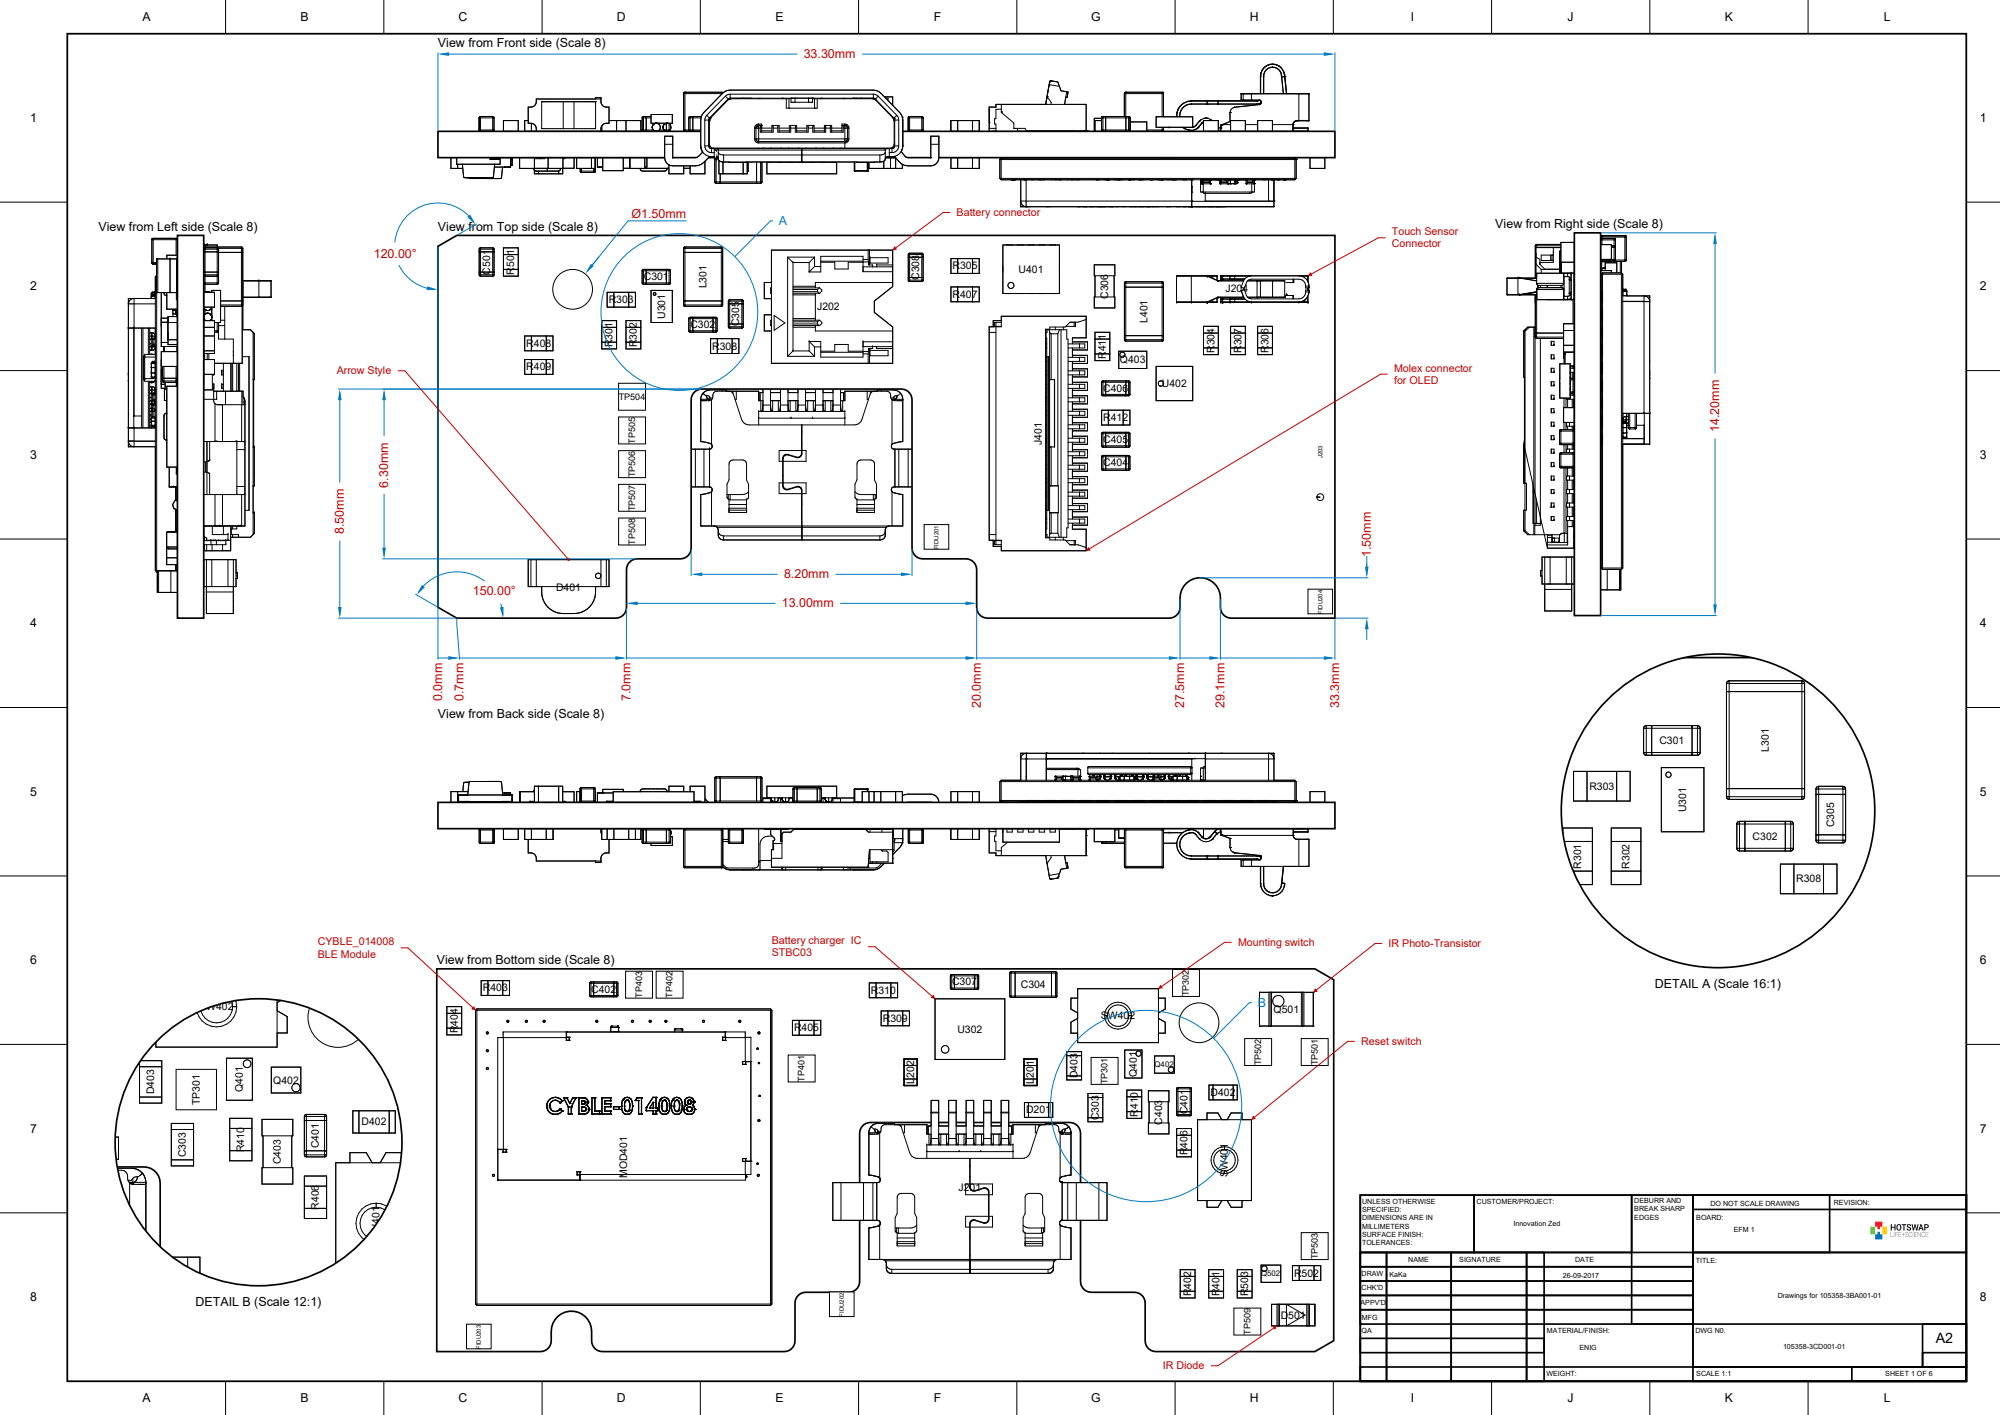
[picture p97: page 1]

View from Front side (Scale 8)

View from Back side (Scale 8)

View from Bottom side (Scale 8)

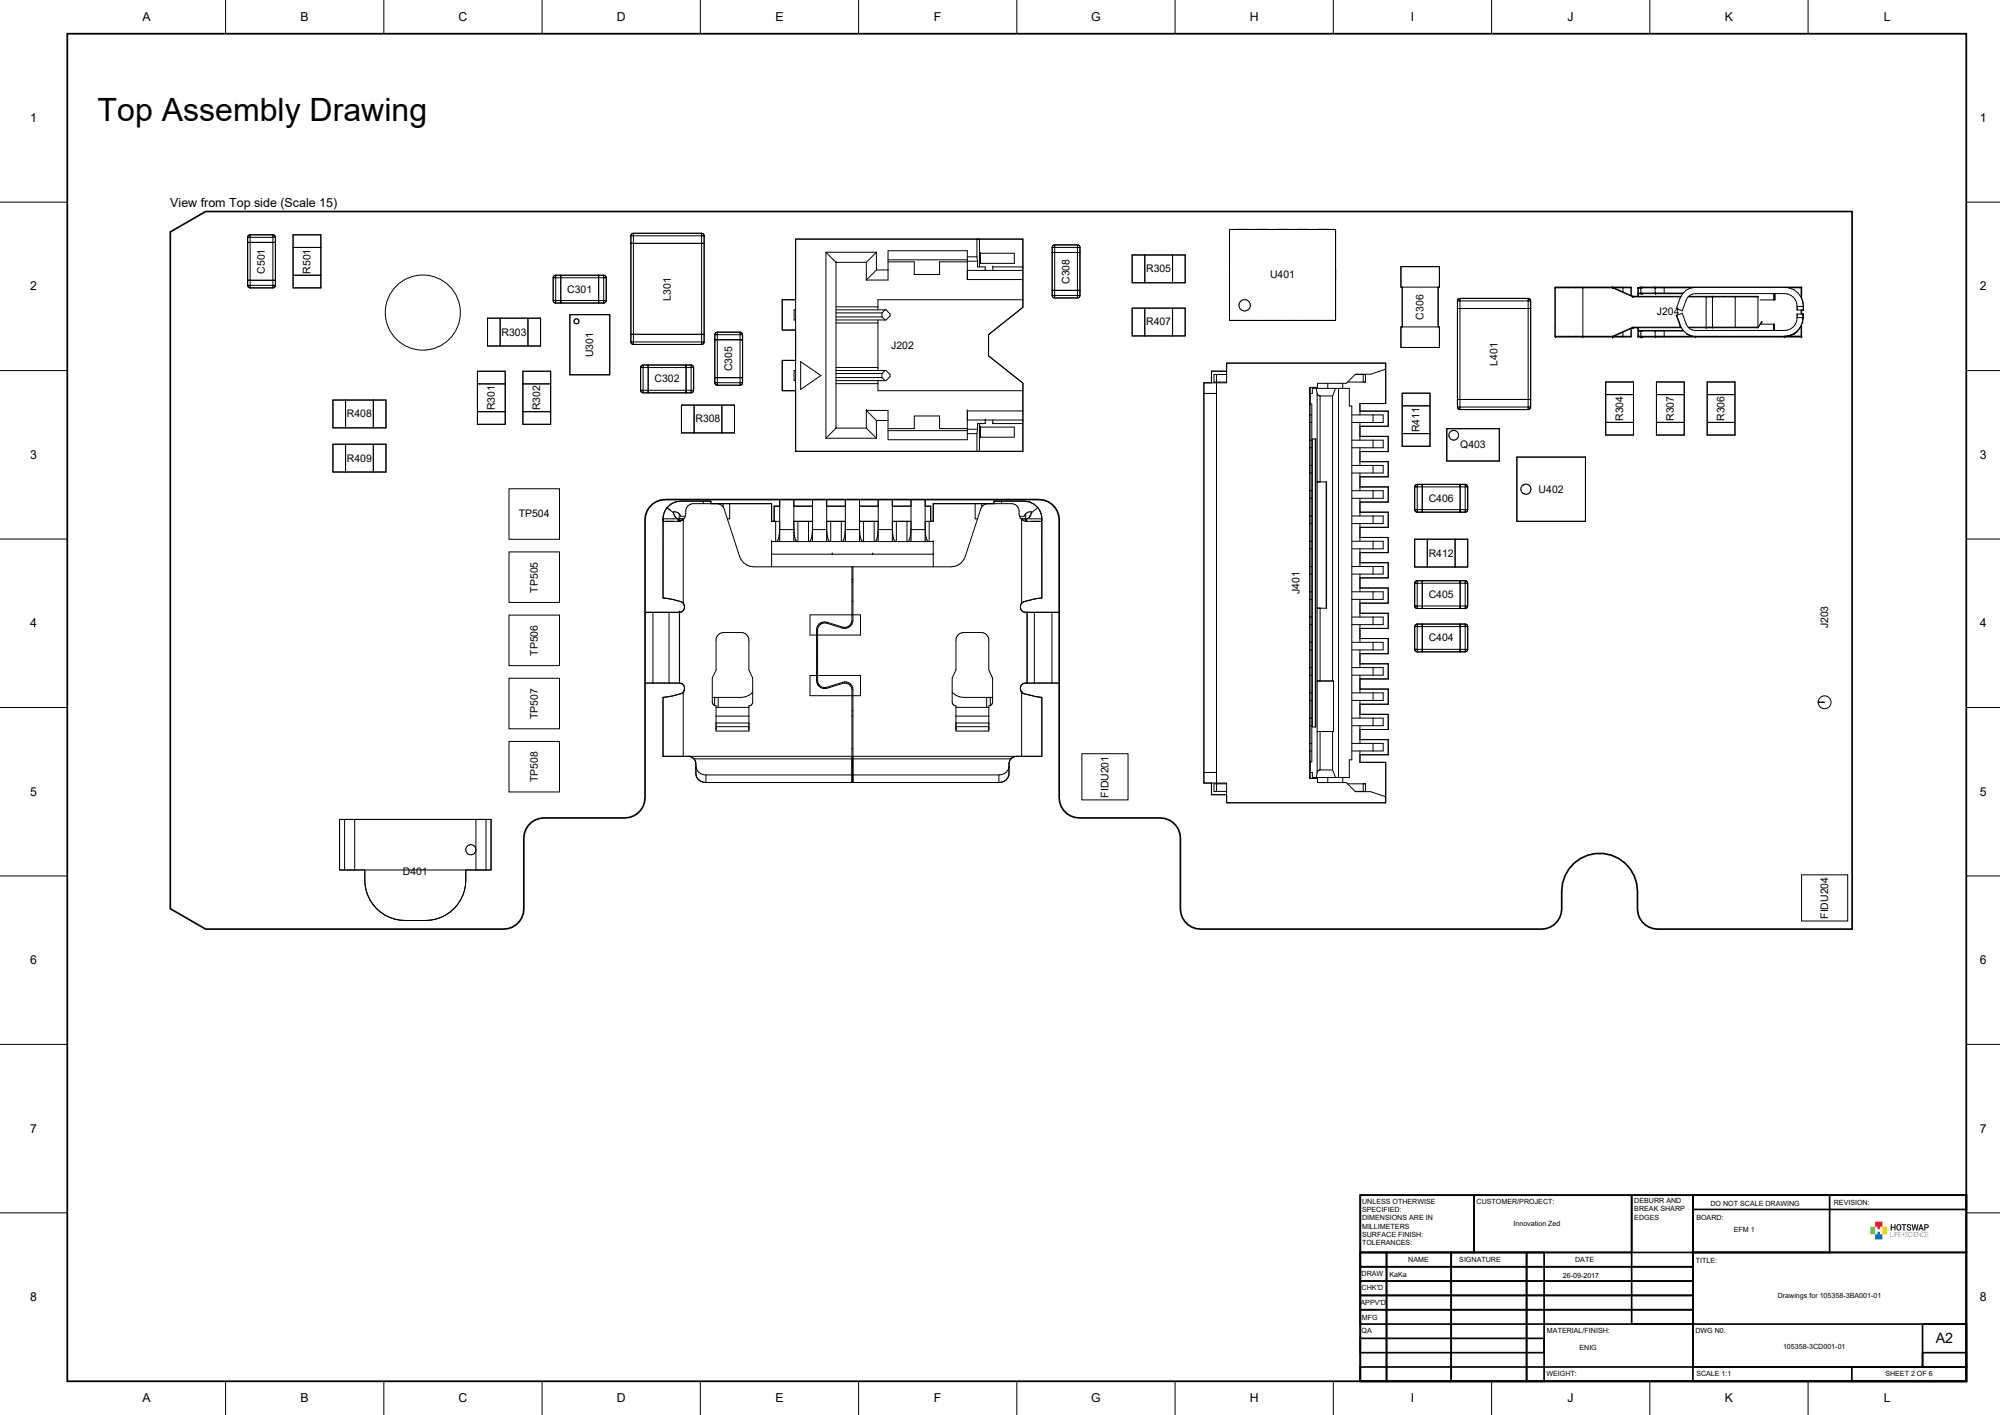
[picture p98: page 2]

View from Top side (Scale 15)

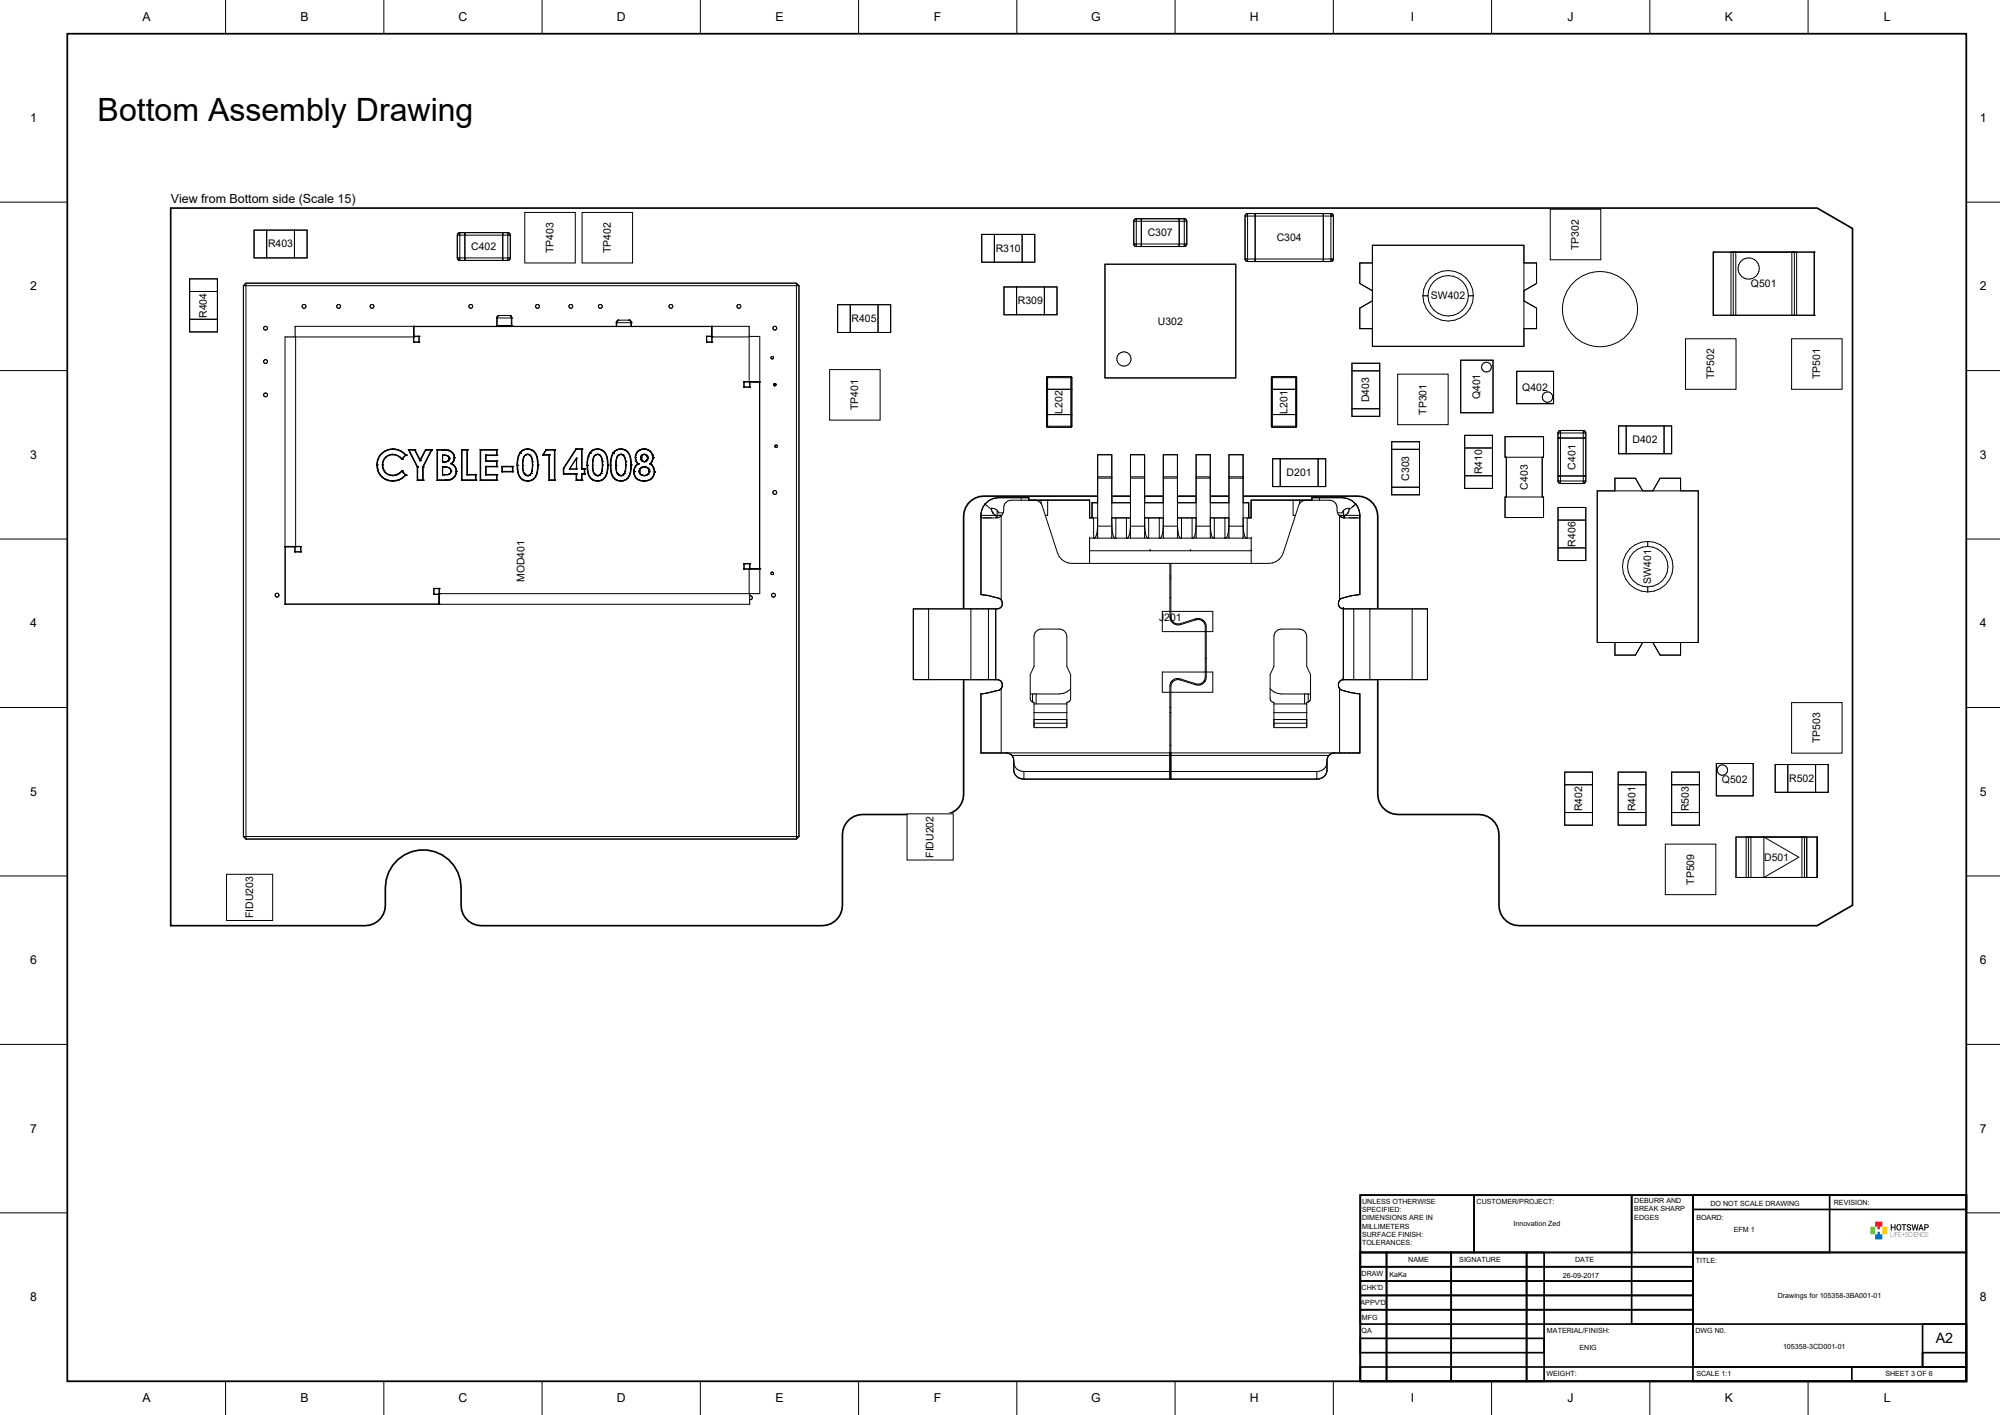
[picture p99: page 3]

View from Bottom side (Scale 15)

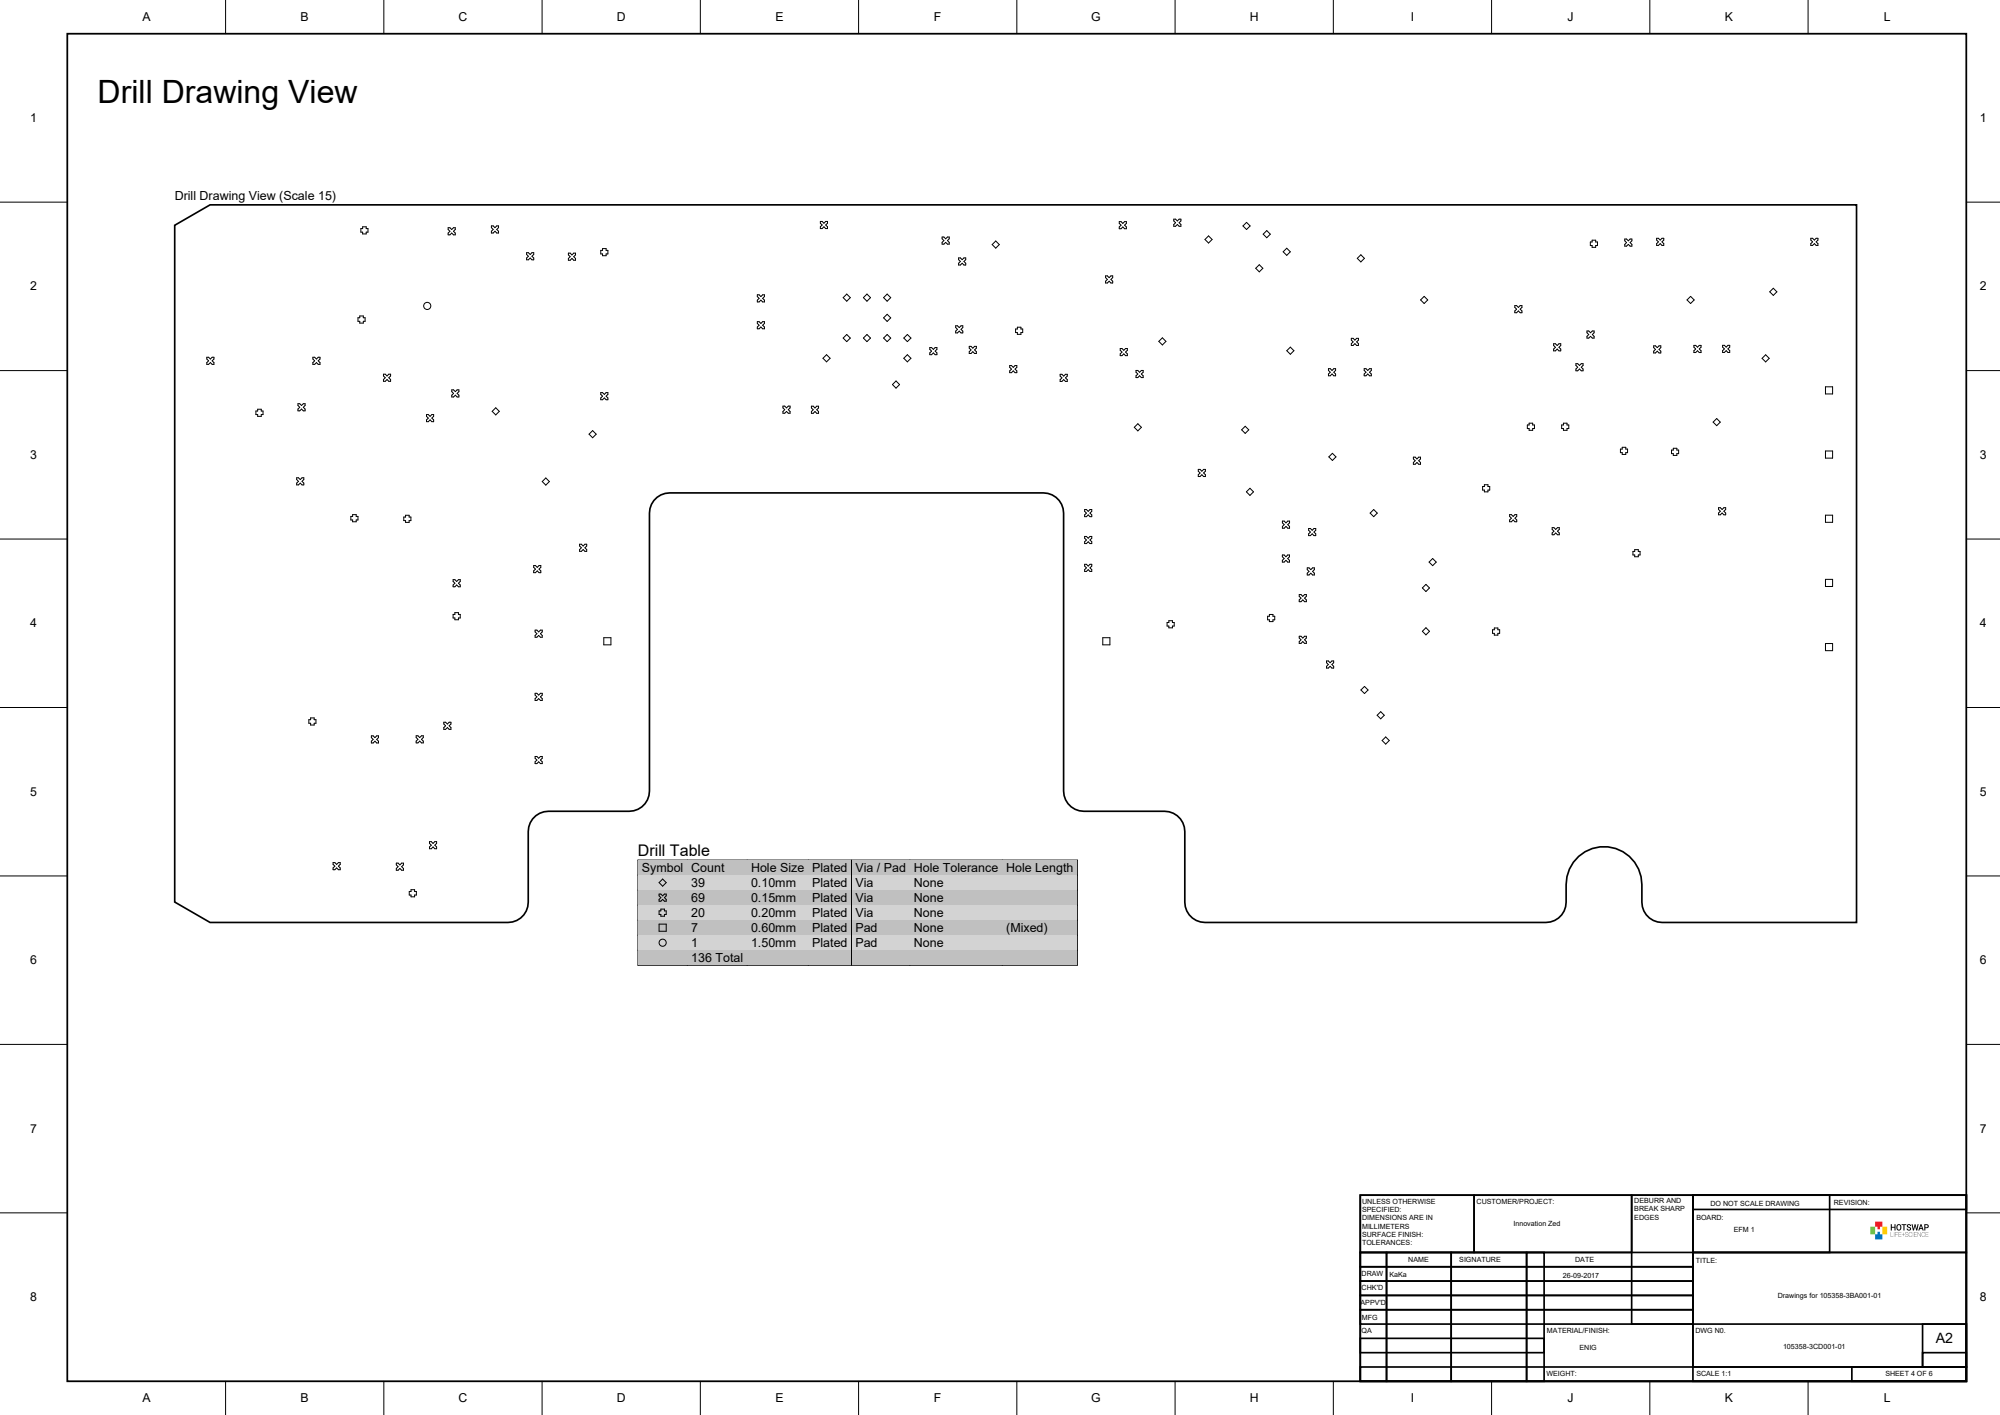
[picture p100: page 4]

Drill Drawing View (Scale 15)

Symbol | Count | Hole Size | Plated | Via / Pad | Hole Tolerance | Hole Length

39 | 0.10mm | Plated | Via | None
69 | 0.15mm | Plated | Via | None
20 | 0.20mm | Plated | Via | None
7 | 0.60mm | Plated | Pad | None | (Mixed)
1 | 1.50mm | Plated | Pad | None
136 Total

UNLESS OTHERWISE SPECIFIED: DIMENSIONS ARE IN MILLIMETERS SURFACE FINISH: TOLERANCES: | CUSTOMER/PROJECT: Innovation Zed | DEBURR AND BREAK SHARP EDGES | DO NOT SCALE DRAWING | REVISION:

BOARD: EFM 1

NAME | SIGNATURE | | DATE | TITLE:

DRAW | KaKa | | | 26-09-2017
CHK'D

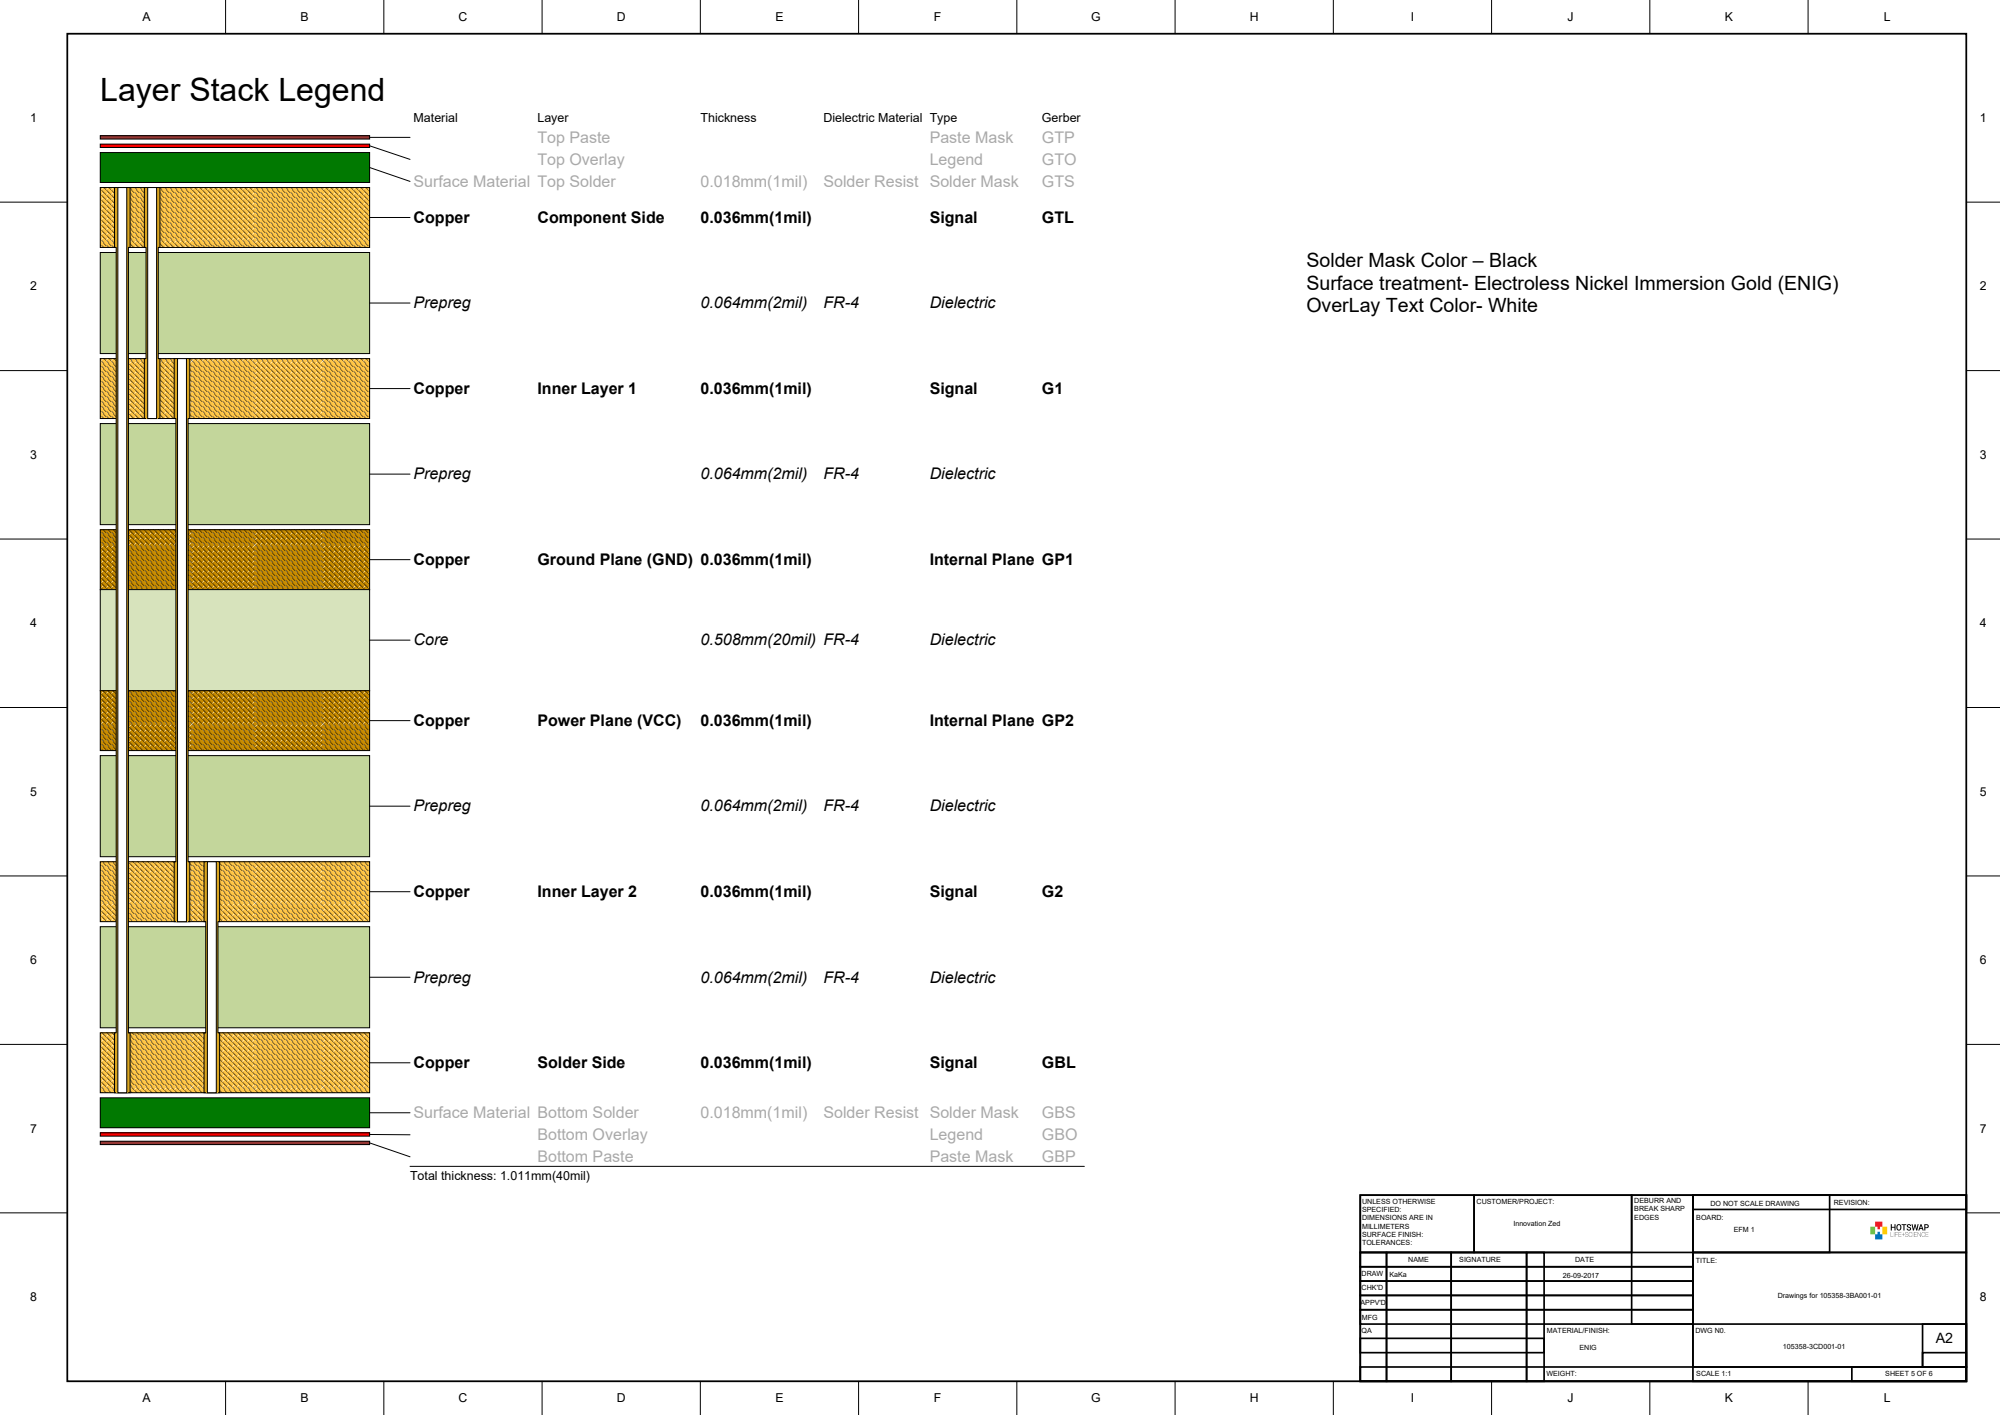
[picture p101: page 5]

Solder Mask Color – Black
Surface treatment- Electroless Nickel Immersion Gold (ENIG)
OverLay Text Color- White

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

BOARD: EFM 1

NAME | SIGNATURE | | DATE | TITLE:

DRAW | KaKa | | | 26-09-2017
CHK'D

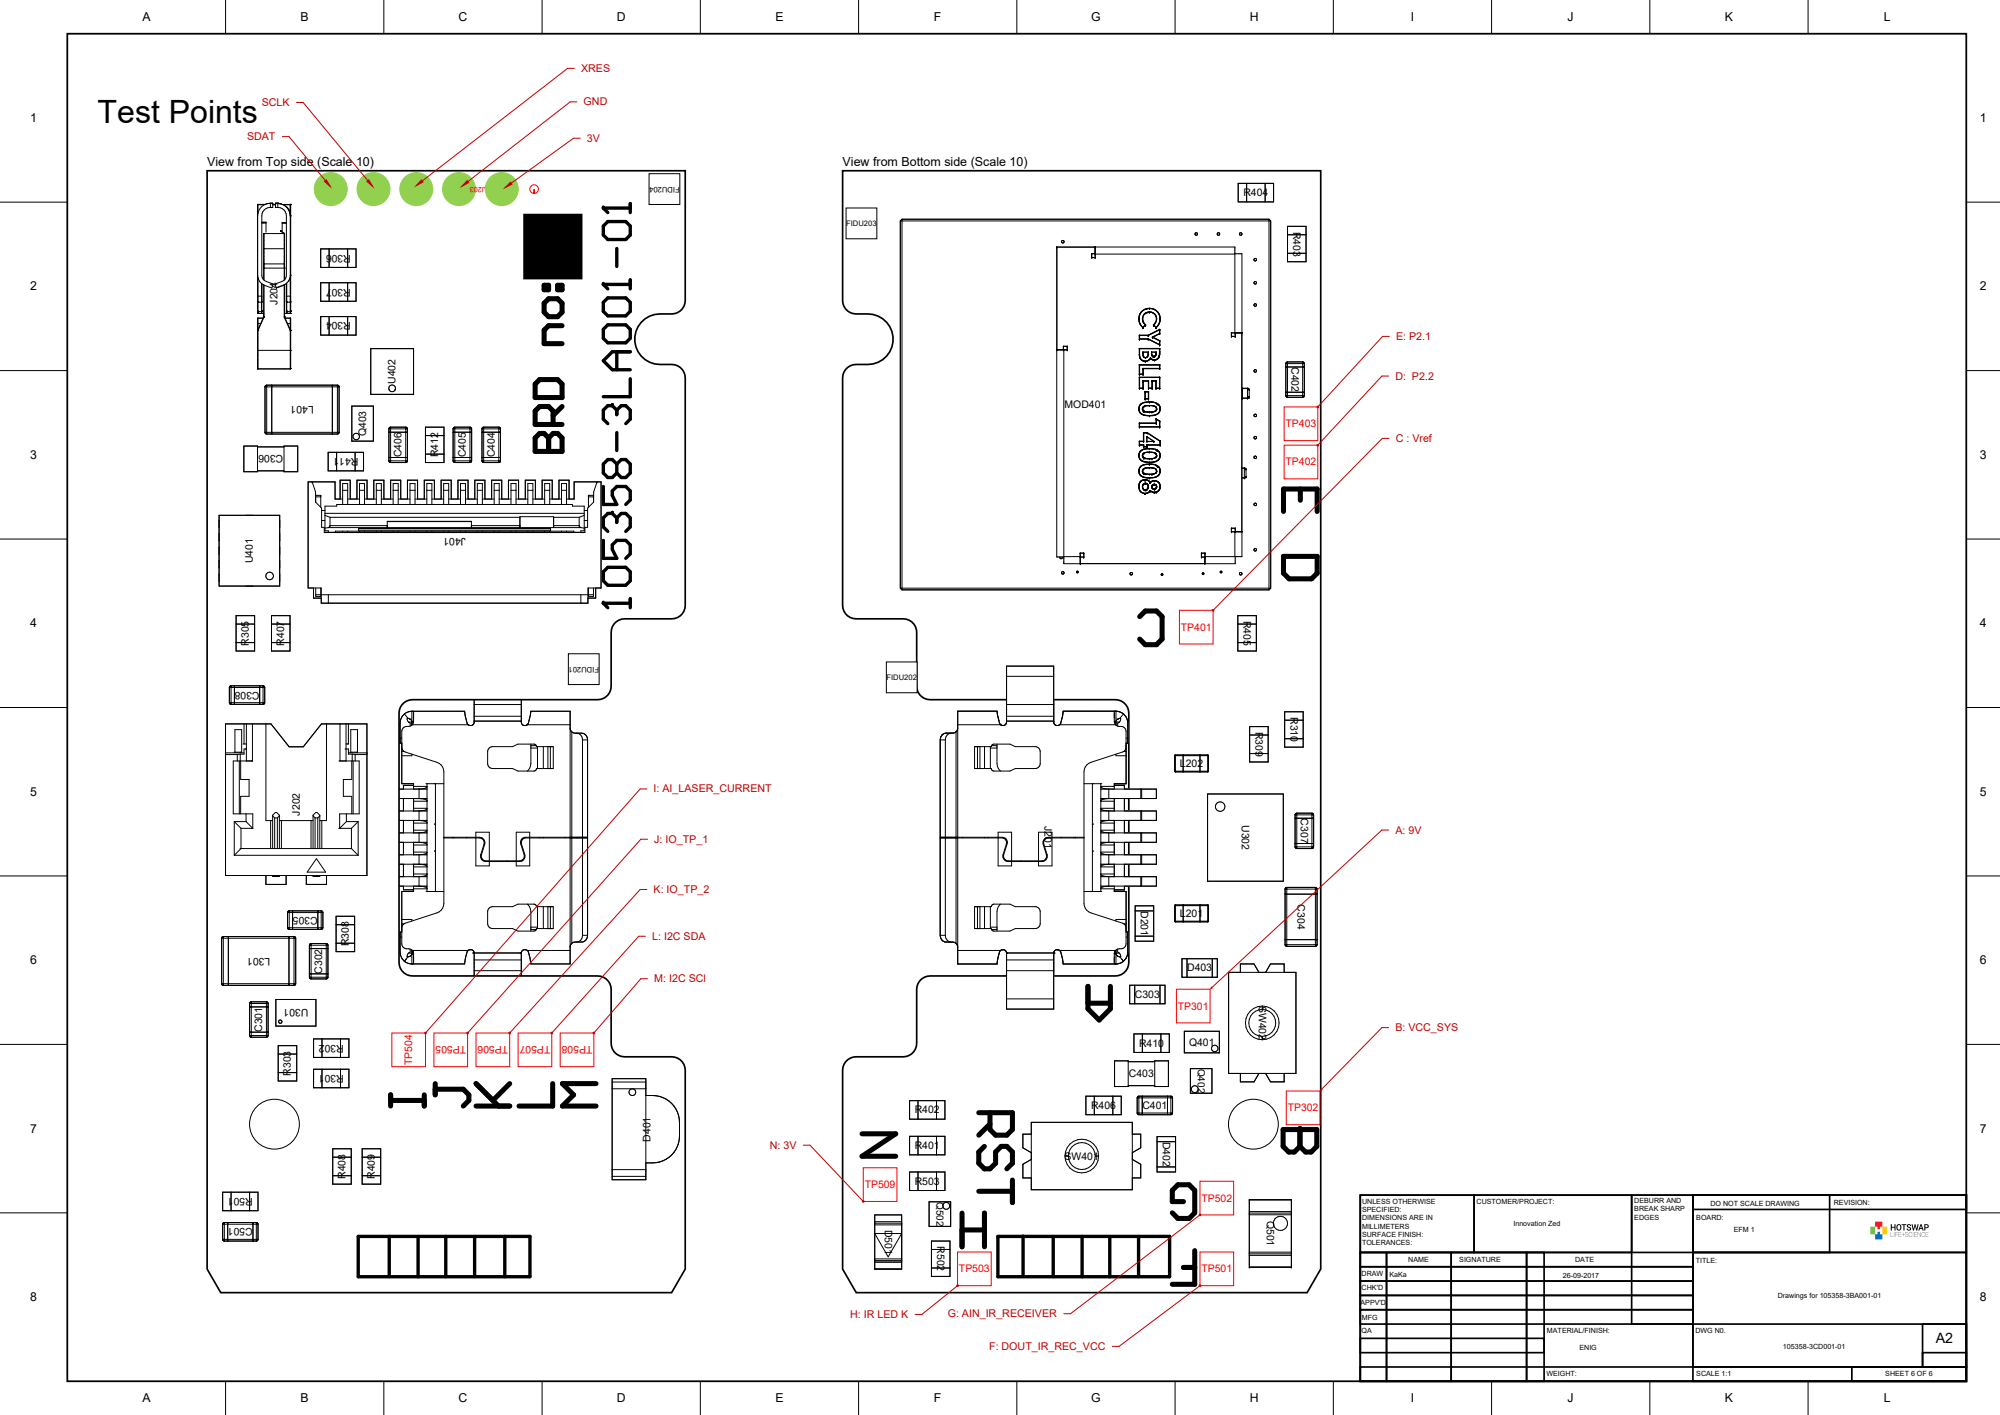
[picture p102: page 6]

SDAT
View from Top side (Scale 10)

View from Bottom side (Scale 10)
