Engineer1234/ConnectMedical/Connect Medical Boards/FP1/Project Outputs for 105358-3BA001-03_FP1/PDF/105358-3LA001-03_PCB_EFP1.PDF

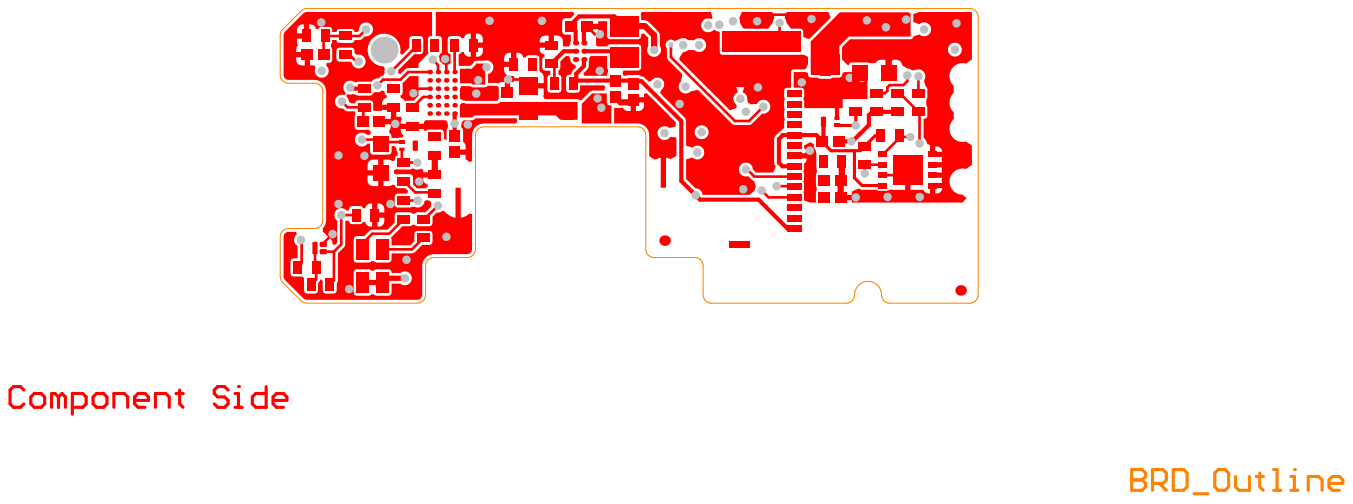
[picture p103: page 1]

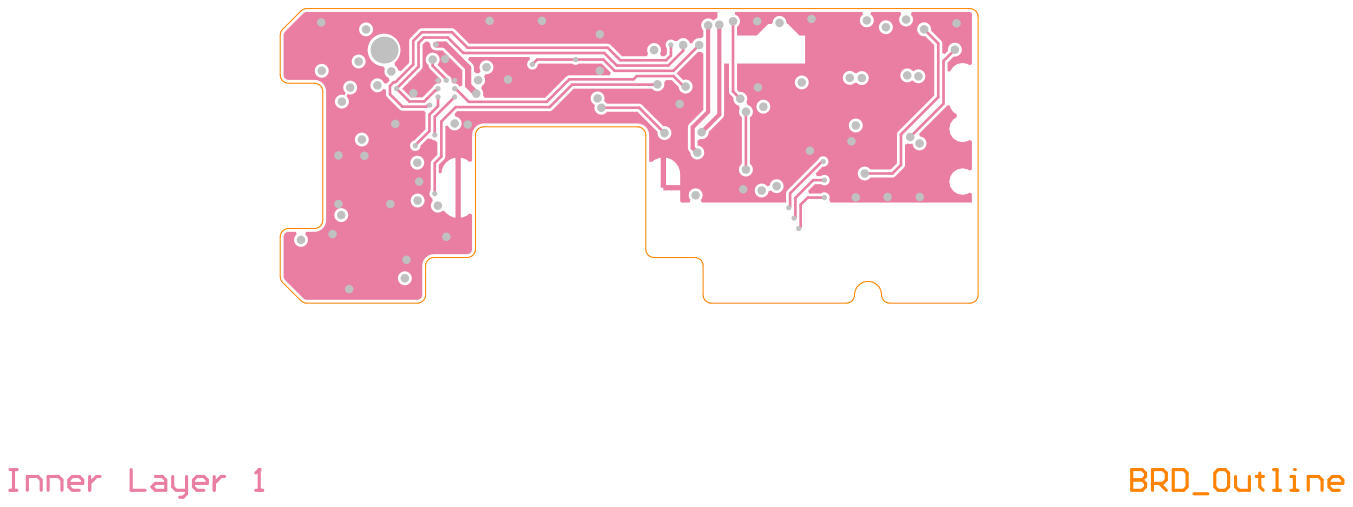
[picture p104: page 2]

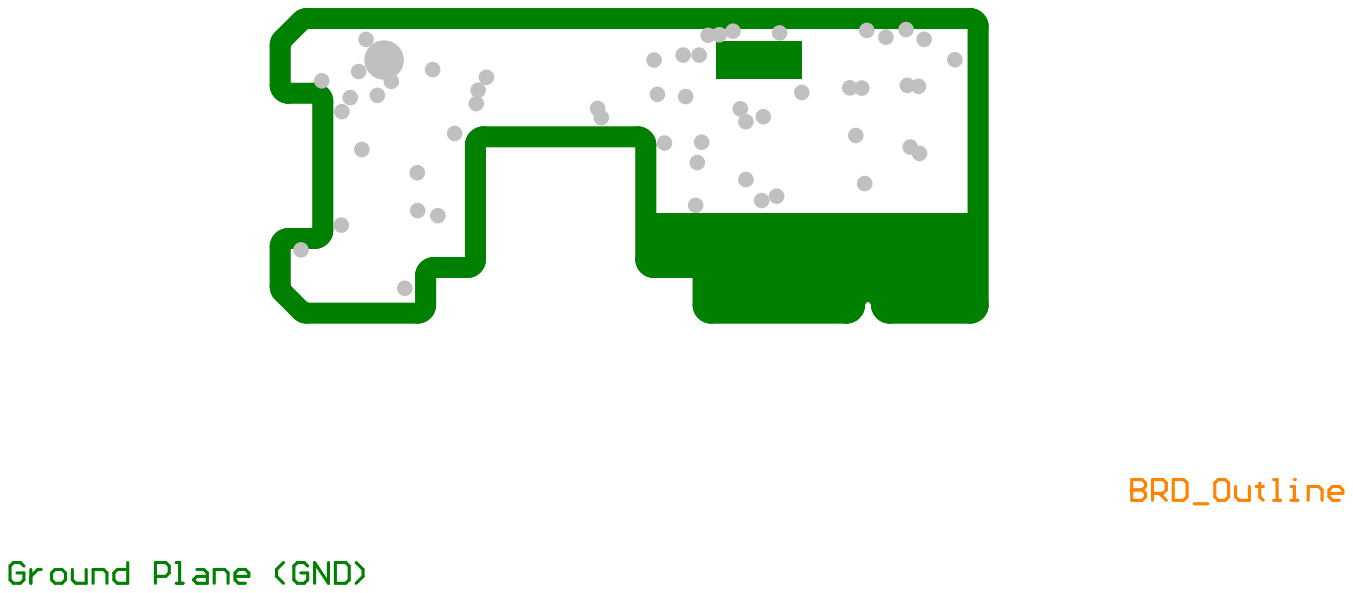
[picture p105: page 3]

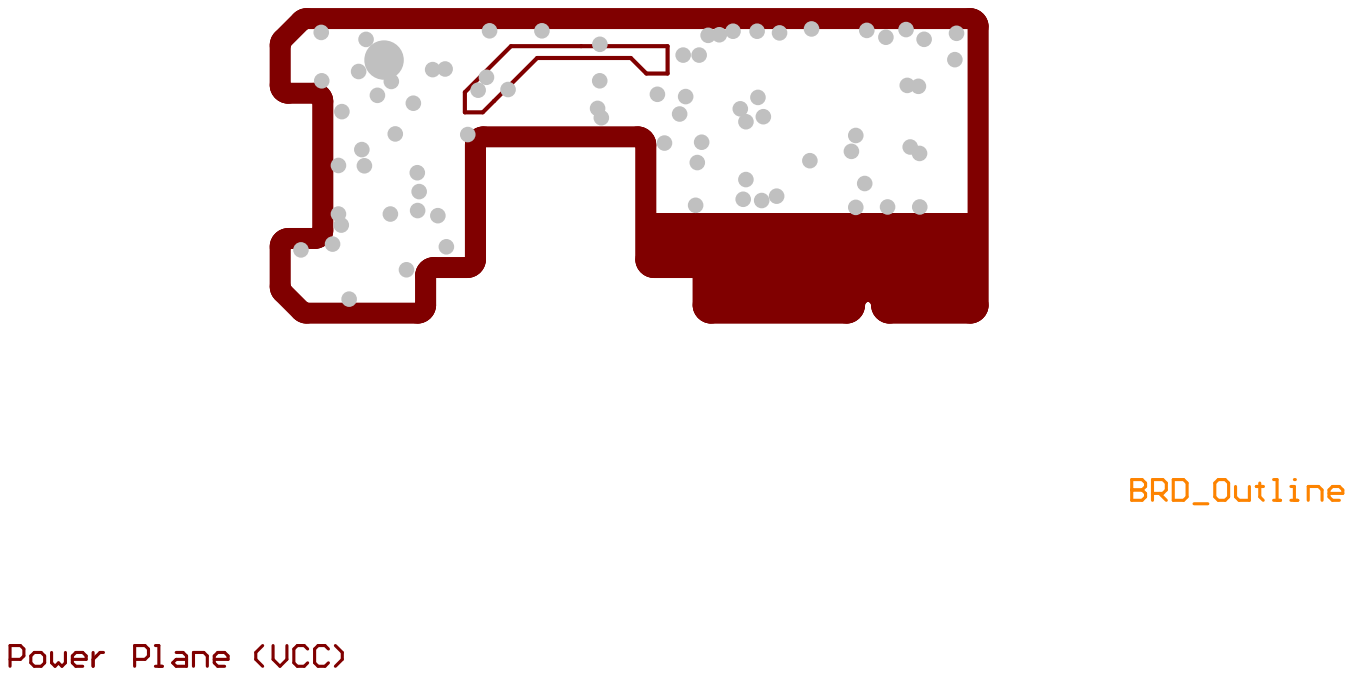
[picture p106: page 4]

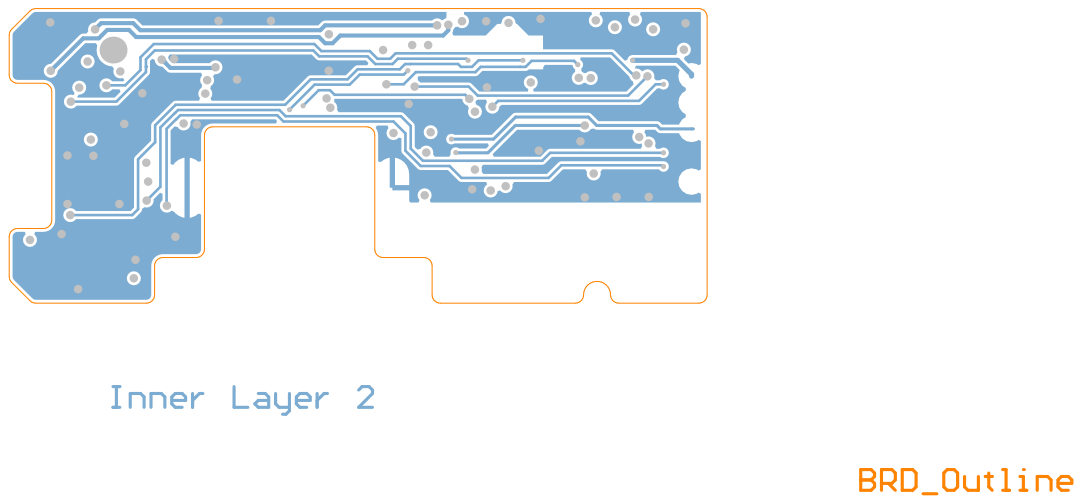
[picture p107: page 5]

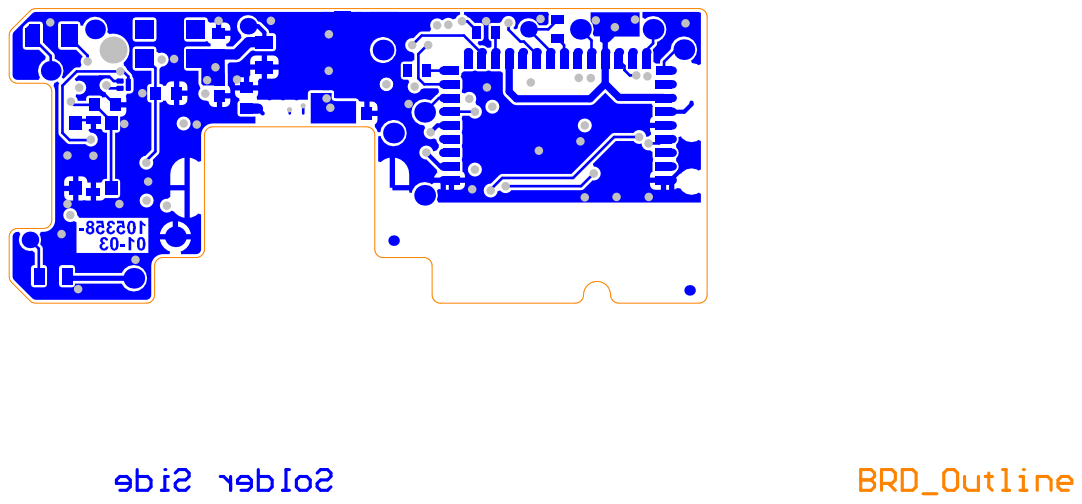
[picture p108: page 6]

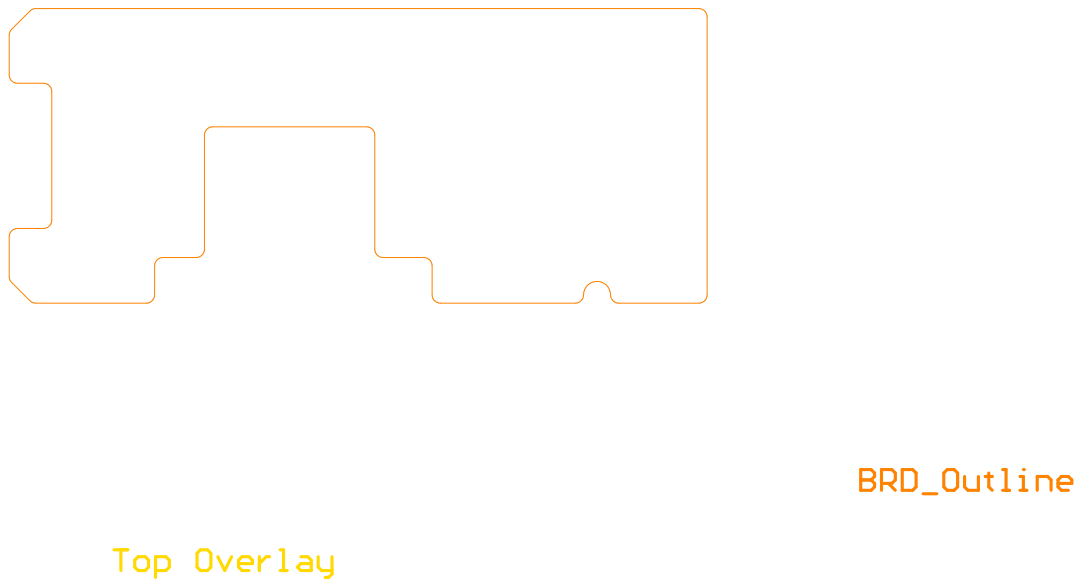
[picture p109: page 7]

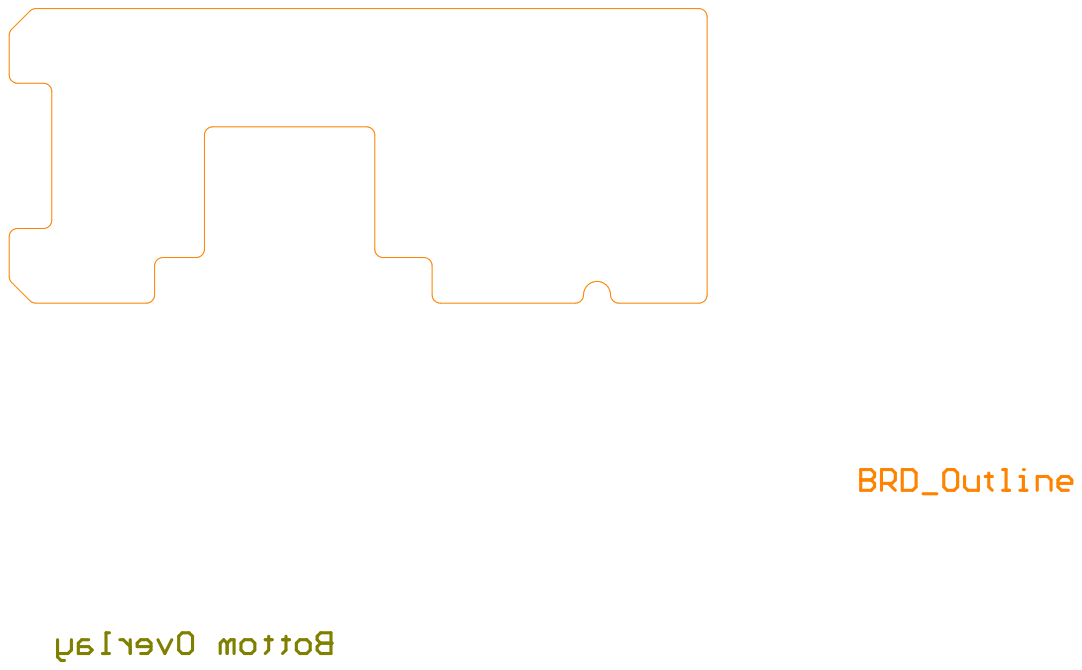
[picture p110: page 8]

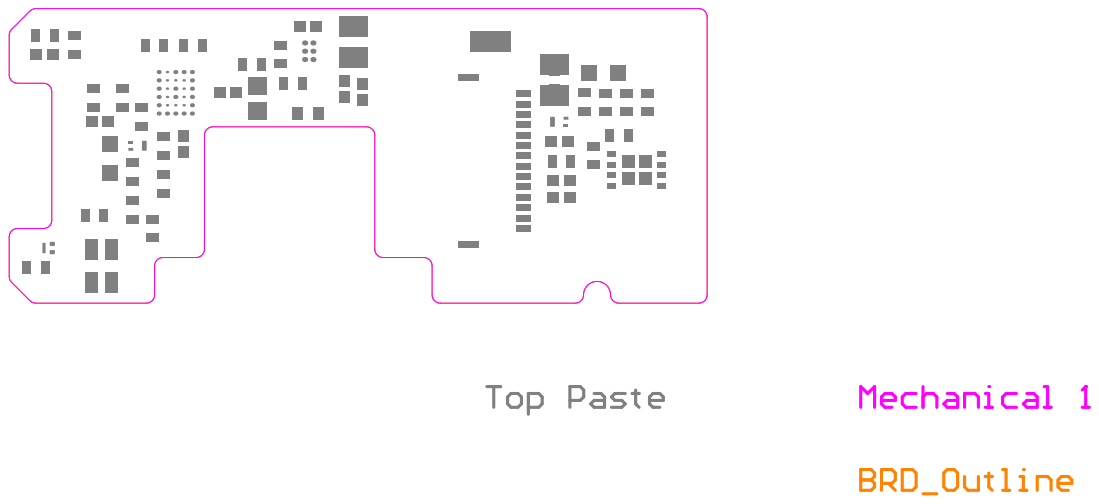
[picture p111: page 9]

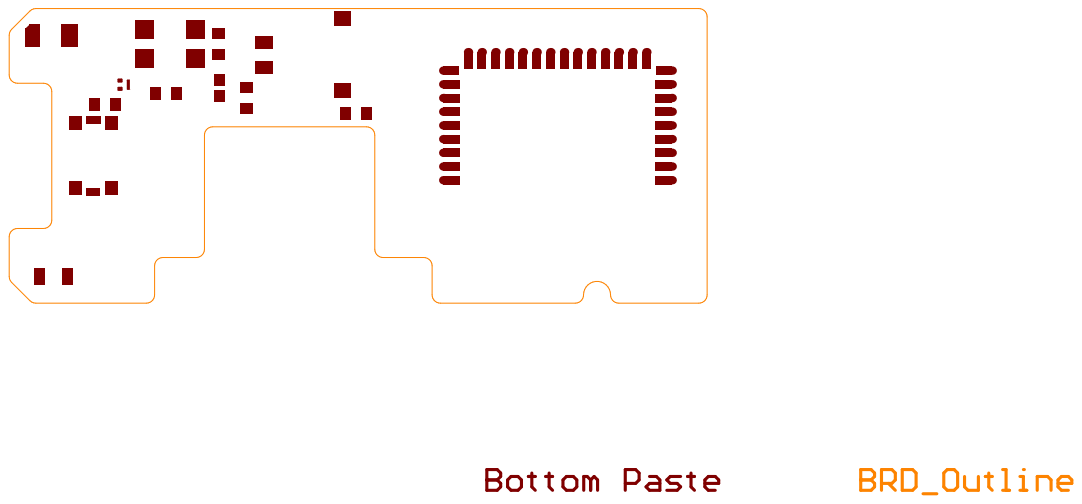
[picture p112: page 10]

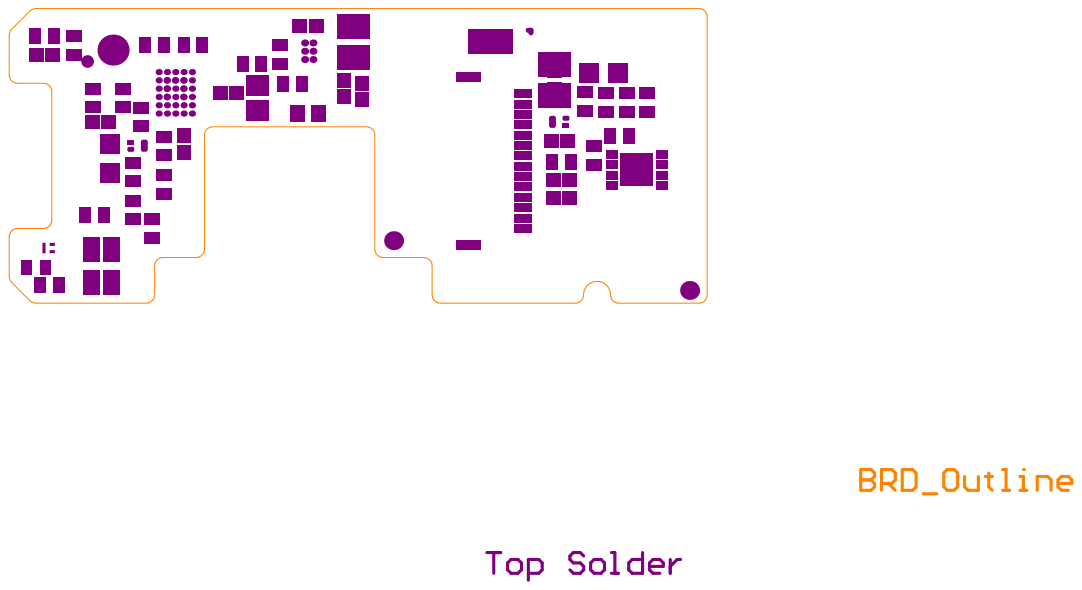
[picture p113: page 11]

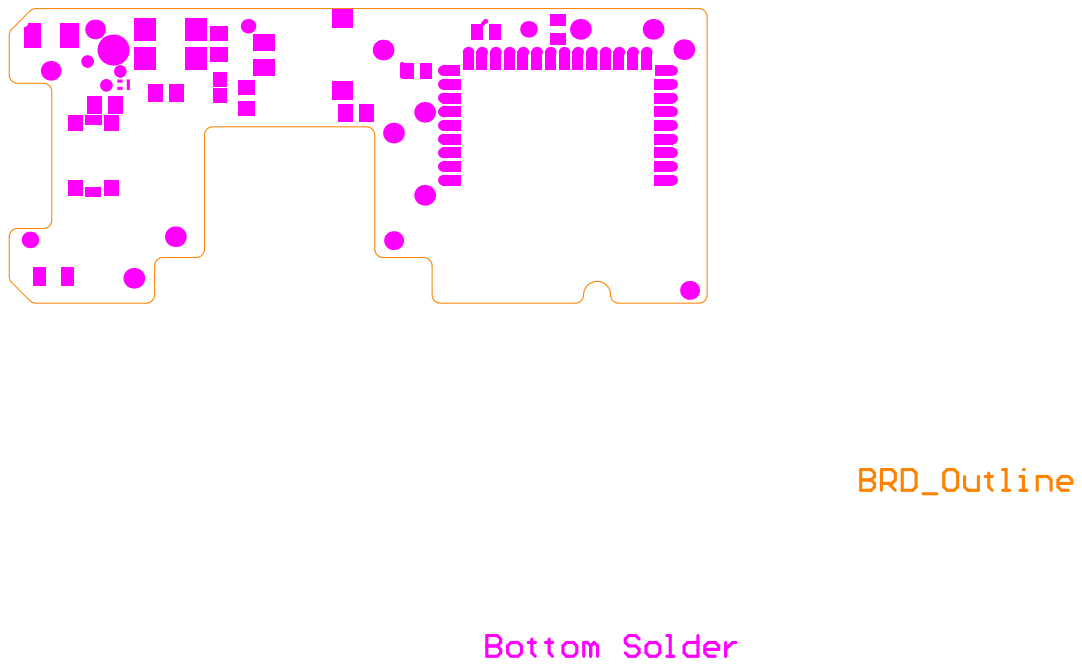
[picture p114: page 12]

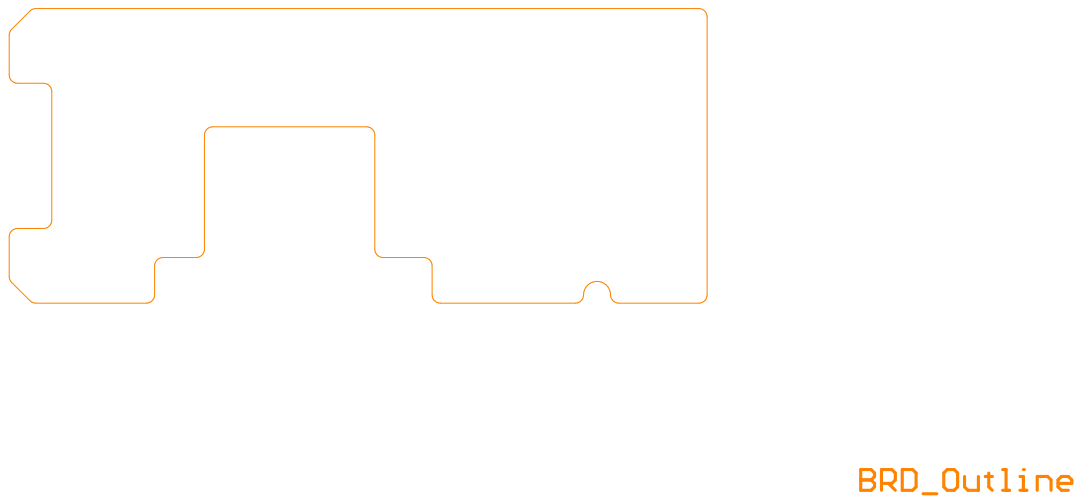
[picture p115: page 13]

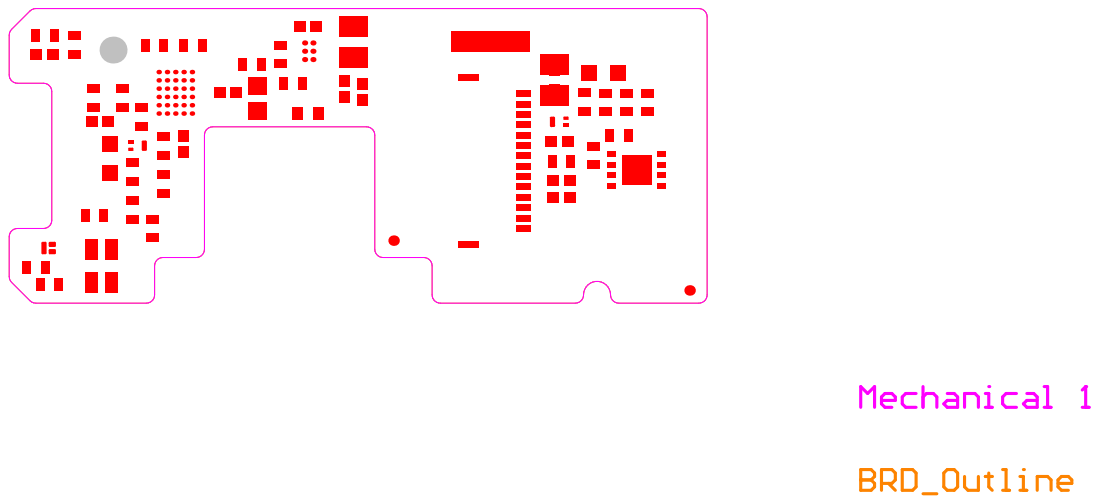
[picture p116: page 14]

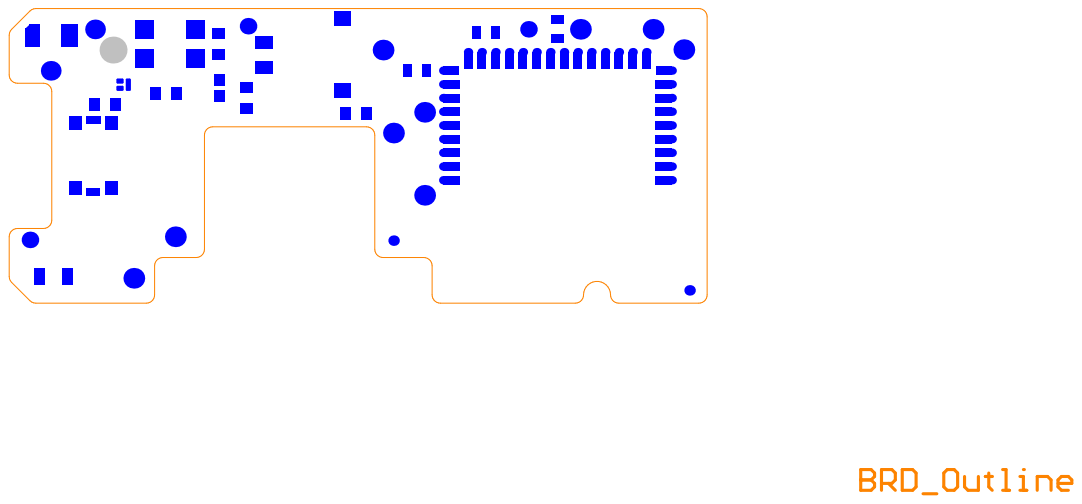
[picture p117: page 15]

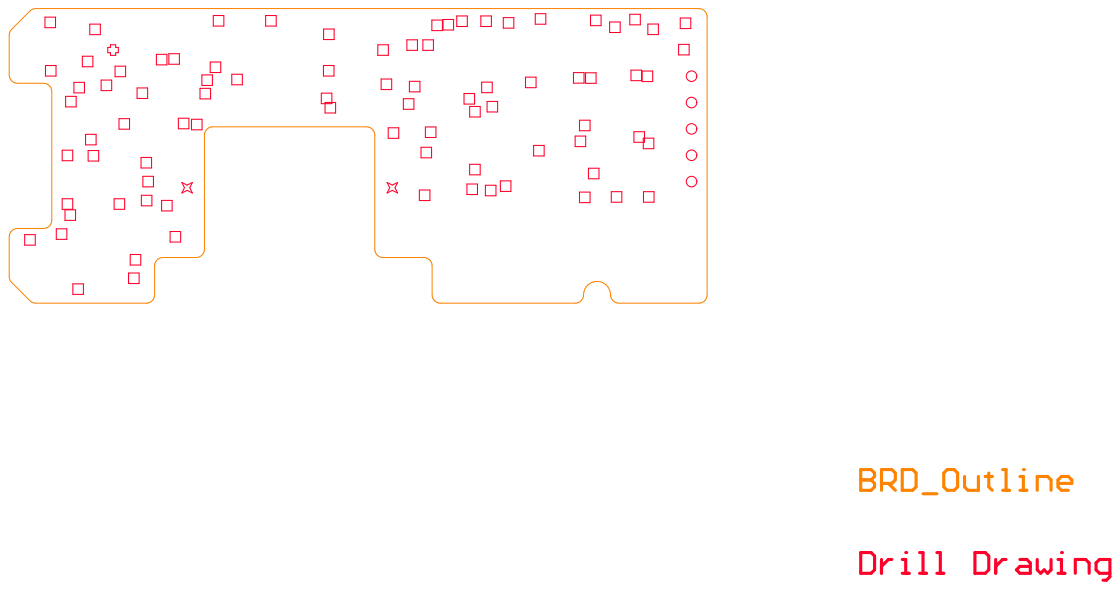
[picture p118: page 16]

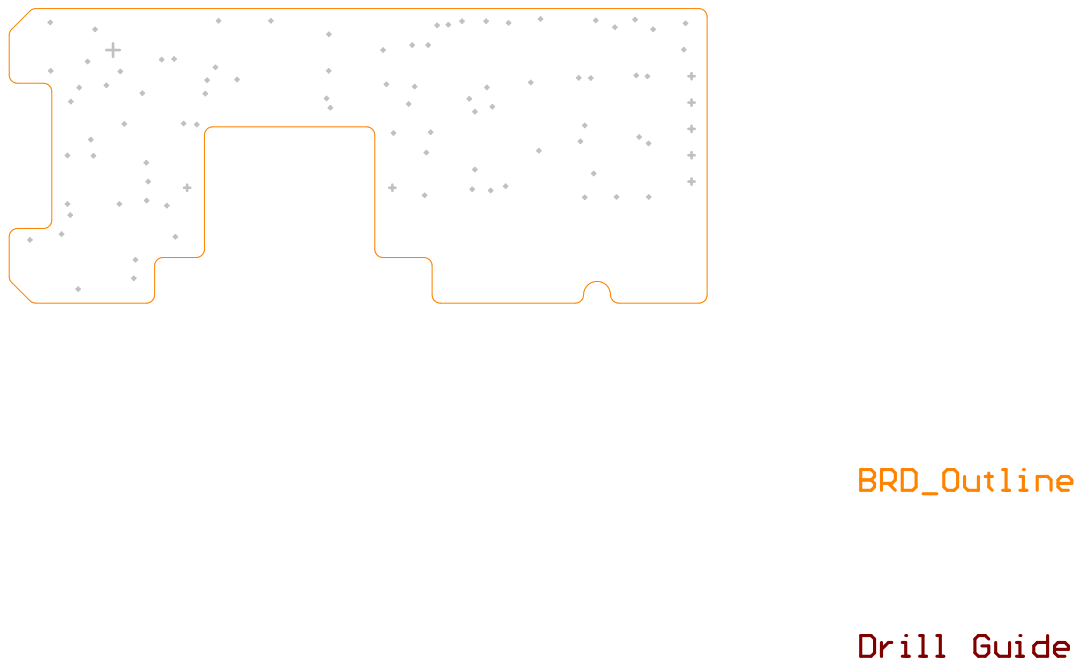
[picture p119: page 17]

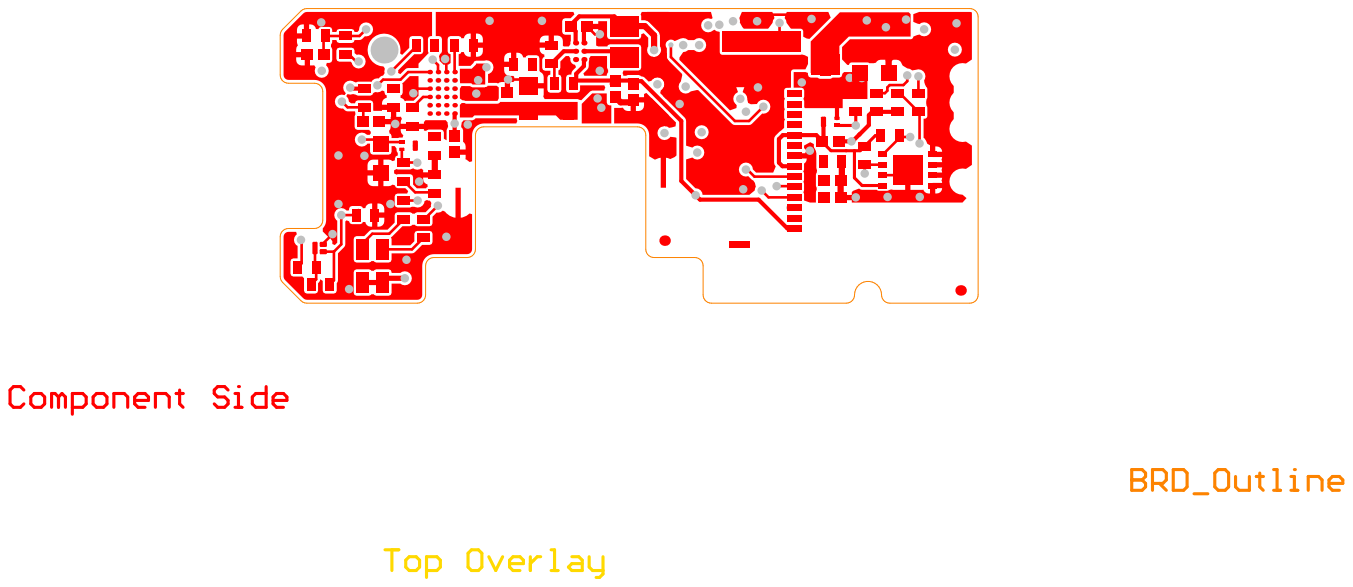
[picture p120: page 18]

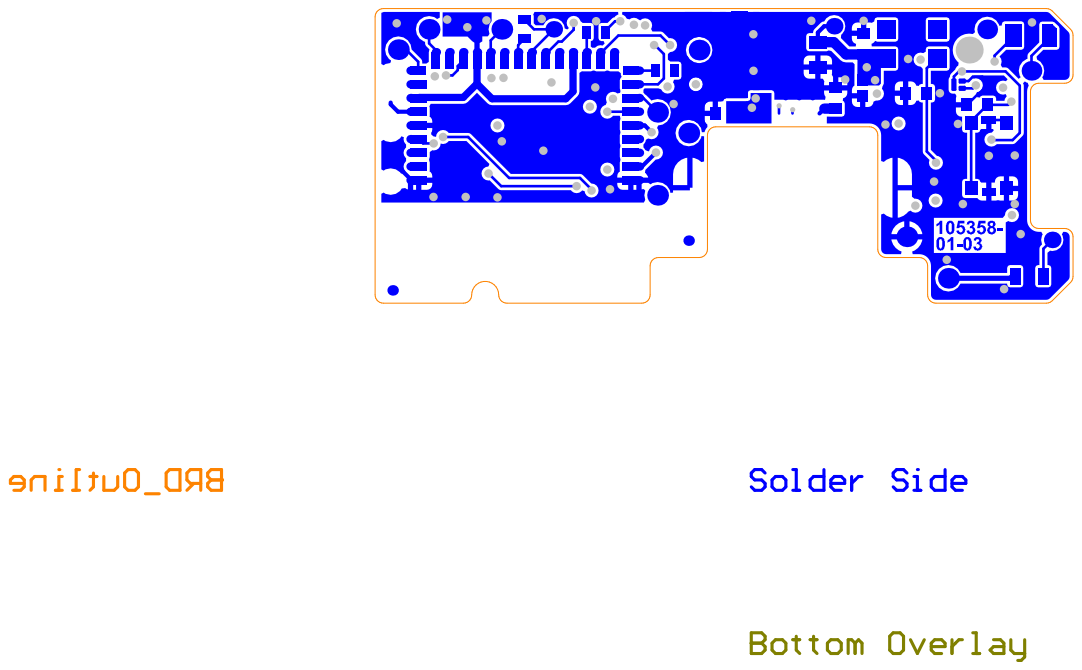
[picture p121: page 19]
