Engineer1234/ConnectMedical/Connect Medical Boards/EFM1_Touch/Project Outputs for 105358-3BA003-02_EFP1_Touch/PDF/105358-3LA003-02_PCB_EFP1-Touch.PDF

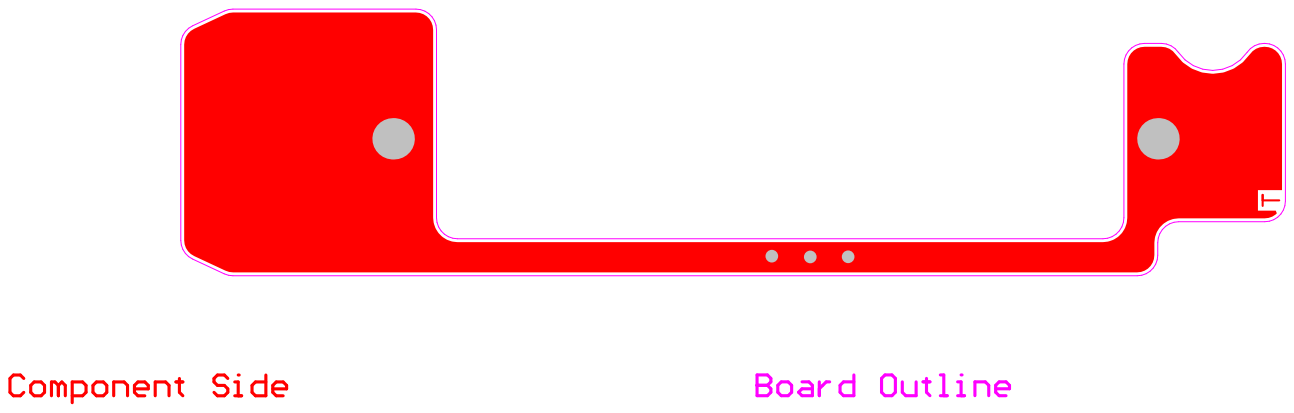
[picture p122: page 1]

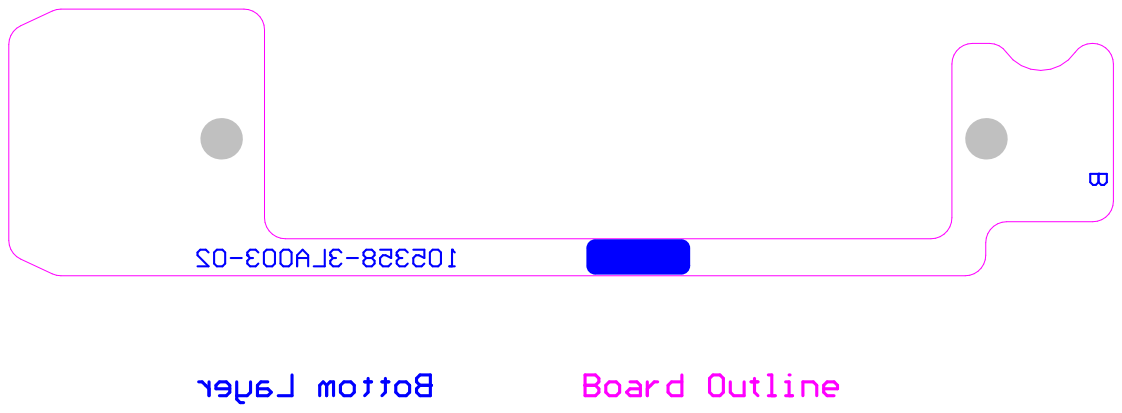
[picture p123: page 2]

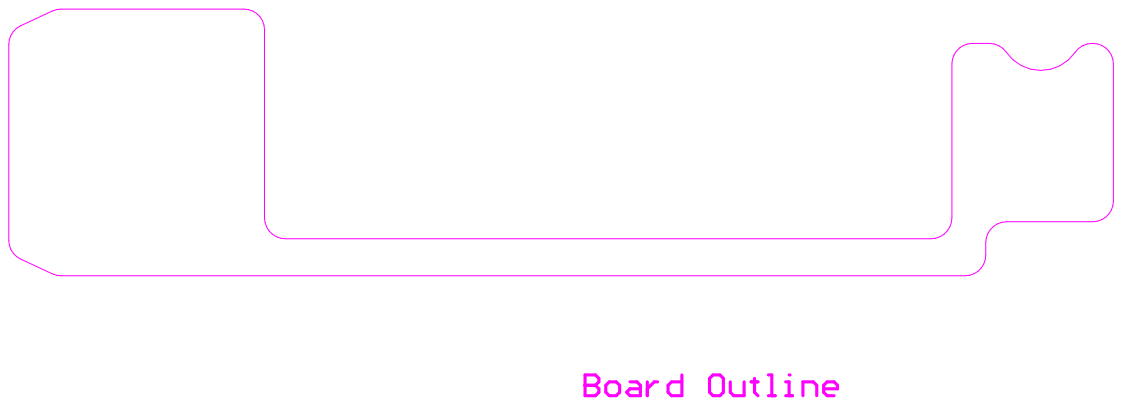
[picture p124: page 3]

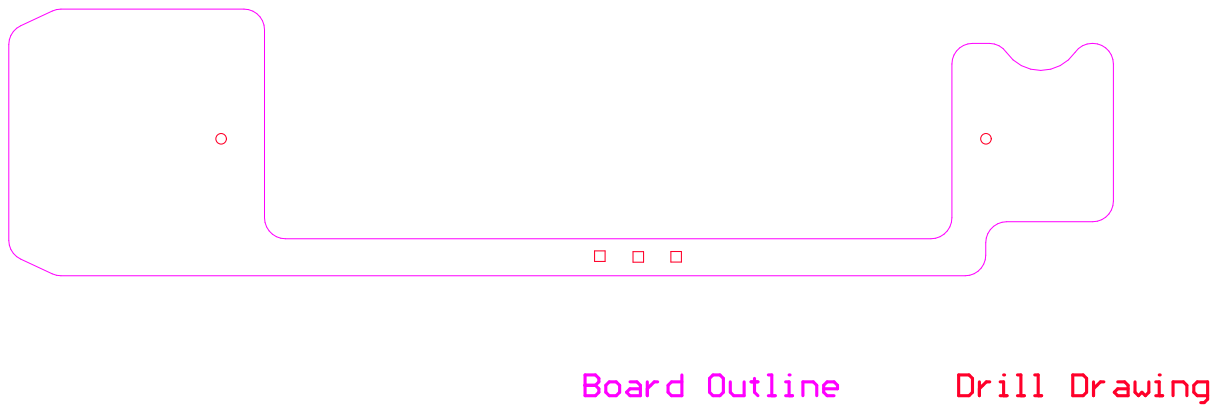
[picture p125: page 4]

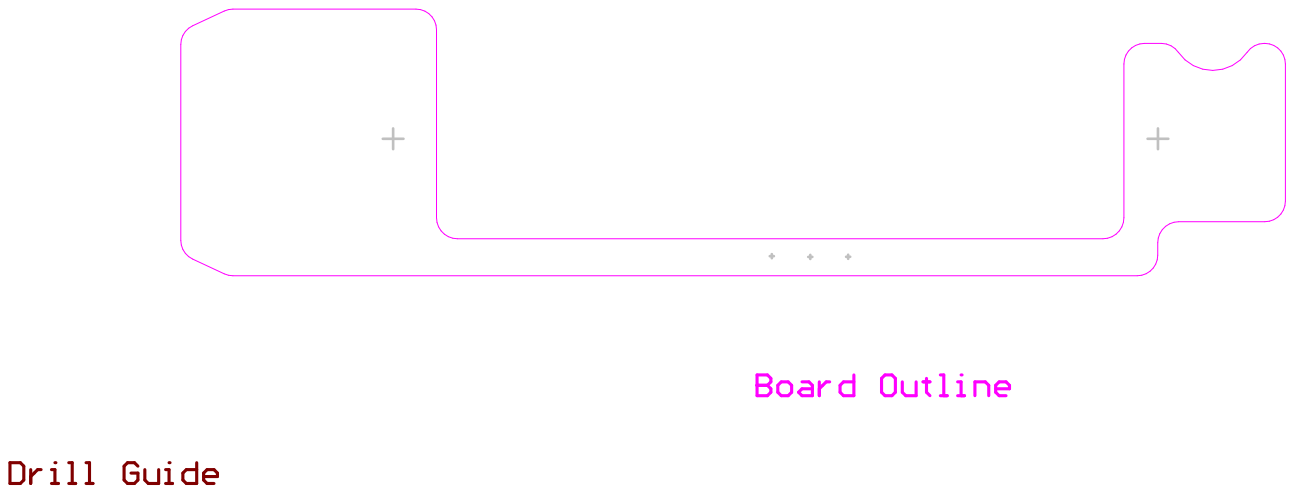
[picture p126: page 5]

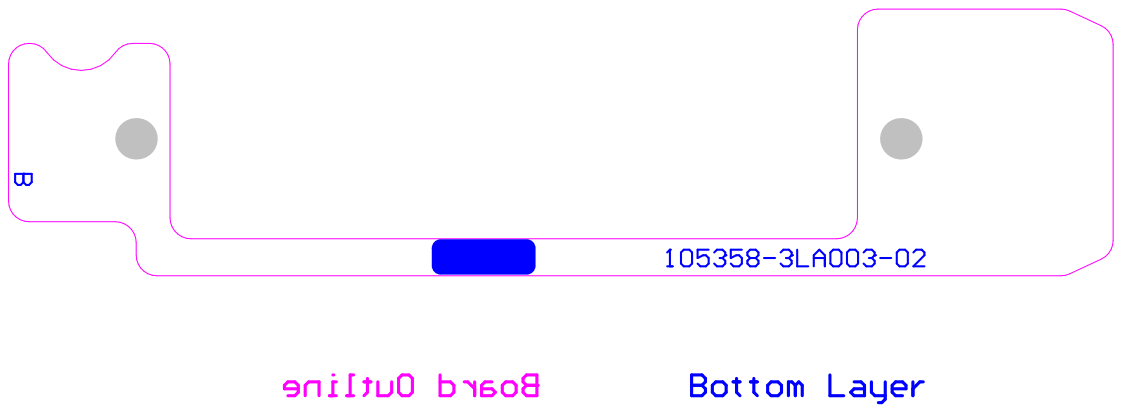
[picture p127: page 7]
