Engineer1234/ConnectMedical/Connect Medical Boards/EFM2/Project Outputs for 105358-3BA001-02_EFM1.5/PDF/105358-3LA001-02_PCB_EFM1.5.PDF

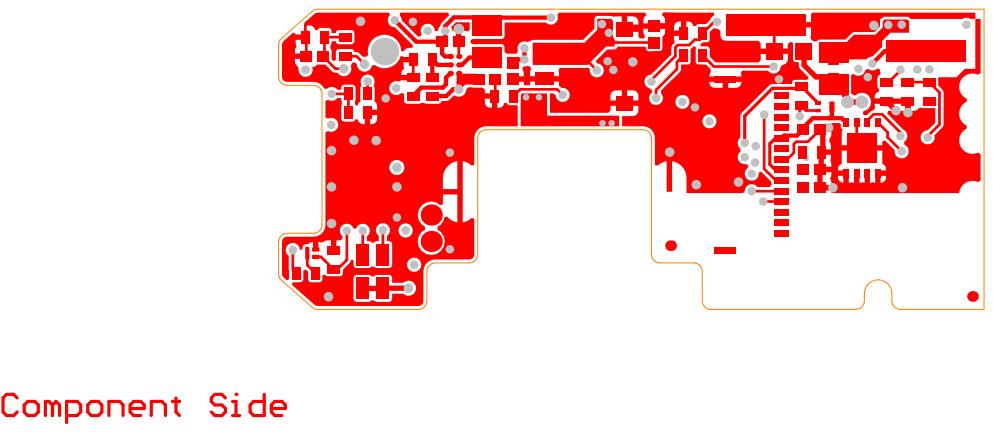
[picture p128: page 1]

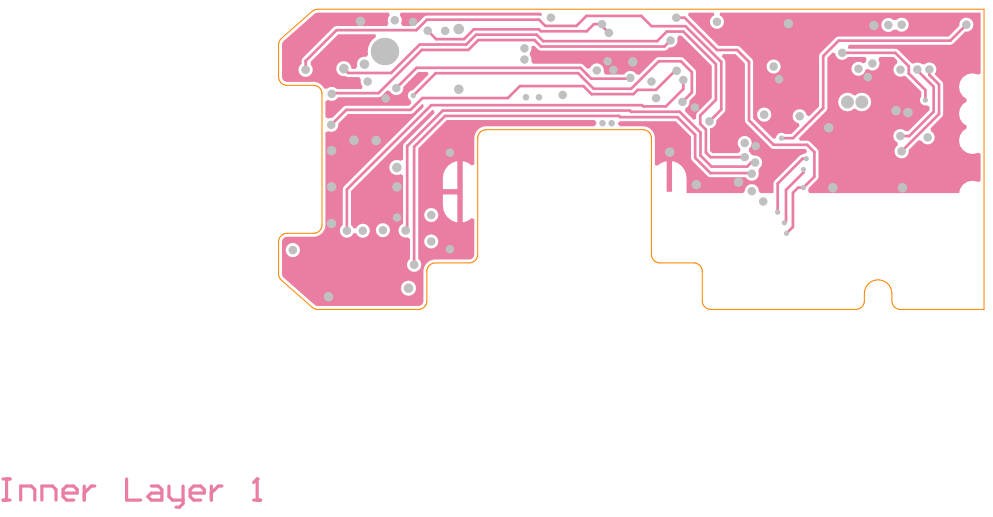
[picture p129: page 2]

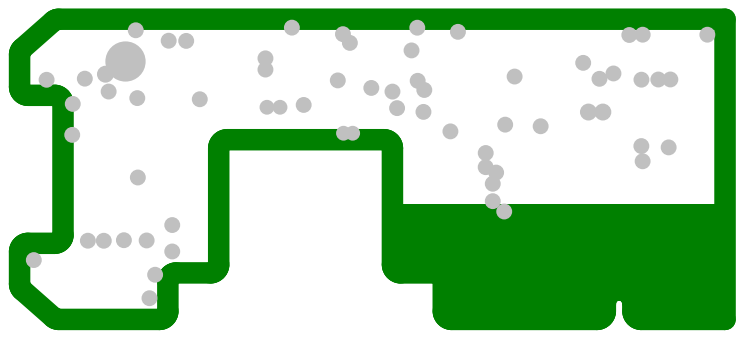
[picture p130: page 3]

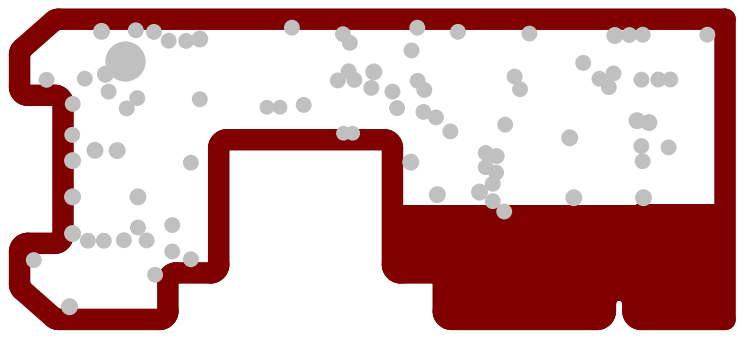
[picture p131: page 4]

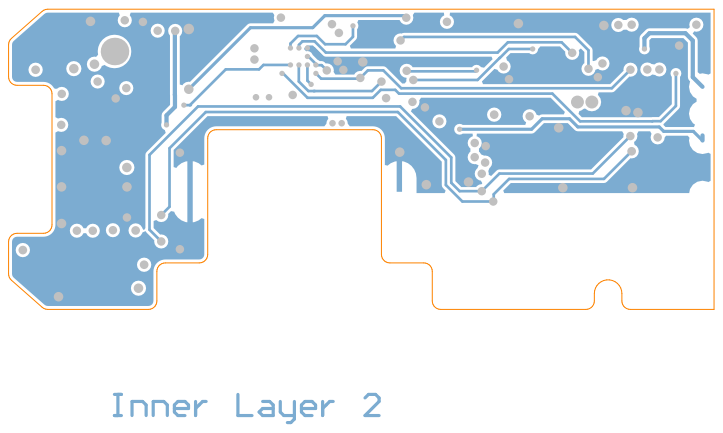
[picture p132: page 5]

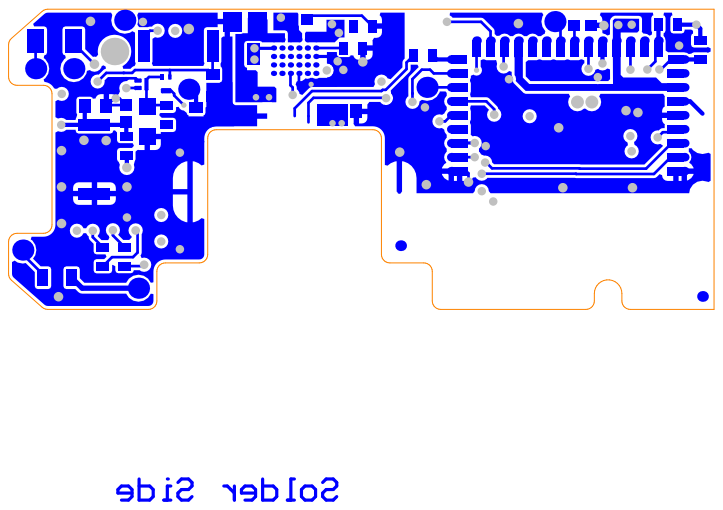
[picture p133: page 6]

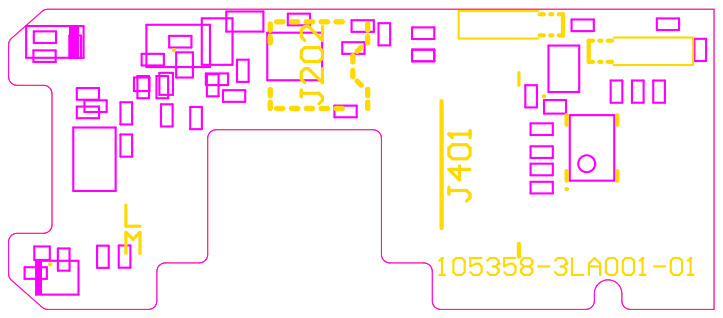
[picture p134: page 7]

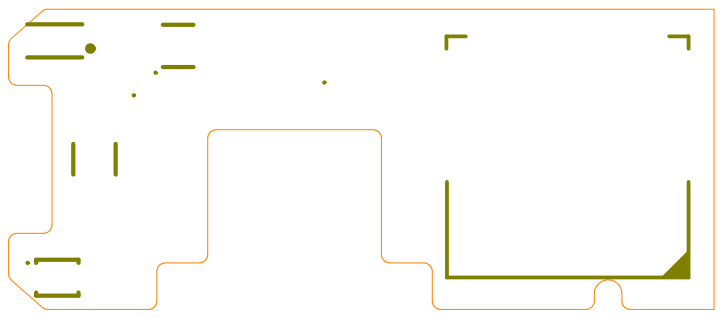
[picture p135: page 8]

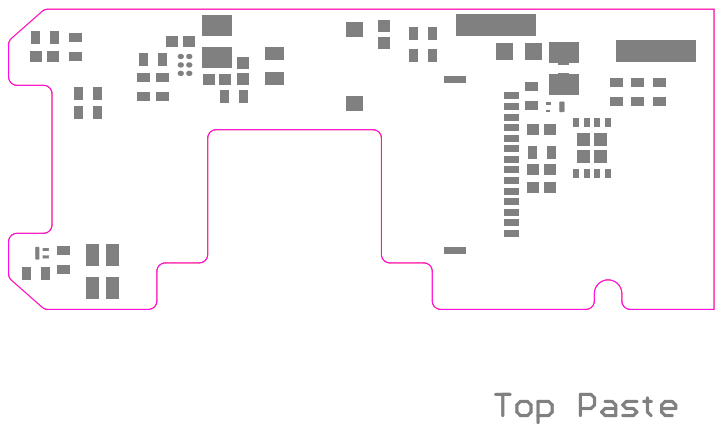
[picture p136: page 9]

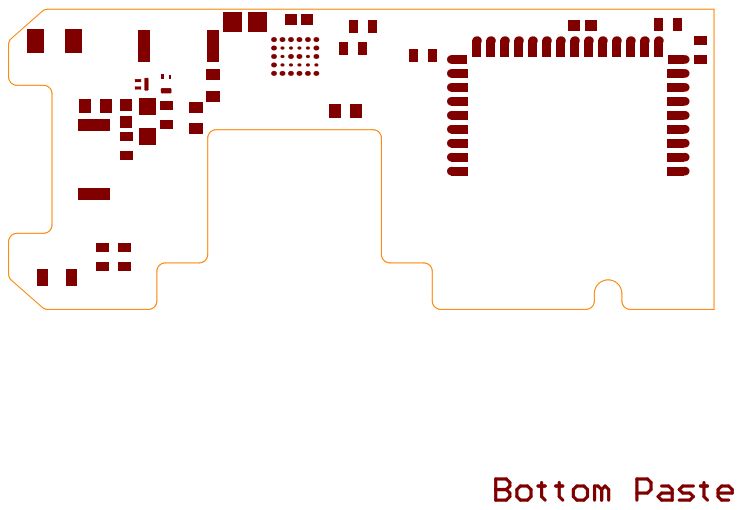
[picture p137: page 10]

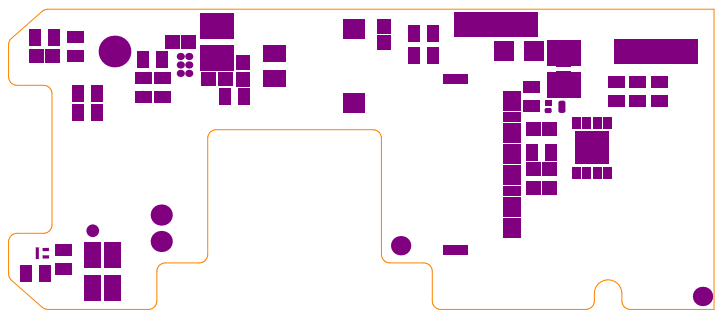
[picture p138: page 11]

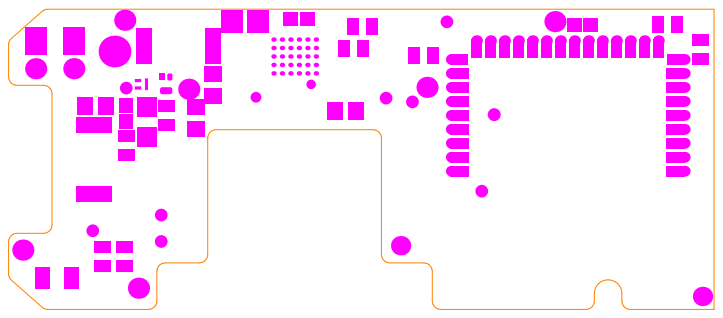
[picture p139: page 12]

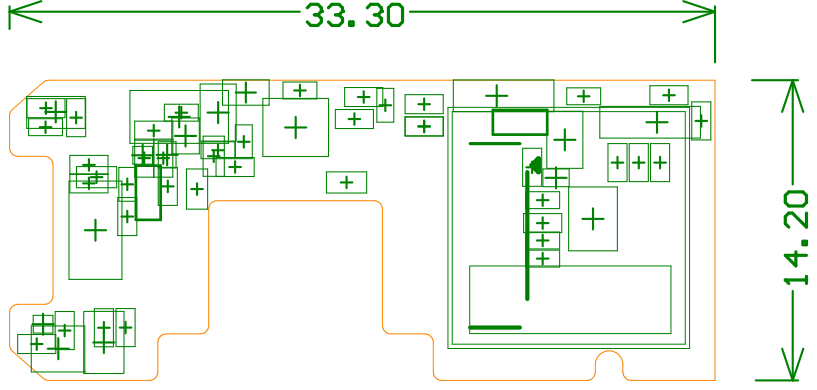
[picture p140: page 13]

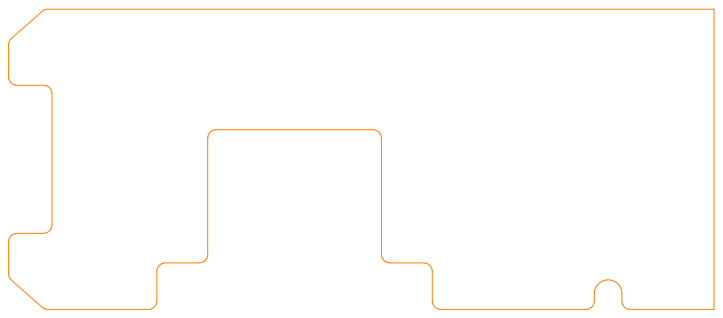
[picture p141: page 14]

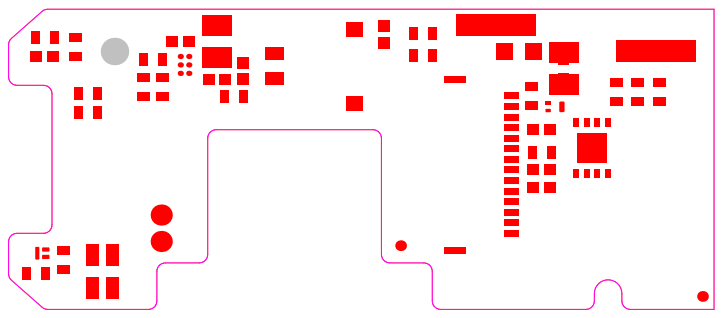
[picture p142: page 15]

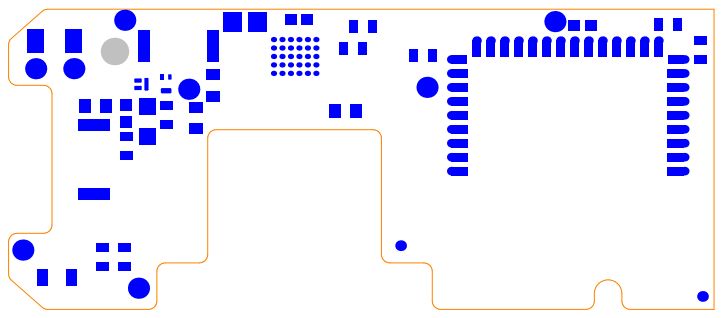
[picture p143: page 16]

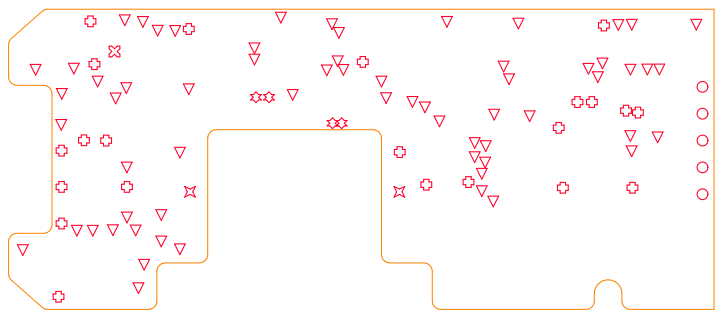
[picture p144: page 18]

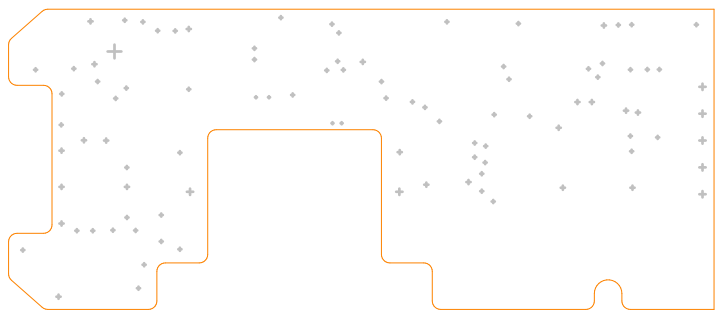
[picture p145: page 19]

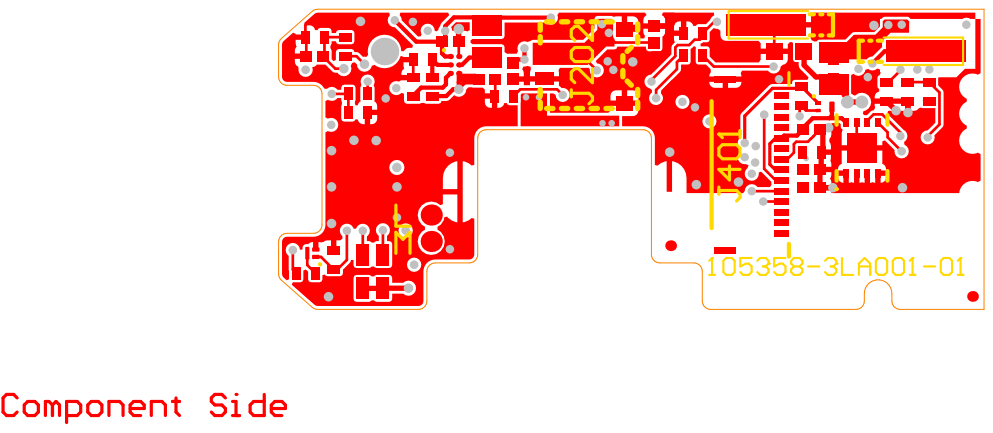
[picture p146: page 20]

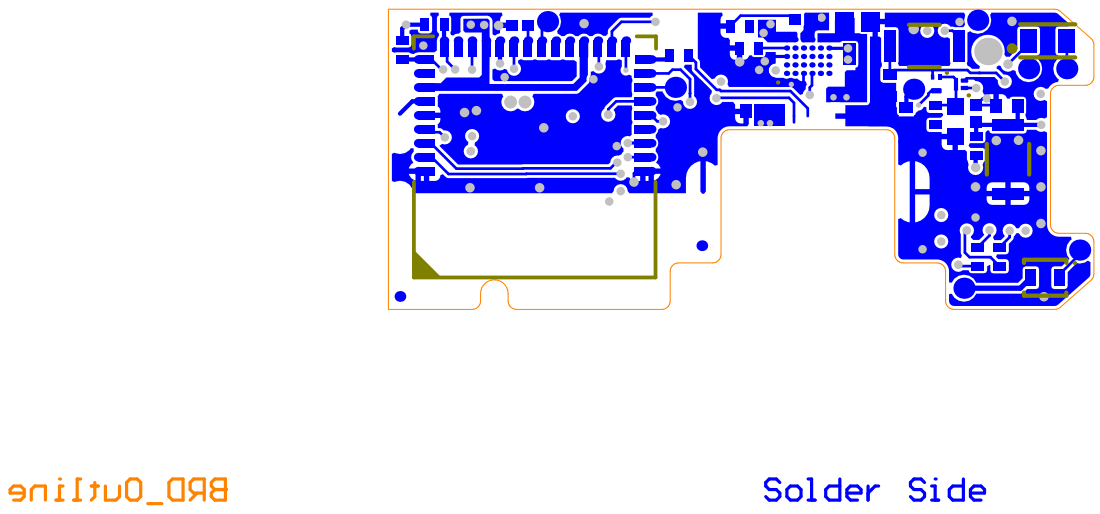
[picture p147: page 21]
