Engineer1234/ConnectMedical/Connect Medical Boards/EFM2/Project Outputs for 105358-3BA001-02_EFM2/PDF/105358-3LA001-02_PCB_EFM1.5.PDF

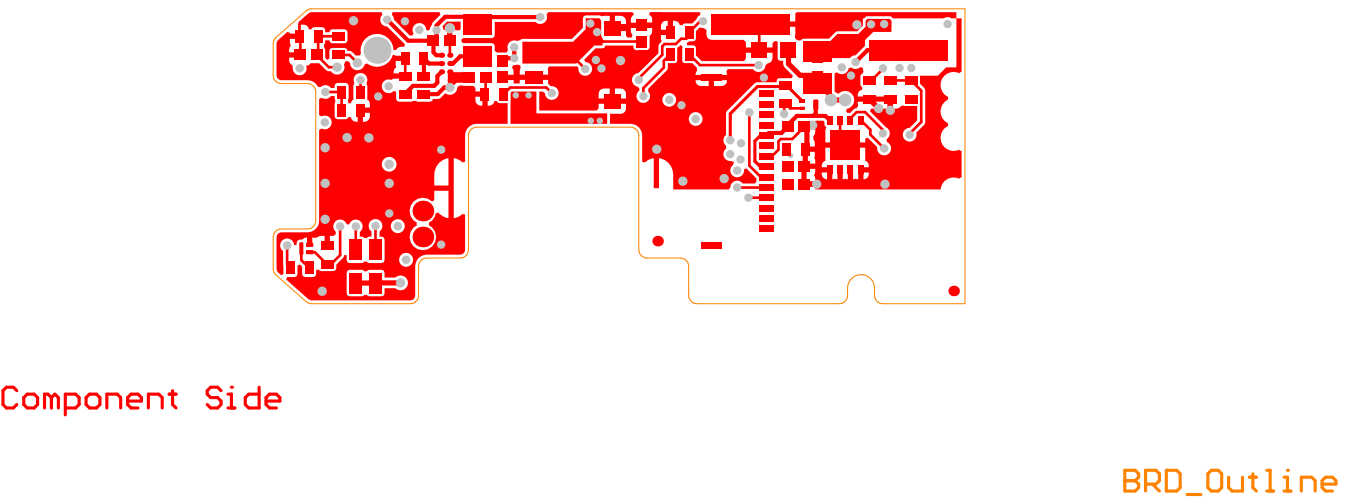
[picture p148: page 1]

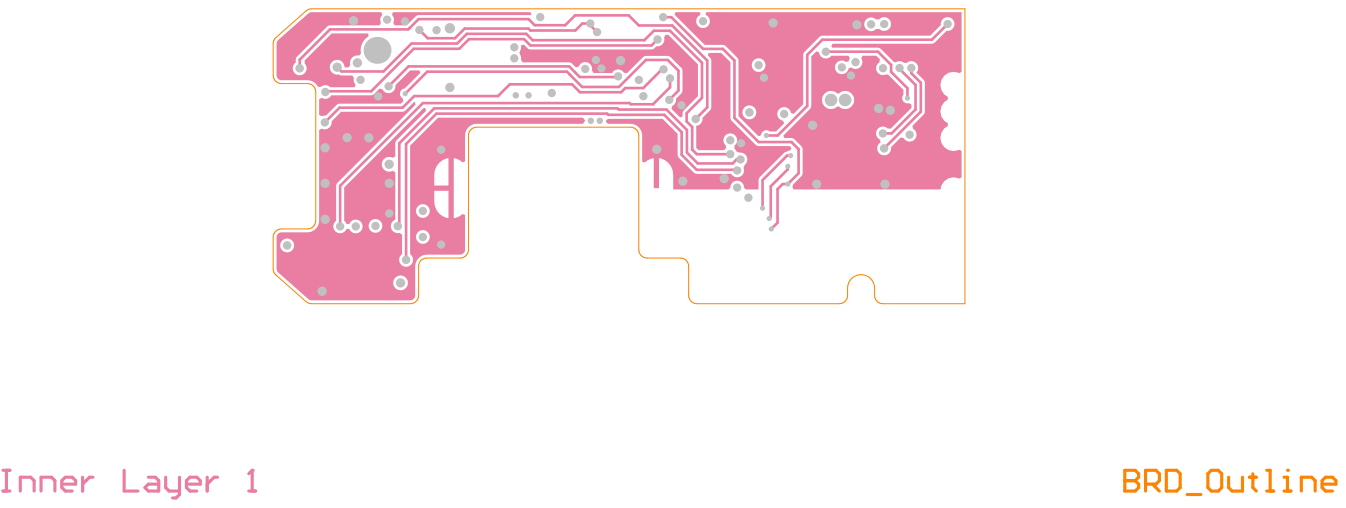
[picture p149: page 2]

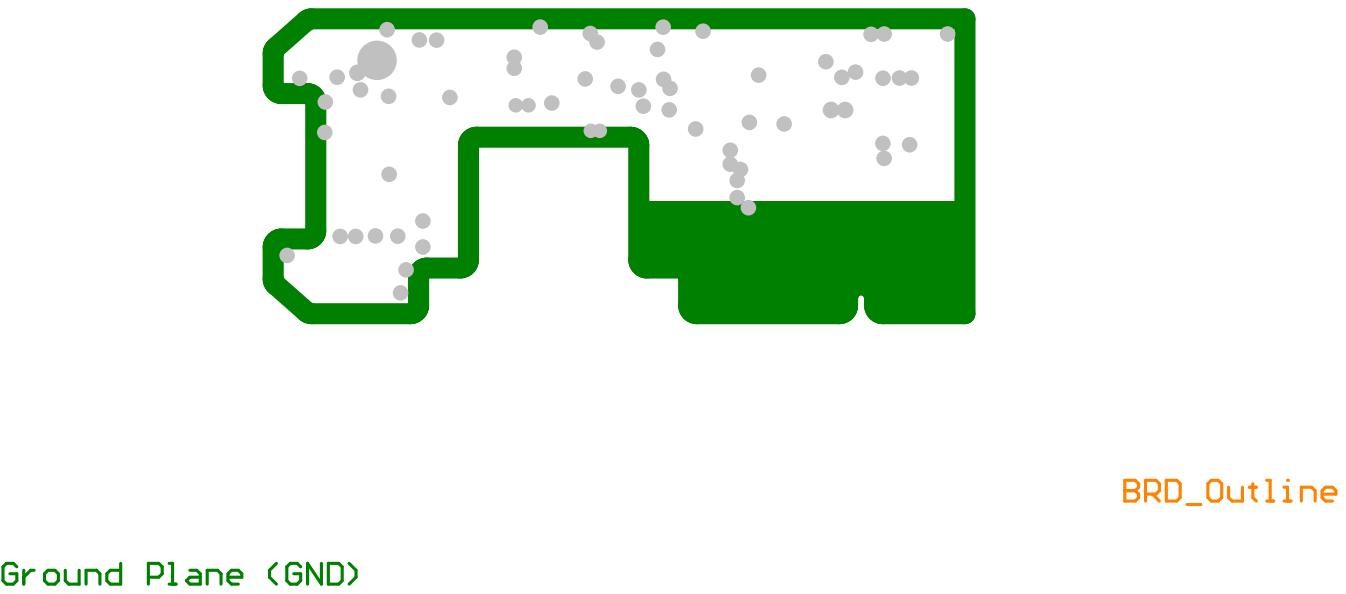
[picture p150: page 3]

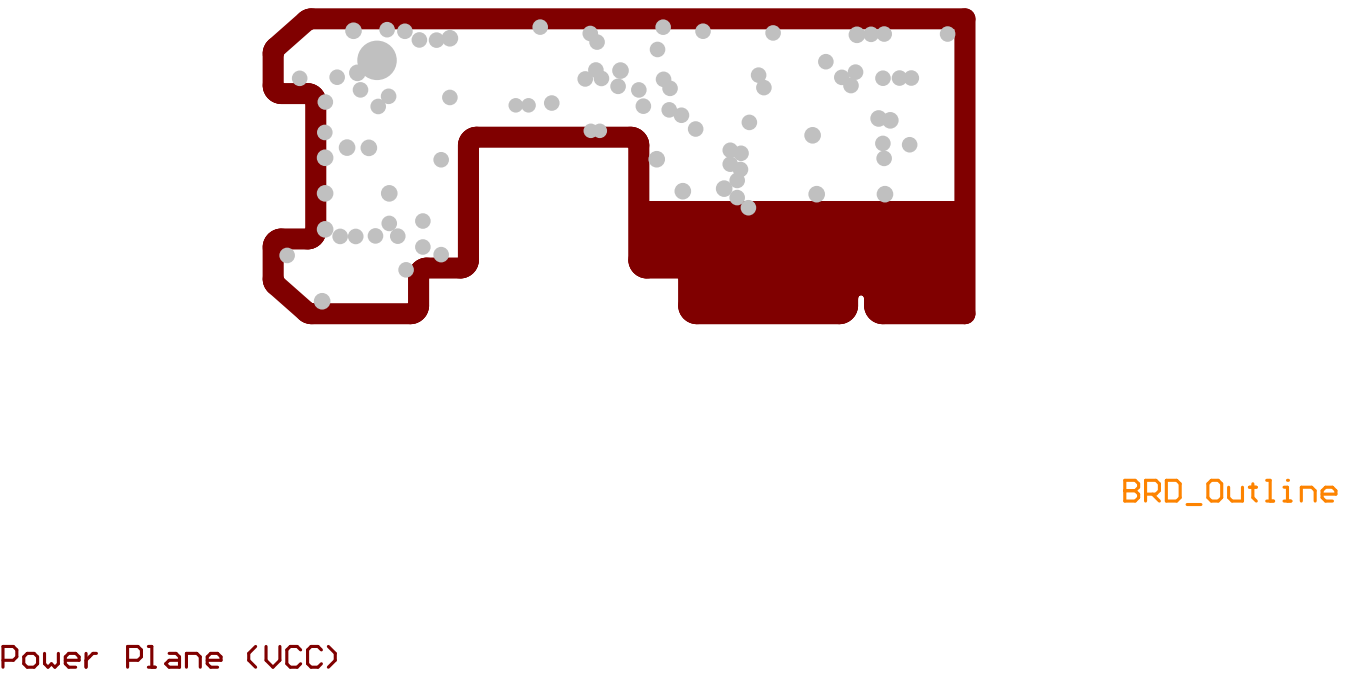
[picture p151: page 4]

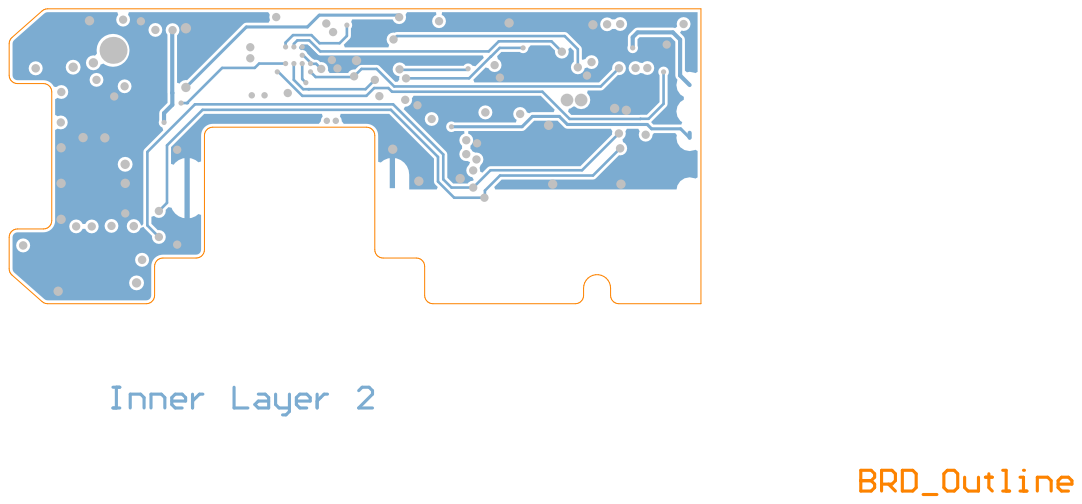
[picture p152: page 5]

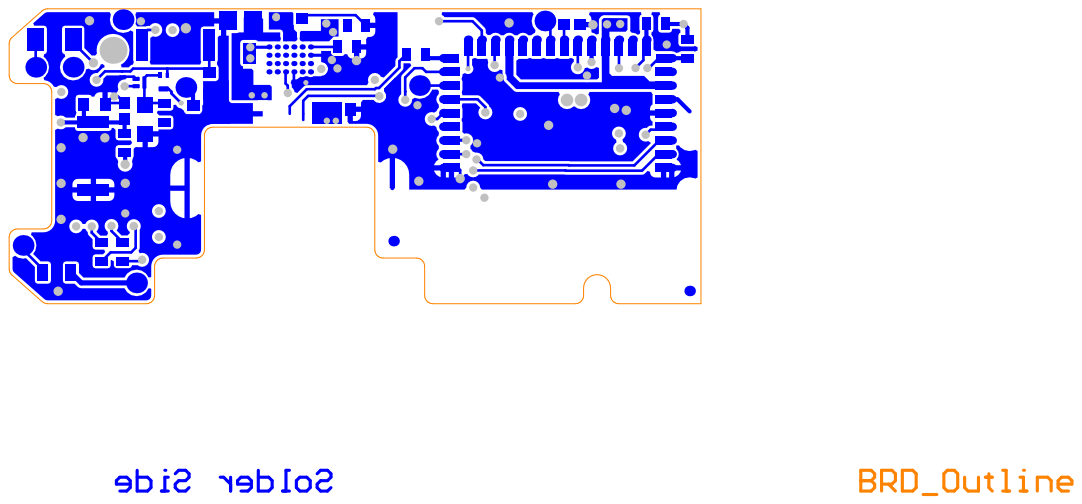
[picture p153: page 6]

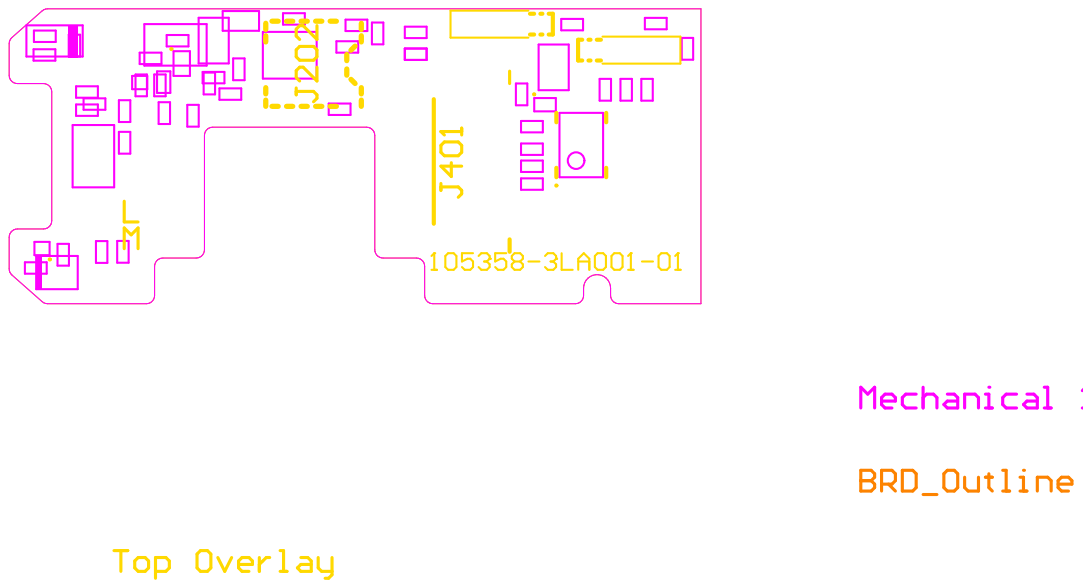
[picture p154: page 7]

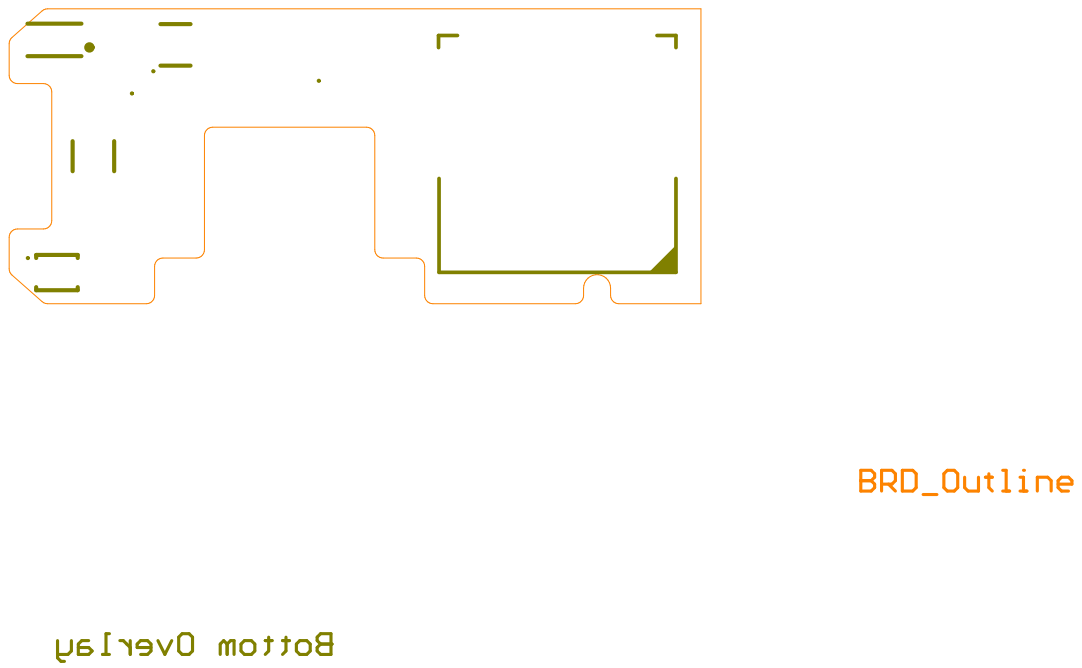
[picture p155: page 8]

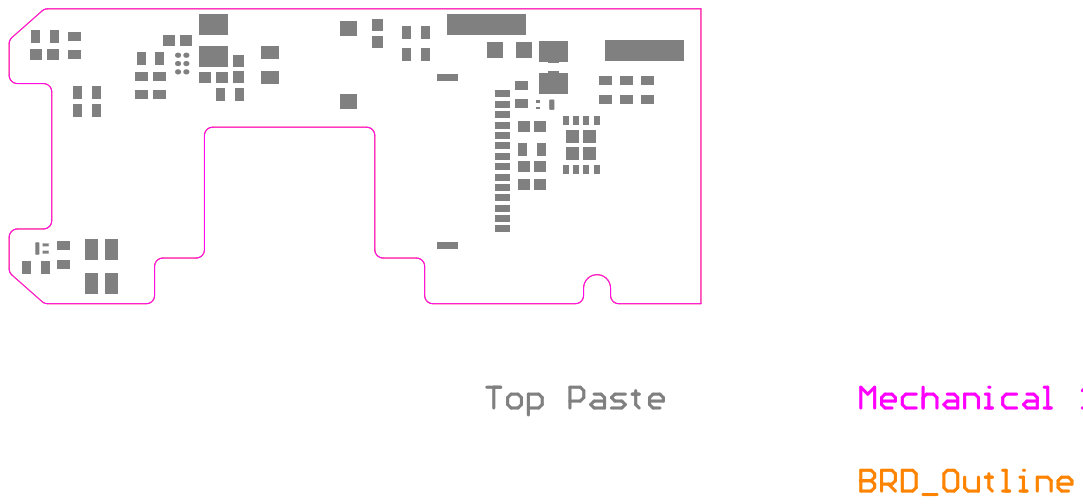
[picture p156: page 9]

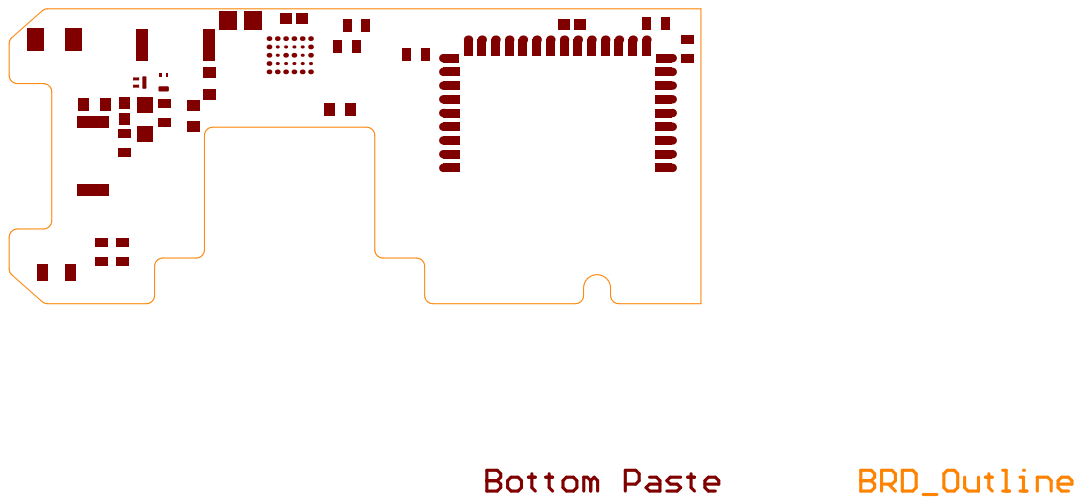
[picture p157: page 10]

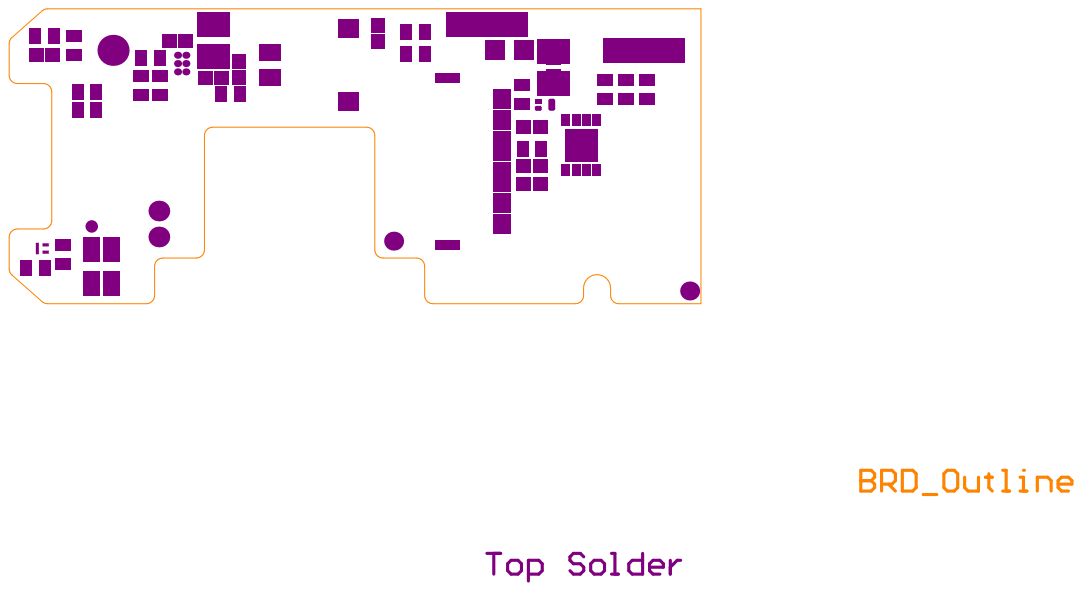
[picture p158: page 11]

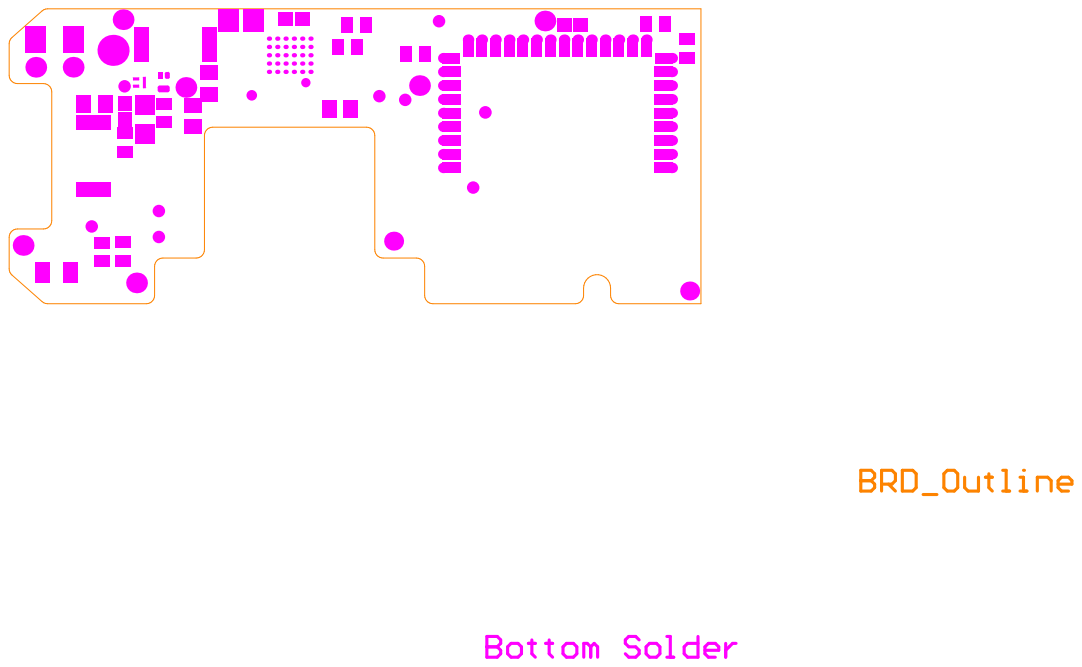
[picture p159: page 12]

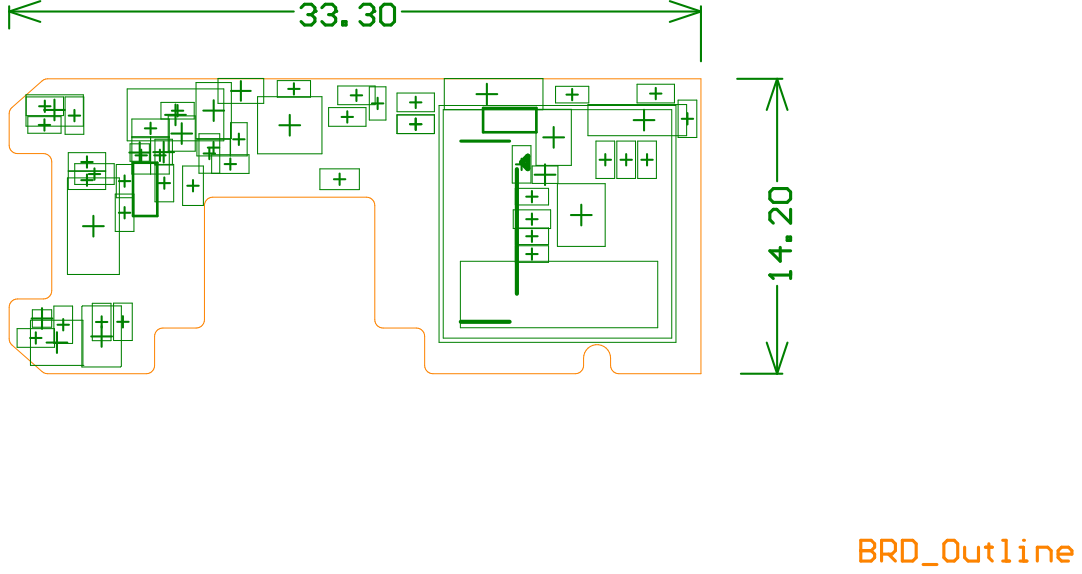
[picture p160: page 13]

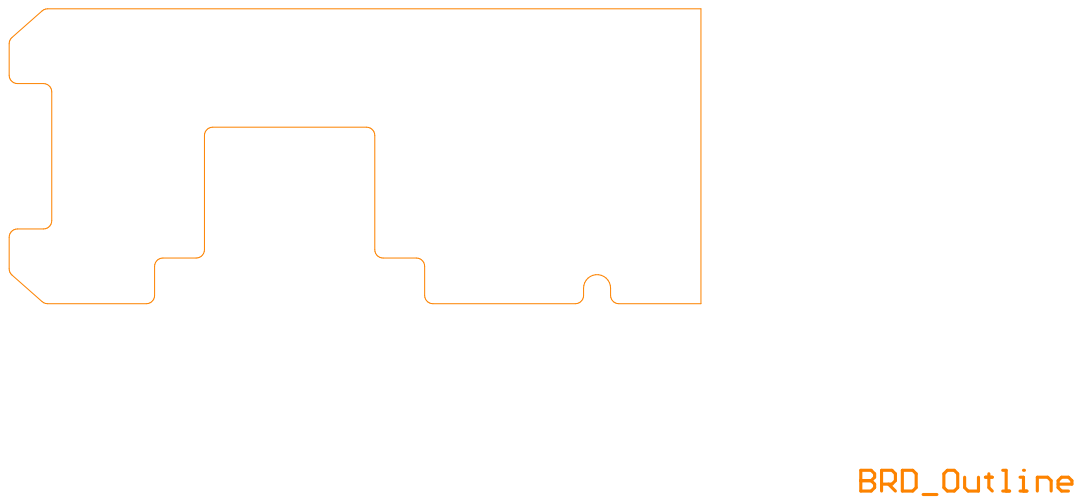
[picture p161: page 14]

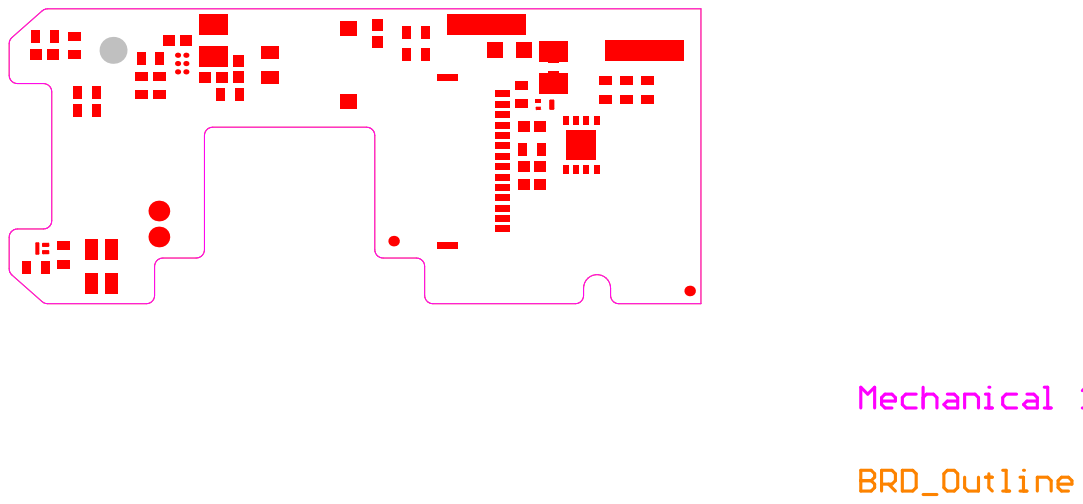
[picture p162: page 15]

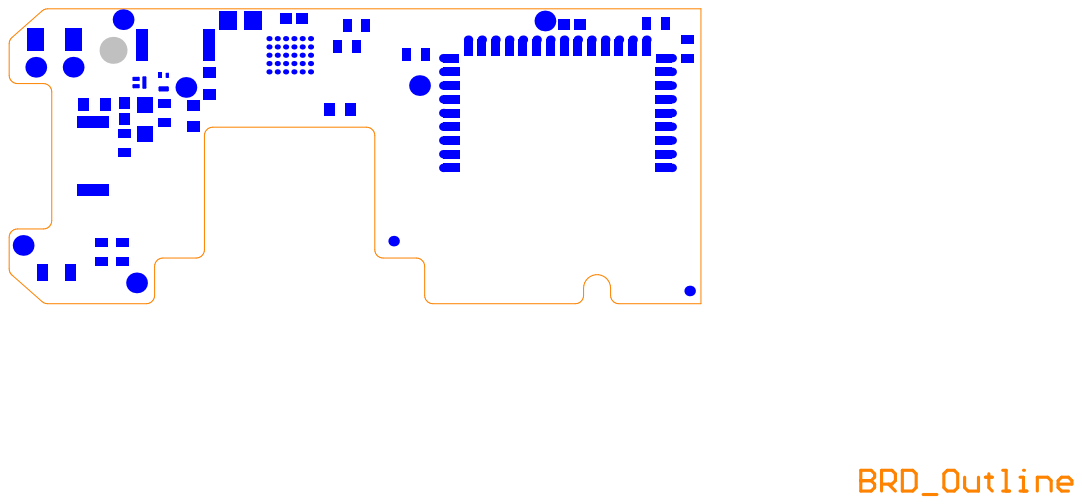
[picture p163: page 16]

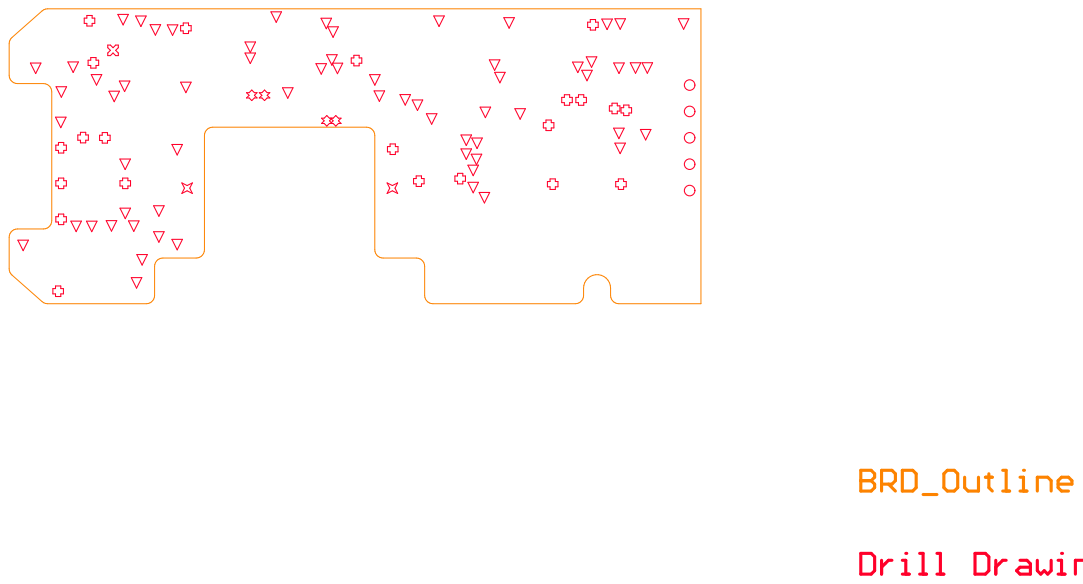
[picture p164: page 18]

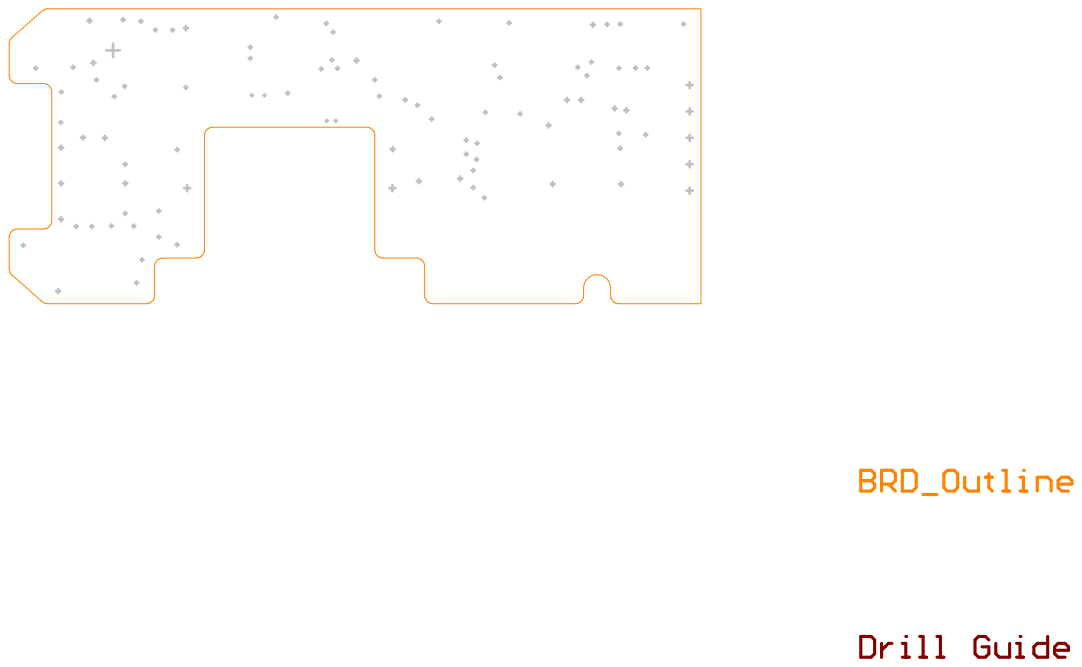
[picture p165: page 19]

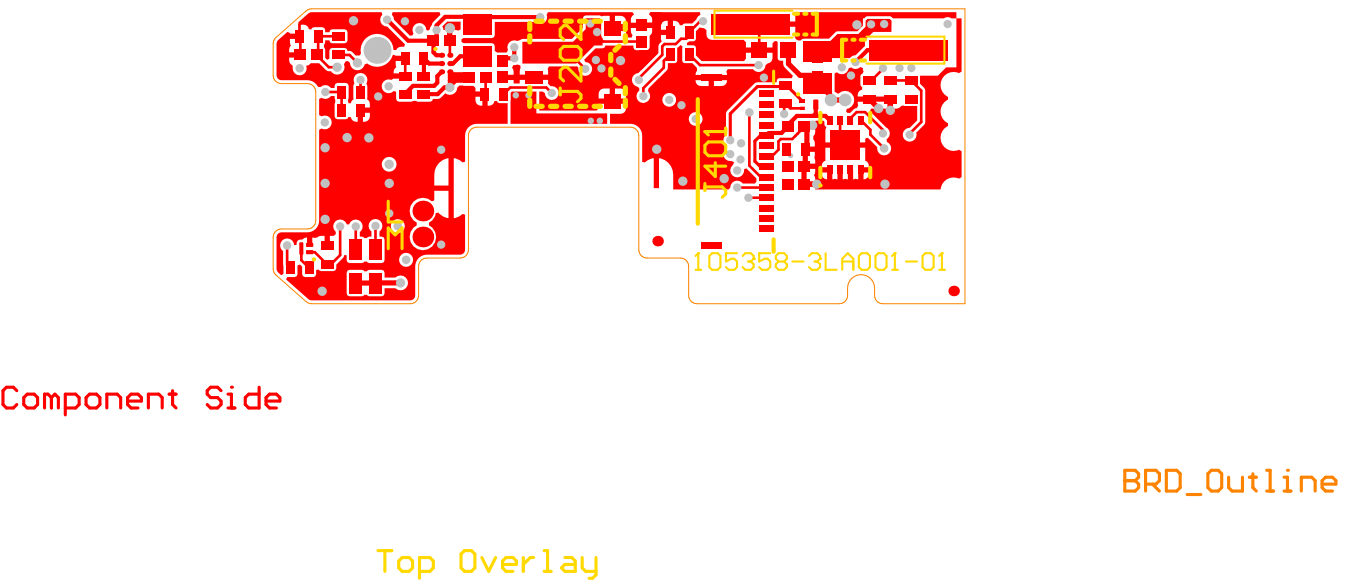
[picture p166: page 20]

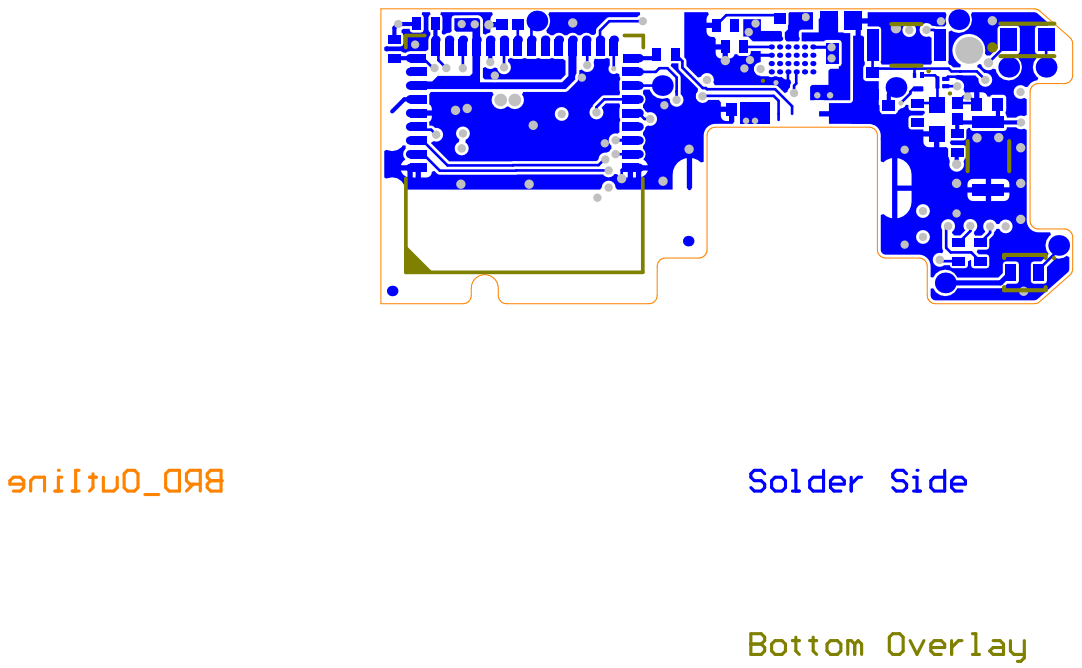
[picture p167: page 21]
