Engineer1234/ConnectMedical/Connect Medical Boards/EFM1_Touch/Project Outputs for 105358-3BA003-01_EFM1_Touch/PDF/105358-3LA003-01_PCB_EFM1-Touch.PDF

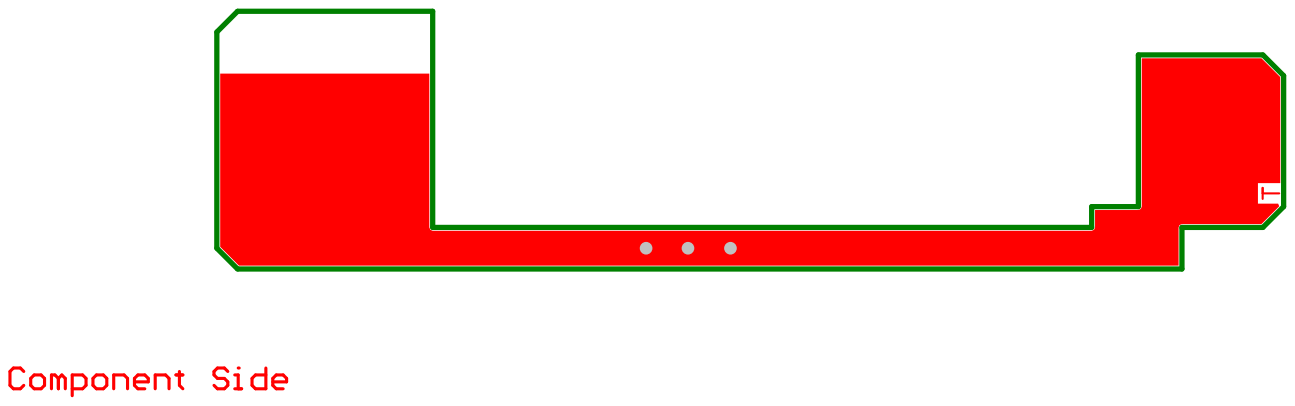
[picture p168: page 1]

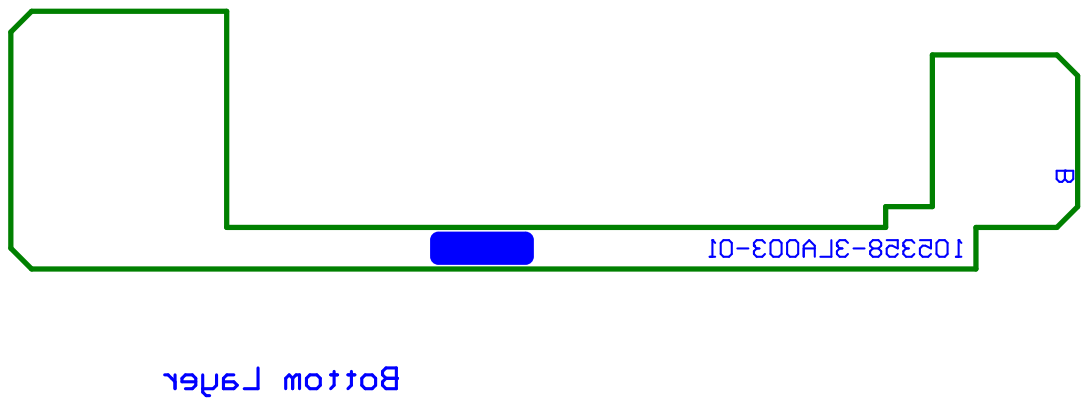
[picture p169: page 2]

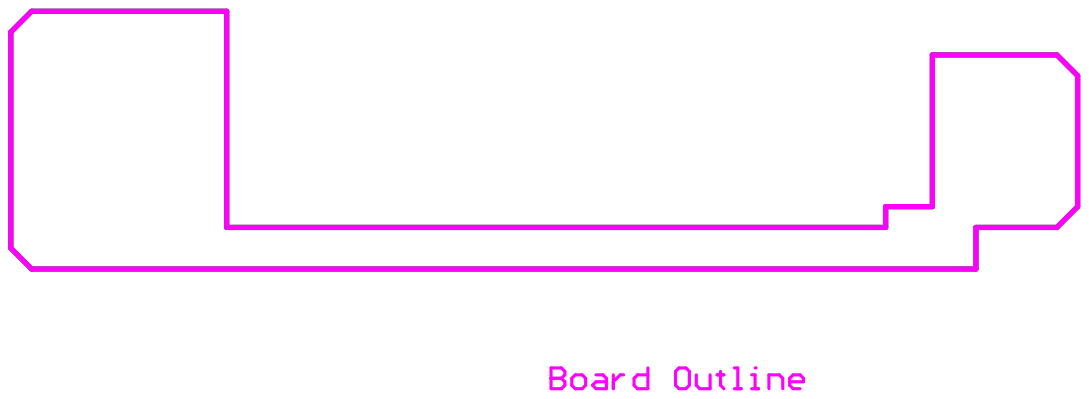
[picture p170: page 4]

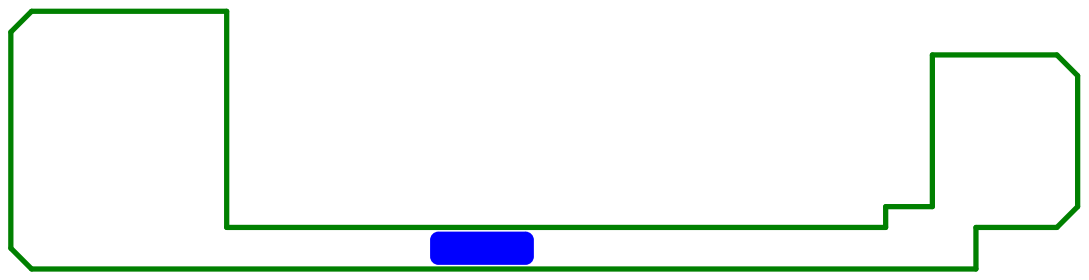
[picture p171: page 5]

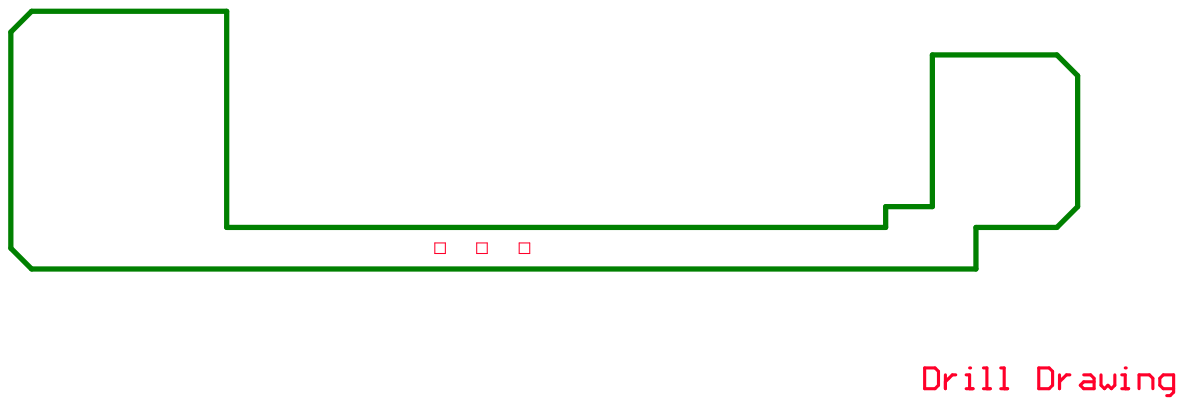
[picture p172: page 6]

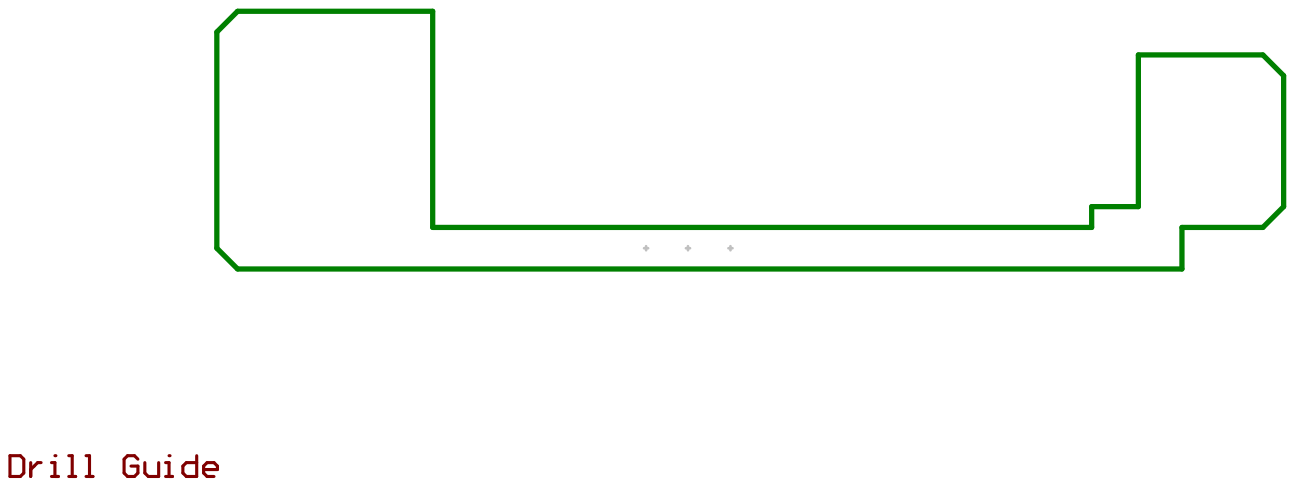
[picture p173: page 7]

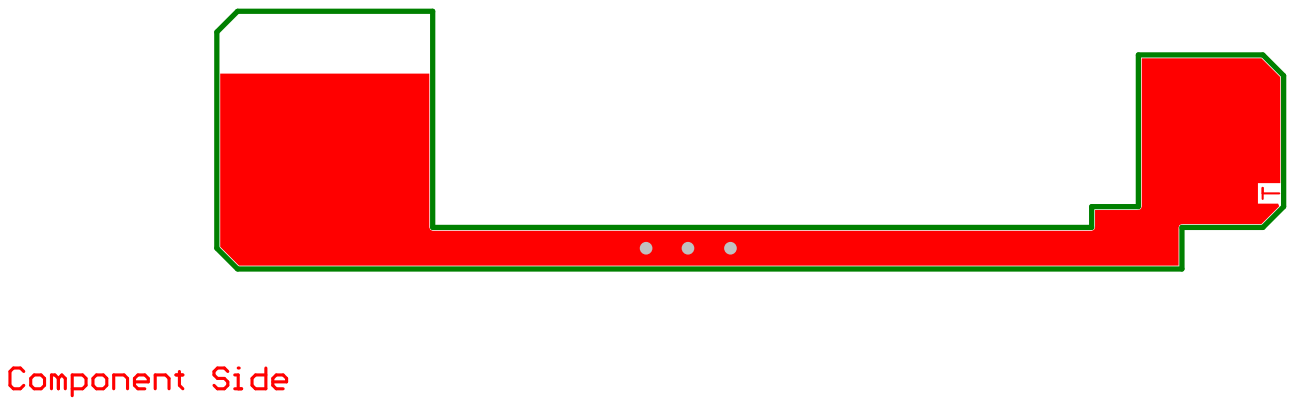
[picture p174: page 8]

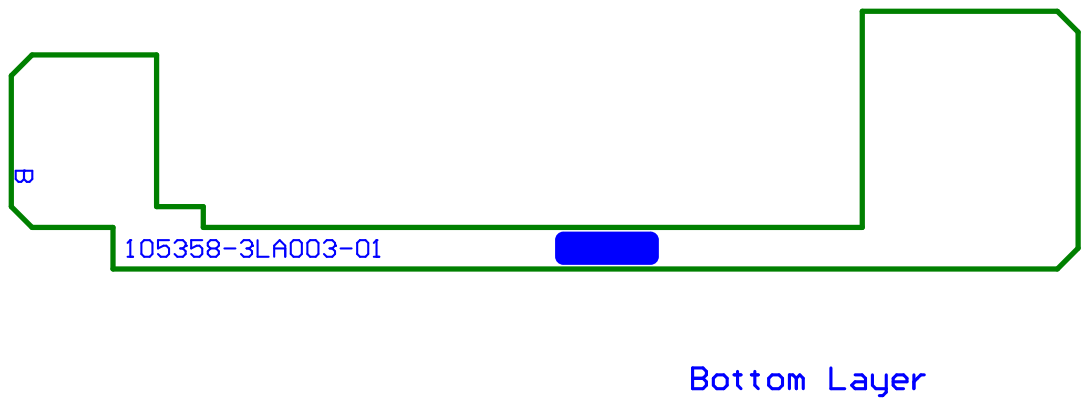
[picture p175: page 9]
