Engineer1234/ConnectMedical/(list of files, drawings)

Other design files:
Connect Medical Boards/EFM1/105358-3BA001-01_EFM1.PrjPCB
Connect Medical Boards/EFM1/105358-3LA001-01_EFM1.PcbDoc
Connect Medical Boards/EFM1/105358-3SC001-01-B_BlockDiagram.SchDoc
Connect Medical Boards/EFM1/105358-3SC001-01-B_Cover.SchDoc
Connect Medical Boards/EFM1/105358-3SC001-01-B_CPU_BRD.SchDoc
Connect Medical Boards/EFM1/105358-3SC001-01-B_IO_BRD.SchDoc
Connect Medical Boards/EFM1/105358-3SC001-01-B_PWR_MGMT.SchDoc
Connect Medical Boards/EFM1_Hybrid/105358-3BA002-01_EFM1-hybrid.PrjPCB
Connect Medical Boards/EFM1_Hybrid/105358-3LA002-01_EFM1-Hybrid.PcbDoc
Connect Medical Boards/EFM1_Hybrid/105358-3SC002-01-A_BlockDiagram.SchDoc
Connect Medical Boards/EFM1_Hybrid/105358-3SC002-01-A_Cover.SchDoc
Connect Medical Boards/EFM1_Hybrid/105358-3SC002-01-A_CPU.SchDoc
Connect Medical Boards/EFM1_Hybrid/105358-3SC002-01-A_IR.SchDoc
Connect Medical Boards/EFM1_Hybrid/105358-3SC002-01-A_IR_extra.SchDoc
Connect Medical Boards/EFM1_Hybrid/105358-3SC002-01-A_PWR_MGMT.SchDoc
Connect Medical Boards/EFM1_Touch/105358-3BA003-02_EFP1_Touch.PrjPCB
Connect Medical Boards/EFM1_Touch/105358-3BA003-03_EFP1_Touch-Flex.PrjPCB
Connect Medical Boards/EFM1_Touch/105358-3LA003-03_EFP1_Touch-Flex.PcbDoc
Connect Medical Boards/EFM1_Touch/105358-3SC003-03_Cover-Touch.SchDoc
Connect Medical Boards/EFM2/105358-3BA001-02_EFM1.5.PrjPCB
Connect Medical Boards/EFM2/105358-3SC001-02_BlockDiagram.SchDoc
Connect Medical Boards/EFM2/105358-3SC001-02_Cover.SchDoc
Connect Medical Boards/EFM2/105358-3SC001-02_PWR_MGMT.SchDoc
Connect Medical Boards/FP1/105358-3BA001-03_FP1.PrjPCB
Connect Medical Boards/FP1/105358-3SC001-03_BlockDiagram.SchDoc
Connect Medical Boards/FP1/105358-3SC001-03_Cover.SchDoc
Connect Medical Boards/FP1/105358-3SC001-03_CPU_BRD.SchDoc
Connect Medical Boards/FP1/105358-3SC001-03_IO_BRD.SchDoc
Connect Medical Boards/FP1/105358-3SC001-03_PWR_MGMT.SchDoc
Connect Medical Boards/FP1/Altium templates 160204/4-layer_2-planes.PcbDoc
Connect Medical Boards/FP1/Altium templates 160204/6-layer_2-planes.PcbDoc
