Engineer1234/ConnectMedical/(commit log)

2017-02-22 Added schematic for processor board, along with libraries and basic folder structure.
    [_saved_fesas_prot_processor_board.sch, fesas_prot_processor_board.kicad_pcb, fesas_prot_processor_board.sch]
2017-02-22 Addded guard trace for cap-sense pad
    [_saved_fesas_prot_processor_board.sch, fesas_prot_processor_board.kicad_pcb, fesas_prot_processor_board.sch]
2017-02-23 Added prototype board for original IR solution, and imported the Connect Trial footprints in the libraries folder. Also added updated gitignore files for the IR and PIC boards.
    [_saved_feas_prot_ir_board.sch, feas_prot_ir_board.kicad_pcb, feas_prot_ir_board.sch]
2017-02-27 Added RJ11 connector to processor board, finished IR board.
    [_saved_feas_prot_ir_board.sch, feas_prot_ir_board.kicad_pcb, feas_prot_ir_board.sch, fesas_prot_processor_board.kicad_pcb, fesas_prot_processor_board.sch]
2017-02-27 Battery benchmarking
    First commit. Initial infrastructure.
    [Load Resistors.xlsx, SR_batteries_benchmarking_A.kicad_pcb, SR_batteries_benchmarking_A.sch]
2017-02-28 Battery benchmarking update
    Routed PCB, improvements to structure/naming
    [SR_batteries_benchmarking_A.sch]
2017-02-28 Battery benchmarking update
    PCB ready for review
    [SR_batteries_benchmarking_A.kicad_pcb, SR_batteries_benchmarking_A.sch]
2017-03-01 Battery benchmarking update
    Resistor in parallel to J1, extra pad for BATT+.
    [Load Resistors.xlsx, SR_batteries_benchmarking_A.kicad_pcb, SR_batteries_benchmarking_A.sch]
2017-03-02 Review and organisation
    Review of Auxiliary PIC and IR barrier setup board. Organisation of
    resources.
    [Load Resistors.xlsx, auxiliary_pic_expansion_board.kicad_pcb, auxiliary_pic_expansion_board.sch, feas_prot_ir_board.kicad_pcb, feas_prot_ir_board.sch, fesas_prot_processor_board.kicad_pcb, fesas_prot_processor_board.sch, ir_barrier_initial_setup.kicad_pcb]
2017-04-09 2V regulator module
    [sr_button_cells_benchmarking.kicad_pcb, sr_button_cells_benchmarking.sch, tps61220_based_2V_regulator.kicad_pcb, tps61220_based_2V_regulator.sch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]
2017-04-18 Four constant current loads module
    Four constant current loads module
    [four_constant_current_loads.kicad_pcb, four_constant_current_loads.sch]
2017-04-28 SR Button Cells Series/Parallel/Separate Connection Module
    Schematic only
    [sr_button_cells_series_parallel_separate_connection.kicad_pcb, sr_button_cells_series_parallel_separate_connection.sch]
2017-04-28 Updated component libraries in battery board to use relative paths
2017-04-28 Finished layout of the TPS61220 regulator board
    [tps61220_based_2V_regulator.kicad_pcb, tps61220_based_2V_regulator.sch]
2017-04-28 Completed initial draft of layout of battery board
    [sr_button_cells_series_parallel_separate_connection.kicad_pcb, sr_button_cells_series_parallel_separate_connection.sch]
2017-04-28 Added files forgotten in previous commit of TPS61220 regulator board
2017-04-28 Added holder for Lithium-Ion cell to battery board
    [_saved_sr_button_cells_series_parallel_separate_connection.sch, sr_button_cells_series_parallel_separate_connection.kicad_pcb]
2017-04-28 Added files forgotten in last commit.
    [_saved_sr_button_cells_series_parallel_separate_connection.sch, sr_button_cells_series_parallel_separate_connection.sch]
2017-05-02 Added project for s-1206 LDO regulator prototype PCB
    [s-1206_based_2V_regulator.kicad_pcb, s-1206_based_2V_regulator.sch]
2017-05-02 Completed schematic for s-1206 LDO prototype board.
    [s-1206_based_2V_regulator.sch]
2017-05-02 Completed initial draft of layout for S-1206 LDO prototype board
    [s-1206_based_2V_regulator.sch]
2017-05-03 Added zip files of gerber files sent to Cogra for production for the S-1206 and battery board
2017-05-03 Updated gerber generation settings for battery and LDO test boards
    [s-1206_based_2V_regulator.kicad_pcb, sr_button_cells_series_parallel_separate_connection.kicad_pcb]
2017-05-03 Added gitignore file for feasibility circuits folder
2017-05-03 Removed kicad_pcb-bak files from git version tracking.
2017-05-05 Completed layout of constant current load PCB, the zip file sent for production is also included
    [four_constant_current_loads.kicad_pcb, four_constant_current_loads.sch]
2017-05-05 Added initial project setup for TPS624731 step-down prototype board
    [tps627431_based_2V_regulator.kicad_pcb, tps627431_based_2V_regulator.sch]
2017-05-05 Completed schematic for TPS624731 step-down prototype board
2017-05-05 Created initial project draft for AP3915A 2V regulator prototype board.
    [ap3915a_based_2V_regulator.kicad_pcb, ap3915a_based_2V_regulator.sch]
2017-05-08 Completed schematic for the AP3915A based 2V regulator prototype board.
2017-05-08 Updated gitignore file to ignore _saved_ schematic files
2017-05-13 Completed intial draft of TPS627431 2V regulator prototype board
    [tps627431_based_2V_regulator.kicad_pcb, tps627431_based_2V_regulator.sch]
2017-07-26 Created folder Structure. Blank Altium Project. Added Blank Layout File Added Component footprint and symbols. Added Sheet hierarchy with Sheets for: 1.CPU Board 2.Power Management 3.Connectors 4.I/O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
    [105358-3BA001-01_EFM1.PrjPCB, 105358-3LA001-01_EFM1.PcbDoc, 105358-3SC001-01-A_BlockDiagram.SchDoc, 105358-3SC001-01-A_CONN.SchDoc, 105358-3SC001-01-A_CPU_BRD.SchDoc, 105358-3SC001-01-A_Cover.SchDoc, 105358-3SC001-01-A_IO_BRD.SchDoc, 105358-3SC001-01-A_PWR_MGMT.SchDoc]
2017-07-26 Test : Updated Block Diagram
    [105358-3SC001-01-A_BlockDiagram.SchDoc]
2017-07-26 Test commit from Altium
    [105358-3BA001-01_EFM1.PrjPCB, 105358-3SC001-01-A_BlockDiagram.SchDoc, 105358-3SC001-01-A_Cover.SchDoc]
2017-07-26 Test, from Altium
    [105358-3SC001-01-A_BlockDiagram.SchDoc]
2017-07-26 Add Buck and Boost converter schematic diagram
    [105358-3SC001-01-A_PWR_MGMT.SchDoc]
2017-07-27 Create and Update components required on Boost regulator
    [105358-3SC001-01-A_PWR_MGMT.SchDoc]
2017-07-27 - Create extra SCH components for Buck regulator - Update PWR_MGMT Schematics accordingly
    [105358-3SC001-01-A_PWR_MGMT.SchDoc]
2017-07-27 - Create extra SCH components for USB protector and Charger controller - Update PWR_MGMT Schematics accordingly - Todo: Add footprints to PCB library (0402, 0603, etc)
    [105358-3BA001-01_EFM1.PrjPCB, 105358-3SC001-01-A_PWR_MGMT.SchDoc]
2017-07-27 Added Footprints for 0402, 0603 ,0805 and other passives. Added footprints for Fidu, Net-ties,
2017-07-27 Altium SVN status Check
    [105358-3SC001-01-A_BlockDiagram.SchDoc]
2017-07-27 - Update all passive components by adding PCB link ins SCHlib - Update PWR_MGMT with corresponding components
    [105358-3SC001-01-A_PWR_MGMT.SchDoc]
2017-07-27 - Add CPU and connector for OLED on CPU_BRD - Add IR Barrier on IO_BRD - Create components as necesarry and added to SCHLib
    [105358-3SC001-01-A_CPU_BRD.SchDoc, 105358-3SC001-01-A_IO_BRD.SchDoc]
2017-07-28 - Standarize names and description of new components - Remove extra texts and use unfixed position for description - Update whole SCH project
    [105358-3SC001-01-A_CPU_BRD.SchDoc, 105358-3SC001-01-A_IO_BRD.SchDoc, 105358-3SC001-01-A_PWR_MGMT.SchDoc]
2017-07-31 - Add 2.2nF component for Touch sensor in SCHLIB - Add Touch sensor capacitor in CPU_BRD - Label CPU connections in CPU_BRD
    [105358-3SC001-01-A_CPU_BRD.SchDoc]
2017-07-31 - Create components for battery connector and touch connector - Add Battery connector to PWR_MGMT - Add Touch connector to CPU_BRD
    [105358-3SC001-01-A_CPU_BRD.SchDoc, 105358-3SC001-01-A_PWR_MGMT.SchDoc]
2017-07-31 - Create layout-hybrid component(0805/0402) for BLM21PG331SN1D (0805) - Replace prev. ferrite component (0402) with new component in CPU_BRD
    [105358-3SC001-01-A_CPU_BRD.SchDoc]
2017-07-31 - Reacommodate Battery connector on CONN - Create (draft) components Programming pads and testing points - Initiate usage of programming pads and testing points in CONN
    [105358-3SC001-01-A_CONN.SchDoc, 105358-3SC001-01-A_CPU_BRD.SchDoc, 105358-3SC001-01-A_PWR_MGMT.SchDoc]
2017-07-31 (Bug) Correct TP part as No-BOM and update CONN
    [105358-3SC001-01-A_CONN.SchDoc]
2017-08-01 Update Touch sensor connector specs using the verified one sent by Oliver Chu
    [105358-3SC001-01-A_CPU_BRD.SchDoc]
2017-08-02 Update on Touch component specifications: Now it's 120220-0314 as given by Mech
    [105358-3SC001-01-A_CPU_BRD.SchDoc]
2017-08-02 - Add "DigikeyPartNumber" id in all used components from SCHlib then propagate to project - Create first version of PCB based on the Step file provided (will be updated)
    [105358-3BA001-01_EFM1.PrjPCB, 105358-3BA001-01_EFM1_BOM.xlsx, 105358-3LA001-01_EFM1.PcbDoc, 105358-3SC001-01-A_CONN.CSV, 105358-3SC001-01-A_CONN.SchDoc, 105358-3SC001-01-A_CPU_BRD.SchDoc, 105358-3SC001-01-A_IO_BRD.SchDoc, 105358-3SC001-01-A_PWR_MGMT.SchDoc]
2017-08-03 Update USB connector: Create component and update schematics as well
    [105358-3BA001-01_EFM1.PrjPCB, 105358-3BA001-01_EFM1_BOM.xlsx, 105358-3LA001-01_EFM1.PcbDoc, 105358-3SC001-01-A_PWR_MGMT.SchDoc]
2017-08-03 - Correct spacing in SCH for IO board - Initialize component PCB placement on EFM1 - Add Cost of components of BOM in new sheet
    [105358-3BA001-01_EFM1_BOM_Costs.xlsx, 105358-3SC001-01-A_IO_BRD.SchDoc]
2017-08-04 - Add model of PCB step file - Initial positioning of components on layout
    [105358-3ME031-04 Mechanical Design of PCB by SHL.step]
2017-08-04 - Update component so Digi-Key Part Number use multiples of 1K to buy - Separate component 0603 10uF into 10uF-4V and 10uF-10V - Update Schematics - Update BOM and BOM cost
    [105358-3BA001-01_EFM1_BOM.xlsx, 105358-3BA001-01_EFM1_BOM_Costs.xlsx, 105358-3SC001-01-A_CONN.SchDoc, 105358-3SC001-01-A_PWR_MGMT.SchDoc]
2017-08-04 - Remove silk layer labels of Cypress Module component - Change layer of all silk layer on PCB Layout
    [105358-3SC001-01-A_CPU_BRD.SchDoc]
2017-08-08 Add STBC03 component: Li-Ion linear battery charger with LDO and load switches
2017-08-09 - Create new components for baterry charger section - Update design of Battery charger
    [105358-3SC001-01-A_CPU_BRD.SchDoc, 105358-3SC001-01-A_IO_BRD.SchDoc, 105358-3SC001-01-A_PWR_MGMT.SchDoc]
2017-08-10 - Update PCB with non-hole version in USB section - Finish - Update labels of componenets - Preposition all components to check saturation in the board
    [105358-3SC001-01-A_CONN.SchDoc, 105358-3SC001-01-A_CPU_BRD.SchDoc, 105358-3SC001-01-A_IO_BRD.SchDoc, 105358-3SC001-01-A_PWR_MGMT.SchDoc]
2017-08-14 Correct Capacitance in IN and SYS section of Power Management
    [105358-3SC001-01-A_PWR_MGMT.SchDoc]
2017-08-14 Reduce dimensions of USB Pads and 0805 inductor components so they are IPC High density compliant
    [105358-3BA001-01_EFM1.PrjPCB, 105358-3BA001-02_EFM1_BOM.xlsx, 105358-3SC001-01-A_CPU_BRD.SchDoc, 105358-3SC001-01-A_PWR_MGMT.SchDoc]
2017-08-14 Reduce dimensions of 0402 capacitor components so they are IPC High density compliant
    [105358-3SC001-01-A_CPU_BRD.SchDoc, 105358-3SC001-01-A_IO_BRD.SchDoc, 105358-3SC001-01-A_PWR_MGMT.SchDoc]
2017-08-16 Creation of component for I2C Memory PCA9571GUX & LE2464C: creation of components and usage in Schematics
    [105358-3SC001-01-A_CPU_BRD.SchDoc, 105358-3SC001-01-A_IO_BRD.SchDoc]
2017-08-16 Update Testing points and CPU programming points: 1mm pad, 0.6mm via with 0.3mm holes
    [105358-3SC001-01-A_CONN.SchDoc]
2017-08-16 Creation of component for I2C Display I170805: creation of component and usage in Schematics
    [105358-3SC001-01-A_CPU_BRD.SchDoc]
2017-08-16 Increase current to 89% of Capacity: 34.3mA, by changing ISET resistor to 5.6Kohm
    [105358-3BA001-01_EFM1.PrjPCB, 105358-3BA001-03_EFM1_BOM.xlsx, 105358-3SC001-01-A_PWR_MGMT.SchDoc]
2017-08-16 - Reallocation of components to have a view after the change to I2C components - Update BOM with costs
    [105358-3BA001-01_EFM1.PrjPCB, 105358-3BA001-03_EFM1_BOM.xlsx, 105358-3SC001-01-A_CPU_BRD.SchDoc]
2017-08-18 - Update PCB board according to latest specifications (2 strips on the side) - Update Light Barrier mechanism: use 0ohm resistors
    [105358-3SC001-01-A_IO_BRD.SchDoc]
2017-08-21 - Add connector for new OLED device: Create component and update schematics - Reorganize components positions on board
    [105358-3BA001-01_EFM1.PrjPCB, 105358-3BA001-04_EFM1_BOM.xlsx, 105358-3SC001-01-A_CPU_BRD.SchDoc]
2017-08-22 - Update circuit for IR barrier - Add testing TRX - Update components - Update position of components on Layout - Update BOM
    [105358-3BA001-01_EFM1.PrjPCB, 105358-3BA001-04_EFM1_BOM.xlsx, 105358-3SC001-01-A_CONN.SchDoc, 105358-3SC001-01-A_CPU_BRD.SchDoc, 105358-3SC001-01-A_IO_BRD.SchDoc, 105358-3SC001-01-A_PWR_MGMT.SchDoc]
2017-08-22 - Add R20 to reduce current consumption to MOUNT_SWITCH signal in MCU - Allocate component - Update BOM
    [105358-3BA001-01_EFM1.PrjPCB, 105358-3BA001-04_EFM1_BOM.xlsx, 105358-3SC001-01-A_CPU_BRD.SchDoc, 105358-3SC001-01-A_PWR_MGMT.SchDoc]
2017-08-22 - Keep Buck converter always ON: Connect EN to VIN (Datasheet reference)
    [105358-3SC001-01-A_PWR_MGMT.SchDoc]
2017-08-22 Synchroniza ports on Block Diagram
    [105358-3SC001-01-A_BlockDiagram.SchDoc, 105358-3SC001-01-A_CONN.SchDoc, 105358-3SC001-01-A_CPU_BRD.SchDoc, 105358-3SC001-01-A_IO_BRD.SchDoc, 105358-3SC001-01-A_PWR_MGMT.SchDoc]
2017-08-23 - Apply changes from recommendations on Schematics review: Naming, connections, and specifications of values R1&R2
    [105358-3SC001-01-A_BlockDiagram.SchDoc, 105358-3SC001-01-A_CONN.SchDoc, 105358-3SC001-01-A_CPU_BRD.SchDoc, 105358-3SC001-01-A_IO_BRD.SchDoc, 105358-3SC001-01-A_PWR_MGMT.SchDoc]
2017-08-23 - Bug: Use V_BATT on Mount Switch - Create LED components - Create and replace L1 with recommended 10uH
    [105358-3SC001-01-A_CPU_BRD.SchDoc, 105358-3SC001-01-A_PWR_MGMT.SchDoc]
2017-08-24 - Format all SCH project - Remove Connector SCH - Add LED (right angle) - Update components (Boost regulator & Charger)
    [105358-3BA001-01_EFM1.PrjPCB, 105358-3SC001-01-A_BlockDiagram.SchDoc, 105358-3SC001-01-A_CONN.SchDoc, 105358-3SC001-01-A_CPU_BRD.SchDoc, 105358-3SC001-01-A_Cover.SchDoc, 105358-3SC001-01-A_IO_BRD.SchDoc, 105358-3SC001-01-A_PWR_MGMT.SchDoc]
2017-08-24 - Add latest 3D views - Add comments regarding the Mounting Switch
    [105358-3BA001-01_EFM1.PrjPCB, 105358-3SC001-01-A_BlockDiagram.SchDoc, 105358-3SC001-01-A_CPU_BRD.SchDoc, 105358-3SC001-01-A_IO_BRD.SchDoc]
2017-08-24 - Add FET mechanism proposal (parts not finalized)
    [105358-3SC001-01-A_CPU_BRD.SchDoc]
2017-08-24 cosmetic changes in schematics. Changed Port name for Mounting Switch to Wake_up. Moved USB symbol to Top level. Added RES to Wake up FET Clean up.
    [105358-3SC001-01-A_BlockDiagram.SchDoc, 105358-3SC001-01-A_CPU_BRD.SchDoc, 105358-3SC001-01-A_IO_BRD.SchDoc, 105358-3SC001-01-A_PWR_MGMT.SchDoc]
2017-08-25 - Cosmetic changes after Review Meeting 20170825
    [105358-3BA001-01_EFM1.PrjPCB, 105358-3SC001-01-A_BlockDiagram.SchDoc, 105358-3SC001-01-A_CPU_BRD.SchDoc, 105358-3SC001-01-A_IO_BRD.SchDoc, 105358-3SC001-01-A_PWR_MGMT.SchDoc]
2017-08-25 - Add ESD protection on the switches
    [105358-3SC001-01-A_CPU_BRD.SchDoc, 105358-3SC001-01-A_IO_BRD.SchDoc]
2017-08-31 - Correction of description on ESD diode
    [105358-3SC001-01-A_BlockDiagram.SchDoc, 105358-3SC001-01-A_CPU_BRD.SchDoc]
2017-09-05 cosmetic changes to SCH (improved readability of Sch) added FETS to Lib
    [105358-3BA001-01_EFM1.PrjPCB, 105358-3SC001-01-A_BlockDiagram.SchDoc, 105358-3SC001-01-A_CPU_BRD.SchDoc, 105358-3SC001-01-A_Cover.SchDoc, 105358-3SC001-01-A_IO_BRD.SchDoc, 105358-3SC001-01-A_PWR_MGMT.SchDoc, CSD13380F3-DFN40P69X35-3L.step, CSD23382F4 -DFN65P100X35-3L.step]
2017-09-07 Changed File version from “A” to “B” Updated I/O board to remove extra 0 Ohm RES Changed USB connector to USB3155 Added Step files for components
    [105358-3BA001-01_EFM1.PrjPCB, 105358-3SC001-01-A_BlockDiagram.SchDoc, 105358-3SC001-01-A_CPU_BRD.SchDoc, 105358-3SC001-01-A_Cover.SchDoc, 105358-3SC001-01-A_IO_BRD.SchDoc, 105358-3SC001-01-A_PWR_MGMT.SchDoc, 105358-3SC001-01-B_BlockDiagram.SchDoc, 105358-3SC001-01-B_CPU_BRD.SchDoc]
2017-09-07 Changed VDD from 2V to 3V Changed step files and solder mask size on few components
    [105358-3BA001-01_EFM1.PrjPCB, 105358-3BA001-01_EFM1_BOM_For Costs.xlsx, 105358-3SC001-01-A_BlockDiagram.CSV, 105358-3SC001-01-B_BlockDiagram.CSV, 105358-3SC001-01-B_BlockDiagram.SchDoc, 105358-3SC001-01-B_CPU_BRD.CSV, 105358-3SC001-01-B_CPU_BRD.SchDoc, 105358-3SC001-01-B_Cover.SchDoc]
2017-09-07 Changed Annotations on 2 components
    [105358-3BA001-01_EFM1.PrjPCB, 105358-3SC001-01-B_CPU_BRD.SchDoc, 105358-3SC001-01-B_Cover.SchDoc, 105358-3SC001-01-B_PWR_MGMT.SchDoc, CSD13380F3-DFN40P69X35-3L v2-PIN1.step, CSD23382F4 -DFN65P100X35-3L v1-PIN1.step]
2017-09-07 Added step Files
    [APT1608 v1-pin.step, APT2012 v1-pin1.step, KXT311LHS.stp]
2017-09-07 Added Note for removed 2V regulator.
    [105358-3SC001-01-B_PWR_MGMT.SchDoc]
2017-09-07 Un-versioned BOM template files Fixing SVN issues
    [105358-3SC001-01-A_CONN.SchDoc]
2017-09-08 Changed PCB shape, Imported New step file to PCB. changed origin to board edge Changed PCB file setup Renamed sheet titles added few test points
    [105358-3SC001-01-B_CPU_BRD.SchDoc, 105358-3SC001-01-B_Cover.SchDoc, 105358-3SC001-01-B_IO_BRD.SchDoc]
2017-09-13 Project template for EFM1 hybrid board
    [105358-3BA002-01_EFM1-hybrid.PrjPCB, 105358-3SC002-01-A_BlockDiagram.SchDoc, 105358-3SC002-01-A_CPU.SchDoc, 105358-3SC002-01-A_Cover.SchDoc, 105358-3SC002-01-A_IR.SchDoc, 105358-3SC002-01-A_PWR_MGMT.SchDoc, APT1608 v1-pin.step, APT2012 v3-pin1.step]
2017-09-13 Added Test points. Added foot prints for jumpers and GND test points.
    [105358-3BA002-01_EFM1-hybrid.PrjPCB, 105358-3SC002-01-A_BlockDiagram.SchDoc, 105358-3SC002-01-A_CPU.SchDoc, 105358-3SC002-01-A_IR.SchDoc, 105358-3SC002-01-A_PWR_MGMT.SchDoc]
2017-09-13 Changed footprint for USB connector , Change in board shape , moved origin. USB con position Fixed USB connector rotated. Changed footprint for prog headers. Flipper D and S for the PFET
    [105358-3BA001-01_EFM1.PrjPCB, 105358-3SC001-01-B_BlockDiagram.SchDoc, 105358-3SC001-01-B_CPU_BRD.SchDoc, USB3155-30-A_revB v1.step]
2017-09-13 Placed MCU , Modified footprint for LED , need needs to be verified. Added step file for Battery connector.
    //Kartik
    [105358-3SC001-01-B_BlockDiagram.SchDoc, 781710002.stp]
2017-09-14 Changed origin to centre of hole Added new component - Touch connector 1003-1009-1-ND placed Fidu placed MCU and Touch conn
    [105358-3SC001-01-B_BlockDiagram.SchDoc, 105358-3SC001-01-B_CPU_BRD.SchDoc, 105358-3SC001-01-B_IO_BRD.SchDoc, 120220-0161.step]
2017-09-14 Moved mounting hole and hence the origin too. Added grid lines
2017-09-14 Update PCB library with new prioritized components for Connect hybrid
2017-09-14 Buck converter removed from Layout Components made Graphical
    [105358-3SC001-01-B_IO_BRD.SchDoc, 105358-3SC001-01-B_PWR_MGMT.SchDoc]
2017-09-14 Modified Footprint for BGA , Added via in Pad based on the reference designs from ST modified Footprint for other pars to remove DRC errors
    [105358-3SC001-01-B_CPU_BRD.SchDoc]
2017-09-15 Updated footprints to remove rule conflicts Updated footprints to remove rule conflicts
    [105358-3BA001-01_EFM1.PrjPCB, 105358-3SC001-01-B_BlockDiagram.SchDoc, 105358-3SC001-01-B_CPU_BRD.SchDoc, 105358-3SC001-01-B_PWR_MGMT.SchDoc]
2017-09-15 Commit end of the day: IR LED and Switches laid out. 9V regulator.
2017-09-18 Creation of components: Header 9x2, 14x2, Touch pad and toggle switch
2017-09-18 Create components: 74AUP1G86FS3-7, Switch toggle, headers 14x2 and 9x2, touch pad and Orange LED
2017-09-18 Modified BGA footprint according to recommendation from : http://www.ti.com/lit/an/spraav1b/spraav1b.pdf layout progress
    [105358-3SC001-01-B_PWR_MGMT.SchDoc]
2017-09-19 Swapped the pins on the Batt connector . Finished the layout for Batt charger
    [105358-3SC001-01-B_BlockDiagram.SchDoc]
2017-09-19 Fixed Missing Step file of enclosure
2017-09-19 Changed Step file for LED.
    [105358-3SC001-01-B_BlockDiagram.SchDoc, BRPY1211F-TR.step]
2017-09-20 Switched wake-up gate voltage from 3V to VCC_VCC. based on Spice simulation Layout
    [105358-3SC001-01-B_CPU_BRD.SchDoc, 105358-3SC001-01-B_PWR_MGMT.SchDoc]
2017-09-20 Values for R & C for Wake up delay set to 82K and 22uF. change in Footprint of the 22uF Cap to 0603
    [105358-3SC001-01-B_CPU_BRD.SchDoc]
2017-09-20 Layout , Before removing I2C CAPs
    [105358-3SC001-01-B_CPU_BRD.SchDoc]
2017-09-21 Added footprint for M24256-DFCS6TP/K 256K memory
    [105358-3SC001-01-B_CPU_BRD.SchDoc, 105358-3SC001-01-B_IO_BRD.SchDoc, 105358-3SC001-01-B_PWR_MGMT.SchDoc]
2017-09-21 Changed Position of OLED Con. Changed memory.
    [105358-3BA001-01_EFM1.PrjPCB, 105358-3SC001-01-B_CPU_BRD.SchDoc, M24256-DFCS6TPK v2 v1.step, M24256-DFCS6TPK v2.step]
2017-09-22 Switched SNS_Touch and Ai_LASER_CURRENT pins ( 22 and 14)
    [105358-3SC001-01-B_CPU_BRD.SchDoc]
2017-09-22 Before swapping LED Pins
2017-09-22 Polygon pour inner and outer layers Keep outs on GND and VCC planes No un routed nets. Before DRC
    [105358-3SC001-01-B_CPU_BRD.SchDoc]
2017-09-22 Changed solder mask size on few components due to DRC errors
    [105358-3BA001-01_EFM1.PrjPCB, 105358-3SC001-01-B_CPU_BRD.SchDoc]
2017-09-25 Added Draftman files
    [105358-3BA001-01_EFM1.PrjPCB, 105358-3SC001-01-B_CPU_BRD.CSV]
2017-09-25 Added Cap footprint to output of the 9V regulator. Re annotated components. Added Polygon region to BLE_VDD_4 ( VDD of Module ) Updated Draftman and OutJob Files.
    [105358-3SC001-01-B_CPU_BRD.SchDoc, 105358-3SC001-01-B_PWR_MGMT.SchDoc]
2017-09-25 Production files generated. removed Old BOM files.
    [105358-3BA001-01_EFM1.PrjPCB, 105358-3BA001-01_EFM1_BOM.xlsx, 105358-3BA001-01_EFM1_BOM_170925.xls, 105358-3BA001-01_EFM1_BOM_Costs.xlsx, 105358-3BA001-01_EFM1_BOM_FOR_QUOTE_170922.xlsx, 105358-3BA001-01_EFM1_BOM_For Costs.xlsx, 105358-3BA001-02_EFM1_BOM.xlsx, 105358-3BA001-03_EFM1_BOM.xlsx]
2017-09-26 corrected output file name for Assembly Drawings
2017-09-26 improved readability in assembly drawings
2017-09-26 Updated PCB based on enclosure Step Files from Even
    [105358-3BA001-01_EFM1.PrjPCB]
2017-09-26 latest PCB Rules and DXP Preferences
2017-09-26 re-saved project
    [105358-3BA001-01_EFM1.PrjPCB]
2017-09-26 Updated Sch to include extra IR pairs added Jumper headers.
    [105358-3BA002-01_EFM1-hybrid.PrjPCB, 105358-3SC002-01-A_BlockDiagram.SchDoc, 105358-3SC002-01-A_CPU.SchDoc, 105358-3SC002-01-A_IR.SchDoc, 105358-3SC002-01-A_IR_extra.SchDoc]
2017-09-26 Update for errors.
    [105358-3SC002-01-A_BlockDiagram.SchDoc, 105358-3SC002-01-A_CPU.SchDoc, 105358-3SC002-01-A_IR.SchDoc, 105358-3SC002-01-A_IR_extra.SchDoc, 105358-3SC002-01-A_PWR_MGMT.SchDoc]
2017-09-26 modified label for IR LED
2017-09-26 corrected "Unique Identifiers Errors"
    [105358-3SC002-01-A_BlockDiagram.SchDoc, 105358-3SC002-01-A_CPU.SchDoc, 105358-3SC002-01-A_Cover.SchDoc, 105358-3SC002-01-A_IR.SchDoc, 105358-3SC002-01-A_IR_extra.SchDoc, 105358-3SC002-01-A_PWR_MGMT.SchDoc]
2017-09-27 Updated with board shape experiment
    [105358-3BA002-01_EFM1-hybrid.PrjPCB, 105358-3SC002-01-A_BlockDiagram.SchDoc, 105358-3SC002-01-A_CPU.SchDoc, 105358-3SC002-01-A_Cover.SchDoc, 105358-3SC002-01-A_IR.SchDoc, 105358-3SC002-01-A_IR_extra.SchDoc, 105358-3SC002-01-A_PWR_MGMT.SchDoc, 20170927_0180-004-DC-0082_PCB.DXF]
2017-09-27 Cosmetic changes to Sch
    [105358-3BA002-01_EFM1-hybrid.PrjPCB, 105358-3SC002-01-A_BlockDiagram.SchDoc, 105358-3SC002-01-A_CPU.SchDoc, 105358-3SC002-01-A_Cover.SchDoc, 105358-3SC002-01-A_IR.SchDoc, 105358-3SC002-01-A_IR_extra.SchDoc, 105358-3SC002-01-A_PWR_MGMT.SchDoc]
2017-09-27 Changes from Khurram's review
    [105358-3BA002-01_EFM1-hybrid.PrjPCB, 105358-3LA002-01_EFM1-Hybrid.PcbDoc, 105358-3SC002-01-A_BlockDiagram.SchDoc, 105358-3SC002-01-A_CPU.SchDoc, 105358-3SC002-01-A_IR.SchDoc, 105358-3SC002-01-A_IR_extra.SchDoc, 105358-3SC002-01-A_PWR_MGMT.SchDoc]
2017-09-27 Fixed off grid net labels.
    [105358-3SC002-01-A_CPU.SchDoc, 105358-3SC002-01-A_IR_extra.SchDoc]
2017-09-28 Changed component description for IR LED. Changed from KPT-2012P3BT > APT1608F3C. No changes in layout. Sch, BOM & pick and place files updated as a result.
    [105358-3BA001-01_EFM1.PrjPCB, 105358-3BA001-01_EFM1_BOM_170928.xls, 105358-3SC001-01-B_IO_BRD.SchDoc, Pick Place for 105358-3LA001-01_EFM1.csv]
2017-10-13 changed file name of the BOM
    [105358-3CL001-01_EFM1_BOM_170928.xls]
2017-10-13 latest from (2017-10-11 16-30-43) sent to production.
    [105358-3BA002-01_EFM1-hybrid.PrjPCB, 105358-3SC002-01-A_BlockDiagram.SchDoc, 105358-3SC002-01-A_CPU.SchDoc, 105358-3SC002-01-A_IR.SchDoc, 105358-3SC002-01-A_IR_extra.SchDoc, 105358-3SC002-01-A_PWR_MGMT.SchDoc]
2017-10-18 Latest Files 2017-10-17 15-17-44
    [105358-3SC002-01-A_CPU.SchDoc, 105358-3SC002-01-A_IR.SchDoc, 105358-3SC002-01-A_IR_extra.SchDoc, 105358-3SC002-01-A_PWR_MGMT.SchDoc]
2017-10-18 Added Pick Place Output files
    [105358-3BA002-01_EFM1-hybrid.PrjPCB, Pick Place for 105358-3LA002-01_EFM1-Hybrid.csv]
2017-10-30 Added Touch PCB Project
    [0180-004-DM-0086-Touch.step, 105358-3BA003-01_EFM1_Touch.PrjPCB, 105358-3LA003-01_EFM1_Touch.PcbDoc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]
2017-11-16 Comin Before edit for Ver 2
    [105358-3BA001-01_EFM1.PrjPCB, 105358-3BA001-01_EFM1_BOM_170925 -Micke.xls, 105358-3BA001-01_EFM1_BOM_FOR_QUOTE_170922.xlsx]
2017-11-16 EFM2 baseline commit
    [105358-3BA001-02_EFM2.PrjPCB, 105358-3ME031-04 Mechanical Design of PCB by SHL.step, 105358-3SC001-02_BlockDiagram.SchDoc, 105358-3SC001-02_CPU_BRD.SchDoc, 105358-3SC001-02_Cover.SchDoc, 105358-3SC001-02_IO_BRD.SchDoc, 105358-3SC001-02_PWR_MGMT.SchDoc, 120220-0161.step]
2017-11-22 Changed pin order for USB CON.
2017-11-22 Changes made to SCh : Removed I/O expander Pins from I/O expander moved to Module removed 3 GPIO test points. Swapped pins of USB CON
    Layout changes to reflect the above
    [105358-3BA001-02_EFM2.PrjPCB, 105358-3SC001-02_BlockDiagram.SchDoc, 105358-3SC001-02_CPU_BRD.SchDoc, 105358-3SC001-02_IO_BRD.SchDoc, 105358-3SC001-02_PWR_MGMT.SchDoc]
2017-11-29 CAM Files created for mighT
    [105358-3BA001-01_EFM1.PrjPCB]
2017-12-01 Renamed Files to V1.5 from v2 production files
    [105358-3BA001-02_EFM1.5.PrjPCB, 105358-3BA001-02_EFM2.PrjPCB, 105358-3SC001-02_BlockDiagram.SchDoc, 105358-3SC001-02_CPU_BRD.SchDoc, 105358-3SC001-02_Cover.SchDoc, 105358-3SC001-02_IO_BRD.SchDoc, KPHBM-2012CGKSEKC v2.step]
2017-12-04 Generated BOM and Pick and place files Made OLED CON a standard BOM item.
    [105358-3BA001-02_EFM1.5.PrjPCB, 105358-3CL004-01_EFM1.5.xls, 105358-3SC001-02_CPU_BRD.SchDoc, Pick Place for 105358-3LA001-02_EFM1.5.csv]
2017-12-04 New Gerber Files for MighT
2017-12-04 FP1 Baseline
    [105358-3BA001-03_FP1.PrjPCB, 105358-3SC001-03_BlockDiagram.SchDoc, 105358-3SC001-03_CPU_BRD.SchDoc, 105358-3SC001-03_Cover.SchDoc, 105358-3SC001-03_IO_BRD.SchDoc, 105358-3SC001-03_PWR_MGMT.SchDoc, 120220-0161.step, 4-layer_2-planes.PcbDoc]
2017-12-04 Changed Project and Document Parameters changed Molex OLED Con to Standard part
    [105358-3SC001-03_BlockDiagram.SchDoc, 105358-3SC001-03_CPU_BRD.SchDoc, 105358-3SC001-03_Cover.SchDoc, 105358-3SC001-03_IO_BRD.SchDoc, 105358-3SC001-03_PWR_MGMT.SchDoc]
2017-12-06 Updated description for 10µF ±10% 16V X5R Ceramic Capacitor 0603 it read 16µF before.
    [105358-3BA001-02_EFM1.5.PrjPCB, 105358-3SC001-02_PWR_MGMT.SchDoc]
2017-12-08 Changes after talk with Mech
    [105358-3BA001-03_FP1.PrjPCB, 105358-3SC001-03_BlockDiagram.SchDoc, 105358-3SC001-03_CPU_BRD.SchDoc, 105358-3SC001-03_IO_BRD.SchDoc, 105358-3SC001-03_PWR_MGMT.SchDoc]
2017-12-14 layout near completion , Moved MCU on Even's input
    [105358-3BA001-03_FP1.PrjPCB, 105358-3SC001-03_CPU_BRD.SchDoc, 105358-3SC001-03_IO_BRD.SchDoc]
2017-12-18 Commit before the review
    [105358-3SC001-03_BlockDiagram.SchDoc, 105358-3SC001-03_CPU_BRD.SchDoc]
2017-12-19 Test points added for V Batt and 5V PDF's generated Clean up.
    [105358-3BA001-03_FP1.PrjPCB, 105358-3SC001-03_BlockDiagram.SchDoc, 105358-3SC001-03_PWR_MGMT.SchDoc]
2017-12-19 Modified BOM template Gen BOM and Other PDF again. Changed DNP parts to not to appear in BOM
    [105358-3BA001-03_FP1.PrjPCB, 105358-3SC001-03_CPU_BRD.SchDoc, 105358-3SC001-03_IO_BRD.SchDoc, 105358-3SC001-03_PWR_MGMT.SchDoc, Micro Universal Contact Z 3.0mm.step]
2017-12-20 Changed RES in the voltage divider and changed some Caps for 9V bus. Created new BOM
    [105358-3BA001-03_FP1.PrjPCB, 105358-3CL005-01_FP1.xls, 105358-3SC001-03_CPU_BRD.SchDoc, 105358-3SC001-03_IO_BRD.SchDoc, 105358-3SC001-03_PWR_MGMT.SchDoc]
2017-12-22 New ver for the touch PCB for FM2
    [0180-004-DM-0086-Touch.step, 105358-3LA003-01_EFM1_Touch.PcbDoc, 105358-3LA003-02_EFM1_Touch.PcbDoc, 105358-3SC003-02-A_Cover-Touch.SchDoc]
2017-12-22 changed file name to EFP1
    [105358-3BA003-02_EFP1_Touch.PrjPCB, 105358-3LA003-02_EFM1_Touch.PcbDoc, 105358-3LA003-02_EFP1_Touch.PcbDoc, 105358-3SC003-02-A_Cover-Touch.SchDoc]
2017-12-22 change in project name.
    [105358-3BA003-02_EFP1_Touch.PrjPCB]
2017-12-22 Gerber and Camtastic file
    [105358-3BA003-02_EFP1_Touch.PrjPCB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]
2017-12-22 Gerber and PFD outputs
    [105358-3LA003-02_EFP1_Touch.step]
2017-12-22 Changed CAPs on the 9V bus. moved universal contact upwards. removed the GND universal contact
    [105358-3BA001-03_FP1.PrjPCB, 105358-3SC001-03_BlockDiagram.SchDoc, 105358-3SC001-03_CPU_BRD.SchDoc, 105358-3SC001-03_PWR_MGMT.SchDoc]
2017-12-22 Updated assembly drawings made cosmetic changes in the SCH and Layout . Done not effect the Gerber.
    [105358-3LA003-02_EFP1_Touch.PcbDoc, 105358-3LA003-02_EFP1_Touch.step, 105358-3SC003-02-A_Cover-Touch.SchDoc]
2017-12-22 Update in Project file
    [105358-3BA003-02_EFP1_Touch.PrjPCB]
2017-12-25 Clean up commit
    [105358-3BA001-03_FP1.PrjPCB]
2017-12-25 Removed 105358-3BA003-01_EFM1_Touch.PrjPCB file
    [105358-3BA003-01_EFM1_Touch.PrjPCB]
2018-01-22 Commit before Final design review
    [105358-3BA001-03_FP1.PrjPCB, 105358-3SC001-03_BlockDiagram.SchDoc, 105358-3SC001-03_CPU_BRD.SchDoc, 105358-3SC001-03_Cover.SchDoc, 105358-3SC001-03_IO_BRD.SchDoc, 105358-3SC001-03_PWR_MGMT.SchDoc]
2018-01-22 changes asper Review removed CMOD Cap added 0R res to bypass FED for IR LED added 0R res in place of CMOD Cap. Clean up of SCH.
    [105358-3BA001-03_FP1.PrjPCB, 105358-3SC001-03_BlockDiagram.SchDoc, 105358-3SC001-03_CPU_BRD.SchDoc, 105358-3SC001-03_Cover.SchDoc, 105358-3SC001-03_IO_BRD.SchDoc]
2018-01-22 Camtastic files
    [105358-3CL006-01_FP1.xls]
2018-01-22 Cosmetic change step files
    [105358-3SC001-03_CPU_BRD.SchDoc]
2018-01-22 Gerber Output added (Sent to MIGHT for Quote)
2018-01-22 Changes made for EFP1 Gerber sent to MIGHT for quotation.
    [105358-3BA003-02_EFP1_Touch.PrjPCB, 105358-3LA003-02_EFP1_Touch.PcbDoc]
2018-01-22 Removing Old Gerber files
    [105358-3LA001-01_EFM1_Copper_Plane_1.gbr, 105358-3LA001-01_EFM1_Copper_Plane_2.gbr, 105358-3LA001-01_EFM1_Copper_Signal_1.gbr, 105358-3LA001-01_EFM1_Copper_Signal_2.gbr, 105358-3LA001-01_EFM1_Copper_Signal_Bot.gbr, 105358-3LA001-01_EFM1_Copper_Signal_Top.gbr, 105358-3LA001-01_EFM1_Drawing_1.gbr, 105358-3LA001-01_EFM1_Drawing_2.gbr]
2018-01-22 RRemoving Old Gerber files
    [105358-3LA003-02_EFP1_Touch_Copper_Signal_Bot.gbr, 105358-3LA003-02_EFP1_Touch_Copper_Signal_Top.gbr, 105358-3LA003-02_EFP1_Touch_Drawing_1.gbr, 105358-3LA003-02_EFP1_Touch_Drawing_2.gbr, 105358-3LA003-02_EFP1_Touch_Drawing_3.gbr, 105358-3LA003-02_EFP1_Touch_Drawing_4.gbr, 105358-3LA003-02_EFP1_Touch_Drillmap_1.gbr, 105358-3LA003-02_EFP1_Touch_Drillmap_2.gbr]
2018-01-23 Board shaped changed with input from Lance and Ben
    [105358-3SC001-03_CPU_BRD.SchDoc, 105358-3SC001-03_Cover.SchDoc]
2018-01-23 IR components moved to align with light-guide PDFs generated.
    [105358-3CL006-02_FP1.xls]
2018-01-23 Board clean up and production file generation. removed Solder from DNP components modified Solder mask for some components Generated clean PDFs Assembly drawings cleaned up.
    [105358-3BA001-03_FP1.PrjPCB, 105358-3SC001-03_BlockDiagram.SchDoc, 105358-3SC001-03_CPU_BRD.SchDoc, 105358-3SC001-03_IO_BRD.SchDoc]
2018-01-26 IR elements moved under Light guide. Board shape changed slightly to accommodate IR receiver on the edge of the board. changed footprint of IR receiver. touch PCB to be changed to FPC; Universal conn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
    [105358-3BA001-03_FP1.PrjPCB, 105358-3SC001-03_BlockDiagram.SchDoc, 105358-3SC001-03_Cover.SchDoc, 105358-3SC001-03_IO_BRD.SchDoc]
2018-02-09 Board updated to Flex Touch Ver 3
    [0180-004-DM-0086-Touch.step, 105358-3BA003-03_EFP1_Touch-Flex.PrjPCB, 105358-3LA003-02_EFP1_Touch.PcbDoc, 105358-3LA003-03_EFP1_Touch-Flex.PcbDoc, 105358-3SC003-03_Cover-Touch.SchDoc]
2018-02-22 Flex touch design as sent to PCB-Pool
    [105358-3BA003-03_EFP1_Touch-Flex.PrjPCB]
2018-02-22 pick n place files updated
    [105358-3BA001-03_FP1.PrjPCB, 105358-3CL006-03_FP1.xls, 105358-3CL006-04_FP1.xls]
2018-02-22 project file updated.
    [105358-3BA001-03_FP1.PrjPCB]
2018-03-06 SCH Cleanup Project files .
    [105358-3BA001-03_FP1.PrjPCB, 105358-3SC001-03_CPU_BRD.SchDoc, 105358-3SC001-03_Cover.SchDoc, 105358-3SC001-03_IO_BRD.SchDoc, 105358-3SC001-03_PWR_MGMT.SchDoc, Pick Place for 105358-3LA001-03_FP1.csv]
2018-03-06 Proj cleanup.
    [105358-3BA001-03_FP1.PrjPCB]
2018-03-08 Footprint for USB and batt connector modified to reflect changes requested by board manufacturer. test point added to P3.0
    [105358-3BA001-03_FP1.PrjPCB, 105358-3SC001-03_CPU_BRD.SchDoc]
